hanmin0211/racing_ws/HANDOFF_2026-09-19-night.md

# 인계 — 2026-09-19 새벽 (라이다 회피 + 경사로 양방향 확정)

> **현장에서 이 문서만 보고 출발할 수 있어야 한다.**
> 앞선 대화는 없다고 가정하고 썼다.
> 저장소에서 일하는 방식(다섯 원칙)은 `HANDOFF_2026-09-18.md` §0.

**일정**: 9/19(오늘) 용인 현장 점검 · 9/20 본경기.

---

# 1. ★ 무조건 출발하려면 — 이것만 지켜라

## 1.1 확정 명령 (오늘 밤 오르막·내리막 **양방향 완주**한 설정)

```bash
cd /home/han/racing_ws && bash tools/drive_school.sh --speed 1.6 --min-pwm 0 \
  --extra waypoints:=<경로>.yaml \
  --extra ff_mode:=ros --extra ff_static:=46.0 --extra ff_gain:=42.6 \
  --extra ff_breakaway_pwm:=90.0 --extra ff_breakaway_ms:=1200.0 \
  --extra auto_calib_speed:=0.5 --extra calib_distance:=10.0 \
  --extra curvature_gain:=6.0 --extra avoid_steer_rate_deg:=90.0 \
  --extra grade_ff_gain:=1.0 --extra grade_ff_max:=95.0 \
  --extra gov_pwm:=60.0 --extra gov_min_grade:=0.06 --extra gov_gain:=300.0 \
  --extra gov_lead_s:=0.3 --extra gov_deadband:=0.20
```

한 줄로 (복붙용):

```
cd /home/han/racing_ws && bash tools/drive_school.sh --speed 1.6 --min-pwm 0 --extra waypoints:=<경로>.yaml --extra ff_mode:=ros --extra ff_static:=46.0 --extra ff_gain:=42.6 --extra ff_breakaway_pwm:=90.0 --extra ff_breakaway_ms:=1200.0 --extra auto_calib_speed:=0.5 --extra calib_distance:=10.0 --extra curvature_gain:=6.0 --extra avoid_steer_rate_deg:=90.0 --extra grade_ff_gain:=1.0 --extra grade_ff_max:=95.0 --extra gov_pwm:=60.0 --extra gov_min_grade:=0.06 --extra gov_gain:=300.0 --extra gov_lead_s:=0.3 --extra gov_deadband:=0.20
```

⚠ `drive_school.sh` 는 **라이다 드라이버까지 자기가 띄운다.** 기본값이 9/13 설정
(`ff_static 17.2` / `ff_gain 38.8` / `ff_min_pwm 50`)이라 위 `--extra` 로 전부 덮어써야 한다.
**중복 인자는 뒤가 이긴다** — 시험용 런치로 확인했다(`who:=FIRST who:=SECOND` → SECOND).

## 1.2 ⚠⚠ 절대 빠뜨리면 안 되는 인자

| 인자 | 빼면 | 증상 |
|---|---|---|
| **`grade_ff_gain:=1.0`** | 경사 보상이 **꺼진다**(기본 0.0) | 경사로 중턱에서 속도가 단조 감소하다 정지. **에러 메시지 없음** |
| `grade_ff_max:=95.0` | 상한 70 으로 잘린다(기본 70.0) | 급경사에서 보상 부족 |
| `ff_static:=46.0` | 17.2 로 떨어진다 | 정지마찰을 못 넘어 아예 안 움직임 |
| `ff_breakaway_pwm:=90.0` | 60 으로 떨어진다 | 출발 실패 |

**2026-09-19 03:2x 에 `grade_ff_gain` 을 빼고 돌려 s=74m 에서 죽었다.**
같은 파라미터로 00:33 에는 완주했었다. 배터리로 오진했다가 파라미터 덤프
(`/tmp/launch_params_*`)로 확정했다. **출발 전에 `exec` 직전 출력에서 눈으로 확인할 것.**

## 1.3 출발 보장 체크리스트 — 순서대로

**① 장치 넷**

```bash
ls -l /dev/imu /dev/arduino /dev/ldlidar_front && lsusb | grep -icE "10c4:ea60" && stty -F /dev/imu 921600 raw -echo && timeout 2 head -c 64 /dev/imu | wc -c
```

기대: 심링크 3개 · CP210x **2개** · 마지막 **64**

⚠ **보드레이트를 먼저 맞춰야 한다.** tty 는 새로 열거되면 9600 이고 IMU 는 921600 이다.
안 맞추면 프레이밍 에러로 전부 버려져 **멀쩡한 IMU 가 0바이트로 보인다.**
(2026-09-19 03:23 에 이걸로 정상 IMU 를 '죽었다' 고 오진했다. 9/14 에도 같은 사고)

`0` 이면 진짜 죽은 포트다 → **뽑고 10초 뒤 다시 꽂을 것**(바로 꽂으면 칩이 리셋 안 된다).

⚠ IMU 와 라이다가 **같은 칩(10c4:ea60)** 이라 `ttyUSB` 번호는 꽂는 순서마다 바뀐다.
udev 가 시리얼로 고정하므로 **심링크만 보면 된다**(`/etc/udev/rules.d/99-imu.rules`,
`99-ldlidar.rules`, `99-arduino.rules`).

⚠ **USB 허브 깊이 금지.** 허브로 시리얼이 끊긴 이력(`dmesg` 의 `-32` = EPIPE, 직결로 재연결 49→0).

**② 중복 노드 없음**

```bash
cd /home/han/racing_ws && bash tools/ros_cleanup.sh
```

`✅ 없음` 이어야 한다. 두 벌이 돌면 serial/NTRIP/IMU 가 전부 싸운다.
`drive_school.sh` 는 남아 있으면 **시작 자체를 거부**한다.

**③ 라이다 마운트** — 드라이버 띄운 뒤, 주행 전 30초

```bash
cd /home/han/racing_ws && source install/setup.bash && python3 tools/lidar_mount_check.py
```

지면을 때리면 전방이 통째로 장애물이 되어 **차가 영원히 선다**. 두 번 재발한 고장이다.

**④ 캘리브** — 이게 안 되면 자율이 아예 안 나간다

- `auto_calib:=true`(기본, `drive_school.sh`) → 차가 스스로 10m 직진
- 컨트롤러 없이 **밀어서** 하려면 `auto_calib:=false` + 손으로 밀기
- 조향 중앙 맞추려면 별 터미널에서 `ros2 run velocity_controller teleop_keyboard` → `SPACE`
  ⚠ **`wasd_teleop` 은 쓰지 마라** — `/cmd_vel` 로 직접 쏴서 먹스와 싸운다.
  `teleop_keyboard` 는 `/teleop/cmd_vel` 로 보내고 먹스가 사람 우선으로 받는다.

---

# 2. 캘리브 — 대회장에서 반드시 되게

## 2.1 원리 (이걸 알면 현장 대응이 된다)

```
yaw_offset = normalize(GPS course − IMU yaw)
```

**IMU 좌표계와 맵 좌표계 사이의 상수 회전**이다. 위치의 함수가 아니다.
`/heading/yaw_offset` 을 **래치(TRANSIENT_LOCAL)** 로 발행하고 노드는 종료한다.
`direct_localization` 과 `vehicle_cmd_mux` 가 그 값을 세션 내내 들고 있다.

→ **코스 밖에서 캘리브하고 런치를 켠 채 차를 옮겨도 된다.**

⚠ **런치를 Ctrl+C 하면 날아간다.** IMU 가 재열거돼도 날아간다. 예선 대기 중에 끄지 마라.

## 2.2 게이트 6개 — 무엇이 막는가

| 게이트 | 기본값 | 막히면 |
|---|---|---|
| RTK 수렴 | σ ≤ 5cm, `require_rtk` | `RTK 수렴 대기 중` 로그. NTRIP 이 붙어도 수신기가 RTCM 을 안 먹으면 안 올라간다 — ublox 로그에 `degraded mode` 확인 |
| 이동속도 | `max_jump_speed` 2.0 m/s | `측위 점프 감지` → 시작점 재설정 |
| 직진성 | `max_deviation_deg` 20°, 지속 1.5m, peak 25° | `❌ 무효` |
| 최소 소요시간 | `auto_speed_cap` (ff_mode 로 자동: ros→2.0) | `❌ 무효: N m 를 N초 만에` |
| **앞바퀴 중앙** | `max_steer_offset_deg` 2.0 | 시작조차 안 함 |
| 자동직진 재시도 | 3회, 시작점 2m 안으로 되돌려야 재출발 | `현재 N.Nm 앞` |

## 2.3 10m 가 안 나올 때

오프셋은 **시작점→끝점 현(chord)** 으로 구한다. RTK σ≈2cm 기준 각도 오차:

| 거리 | 헤딩 오차 |
|---|---|
| 10m | 0.11° |
| 8m | 0.14° |
| 5m | 0.23° |
| 3m | 0.38° |

**5m 면 0.23° — 충분하다.** `calib_distance:=5.0`.
⚠ 3m 밑으로 내리지 마라(`min_chord_for_dev` 2.0m · `seg_window_m` 1.5m 라 표본이 없다).
⚠ **5m 는 계산상 되지만 실차 미검증이다.** 오늘 밤 실차는 전부 8~10m 였다.

## 2.4 손으로 밀 때 vs 자동직진 — 실측 차이

```
자동직진 (auto_calib:=true)   최대 편차 2°, 4°, 2°
손으로 밀기                    최대 편차 6°
```

손으로 민 캘리브의 **헤딩 편향을 주행으로 측정했더니 일관되게 −6°** 였다
(위치미분 course vs 보고 yaw, 15구간 평균 −6°, `heading_check` 판정선 20° 는 통과).
경로 추종은 0.18~0.78m 로 됐지만, **밀 거면 차 정중앙 뒤에서 밀어라.** 옆에서 밀면 돌아간다.

## 2.5 구루마로 옮길 때 — **아직 검증 안 됨**

캘리브 후 차를 **회전**시켜 옮기면 오프셋이 사는지는 **측정한 적이 없다.**
자력계 오차가 상수면 살고, 방위에 따라 변하면(하드/소프트 아이언) 깨진다.

검증법 (5분):
```bash
cd /home/han/racing_ws && source install/setup.bash && python3 tools/heading_check.py
```
캘리브 후 차를 180° 돌려 곡선 포함 20~30m 주행 → **평균 오차 < 20°** 면 통과.

⚠ 차를 구루마 **위에서** 캘리브하는 것도 된다(GPS+IMU 만 쓴다). 단:
- **차가 구루마 진행방향을 정확히 봐야 한다** — 5° 비뚤면 오프셋이 정확히 5° 틀린다.
  그리고 그 오차는 **나중에 알 방법이 없다**(캘리브는 `✅ 완료` 로 끝난다)
- 앞바퀴를 중앙에 놓을 것(게이트)
- 구루마를 곧게 밀 것

**제일 튼튼한 건 코스마다 다시 캘리브하는 것이다.** 10m 밀기, 30초.

---

# 3. 오늘 밤 실측값 (전부 검증된 숫자)

## 3.1 경사로 경사 — **최초 측정**

```
본 경사 −15.4% ~ +3.0%   (tools/imu_grade_live.py, 41324샘플)
평지 대조군 +0.1%        (3554샘플, 영점 확인)
→ grade_pwm = 9.81·sin(atan(0.154))/0.0202 = 74
```

**용인 법정 최급경사 12.5% < 학교 15.4%.** 여기서 올랐으면 거기서도 오른다.

도구는 이번에 새로 만들었다: `tools/imu_grade_live.py` (읽기만 한다, 저장 안 함).
`grade_pwm` 이 `grade_ff` 가 실제로 더하는 PWM 이다.

## 3.2 구동 FF — 실측 vs 사용 중

```
실측 (ff_identify --run-dist 10.0):   PWM = 40.9·v + 12.5
사용 중 (완주한 값):                   PWM = 42.6·v + 46.0
```

**`ff_gain` 은 거의 맞았고 `ff_static` 만 +33.5 과하다.** 그 결과:

| 명령 v | 보내는 PWM | 실제 속도 |
|---|---|---|
| 0.3 | 58.8 | 1.13 |
| 0.5 | 67.3 | **1.34** ← 사실상 최저 속도 |
| 0.8 | 80.1 | 1.65 |
| 1.2 | 97.1 | 2.07 |
| 1.6 | 114.2 | 2.48 |
| 2.0 | 131.2 | 2.90 |

**이 차의 최저 지속 속도는 ~1.34 m/s 다.** 곡률 제한기가 0.78 을 요구해도 못 낸다.

⚠ **`ff_static` 을 내리면 캘리브 저속에서 정지마찰에 걸려 차가 선다.** 오늘 두 번 확인:
- `ff_static:=12.5 ff_min_pwm:=0` → breakaway 끝나자 PWM 33, 거버너가 16 까지 깎아 **정지**
- `ff_static:=12.5 ff_min_pwm:=50` → 4.2m 가는 동안 0.43 → 0 m/s 로 **서서히 죽음**

쓰려면 `ff_min_pwm:=67`(옛 설정이 명령 0.5 에서 내던 PWM)이 같이 가야 한다. **미검증.**

⚠ `ff_identify.py` 는 **`--run-dist 10.0` 이상**을 쓸 것. 3m 는 가속 구간만 재서
적합이 틀린다(3m→`54.6·v+11.3`, 10m→`40.9·v+12.5`). 판별 신호: PWM 80·90·100 의
최대속도가 거의 같으면 도달 못 한 것이다.
⚠ 출력의 `현재 ROS 쪽 FF: PWM = 38.8·v + 17.2` 는 **하드코딩**이다(`ff_identify.py:319`).

## 3.3 max_speed 선택 — 오르막·내리막이 붙어 있어서 하나로 가야 한다

```
경사로가 먹는 속도: 0.81 ~ 0.96 m/s (15.4% 기준, 실측)
```

| max_speed | 평지 | 학교 경사로(15.4%) | 용인 경사로(12.5%) |
|---|---|---|---|
| 2.0 | 2.90 | 1.80 (실측) | ~2.24 |
| **1.6** | 2.48 | **1.30 (실측, 문턱 근처)** | ~1.82 |
| 1.2 | 2.07 | 1.26 ⚠ 문턱 밑 | ~1.41 |

**1.6 으로 양방향 완주했다.** 학교 s=90~100 에서 1.30 까지 떨어졌지만 안 섰다.
용인은 더 완만하므로 여유가 있다. **1.2 는 쓰지 마라.**

## 3.4 `gov_deadband` — 0.10 → **0.20** 으로 올렸다

`max_speed` 를 낮추면 명령이 내려가고, FF 바닥 때문에 실측이 상시 초과한다
→ 거버너가 **평지에서** 개입해 구동을 끊는다(실측: PWM 80 → 31).

```
평지 헛개입의 초과분:   +0.11  +0.17  +0.20  +0.26
진짜 내리막의 초과분:   +0.61  +0.75  +1.55  +1.59  +1.63
```

**0.20 으로 올리니 헛개입만 걸러졌다:**

```
                   db 0.10        db 0.20
거버너 개입          38회           23회
그중 제동            17회           15회   ← 유지
초과분 최소          0.15           0.22
```

⚠ **`gov_min_grade` 는 0.06 에서 올리지 마라.** 게이트가 안 열리면 내리막에서
못 잡아 **이탈(탈락)** 이고, 잘못 열리면 최악이 '캘리브가 기어간다' 다.
설계가 **fail-open**(모르면 허용)이고 그 방향을 뒤집지 말 것.

## 3.5 라이다 회피 — 실차 실측

```
오르막 방향 (진입 ~1.8 m/s)   최대 이탈 1.13 m
내리막 방향 (진입 2.70 m/s)   최대 이탈 1.91 m
```

**이탈이 속도에 비례한다.** 오프라인 시뮬은 속도 무관이라고 하는데 **실차는 아니다**
(조향 지연 0.35s 가 속도에 비례해 거리로 환산된다). 시뮬을 이 점에서 믿지 마라.

배치: 꼬깔 0.36m, 종방향 2.5m, 좌우 ±0.4m. `막힘탈출` 없이 정상 회피.

### 꼬깔 '사이로' 통과시키려면

```
오프셋 ±0.40m  →  바깥,  이탈 1.32m (시뮬) / 1.13~1.91m (실차)
오프셋 ±0.50m  →  바깥,  이탈 1.50m  ← 최악
오프셋 ±0.65m  →  사이로 ✅  이탈 0.26m
오프셋 ±0.80m  →  사이로 ✅  이탈 0.07m
```

**파라미터로는 못 고친다.** 전부 시험했다 —
`planning_lookahead` 2.2→0.8 (무효, 그건 트랙창 투영거리다 `follow_gap_planner.py:166`),
`fg_max_range` 8.0→4.0 (무효), 3.0 이하 (BLOCKED 로 박음),
`fg_safety_margin` 0.25→0.05 (이탈 1.32→1.14, 여전히 바깥, 0.05 는 충돌),
`fg_track_width` 2.7→2.0/1.6 (BLOCKED), `aim` nearest/center (더 나쁨), `prefer_path_gap` 끔 (무효).

**구조적 한계다.** follow-gap 은 스캔 한 장에서 갭을 고를 뿐 "①을 지나고 ②를 처리한다"
는 순서 개념이 없다. 이탈 상한으로 억지로 안쪽에 넣으면 **꼬깔을 박는다**(시뮬 확인).

### ★ 규정 확인 — 바깥으로 도는 건 위반이 아니다

> HL FMA 2026 항목 4: **중앙선 없이 좌·우측으로 자유 회피 주행.**
> 감점: 접촉 10점/회 · 충돌 후 주행불가 10점 · 차량 이동 5점 · 미션 포기 15점 ·
> **구간 내 차선이탈 최대 10점**

요구조건은 "사이로" 가 아니라 **"안 박고, 차선 안에 있기"** 다.

## 3.6 종점 정지 — 오버슈트

```
max_speed 2.0 오르막   3.00 m
max_speed 1.6 오르막   1.23 m
max_speed 1.2 내리막   4.77 m
max_speed 1.6 내리막   3.92 m
```

원인: 완주 신호 뒤 명령이 0 이 되면 `PWM:0` 만 나가고 **역토크가 없다.**

⚠ **능동 제동(`ff_brake_pwm`)은 켜도 안 걸린다.** 진입 조건이 "직전 명령이
`ff_brake_trigger_v`(0.40) 이상" 인데, 완주 감속은 `max_decel` 1.8 · `dt` 0.05 로
**한 스텝 0.09 m/s** 씩 내려가서 정지명령 순간의 `_last_cmd_v` 가 항상 0.05~0.14 다.
`max_decel·dt < 0.35` 인 한 **수학적으로 절대 트리거되지 않는다.**
→ 실제 `_brake_pwm()` 을 불러 완주 수열을 먹여 확인했다(제동 인가 0회).
→ 장애물·정지선 감속도 같은 램프를 지나가므로 **자율 주행에서 능동 제동이 걸린 적이 없다.**

## 3.7 공급전압

```
오늘 밤 최저: 2315mV (내리막 1.2), 2718mV, 2863mV, 3000mV
중앙값: 약 4062mV
```

메모의 "조향이 전원을 무너뜨린다(4198→2038)" 영역이다. 매번 버텼지만
**현장에서 전원 배선을 한 번 볼 것.** 구동 배터리는 별도 레일이라 `/vcc_mv` 로 안 보인다.

---

# 4. 용인에서 제일 먼저 할 것

**① S자 차선폭 실측 → `avoid_max_lateral_m` 결정** ← 제일 급하다

지금 **꺼져 있다**(기본 0.0). 이게 연석 보호의 **유일한** 장치다.
이탈이 이 값을 넘으면 먹스가 회피를 버리고 경로로 돌아온다.

```
상한을 낮게  →  회피를 일찍 포기  →  접촉 (10점 감점)
상한을 높게  →  크게 벌어짐      →  차선이탈 (최대 10점), 연석 넘으면 탈락
```

원칙: **접촉은 감점이지만 이탈은 탈락이다.** 연석 안쪽으로 잡아라.
값은 **S자를 장애물 없이 돌아 실측한 이탈(p95)** 위에서 정할 것.
오늘 밤 실측 이탈이 **1.13~1.91m** 였으니 그 근방을 예상하라.

**② 경사로 실제 경사 측정**

```bash
cd /home/han/racing_ws && source install/setup.bash && python3 tools/imu_grade_live.py
```

주행 중 연속으로 찍힌다. Ctrl+C 하면 본 최소~최대를 요약한다.
⚠ 가감속이 피치를 오염시킨다(1 m/s² = 10%p). **세우거나 등속에서 읽을 것.**

**③ 미션 계획이 코스와 맞는지 확인**

648m 본 계획을 다른 경로에 쓰면 `check_course` 가 **모든 미션을 조용히 건너뛴다.**

**④ 예선 구간 웨이포인트** — 굴절+S자만 달린다면 그 구간만 잘라야 한다.
자르는 도구가 **없다.** `reverse_waypoints.py` 처럼 만들어야 하고, 자른 뒤:
- **origin 스탬프를 옮길 것**(없으면 `global_path_publisher` 가 발행 거부)
- **앞 10m 직진성 재판정**(자른 시작점이 캘리브 구간이 된다)
- 최소 곡률 반경 확인

**⑤ 시간 남으면**: `ff_static:=12.5 ff_gain:=40.9 ff_min_pwm:=67` 조합.
평지 과속이 사라진다. **미검증이므로 오르막을 반드시 한 번 돌려 확인할 것.**

---

# 5. 내가 틀렸던 것 (같은 함정을 다시 밟지 마라)

1. **`grade_ff_gain`/`grade_ff_max` 를 명령에서 빼먹었다.** bringup 기본값이 `0.0`/`70.0`
   = **꺼짐**이다. 경사로 중턱에서 죽었고 **배터리로 오진**했다.
   파라미터 덤프(`/tmp/launch_params_*`)로 확정했다. → §1.2
2. **IMU 보드레이트를 안 맞추고 바이트를 읽었다.** 9600 으로 읽어 0바이트가 나왔고
   정상 IMU 를 '죽었다' 고 했다. `stty -F /dev/imu 921600` 이 먼저다.
3. **회피 떨림의 원인을 '갭 선택 뒤집힘' 이라고 단정했다.** 실제 플래너에 합성 스캔을
   먹여 재현하니 **갭 건너뜀이 전 조건에서 0회**였다(잡음 σ 0~5cm, 결측 0~5%, 각 20회).
   진짜 원인은 **같은 갭 안의 조준각 지터**이고 **잡음에 정비례**한다(160→460°/s).
   → `avoid_steer_rate_deg:=90` 이 증상 차단이 아니라 **원인을 직접 치는 것**이었다.
   갭 선택 히스테리시스는 **만들 필요 없다.**
4. **`obstacle_stop_dist:=2.0` 을 슬라럼에 권했다.** AVOID 중에도 `/obstacle_distance` 에
   전방거리가 나가서 **꼬깔마다 2m 앞에서 서고 8초 뒤 회피를 포기**한다.
   (9/12 실측: 학교 트랙 장애물 3개에 400초 동안 7m 전진) **기본 0.8 을 유지할 것.**
5. **대회 전날 밤에 `ff_static` 을 바꾸자고 밀었다.** 인계문서가 "손대면 안 되는 것" 으로
   못 박아 둔 값이었고, 두 번 시도해 두 번 다 캘리브가 죽었다.
   사용자가 "그냥 기존으로 하자" 고 바로잡았다.
6. **시뮬이 속도 무관이라고 해서 그대로 믿을 뻔했다.** 실차는 이탈이 속도에 비례한다
   (1.13m @1.8 → 1.91m @2.7). 오프라인 하네스는 조향 지연을 모델링하지 않는다.

---

# 6. 오늘 밤 만든 것

| 파일 | 내용 |
|---|---|
| `tools/imu_grade_live.py` | 경사를 연속으로 찍는다. 읽기만 하고 저장 안 함. 영점·부호는 `config/imu_pitch_offset.yaml`, 필터/상한/게이트 상수는 `serial_bridge_node` 에서 직접 가져온다(베끼지 않는다) |
| `HANDOFF_2026-09-19-night.md` | 이 문서 |

**기록된 주행 로그** (재부팅하면 `/tmp` 는 사라진다 — 필요하면 `data/` 로 옮길 것):

```
/tmp/cone_0342.csv    오르막 max_speed 2.0 · 꼬깔 회피 · 완주
/tmp/down_0348.csv    내리막 max_speed 1.2 · gov_deadband 0.10 · 완주
/tmp/up16_0404.csv    오르막 max_speed 1.6 · 완주
/tmp/down16_0409.csv  내리막 max_speed 1.6 · gov_deadband 0.20 · 완주
```

분석: `tools/drive_plot.py <csv> --wp <경로>` / `tools/drive_review.py --detail`
⚠ **0.2초로 솎아 보면 오진한다** — `--detail` 로 볼 것.

**기록 명령** (`--yaw-offset 180` 을 꼭 줄 것 — 기본 173 인데 `cluster_plot_node` 는 180 이다):

```bash
cd /home/han/racing_ws && source install/setup.bash && python3 tools/drive_record.py --yaw-offset 180 --out /tmp/run_$(date +%H%M).csv
```
