hanmin0211/racing_ws/HANDOFF_2026-09-19.md

# 인계 — 2026-09-19 (경사로: 오르막·내리막 + 캘리브 게이트)

> **다음 세션은 이 문서만 읽고 이어서 일할 수 있어야 한다.**
> 앞선 대화 맥락은 남아 있지 않다고 가정하고 썼다.
>
> 저장소에서 일하는 방식(다섯 원칙·오진 이력)은 `HANDOFF_2026-09-18.md` §0 에
> 있다. **그것부터 읽고 오라.** 여기서는 반복하지 않는다.

**일정**: 9/19(오늘) 용인 현장 점검 · 9/20 본경기. 시간이 없다.

---

## 1. 지금 어디까지 왔나 — 한 문단

충주 학교에서 128m 경사로 경로를 찍어(9/18 22:00) **오르막 자율 완주에
성공**했고(23:09, 128/128m 🏁, 편차 0.20m), 그 경로를 뒤집어 **내리막도
완주**했다(거버너 개입 27회, 잘못 열린 적 0회). 그 뒤 거버너를 켠 채 오르막을
다시 돌리다가 두 가지 결함을 찾아 **셋 다 고치고 커밋했다**(§4).
마지막 실행(23:55)은 **캘리브 무효**로 멈췄고, 그 원인이 세 번째 수정이다.
**수정 후 아직 실차로 다시 못 돌렸다. 그게 다음 할 일이다.**

---

## 2. ★ 바로 다음에 할 일

차를 시작점으로 되돌리고(23:55 실행이 10m 전진한 채 끝났다 — 로그가
`현재 14.2m 앞` 이라고 한다. 2m 안으로 오면 자동 재출발), 아래를 그대로 돌린다.
**재빌드 불필요** — 파이썬·런치 전부 심링크 설치다.

```bash
cd /home/han/racing_ws && bash tools/ros_cleanup.sh && ls -l /dev/imu /dev/ttyACM*
```

`✅ 없음` 과 `/dev/imu` 가 보여야 한다. 그다음:

```bash
cd /home/han/racing_ws && source install/setup.bash && ros2 launch gps_localization bringup.launch.py control:=true sequencer:=false lidar:=false rviz:=false waypoints:=/home/han/racing_ws/config/chungju_school/wp_ramp_raw_resampled_0.5.yaml auto_calib:=true calib_distance:=10.0 max_speed:=2.0 curvature_gain:=6.0 ff_mode:=ros ff_static:=46.0 ff_gain:=42.6 ff_min_pwm:=0.0 ff_breakaway_pwm:=90.0 ff_breakaway_ms:=1200.0 grade_ff_gain:=1.0 grade_ff_max:=95.0 gov_pwm:=60.0 gov_min_grade:=0.06 gov_gain:=300.0 gov_lead_s:=0.3 gov_deadband:=0.1
```

**판정 세 가지**

1. 캘리브가 `✅ 완료` 로 끝나는가 (23:55 에는 `❌ 무효` 였다 — §4-C 가 그것)
2. 캘리브 구간에 `거버너 —` 줄이 **하나도 없는가** (§4-A·B 가 그것)
3. 오르막에서도 게이트가 닫힌 채인가 (등반 중 `거버너 —` 가 뜨면 남은 오염)

내리막은 파일만 바꾼다: `..._0.5_rev.yaml`.

---

## 3. 경사로 작업 전체 — 무엇이 어떻게 동작하나

### 3.1 오르막 — `grade_ff` (IMU 피치 보상)

개루프 FF 는 `PWM = ff_gain·v + ff_static` 이다. 경사에서는 중력
`g·sinθ` 가 더해지는데 FF 는 그걸 모른다. 그래서 IMU 피치로 **상쇄 PWM** 을
더한다:

```
grade_pwm = 9.81·sin(pitch) / K_ACCEL_PER_PWM      # K = 0.0202 m/s²/PWM
```

| 상수 | 값 | 의미 |
|---|---|---|
| `GRADE_FRESH_S` | 0.5 | IMU 가 이보다 낡으면 보상 **0** (조용히 꺼진다) |
| `GRADE_MAX_RAD` | 0.35 | 35% ≈ 19.3°. 넘으면 IMU 오류로 본다 |
| `GRADE_TAU` | 0.30 | 피치 저역통과 — "가감속 피칭을 누른다" |

- **부호는 실측으로 확정했다**: `config/imu_pitch_offset.yaml`
  → `pitch_offset_rad: 0.066447`, `sign: -1.0`. **부호가 반대였다.**
  `tools/imu_grade.py --level` 이 쓴 파일이고 손으로 고치지 말 것.
- 오르막/내리막 **지점을 정의할 필요가 없다.** 피치가 실시간으로 알려준다.
  (미션 계획의 구간속도와는 별개 기능이다)

### 3.2 내리막 — 거버너 (연속 신호)

개루프에는 '달리는 중' 감속 권한이 없다(제동은 **정지 명령에만** 붙는다).
거버너는 과속분에 비례해 FF 를 **연속적으로 깎는다**:

```
out = |ff_pwm| − gov_gain · excess        (음수 = 제동까지 내려간다)
out = max(out, −gov_pwm)                  (플러깅 전류 상한)
```

⚠ **회차(on/off)가 아니라 연속이다.** 9/17 에 통째로 역 PWM 으로 바꾸던
방식을 고친 것이다(`498b867`). 그때 실측이 48 → −1 → 33 → −24 → −50 이었다 —
'버티면서 내려가기' 가 안 됐다.

| 상수/인자 | 값 | 의미 |
|---|---|---|
| `gov_pwm` | 60.0 | 역방향 상한. 0 이면 거버너 **꺼짐** |
| `gov_gain` | 300.0 | 초과 m/s 당 깎는 PWM |
| `gov_deadband` | 0.10 | 이만큼 넘어야 개입 |
| `gov_lead_s` | 0.30 | 선행 — 지금 가속도로 0.3초 뒤를 내다본다 |
| `GOV_LEAD_CAP` | 1.0 | 선행 포화 |
| `gov_min_grade` | 0.06 | **자세 게이트** — 내리막일 때만 개입. 0 이면 게이트 꺼짐 |
| `GOV_GATE_HYST` | 0.6 | 닫힘 문턱 = 열림 문턱 × 0.6 (히스테리시스) |
| `GOV_V_PLAUSIBLE_ENCPOS` | 6.0 | 위치차분 출처일 때의 속도 상한(그 외 3.0) |
| `BRAKE_MEAS_FRESH_S` | 0.5 | 측정이 이보다 낡으면 개입 안 함 |

### 3.3 자세 게이트 — 왜 있나 (사용자 설계 아이디어)

거버너를 전 구간에 켜 두면 **커브에서 구동을 끊는다**: 곡률 제한기가 명령
속도를 낮추면 → 측정이 명령보다 빨라지고 → 거버너가 FF 를 깎는다 →
`ff_min_pwm` 을 우회하므로 차가 선다.

"피치 있으니깐 자세추종 가능하잖아 내리막 자세일때 거버너 잡으면 되지 않나" —
그래서 **내리막 자세일 때만** 게이트를 연다. 히스테리시스는 문턱을 스칠 때
게이트가 토글해 연속 조절을 깨는 것을 막는다(`30fd97a`).

⚠ **모를 때는 허용한다.** IMU 가 없거나 낡으면(`GRADE_FRESH_S`) 게이트를
연다. 내리막에서 못 잡으면 **이탈(탈락)** 이고, 잘못 잡으면 최악이 '한 번
선다' 다. 이 방향을 뒤집지 말 것.

### 3.4 파일

| 파일 | 내용 |
|---|---|
| `config/chungju_school/wp_ramp_raw_resampled_0.5.yaml` | 257점 128.0m, 시작(−26.4,−25.1)→끝(−10.4,+66.4), 최소 R 3.51m @s=26m. **오르막**. origin 스탬프 있음 |
| `config/chungju_school/wp_ramp_raw_resampled_0.5_rev.yaml` | 위를 뒤집은 것. **내리막**. 경사로가 s=36~44 로 와서 36m 조주거리가 생긴다 |
| `config/imu_pitch_offset.yaml` | 피치 오프셋·부호 |
| `config/ramp_course/mission_plan.ramp.yaml` | 경사로 전용 미션 계획 |

⚠ **미션 계획을 코스와 맞출 것.** 648m 용인 계획을 128m 경로에 쓰면
`check_course` 가 **모든 미션을 조용히 건너뛴다.** 그래서 전용 파일을 만들었다.

⚠ 경로를 뒤집을 때는 `tools/reverse_waypoints.py` 를 쓸 것. 뒤집으면 캘리브
구간이 **원래 경로의 끝부분**이 되므로 앞 10m 직진성을 heading_init 과 **같은
판정으로** 다시 봐야 한다. origin 스탬프도 옮겨야 한다(없으면
global_path_publisher 가 발행을 거부한다).

---

## 4. 어젯밤(9/18) 고친 것 셋 — 커밋별

### A. `3f7545b` 거버너 게이트에서 **가속 오염**을 뺀다

IMU 는 중력 방향으로 기울기를 잰다. 가감속하면 관성력이 섞여 **가짜 피치**가
생긴다: `atan(a/g)`. **1 m/s² 면 5.8° = 10%** 다.

```
차를 세우고 잰 그 자리        −2.0 %
저속 서다가다 주행 중         −6~7 %   ← 6% 문턱이 열렸다
→ 거버너가 PWM 을 9 까지 깎아 캘리브가 기어갔다
```

문턱을 6→10% 로 올리는 것으로는 못 푼다(오염이 ±5% 씩 흔든다). **그 가속도를
이미 알고 있다** — 엔코더 위치차분 추정기의 `self._meas_a`(거버너 선행항이
쓰는 값)로 빼면 자세만 남는다.

```python
pitch_true = pitch_measured − atan(a_encoder / g)
```

⚠ **`grade_ff` 에는 적용하지 않았다.** 그쪽은 실차에서 128m 완주했다.
대회 직전에 검증된 경로를 건드리지 않는다. 여기는 **게이트 판정에만** 쓰이므로
틀려도 최악이 '거버너가 한 박자 늦게 켜짐' 이다.

### B. `48bd0f5` 그 보정의 **위상**을 피치 필터에 맞춘다

A 만으로는 절반이었다. 23:55 실행에서 캘리브 중 거버너가 **한 줄** 떴다:

```
거버너 — 측정 0.43+0.19(선행) > 명령 0.50 (+0.12) → PWM 61 → 55
```

`self._pitch` 는 `GRADE_TAU`(0.30s) 로 **저역통과**돼 있는데 엔코더 가속도는
즉시 튄다. 그대로 빼면 출발 가속 구간에서 **과보정**이 난다. IMU 피치는
`(참자세 + atan(a/g))` 를 통째로 누른 값이므로, 뺄 값도 같은 시정수로 눌러야
한다(`_gov_a_lp`).

⚠ **초기값은 0 이다.** 원값으로 시작하면 첫 주기에 보정이 통째로 들어가는데
피치는 14%(=0.05/0.35)밖에 안 움직였다 — **보정을 안 한 것보다 나빴다**
(시험 20주기 중 13번 오작동, 보정 없을 때 7번). 0 에서 피치와 같은 속도로
차오르게 해야 맞는다.

⚠ `dt == 0` (같은 타임스탬프 두 번)이면 값을 **그대로 둔다.** 거기서
초기화하면 수렴한 필터가 날아간다.

⚠ 측정이 낡으면 필터 상태를 **버린다.** 낡은 값으로 이어 붙이면 재개
시점에 엉뚱한 보정이 한 번 튄다.

### C. `283d654` 캘리브 속도상한이 **깨진 전제** 위에 있었다 ← 23:55 정지 원인

```
❌ 헤딩 캘리브 무효: 10.1m 를 9.6초 만에 갔다고 나온다
   (최소 10.0초 필요, 속도상한 1.00m/s). 실제 주행이 아니라 측위 점프다.
```

**점프가 아니었다.** 로그의 1m 통과 시각으로 구간속도를 내면

```
0.89 → 1.01 → 1.22 → 1.19 → 1.36 → 1.41 → 1.45 → 1.59 m/s
```

**매끄럽게 단조 증가**한다. 점프면 계단이 나온다. 게이트가 스스로 적어 둔
전제가 이것이었다:

```
# 자동직진은 속도제어를 받으므로 auto_speed 의 2배를 넘을 수 없다.
```

`ff_mode:=ros` 는 **개루프**다. 속도제어가 없다. 명령 0.5m/s 는 PWM 67 로 한 번
변환될 뿐이고 차는 정상상태 속도까지 계속 가속한다.

**고친 것**: `heading_init` 에 `auto_speed_cap`[m/s] (0 = 예전 그대로 명령×2).
`bringup` 이 **`ff_mode` 를 보고 자동으로** 넣는다 — `ros`→2.0,
`firmware`→0.0. 운전자가 기억할 필요 없다.

**안전 확인 (실측 두 숫자 직접 대입)**

| | 평균속도 | 상한 1.00 | 상한 2.00 |
|---|---|---|---|
| 2026-08-24 충돌사고 | 2.97 m/s | 거부 | **거부** ✅ |
| 2026-09-18 개루프 실주행 | 1.05 m/s | 거부 ❌ | **통과** ✅ |

⚠ **한계를 분명히**: 상한을 올린 만큼 **평균 2.0m/s 미만으로 누적되는
점프**는 게이트 ③ 이 못 거른다. 그건 게이트 ②(한 스텝 2.0m/s)의 몫이고,
한 스텝 2.0 미만의 점프(0.05s 에 0.1m)는 어떤 상한으로도 주행과 구분되지
않는다. 방어 구조 자체는 그대로다.

⚠ **이 게이트는 배터리 상태로 당락이 갈리고 있었다.** 23:09 에는 같은 설정이
통과했다(평균 0.93m/s, 필요 10.0초에 10.9초). 구동 배터리는 별도 레일이라
보이지 않는다. 대회 이틀 전에 동전 던지기를 남겨 둘 수 없어서 고쳤다.

⚠ **같은 고장이 9/12 에 이미 났다.** 그때는 펌웨어 FF 가 4배 틀려서 0.15m/s
명령에 차가 2m/s 로 달렸고 캘리브가 8회 연속 실패했다. 그때는 FF 를 고쳤지만
진짜 원인은 **명령속도로 상한을 잡은 것**이었다.

---

## 5. 9/18 야간 실차 타임라인 — 전부

| 시각 | 무슨 일 | 결과 |
|---|---|---|
| ~21:5x | `imu_grade --level` / `--measure` | **피치 부호가 반대**였다 → `sign: -1.0` 확정 |
| 22:00 | 웨이포인트 기록 | 257점 128.0m, 최소 R **3.51m** @s=26m, 앞 10m 직진 2.3° |
| 22:5x | `ff_static:=29` 로 자율 | s≈84~92 에서 반복 정지 |
| 22:50 | `ff_min_pwm:=110` 세션 | 파라미터 덤프로 확인됨 |
| 22:55 / 23:03 / 23:05 | 연속 사망 | **22:50 좀비가 IMU 를 나눠 읽어** 2분 뒤 exit |
| 23:09 | `ff_static:=46.0` | **🏁 128/128m 완주, 편차 0.20m.** 캘리브 0.93m/s |
| 23:20 | `reverse_waypoints.py --write` | `_rev.yaml` 생성 (앞 10m 직진성 재판정 통과) |
| 23:2x | 내리막(_rev) 자율 | **완주.** 거버너 개입 27회, 잘못 열림 0회 |
| 23:35~36 | Arduino 가 ~10초마다 재열거, IMU 가 버스에서 사라짐 | **USB 재연결로 복구** |
| 23:41 | `ff_static:=23.4` 실험 | 캘리브 0.06m/s — **작동하던 설정을 망가뜨렸다** |
| 23:46 | 오르막 + `gov_pwm:=60 gov_min_grade:=0.06` | 캘리브 중 거버너가 **PWM 32→9** |
| 23:55 | 오염 보정(A) 적용 후 재실행 | 거버너 **한 줄**(61→55)로 줄었으나 **캘리브 무효**(10.1m/9.6s) |
| 이후 | B·C 수정 + 검증 + 커밋 | **실차 재확인 미완** ← 다음 할 일 |

⚠ **이 표의 근거 등급이 다르다.** 노드 stdout 은 파일로 안 남는다
(`~/.ros/log/<세션>/` 에 `launch.log` 만 있고 대부분 0~3KB 다). 그래서

  · **파일로 재확인 가능**: 웨이포인트 통계, `/tmp/launch_params_*` 의 파라미터,
    23:55 실행의 구간속도(사용자가 붙인 터미널 화면), 23:09 세션 존재
  · **터미널 화면으로만 본 것**: 완주 편차 0.20m, 내리막 거버너 개입 27회,
    23:09 캘리브 0.93m/s, 23:41 캘리브 0.06m/s

  뒤쪽 숫자를 새 결론의 **유일한** 근거로 쓰지 말 것. 다시 돌리면 다시 나온다.
  (`/tmp/launch_params_*` 도 재부팅하면 사라진다 — 원칙 3)

---

## 6. 내가 틀렸던 것 — 전부 (§ 원칙 5)

같은 함정을 다시 밟지 말 것.

1. **런치 배선**: `gov_*`/`grade_ff_*` 를 `control.launch.py` 에 선언해 놓고
   `bringup.launch.py` 가 **안 넘겼다.** 자율 주행으로는 경사로 기능을 하나도
   켤 수 없었다. 인자를 줘도 에러가 안 난다 — **조용히 무시된다.**
   → `tools/test_ramp_launch_wiring.py` (72건) 가 이제 막는다.
2. **`ff_min_pwm:=0.0`** 으로 고치려 했다. 0.5m/s 에서 FF 가 PWM 43 을 내
   정지마찰을 못 넘었다. 노드가 "구동 FF 부족" 으로 자가진단했다.
3. **`ff_min_pwm:=90/110`** 은 **적극적으로 틀렸다.** 개루프에서 하한은 곧
   **최저 속도**다. 캘리브가 1.55m/s 로 돌고 곡률 감속이 무력화된다.
   사용자가 "아까도 110이었어" 라고 바로잡았고, `/tmp/launch_params_*` 로
   22:50 세션이 이미 110 이었음을 확인했다.
4. **"조향 = 탈락"** 주장은 근거가 없었다. 벤치 2회로 링크 파손이 없음을
   확인했다. 조향 스톨은 **차가 선 것의 증상**이었다.
5. **"배터리 방전/열보호"** 진단도 틀렸다. 사용자: "110에서 130에서 올라갔는데".
6. **직진성 14.5°** 측정이 틀렸다. 0.5m 기선이 1.3cm 잡음을 증폭했다.
   heading_init 과 **같은 1.5m 창**으로 다시 재니 2.3° 였다.
7. **`ros_cleanup.sh` 의 `[a-z_]+` 정규식**이 `handsfree_ros2_imu` 를 못 잡았다
   — **고치려던 바로 그 노드를.** `[a-z_0-9]+` 로 고쳤다.
8. **"다중 접근은 기존 버그"** 라고 결론냈는데, 23:09 런치가 아직 살아 있었고
   **내 시험 노드가 중복**이었다. 그 뒤 launch.log 로 22:55/23:03/23:05 가
   정말 22:50 좀비 때문에 죽은 것을 확인했다.
9. **`ff_static` 46→23.4 로 바꿔 작동하던 설정을 망가뜨렸다.**
   사용자: "이 명령 너무 좋았다고 했잖아 뭘 바꾼거야". 로그로 확인:
   23:09(성공) 0.93m/s vs 23:41 0.06m/s.
10. **오르막 실행에 `gov_min_grade:=0.06` 을 그냥 얹었다.** 캘리브 중 거버너가
    떴다. 거기서 가속 오염(§4-A)을 찾았다.
11. **시험 장치가 상수를 고정 목록으로 복사**하고 있었다. `GOV_GATE_HYST` 를
    추가하자 깨졌다. `ramp_profile.py`·`replay_governor.py` 둘 다 **대문자 상수
    전부 복사**로 바꿨다(`test_governor.py` 가 이미 쓰던 방식이고, 그 주석이
    바로 이 함정을 경고하고 있었다).
12. **오염 시험의 기대값을 틀리게 썼다.** 가속도가 낡으면 게이트가 닫힐 거라
    적었는데, 올바른 동작은 **fail-open** 이다(모르면 허용). 주석과 함께 고쳤다.
13. **위상 정합의 첫 시도가 시험에 떨어졌다.** 필터를 원값으로 시작해 20주기 중
    13번 오작동 — 보정 안 한 것(7번)보다 나빴다. 0 초기화로 0/20 이 됐다.
    **시험이 없었으면 더 나쁜 코드를 커밋할 뻔했다.**
14. **`--level` 출력을 경사로 기울기로 읽었다.** `+3.50°` 는 **평지 마운트
    영점**(`pitch_offset_rad`)이지 경사도가 아니다. 그걸 근거로 "학교 경사로는
    6.1%" 라 말하고 문턱을 0.04 로 내리라고까지 권했다. **학교 경사로의
    경사도는 아직 측정된 적이 없다.** (§8-3)

---

## 7. 검증 — 하드웨어 없이 돌아가는 것들

```bash
cd /home/han/racing_ws && source install/setup.bash && for t in test_governor test_grade_ff test_ramp_profile test_ramp_launch_wiring test_ramp_section test_brake_logic; do python3 tools/$t.py >/dev/null 2>&1 && echo "✅ $t" || echo "❌ $t"; done
```

| 시험 | 건수 | 무엇을 막나 |
|---|---|---|
| `test_governor.py` | 68 | 거버너 전부 — 자세 게이트·히스테리시스·오염 보정·**위상 정합**·선행·출처별 상한·위치차분 추정기 |
| `test_ramp_launch_wiring.py` | 72 | 선언→전달→적용 3단계. **9/18 결함을 재발 못 하게** |
| `test_grade_ff.py` | 29 | 경사 보상 부호·물리·안전 |
| `test_ramp_section.py` | 21 | 구간속도가 **기준값만** 바꾸는지 |
| `test_ramp_profile.py` | 16 | 종방향 시뮬이 저장소 로그를 재현하는지(+0.8% 평지, +19.3% 등판) |
| `test_heading_calib_guard.py` | 7 케이스 | **실차 노드를 띄워** 사고를 재현. E·F 가 §4-C |

`test_heading_calib_guard.py` 는 ROS 노드를 실제로 띄운다(케이스마다 도메인
분리, ~4분). 나머지는 순수 파이썬이라 즉시 끝난다.

**7/7 결과** (9/19 00:0x):
```
0. 실측값 직접 대입 — 사고 거부 · 실주행 통과   ✅
A. 정상 주행 → 캘리브 확정                      ✅
B. 사고 재현(RTK 늦게 수렴 + 7.3m 점프)         ✅
C. 게이트① OFF → 게이트②가 거부                ✅
D. 게이트①② OFF → 게이트③이 거부               ✅
E. 개루프 + 옛 상한 → 진짜 주행인데 거부        ✅  ← 9/18 고장 재현
F. 개루프 + cap 2.0 → 같은 주행이 확정          ✅  ← 수정 확인
```

---

## 8. 미해결 — 현장에서 물릴 수 있는 것

1. **`ff_static` 이 배터리 상태로 흔들린다.** 17.2 → 46.0 → ~23 으로 움직였다.
   구동 배터리는 별도 레일이라 `/vcc_mv` 로 **안 보인다**(방전되면 PWM 문턱이
   50→85 로 올라간다). → **용인에서 제일 먼저 FF 재측정**(TODAY.md 단계 0, 5분).
   `tools/drive_threshold.py` 가 구르기 시작하는 PWM 을 재 준다(명령과 측정을
   한 프로세스에서 한다 — 나눠서 두 번 실패했다).
2. **USB 허브 깊이**. 9/18 23:35~36 에 Arduino 가 ~10초마다 재열거하고 IMU 가
   버스에서 통째로 사라졌다(재연결로 복구). `dmesg` 의 `-32`(EPIPE)가 신호다.
   **직결이 답이다**(재연결 49→0).
3. **`gov_min_grade` 문턱의 근거가 반쪽이다.**
   ⚠ **학교 경사로의 실제 경사도는 측정한 기록이 없다.** `imu_grade.py
   --measure` 를 경사로 위에서 돌린 적이 없다. 9/18 에 본 `+3.50°` 는
   `--level`(평지 마운트 영점) 출력이고 `pitch_offset_rad: 0.066447`
   (=3.81°) 로 저장된 **그 값**이다 — 경사로 기울기가 아니다.
   (이 문서 초안에서 그 둘을 혼동해 "학교 6.1%" 라고 썼다가 고쳤다)

   지금 확실한 것은 둘뿐이다:
     · 캘리브 지점 정지 상태 = **−2.0%**
     · 내리막(_rev) 주행에서 **6% 게이트가 27회 열렸다** → 내리막 구간은 **>6%**

   → **용인에서 `--measure` 로 실제 경사도를 재고**(TODAY.md 단계 3) 거기에
   맞춰 문턱을 정할 것. 법정 오르막 12.5% 기준이면 `0.06` 은 여유가 두 배다.
   학교에서 경계 거동이 보이더라도 **용인 값을 낮출 근거는 아니다.**
4. **용인은 오르막 **바로 다음**이 내리막이다.** 그래서 거버너를 그 구간에
   켜 둔 채로 가야 한다 — 오르막에서 게이트가 닫혀 있는지 확인이 필수다(§2 판정 3).
5. **문서 반영이 안 됐다.** `TODAY.md` / `RAMP_RUNBOOK.md` 에 이번 세 수정
   (오염 보정·위상 정합·캘리브 상한)과 `ff_min_pwm` 함정, USB 허브 건이
   아직 안 들어갔다.

---

## 9. 용인에서 달라지는 것

| | 학교(충주) | 용인 |
|---|---|---|
| 경사 | **미측정** (내리막은 >6% — 게이트 27회 개입으로만 안다) | 법정 12.5% |
| 경로 | 128m 전용 | 648m 본 코스 |
| 미션 계획 | `config/ramp_course/mission_plan.ramp.yaml` | 본 계획 — **코스와 맞는지 반드시 확인** |
| 조주거리 | 오르막 21m 중 10m 가 캘리브 | 현장 확인 필요 |
| 내리막 | 별도 실행(`_rev`) | **오르막 바로 다음** — 한 번에 |

`config/` 의 학교 상수는 용인에서 **전부 어긋난다.** 코스 구조는
`yongin-course-layout` 메모 참조.

---

## 10. 손대면 안 되는 것

- **`ff_static:=46.0 ff_gain:=42.6 ff_min_pwm:=0.0 ff_breakaway_pwm:=90.0`** —
  128m 완주한 설정이다. 배터리 재측정 결과로만 바꾼다.
- **`grade_ff` 에 가속 오염 보정을 넣지 말 것** — 검증된 경로다(§4-A).
- **게이트의 fail-open 방향** — 모르면 허용이다(§3.3).
- **`config/imu_pitch_offset.yaml`** — 도구가 쓴 파일이다. 손으로 고치지 말 것.
