hanmin0211/racing_ws/TODAY.md

# 오늘·내일 할 일 (2026-09-18)

```
9/18 (오늘)  마지막 준비일 — 용인 없이 답 낼 수 있는 것 전부
9/19 (내일)  용인 현장 — 유일한 현장 날. 순서가 생명이다
9/20         본경기
```

> **오늘의 원칙**: 내일은 시간이 없다. **현장 없이 알 수 있는 것은 오늘 전부 알아낸다.**
> IMU 피치 부호는 주차 상태 30분이면 끝나는데, 내일로 미루면 경사로를 아예 못 켠다.

| 실패 비용 | |
|---|---|
| 도로/연석 이탈 · 1분 이상 정지 | **탈락** |
| 미션 실패 · 경사로 부진 | 감점 (회복 가능) |
| 8분 초과 | 감점 1분당 5점 |

---

# 오늘 (9/18)

## 0. 전원·연결 — 순서를 지킬 것 (5분)

반대로 하면 엔코더가 0을 센다.

```
1) 차량 배터리 ON
2) Arduino USB
3) GPS(u-blox) USB
4) IMU USB
```

```bash
lsusb | grep -iE "u-blox|2341|10c4"
```
```bash
ls -l /dev/imu /dev/arduino
```

- `/dev/imu` 없으면 → 라이다와 같은 칩(10c4:ea60)이라 **시리얼 `0001`** 로 구분한다
  (`/etc/udev/rules.d/99-imu.rules`). 다른 CP2102 가 먼저 잡혔는지 확인.
- **USB 허브를 쓰지 말 것** — 허브 깊이가 시리얼을 끊는다(dmesg `-32` = EPIPE). 직결.
- **배터리 완충.** ③의 판정이 배터리 상태에 좌우된다. 과거에 방전을 하드웨어
  고장으로 오진한 적이 있다.

---

## ① IMU 피치 부호 + 실제 경사도 — ✅ 2026-09-18 완료

**결과: 부호가 반대였다. `--sign -1` 로 확정해 `config/imu_pitch_offset.yaml` 에 저장.**

앞/뒤바퀴를 13cm 괴고 양방향 측정(축거 0.785m → 기하학적 기대각 9.53°):

| 자세 | 부호 −1 적용 후 | 기대 | 오차 |
|---|---|---|---|
| 코 위(오르막) | +9.51° → **+16.8%** | +16.8 | **0.0 %p** |
| 코 아래(내리막) | −9.92° → **−17.5%** | −16.3 | 1.2 %p (허용 3.3) |

영점 +3.81° · 부호 −1. **이제 `grade_ff_gain:=1.0` 을 켜도 된다.**
그대로 켰으면 오르막에서 PWM 을 더하는 대신 빼서 뒤로 밀렸을 것이다.

⚠ 아래 절차는 **IMU 를 다시 떼거나 마운트를 건드렸을 때** 다시 한다.

<details>
<summary>절차 (재측정이 필요할 때 펼칠 것)</summary>

**차가 움직이지 않는다.** 본 주행과 같은 노드 설정으로 영점을 잡아야 하므로
평소 런치를 그대로 쓴다 — `control` 기본값이 false 라 모터 체인이 안 켜진다.

```bash
cd /home/han/racing_ws && source install/setup.bash && ros2 launch gps_localization bringup.launch.py rviz:=false
```
```bash
cd /home/han/racing_ws && source install/setup.bash && ros2 topic hz handsfree/imu
```

`직진하면 헤딩 초기화...` 메시지가 보여도 **무시한다.** `auto_calib` 기본 false 라
차는 안 움직이고, 캘리브는 yaw 만 건드려 피치와 무관하다.

**평지에 세우고 영점** (손 떼고 대기):
```bash
cd /home/han/racing_ws && source install/setup.bash && python3 tools/imu_grade.py --level
```
- 기울기 **5° 넘으면** 마운트가 삐뚤거나 바닥이 안 평평하다
- 표준편차 **1° 넘으면** 차가 흔들린다 — 다시

**경사 중턱, 코를 위로 두고 측정**:
```bash
cd /home/han/racing_ws && source install/setup.bash && python3 tools/imu_grade.py --measure --expect 12
```

`--expect 12` 는 **부호만 보려고** 넣는 값이다(판정이 `grade * expect < 0`).
실제 경사가 10이든 15든 상관없다.

| 출력 | 조치 |
|---|---|
| `▶ 보정 피치 +7.1° → 경사 +12.5%` | ✅ 통과. **그 12.5% 가 실제 경사도다 — 적어 둘 것** |
| `❌ 부호가 반대다` | `python3 tools/imu_grade.py --level --sign -1` 후 ② 재측정 |
| 값이 0 근처 | 차가 경사에 제대로 안 올라가 있다 |

> **경사로가 없으면 앞바퀴를 괴면 된다.** 축거 0.785 m 라 `sinθ = h/0.785`:
> 10 cm → 12.9%(법정과 같음) · 15 cm → 19.5%. 양쪽 앞바퀴를 같은 높이로.
> 서스펜션이 눌려 크기는 조금 작게 나올 수 있으나 **부호 판정에는 영향 없다.**

**★ 잰 경사도로 파라미터를 정한다**

| 실측 경사 | `grade_ff_max` |
|---|---|
| ~14 % | 70 (기본) |
| **15 % 이상** | **95** ← 기본 70 은 14.4% 까지만 완전보상 |

</details>

내일 용인 경사로의 **실제 경사도**는 현장에서 잰다. 오늘 확정한 것은 **부호**다.

---

## ② 조향 전원 — ✅ 2026-09-18 완료 · **탈락 사유 아님**

`tools/drive_diag.py --yes` 를 바퀴 들고 **두 번** 돌렸다:

| | 기준 VCC | 구동 강하 | 조향 강하 | **재연결·리셋** |
|---|---|---|---|---|
| 1회 | 4077 / 최저 3665 | 0 mV · 회전 | 2013 mV | **없음** |
| 2회 | 4106 / 최저 4106 | 0 mV · 회전 | 2019 mV | **없음** |

**VCC 가 2064~2087 까지 떨어졌는데도 두 번 다 시리얼이 안 끊겼다.**
기록된 주행이 VMIN 2282~2528 에서 완주한 것과 같은 방향이다.

- **구동은 정상** — 강하 0 mV, PWM 50 에서 회전. 9/17 의 '구동이 죽었다' 는 해소.
- **강하는 '유지' 가 아니라 '전환' 에서 난다.** 이미 −18° 에서 −18° 를 주면
  강하 0, 거기서 +18° 로 **움직이면** 2013. S자·굴절은 전환이 반복된다.
- 기준 VCC 가 USB 단독 5138 → 배터리 연결 시 4106 으로 1V 낮다. 다만
  2회차는 중앙=최저=4106 으로 흔들림이 없어, 9/04 의 접지 접촉 불량
  (2.9~5.1V 널뜀)과는 양상이 다르다.

**내일 이 항목에 시간을 쓰지 말 것.** 주행 중 `/vcc_min_mv` 감시로 충분하다.

```bash
ros2 topic echo /vcc_min_mv
```

---

## ③ 오르막 자율 주행 — ✅ 완주 성공 (문서 맨 아래 절을 볼 것)

> ⚠ **아래 내용은 원인을 잘못 짚은 중간 기록이다.** 진짜 원인은 `ff_static`
> 이 29 모자란 것이었고, 고친 뒤 **128m 완주**했다. 결론은 이 문서 맨 아래
> **"★ 2026-09-18 야간 — 완주 성공"** 절에 있다.
>
> 특히 아래의 **`ff_min_pwm:=90` 권장은 틀렸다** — 개루프에서 하한은 곧
> 최저 속도라 캘리브와 곡률 제한을 깨뜨린다. 그대로 따라 하지 말 것.
>
> 오진 과정을 남겨 두는 이유는, 같은 증상(커브에서만 멈춤)을 다시 만났을 때
> **배터리·조향·열보호를 먼저 의심하다 세 시간을 쓰지 않기 위해서**다.
> 그 셋은 전부 증상이었고 원인은 FF 식 하나였다.

<details>
<summary>중간 기록 (오진 과정 — 펼쳐 볼 것)</summary>

**얻은 것**

| | |
|---|---|
| ✅ **캘리브 → 정지 → AUTO 인계** | 실차 첫 검증 성공. 10.0m 직진·최대편차 3°·yaw_offset 106.8° |
| ✅ 경로 추종 | 128m 경로에서 **실측 이격 0.20m** (경고선 0.72) |
| ✅ 거버너 실차 동작 | 제동 −60 까지 실제로 냄 |
| ✅ `grade_ff 1.0` 효과 | 0.5 로 막혔던 s=84.5 지점을 통과, s=91 까지 감 |
| ❌ 완주 못 함 | 구동 배터리 방전 (아래) |

**★ 구동 배터리가 빠지면 아무것도 안 된다 — 그리고 계측 수단이 없다**

```
아침 (drive_diag, 바퀴 들고)   움직이는 최소 PWM  50
밤   (지면, 하루 주행 후)      움직이는 최소 PWM  ~85
                                PWM 90 → 0.40 m/s   (아침 PWM 105 → 2.06 m/s)
```

**구동은 로직과 별도 전원이라 `/vcc_mv` 로 안 보인다.** 하루 종일 VCC(4106→3907→3134)를
보면서 "로직은 괜찮다" 고 판단했는데, 정작 죽은 건 보이지 않는 구동 쪽이었다.

이 하나가 그날의 모든 증상을 만들었다:
- 경사로에서 멈춤 → 명령 1.1 m/s 의 FF PWM 61 이 문턱 85 미만
- 그 뒤 조향 스톨 → **차가 섰기 때문**이다. 정지 상태 아스팔트 조향이 제일 무겁다
  (조향 자체는 정상 — `steer_sweep` 에서 ±6° 오차 1° 이내, 스톨 없음)

⚠ **방전 상태의 주행 기록은 판단에 쓰지 말 것.** 속도·PWM·문턱이 전부 다른 차가 된다.

**임시방편 (방전 상태에서 굳이 달려야 할 때만)**
```
ff_min_pwm:=90.0  ff_breakaway_pwm:=100.0
```
⚠ **충전 후에는 반드시 기본값(50)으로 되돌릴 것.** 충전 상태에서 PWM 90 은
1.7 m/s 를 내므로 곡률 제한이 무력해져 굴절코스·S자에서 이탈한다.

**★ `auto_calib_speed` 기본 0.5 는 부족하다 — 캘리브가 출발을 못 한다**

```
명령 0.5 m/s → FF 36.6 → 하한 50 적용 → 경사보상 −7 → PWM 43 < 문턱
```
`_ff_output` 은 **하한을 적용한 뒤 경사를 더한다**(내리막에서 하한이 중력 상쇄를
지우면 안 되므로 의도된 순서다). 그래서 완만한 내리막에서 하한 아래로 내려간다.
노드가 `자동 직진 타임아웃: 90초 안에 10m를 못 갔다. 구동 FF 부족` 으로 스스로 진단했다.

→ **`auto_calib_speed:=1.2`** 를 주면 FF 63.8 이라 출발한다.
  ⚠ 이것도 임시방편이었다. `ff_static` 을 제대로 맞추면 기본 0.5 로도 출발한다.

</details>

---

## ③-이전 절차 (참고 — teleop 격리 시험)

경사로 **3~5 m 앞**에 세운다. 터미널 2개.

```bash
cd /home/han/racing_ws && source install/setup.bash && ros2 launch tools/teleop_drive.launch.py ff_mode:=ros max_speed:=2.0 ff_min_pwm:=0.0 ff_breakaway_pwm:=60.0 grade_ff_gain:=0.5
```
```bash
cd /home/han/racing_ws && source install/setup.bash && python3 tools/ramp_test.py --label 오르막반 --drive 12 --speed 2.0 --abort-speed 2.8 --stuck-after 5 --seconds 40
```

**키보드 안 쓴다.** `ramp_test --drive` 가 `/teleop/cmd_vel` 로 자율 주행한다 —
엔터 치면 차가 12 m 가고 선다. E-stop 만 쥐고 있으면 된다.

- `--drive` = 조주 4 m + 경사 8 m. **경사 진입 후 8 m 면 정상상태에 닿는다**
- 경사로에서 서면 **뒤로 밀린다**(홀드 없음). `PWM:` 명령은 펌웨어 PID 를
  우회하므로 모터 부하는 0 이다. 뒤를 비워 둘 것 — 밀림 가속도 약 0.86 m/s²

**볼 숫자** (12.5% 기준 예측):

| | 예상 |
|---|---|
| 진입 직후 최저 | 1.5 m/s 로 한 번 떨어짐 (정상) |
| **정상상태 속도** | **1.8 m/s** |
| **정상상태 PWM** | **156** (포화 255) |

PWM 이 255 에 붙으면 경사가 예상보다 급하거나 배터리가 빠진 것이다.
잘 오르면 `grade_ff_gain:=1.0` 으로 한 번 더. **CSV 경로를 남길 것.**

**★ 이 주행이 부호를 다시 증명한다.** 정상상태는 가속도가 0이므로 PWM·속도만으로
경사를 역산할 수 있다 — IMU 를 안 쓰고:

```
sinθ = (0.0202·PWM − 0.861·v − 0.37) / 9.81
```

PWM 156, v 1.80 → 12.6%. ①의 IMU 측정과 **같은 부호·같은 크기면 확정**이다.

---

## ④ 커밋 · 배터리 충전 — 20분

대회 이틀 전에 미커밋 상태로 두지 말 것. 배터리는 전부 충전.

---

# 내일 (9/19) 용인 — 순서를 바꾸면 하루가 날아간다

```
0. ★ FF 재측정 (평지, 5분)          ← 9/18 에 이걸 몰라 세 시간을 썼다
1. bash tools/use_site.sh yongin      ← 원점이 76.8km 어긋나 있다
2. python3 tools/preflight.py         ← 원점·경로·정지점 일괄 검사
3. 경사로 실제 경사도 측정 (imu_grade --measure)   ← 4번 파라미터의 근거
4. 시운전 1랩 — grade_ff 켜고, 거버너·미션은 off   ← 아래 ⚠
5. python3 tools/mission_s.py --live  ← 경사로 시작/정상부/끝 포함, 전 미션
6. mission_plan.yaml 채우고 mission_plan_check.py 통과 → enabled:true
7. 한 겹씩 얹으며 1랩씩: 경사로 구간속도·거버너 → 회피 → 나머지 미션
8. 정지점 재기록 (현재 149.7km 어긋남)
```

## 0. ★ FF 재측정 — 가장 먼저, 5분 (9/18 에 얻은 교훈)

FF 식 `PWM = ff_gain·v + ff_static` 은 **그날의 배터리·노면에 따라 달라진다.**
9/17 값(38.8 / 17.2)을 9/18 에 그대로 썼다가 정적항이 **29 모자라** 커브마다
차가 섰고, 원인을 배터리·조향·열보호로 세 번 오진했다.

**평지 직선에서** 스택을 띄우고(`teleop_drive.launch.py ff_mode:=ros`):

```bash
ros2 topic pub /drive_pwm_cmd std_msgs/msg/Int32 "{data: 90}" -r 20
```

굴러가면 **정상상태 속도 v** 를 읽는다(`ros2 topic echo /current_speed_enc`).
안 굴러가면 110, 130 으로 올려 가며 굴러가는 값을 찾는다.

```
F0        = 0.0202·PWM − 0.861·v
ff_static = F0 / 0.0202
ff_gain   = 42.6        (0.861 / 0.0202 — 이건 안 변한다)
```

| 상태 | F0 | ff_static |
|---|---|---|
| 9/17 (정상) | 0.35 | **17** |
| 9/18 밤 (방전·노면) | 0.93 | **46** |

**검산**: 명령 2.0 을 줬을 때 실제로 2.0 근처가 나와야 한다. 한참 느리면
static 이 모자란 것이고, 명령보다 빠르면 과하다.

## ⚠ "미션 전부 off 로 기준 1랩" 은 **성립하지 않는다**

경사로는 미션이 아니라 **코스**다(s11~54). 끄고 돌 수가 없다.
그리고 기본값으로 돌면 **내리막이 탈락 경로**다 —
경사로가 s54 에 끝나고 **굴절코스가 s58 에 시작한다. 4m 뒤다.**

`tools/ramp_profile.py` (12.5% 가정 · v_max 2.8 · 굴절 진입 s58):

| 설정 | 경사 끝 s54 | **굴절 진입 s58** | |
|---|---|---|---|
| 전부 OFF | 3.93 | **3.08 m/s** | ❌ 굴절 상한 3.0 초과 |
| 거버너만 | 3.04 | 2.66 | ✅ |
| **거버너 + 피치** | 2.52 | **2.38** | ✅ 권장 |

**4m 로는 속도가 안 빠진다.** 3.93 → 3.08, 0.85 밖에 못 줄인다.

그래서 **첫 랩부터 `grade_ff_gain:=1.0 gov_pwm:=50.0` 을 켠다.**
피치는 9/18 에 부호를 확정했고, 거버너는 같은 날 3.0 상한 결함을 고쳤다
(d7c17b4). 둘은 선택이 아니라 **한 쌍**이다 — 피치가 속도를 3.0 아래로
눌러 줘야 거버너가 일할 여지가 생기고, 거버너는 피치가 실패했을 때의
마지막 방어선이다.

⚠ 3번에서 잰 **실제 경사도가 15% 를 넘으면** `grade_ff_max:=95` 를 같이 줄 것.

⚠ **용인 전체 코스이므로 `config/mission_plan.yaml` 을 쓴다.**
`config/ramp_course/mission_plan.ramp.yaml` 은 **단독 경사로 코스용**이다.
섞으면 `check_course` 가 길이 불일치를 잡아 **미션을 전부 끈다**(조용히).

## 첫 랩 진행 흐름

```
① RTK Fixed 대기
② 5초 카운트다운
③ 차가 스스로 10m 직진          ← ⚠ 앞을 비우고 E-STOP 쥘 것
④ 정지 → 직진성 검증
⑤ 통과 → yaw_offset 발행
⑥ 먹스: "헤딩 캘리브 완료 — 자율 허용"
⑦ 모드: AUTO → 경로 추종 시작
```

**⚠ ③은 헤딩을 모르는 개루프 직진이다.** 차가 지금 향한 쪽으로 그냥 간다.
경로 시작 방향으로 대충 맞춰 놓고 시작할 것. 직선 12 m 필요.

## 경사로를 본 주행에 얹는 명령

```bash
cd /home/han/racing_ws && source install/setup.bash && ros2 launch gps_localization bringup.launch.py control:=true lidar:=true sequencer:=true auto_calib:=true rviz:=false max_speed:=2.0 ff_mode:=ros ff_min_pwm:=0.0 ramp_up_arm_topic:=/ramp/up_arm v_ramp_up:=2.0 ramp_down_arm_topic:=/ramp/down_arm v_ramp_down:=1.11 grade_ff_gain:=1.0 gov_pwm:=50.0
```

⚠ **소수점을 꼭 찍을 것.** `v_ramp_up:=2` 는 INTEGER 로 들어가 노드가 즉사한다.

시작 로그에서 **네 줄**을 확인한다. 없으면 그 기능은 안 켜진 것이다:

| 로그 | 없으면 |
|---|---|
| `★ 오르막 구간 속도 켜짐` | `ramp_up_arm_topic`/`v_ramp_up` 미적용 |
| `★ 내리막 구간 속도 켜짐` | `ramp_down_arm_topic`/`v_ramp_down` 미적용 |
| `★ 경사 보상 켜짐` + 영점·부호 | ①을 안 했거나 `grade_ff_gain` 이 0 |
| `헤딩 초기화(1회성) 시작: 10m` | `auto_calib` 꺼짐 |

주행 중 arm 이 실제로 오는지:
```bash
ros2 topic echo /ramp/up_arm
```

## 차가 안 갈 때 — 로그로 원인 판별

| 로그 | 원인 | 조치 |
|---|---|---|
| `모드: STOP(헤딩 캘리브 전)` | 캘리브 미완료 | ③~⑤ 다시. 거부됐으면 3초 뒤 자동 재시도 |
| `모드: STOP(입력끊김)` | `/target_speed` 또는 `/steering_cmd` 없음 | 제어 노드가 떴는지 확인 |
| `⚠ 경로 ...s 끊김 — 완주 신호 없음` | GPS/IMU 끊김 | `gps_check` 로 RTK, IMU 재연결 |
| `정지: lookahead가 차량 뒤` | 헤딩 뒤집힘 의심 | `invert_imu_yaw:=true` 로 재시작 |
| `직진성 검증 실패 (편차 ...°)` | 캘리브 중 휘었다 | 자동 재시도. 계속 실패하면 더 평탄한 곳 |
| 내리막에서 **오히려 빨라진다** | **피치 부호 반대** | **즉시 `grade_ff_gain:=0.0`** → ① 다시 |

## 완주 판정

```
[local_sliding_window_node]  ★ 경로 완주 → 정지 신호 발행
[longitudinal_controller]    🏁 완주 신호 수신 — 감속 정지합니다 (고장 아님)
```

**`🏁` 가 뜨면 완주다. `⚠` 는 고장이다.** 이 구분을 위해 넣은 것이니 헷갈리지 말 것.

---

# 판단 근거 — 왜 이 순서인가

| 항목 | 실패하면 | 상태 (9/18 종료 시점) |
|---|---|---|
| 조향 전원 | 탈락 가능했음 | ✅ **해소** — 2회 시험 모두 링크 안 끊김 |
| 경로 추종 | 탈락 | ✅ 시뮬 완료 — 최악 조합에도 이탈 0.27 m |
| 경사로 부호 | 못 켬 | ✅ **확정** — `sign −1`, 양방향 검증 |
| 경사로 실주행 | 감점만 | ⬜ ③ 미완 (경사로 필요) |
| 미션 8개 | 감점만 | ⬜ 내일 s 실측 |
| 8분 초과 | 감점 5점/분 | — 무리할 이유 없음 |

**9/18 시점에서 탈락 리스크로 남은 것은 없다.** ③과 미션은 전부 감점 항목이다.

## 경로 추종은 폐루프 시뮬로 확인했다 (`tools/tracking_sim.py`)

용인 648 m · `wp_yongin_drive_0.5.yaml`:

| 조건 | 완주 | 최대 이탈 | 조향 포화 |
|---|---|---|---|
| 오차 없음 v=2.0 | ✅ | 0.15 m | 0 % (12.9°/18°) |
| v=2.8 (bringup 기본) | ✅ | 0.19 m | 0 % |
| 헤딩 편향 5° | ✅ | 0.32 m | 0 % |
| 헤딩 편향 10° | ✅ | 0.50 m | 0 % |
| 조향 중립 3° 어긋남 | ✅ | 0.25 m | 0 % |
| v=2.8 + 헤딩5° + 중립2° | ✅ | 0.27 m | 0 % |

이탈 경고선 0.72 m · 복귀 불가선 0.90 m. **코스 기하는 완주의 병목이 아니다.**
시뮬이 **안 보는 것**: 조향 전원 강하 · GPS 끊김 · 라이다 회피 override.

## 경사로는 grade_ff 없이는 안 된다 (`tools/ramp_profile.py`)

| 경사 | grade_ff 켬 | 끔 | 끔 + 구동 15% 약화 |
|---|---|---|---|
| 10 % | 1.61 m/s | 0.66 | 0.33 |
| **12.5 %** | **1.56** | **0.37** | **0.04 = 못 넘음** |
| 15 % | 1.51 | **못 올라감** | 못 올라감 |

어제 로그가 같은 말을 한다(`data/2026-09-17-ramp/ramp_PWM160_2302.csv`):
**PWM 105 에서 0.37 → 0.23 으로 꺼져 갔고, 160 으로 올리니 올라갔다.**
자율 FF 가 2.0 m/s 에 내는 PWM 은 **94.8** — 이미 실패한 105 보다 낮다.
grade_ff 가 +60 을 더해 155 를 만든다 = 어제 손으로 올린 160 과 같은 자리.

---

# 상시 참고

### 뭔가 이상하면 제일 먼저
```bash
bash /home/han/racing_ws/tools/ros_cleanup.sh
```
`pkill -f ros2` 는 런처만 죽인다. 고아 노드가 쌓이면 NTRIP 401 · USB 충돌 ·
yaw_offset 덮어쓰기가 난다.

### E-stop
```bash
ros2 topic pub --once /e_stop std_msgs/msg/Bool "{data: true}"
```

### 수동 조작 (별도 터미널)
```bash
cd /home/han/racing_ws && source install/setup.bash && ros2 run velocity_controller teleop_keyboard
```
※ `teleop:=true` 런치 인자는 쓰지 말 것 — xterm 이 없어 키 입력을 못 받는다.
※ **한글 입력 상태면 W 가 ㅈ 으로 들어가 차가 안 움직인다.** 영문 전환 확인.

### 이어서 볼 문서

| 문서 | 내용 |
|---|---|
| `RAMP_RUNBOOK.md` | 경사로 현장 절차 ①~⑦ |
| `HANDOFF_2026-09-18.md` | 저장소 작업 원칙 · 물리 상수 · 실행 위생 |
| `config/mission_plan.yaml` | 용인 미션 계획 (주석에 규정 조항) |

---

# ★ 2026-09-18 야간 — 완주 성공. FF 정적항이 원인이었다

```
🏁 완주 128.0m / 128.0m · 캘리브 10.1m 편차 2° · 거버너 개입 0 · 조향스톨 2회
```

## 원인 — `ff_static` 이 29 모자랐다

FF 식 `PWM = 38.8·v + 17.2` 은 9/17 에 식별한 값이다. 오늘 실측으로 다시 맞추면:

```
9/17 평지   PWM 105 → 2.06 m/s   ⇒ 구름저항 F0 = 0.35 m/s²
오늘 평지   PWM 110 → 1.50 m/s   ⇒ 구름저항 F0 = 0.93 m/s²   (2.7배)

오늘 차량의 역 FF :  PWM = 42.6·v + 46.1
설정값            :  PWM = 38.8·v + 17.2     ← static 이 29 부족
```

**모든 속도에서 PWM 이 29 씩 모자랐다.** 그래서:

| 명령 | 설정 FF | 실제 나온 속도 | 고친 FF | 실제 |
|---|---|---|---|---|
| 0.50 (캘리브) | 37 | **0.00** | 67 | 0.50 |
| 0.66 (급커브) | 43 | **0.00** | 74 | 0.66 |
| 1.10 | 60 | **0.32** | 93 | 1.10 |
| 2.00 (직선) | 95 | 1.14 | 131 | 2.00 |

직선은 갔고 **커브에서만 멈춘** 이유가 이것이다. 곡률 제한이 명령을 깎으면
FF 가 문턱 아래로 떨어진다.

## ⚠ `ff_min_pwm` 으로 고치려 하면 안 된다 (오늘 두 번 실패했다)

하한은 **평평한 바닥**이라 명령과 무관하게 같은 PWM 을 낸다. 개루프에는
속도를 제한하는 것이 없으므로 **하한이 곧 최저 속도**가 된다:

- `ff_min_pwm:=110` → 캘리브가 명령 0.5 인데 **1.55 m/s** 로 달려
  측위 점프 상한(2.0 m/s)에 걸려 거부됨
- 곡률 제한도 무력해진다 → 급커브를 그 속도로 들어간다 = 이탈

`ff_static` 은 **전체를 평행이동**하므로 명령↔속도 비례가 살아 있다. 이게 맞는 손잡이다.

## ⚠ 거버너를 전 구간에 켜 두면 커브에서 구동을 끊는다

`ff_min_pwm:=110` 주행(22:50)에서 거버너가 **38회** 개입했고,
**깎은 뒤 PWM 이 85 미만인 경우가 36회 중 25회**였다.

```
측정 1.09 > 명령 1.07 (+0.14) → PWM 63 → 50    ← 직후 차가 섬
```

곡률 제한이 명령을 빠르게 깎는데 차는 관성으로 못 따라온다 → 그 **추종 지연**을
거버너가 과속으로 읽는다. 초과 0.15 m/s 에 `gov_gain 300` 이 PWM 45 를 깎는다.
게다가 거버너가 개입하면 **`ff_min_pwm` 을 건너뛴다**(설계상, 내리막용).

→ **급한 내리막이 없는 구간에서는 `gov_pwm:=0`.** 경사로에서만 켠다.

## 성공한 설정

```bash
ros2 launch gps_localization bringup.launch.py control:=true auto_calib:=true rviz:=false \
  waypoints:=<wp> max_speed:=2.0 ff_mode:=ros \
  ff_static:=46.0 ff_gain:=42.6 ff_min_pwm:=0.0 ff_breakaway_pwm:=90.0 \
  grade_ff_gain:=1.0 grade_ff_max:=95.0 gov_pwm:=0.0
```

⚠ **`ff_static 46` 은 오늘 이 차·이 배터리 상태의 값이다.** 내일 충전 후에는
반드시 다시 잰다 — 충전되면 구름저항이 내려가 46 은 과하다(과속).

**내일 아침 첫 항목**: 평지에서 개루프 PWM 을 한 값 주고 속도를 재서 F0 을 구한다.
```bash
ros2 topic pub /drive_pwm_cmd std_msgs/msg/Int32 "{data: 90}" -r 20
```
`F0 = 0.0202·PWM − 0.861·v` · `ff_static = F0/0.0202` · `ff_gain = 42.6`

## 그 외 오늘 발견

- **IMU 노드가 자체 크래시한다** (exit 1). 22:33 세션 235초, 22:55 세션 122초.
  죽으면 0.5초 뒤 `_grade_pwm()` 이 0 을 반환해 **경사 보상이 조용히 사라진다**.
  오늘 정지의 원인은 아니었지만(죽은 시각이 167초 뒤) 경사로에서 터지면 못 올라간다.
- **조향 스톨은 원인이 아니라 증상이었다.** 완주한 주행에서 12회 → 2회로 줄었다.
  차가 구르면 정지 조향을 할 일이 없다.
