hanmin0211/racing_ws/HANDOFF_2026-09-18.md

# 인계 — 2026-09-18 (경사로 주행)

> **다음 세션은 이 문서만 읽고 이어서 일할 수 있어야 한다.**
> 앞선 세션의 대화 맥락은 남아 있지 않다고 가정하고 썼다.

---

## 0. 이 저장소에서 일하는 방식 (먼저 읽을 것)

현대자동차그룹 HL FMA 2026 출전 차량의 자율주행 스택이다. 취미 코드가 아니라
**현장에서 한 번에 돌아야 하는 제품**이다. 실패의 비용이 비대칭이다:

| | 결과 |
|---|---|
| 도로/연석 이탈 | **탈락** |
| 1분 이상 정지 | **탈락** |
| 미션 실패 | 감점 (회복 가능) |
| 시간 초과 | 감점 1분당 5점 (회복 가능) |

그래서 이 저장소의 규칙은 하나다. **검증되지 않은 것은 켜지 않는다.**

### 지켜야 할 다섯 가지

1. **검증 없이 덮어쓰지 않는다.** 기존 동작을 바꾸는 변경은 "바꾼 것이
   되는가" 가 아니라 **"나머지가 그대로인가"** 를 먼저 시험한다.
   예: `tools/test_ramp_section.py` 의 첫 절은 전부 "안 켜면 예전과
   완전히 같은 값인가" 다.

2. **새 기능의 기본값은 꺼짐.** 인자를 빼면 이전 동작으로 정확히 돌아가야
   한다. 현장에서 되돌릴 수 없는 변경은 만들지 않는다.

3. **주장에는 근거 파일을 붙인다.** "펌웨어 속도가 부정확하다" 가 아니라
   "`data/2026-09-17-ramp/ramp_5키로_2338.csv` 의 t=3.22 에서 펌웨어 3.05,
   엔코더 1.08" 이라고 쓴다. `/tmp` 경로를 인용하면 재부팅 후 거짓이 된다 —
   근거는 저장소에 넣는다.

4. **하드웨어 없이 검증할 수 있게 만든다.** 순수 함수로 빼서 시험이 실제
   구현을 부르게 한다(`_governor_pwm`, `_ff_output`, `_grade_pwm`,
   `_base_speed`, `decide_target`). 경사로에 차를 올려야만 확인되는 설계는
   확인이 안 된다.

5. **오진했으면 오진했다고 기록한다.** 이 문서의 §7 이 그것이다. 같은 함정에
   세 번 빠진 기록이 있어서 네 번째를 막는다.

### 판단이 틀렸던 이력 — 같은 실수를 반복하지 말 것

- 펌웨어 속도 잡음을 **'바퀴 슬립'** 으로 오진하고 PWM 을 낮추라는 처방까지
  냈다. 엔코더로 다시 보니 경사가 평지보다 조용했다.
- `/vcc_mv` 강하를 **'구동 전류'** 로 읽었다. 구동은 별도 전원이라
  `/vcc_mv` 에 안 나타난다. 범인은 **조향**이었다(4198→2038 mV).
- 시험 실패를 네 번 연속 잘못 진단했다(§7).

---

## 1. 지금 상태 — 한 장 요약

**브랜치** `yongin-2026-09-05` · 작업트리 깨끗 · 최신 `d99c834`

| 기능 | 상태 | 기본값 |
|---|---|---|
| 내리막 속도 거버너 | ✅ 실차 검증 (8.06 m 완주) | `gov_pwm=0` (꺼짐) |
| 엔코더 위치차분 속도 | ✅ 실차 검증 | 항상 켜짐 |
| IMU 경사 보상 | ⚠ **시험만** (실차 0회) | `grade_ff_gain=0` (꺼짐) |
| 웨이포인트 구간 속도 | ⚠ **시험만** (실차 0회) | 토픽 빈 문자열 (꺼짐) |
| 경사로 정지·출발 (규정) | ❌ 미착수 | `enabled: false` |

**시험**: 단위 13개 파일 · 통합 3개 파일 **전부 통과** (§6 에 재현 명령)
경사로 관련 단언 수는 `OK` 출력 줄 기준으로 `grade_ff` **29** ·
`ramp_section` **21** · `governor` **35**, 통합은 `mission_sequencer` **13** ·
`sudden_stop` **5** · `crosswalk_stop` **3**.

---

## 2. 오늘 밤 한 일 — 세 조각, 역할이 겹치지 않는다

| | 정하는 것 | 근거 신호 | 웨이포인트 |
|---|---|---|---|
| **grade_ff** | 그 속도를 내려면 **PWM 이 얼마여야** 하는지 | IMU 피치 | 불필요 |
| **구간 속도** | **어디서 얼마의 속도**를 낼지 | `course_s` (GPS+IMU) | 필요 |
| **거버너** | 그래도 빨라지면 **깎는다** | 엔코더 위치차분 | 불필요 |

셋은 직렬로 합쳐진다:

```
longitudinal_controller           serial_bridge_node
┌────────────────────┐            ┌──────────────────────────────┐
│ v_base = 구간속도   │            │ ff = 38.8·v + 17.2           │
│  ↓ min(곡률)        │  /cmd_vel  │  ↓ + 하한·정지마찰            │
│  ↓ min(정지선)      │ ─────────► │  ↓ + grade_ff (IMU)          │
│  ↓ min(장애물)      │            │  ↓ 거버너가 초과분을 깎음      │
└────────────────────┘            │  → PWM:{n}                    │
                                   └──────────────────────────────┘
```

### 2-1. 거버너 입력 교체 (커밋 `4a67c2f`)

**문제**: 내리막 5 km/h 시험이 2.53 m/s 로 중단됐다. 거버너는 개입했지만
입력이 잡음이라 헛짚었다. 같은 순간의 값:

```
t=2.59  펌웨어 VEL 1.90  ↔ 엔코더 실속 0.63
t=3.22  펌웨어 VEL 3.05  ↔ 엔코더 실속 1.08   → PWM 71→23
t=3.44  펌웨어 VEL 0.06  ↔ 엔코더 실속 0.65   → PWM 23→59
```

**원인**: 펌웨어는 10 ms 창으로 미분한다. 1카운트 = 2.875 mm 이므로
눈금이 **0.2875 m/s** 다 — 4 km/h(1.11)를 표현할 수가 없다.

**해결**: `_enc_pos_update()` — 카운트를 **0.30 s 창으로 위치차분**한다.
위치는 튀지 않으므로 스파이크가 구조적으로 생길 수 없다.

```
표본간 변동  펌웨어 0.501 → 위치차분 0.111 m/s  (4.5배)
최대치       펌웨어 3.68  → 위치차분 1.84 m/s
```

**선행항**(`gov_lead_s=0.30`): 지금 가속도로 0.3초 뒤를 내다본다.
같은 목표에서 최초 개입이 t=3.27 → **2.27 s**, 1.0초 앞당겨진다.

### 2-2. IMU 경사 보상 (커밋 `b60b080`) — ⚠ 실차 미검증

**문제**: 개루프 FF 는 평지에서 식별한 식이라 중력을 모른다.

| 경사 | `g·sinθ/k` | 4 km/h 유지 PWM |
|---|---|---|
| 법정 오르막 12.5% | **+60** | +120 |
| 법정 내리막 9% | **−44** | +17 |
| 시험 경사 19.3% | ±92 | −33 (제동) |

**해결**: IMU 피치로 그 항을 직접 상쇄한다. 웨이포인트가 필요 없다.

**왜 기본이 꺼짐인가**: 부호가 반대면 **내리막에서 가속한다.**
`hfi_a9_ros2.py:207` 이 이미 한 번 뒤집고(`-angle_degree[1]`), 거기에
마운트 방향·기울기가 섞여서 **코드만 읽어서는 부호를 단정할 수 없다.**
그래서 재는 도구(`tools/imu_grade.py`)를 먼저 만들었다.

### 2-3. 웨이포인트 구간 속도 (커밋 `0e92dad`) — ⚠ 실차 미검증

**설계 결정 — 이게 핵심이다.** `decide_target()` 에는 두 갈래가 있다:

```python
policy = MISSION_POLICY.get(self.mission)
if policy is not None:
    return float(policy)        # ← 고정속도. 여기서 끝난다.

v = v_base                      # ← 아래로 곡률·정지선·장애물이 min 으로 쌓인다
```

**위쪽으로 붙이면 하류 제한이 전부 사라진다.** 구간 s 를 잘못 적어 코너에
걸리면 그 속도로 코너에 들어간다 = 이탈 = **탈락**.

그래서 `v_base` 만 바꿨다. 구간이 굴절코스 첫 코너(R=6.4 m)에 잘못 걸려도
곡률 제한이 `2.0/(1+6.0·0.156) = 1.03 m/s` 로 눌러 준다. 시험으로 못 박았다.

---

## 3. 검증된 물리 상수 — 출처와 함께

**이 값을 바꾸려면 새 측정이 있어야 한다.** 추정으로 덮어쓰지 말 것.

| 상수 | 값 | 출처 |
|---|---|---|
| 구동 FF | `PWM = 38.8·v + 17.2` | `ff_sweep` 실측 |
| 가속도/PWM `k` | **0.0202 m/s²/PWM** | 경사 등반 실측 |
| 구름저항 `f` | 0.733 m/s² | 관성 감속 실측 |
| 엔코더 1카운트 | 2.875 mm (`2π·0.1327/290`) | `cpr = -290`, 전진 시 **감소** |
| 텔레메트리 주기 | **20 Hz (0.051 s)** | 이름은 `STATUS_10ms` — 속기 쉽다 |
| 시험 경사로 | **19.3%** | 운동방정식 역산 (§3-1) |
| 평지 정상속도 | 2.33 m/s @ PWM 105 | 실측 |

### 3-1. 경사를 두 방법으로 교차검증했다

`data/2026-09-17-ramp/ramp_4키로_2349.csv` 정상상태(2 m 이후 155표본)에서
가속도가 0 이므로:

```
g·sinθ/k = FF(v) − PWM_실제
         = (38.8×1.58 + 17.2) − (−15)
         = 78.5 + 15 = 93.5
g·sinθ = 93.5 × 0.0202 = 1.89 m/s²  →  sinθ = 0.193 = 19.3%
```

`tools/slope_meas.py` 의 관성 측정(18~20%)과 일치한다. **서로 다른 두 방법이
같은 답을 냈으므로 `k = 0.0202` 도 같이 검증된 셈이다.**

이 19.3% 는 내일 IMU 부호 확인의 **독립적인 기준값**으로 쓴다.

### 3-2. P 제어 정상편차(droop)를 예측하고 맞췄다

```
excess = (FF − 필요PWM)/gain + deadband
       = (60.3 − (−33))/300 + 0.10 = 0.411
예측 1.52 m/s  ↔  실측 1.58 m/s   (오차 4%)
```

**목표보다 빠른 것은 고장이 아니다.** 이득을 올리면 줄지만 진동과 맞바꾼다.
제대로 잡으려면 적분이 필요하고 그건 펌웨어 PID(`NO_ENCODER 0`)의 몫이다.

---

## 4. 파일 지도

### 바뀐 소스

| 파일 | 무엇 |
|---|---|
| `src/velocity_controller/velocity_controller/serial_bridge_node.py` | 위치차분 추정기 · 거버너 선행항 · IMU 경사보상 · `_ff_output()` |
| `src/velocity_controller/velocity_controller/longitudinal_controller_node.py` | `_base_speed()` · 구간 arm 구독 |
| `src/pure_pursuit_pkg/launch/control.launch.py` | `ramp_up_arm_topic` 등 4개 인자 |
| `tools/teleop_drive.launch.py` | `gov_lead_s` · `grade_ff_gain` · `grade_ff_max` · `imu_topic` |
| `config/mission_plan.yaml` | `ramp_up` / `ramp_down` 배경 미션 (enabled:false) |

### 새 도구

| 도구 | 언제 쓰나 |
|---|---|
| `tools/imu_grade.py` | **경사 보상 켜기 전 필수.** 평지 영점 → 경사 부호 확정 |
| `tools/replay_governor.py` | 기록된 주행을 실제 추정기·거버너에 먹여 재생. 하드웨어 불필요 |
| `tools/ramp_test.py` | 경사로 자율 주행 + 판정 (기존, `venc` 열 추가) |
| `tools/slope_meas.py` | 모터 없이 관성으로 경사 측정 (기존) |
| `tools/drive_diag.py` | 구동 vs 조향 전류 분리 진단 (기존) |

### 근거 로그 (저장소 안)

```
data/2026-09-17-ramp/ramp_5키로_2338.csv   ← 거버너가 잡음을 쫓다 놓친 런
data/2026-09-17-ramp/ramp_4키로_2349.csv   ← ✅ 성공한 런. 19.3% 역산 근거
data/2026-09-17-ramp/ramp_거버너1_2329.csv ← 통째 역PWM 시절 진동
```

### 절차서

**`RAMP_RUNBOOK.md`** — 현장에서 이것만 보고 순서대로 하면 된다.

---

## 5. 파라미터 — 정확한 기본값

### serial_bridge_node

| 파라미터 | 기본 | 의미 |
|---|---|---|
| `ff_mode` | `firmware` | ⚠ 런치 기본은 `ros`. 펌웨어 PID 미적용 상태라 `ros` 가 맞다 |
| `ff_gain` / `ff_static` | 38.8 / 17.2 | 실측 FF |
| `ff_min_pwm` | 50.0 | 크리프 하한. 경사 시험에서는 0.0 으로 준다 |
| `ff_breakaway_pwm` / `_ms` | 60.0 / 1200 | 정지마찰 돌파 |
| `gov_pwm` | **0.0 = 꺼짐** | 거버너 역 PWM 상한 |
| `gov_deadband` | 0.10 | 이만큼 넘어야 개입 [m/s] |
| `gov_gain` | 300.0 | 초과 1 m/s 당 깎을 PWM |
| `gov_lead_s` | 0.30 | 선행시간 [s] |
| `grade_ff_gain` | **0.0 = 꺼짐** | 1.0 = 완전보상 |
| `grade_ff_max` | 70.0 | 보상 PWM 상한 |
| `imu_topic` | `handsfree/imu` | |

**내부 상수** (파라미터 아님, 근거는 코드 주석에):
`ENC_WIN_S=0.30` · `ENC_ACC_TAU=0.20` · `ENC_JUMP_COUNTS=400` ·
`GOV_LEAD_CAP=1.0` · `GRADE_FRESH_S=0.5` · `GRADE_MAX_RAD=0.35` ·
`GRADE_TAU=0.30` · `BRAKE_MEAS_FRESH_S=0.5` · `BRAKE_V_PLAUSIBLE=3.0`

### longitudinal_controller

| 파라미터 | 기본 | 의미 |
|---|---|---|
| `ramp_up_arm_topic` / `ramp_down_arm_topic` | `''` = 안 씀 | 구독조차 안 한다 |
| `v_ramp_up` / `v_ramp_down` | 0.0 = 안 씀 | |
| `ramp_arm_timeout` | 1.0 | arm 끊기면 `v_max` 복귀 |

⚠ **런치 인자는 반드시 소수점을 찍을 것.** `v_ramp_up:=2` 는 INTEGER 로
들어가 노드가 즉사한다.

### 경사별 권장값 (4 km/h 기준)

| 경사 | `gov_pwm` | 4km/h 유지 PWM |
|---|---|---|
| 법정 6.5~9% | 40 | +29 ~ +17 (구동) |
| 12.5% | 50 | 0 |
| 시험 19.3% | 60 | −33 (제동) |

**법정 내리막은 제동이 아니라 스로틀만 줄이면 된다.** 플러깅 전류가 안 흐른다.
과전류 우려는 시험 경사(법정의 2~3배)에만 해당한다.

---

## 6. 시험 — 재현 명령

```bash
cd /home/han/racing_ws && source /opt/ros/humble/setup.bash && source install/setup.bash
```

### 단위 (하드웨어·노드 불필요, 각 1초 이내)

```bash
for t in test_grade_ff test_ramp_section test_governor test_brake_logic \
         test_drive_review test_mission_plan_check test_avoid_rate test_avoid_hold \
         test_aim_clearance test_avoid_geometry test_mount_geom \
         test_parking_geometry test_lidar_mount_check; do
  printf "%-24s " $t; python3 tools/$t.py >/dev/null 2>&1 && echo PASS || echo FAIL
done
```

| 시험 | 건수 | 무엇을 지키나 |
|---|---|---|
| `test_grade_ff` | 29 | **부호 5건** (전진/후진 × 오르막/내리막) · 물리 7 · 안전장치 5 |
| `test_ramp_section` | 21 | **"안 켜면 예전과 같은가"** · 구간 오배치 시 하류 제한 생존 |
| `test_governor` | 35 | 추정기 7 · 선행 5 · 부호 · 안 걸려야 할 때 안 걸림 |

건수는 시험이 출력하는 `OK` 줄을 센 것이다. 세는 방법:
```bash
python3 tools/test_grade_ff.py | grep -c '^\s*OK '
```
⚠ 커밋 메시지 `b60b080`/`0e92dad` 에는 28/23 으로 적혀 있다. 그때는 세지 않고
썼고, 나중에 실제로 세어 보니 29/21 이었다. **이 표가 맞다.**

`test_aim_clearance` · `test_avoid_geometry` · `test_parking_geometry` 는
출력 형식이 달라 위 방법으로는 안 세어진다 — 통과/실패만 본다.

### 통합 (노드를 띄운다 — §7 의 위생 수칙을 반드시 지킬 것)

```bash
pgrep -af 'install/[a-z_]+/lib/'      # 비어야 한다
pgrep -af mission_sequencer           # 비어야 한다
```
```bash
ROS_DOMAIN_ID=91 timeout 900 python3 -u tools/test_mission_sequencer.py
ROS_DOMAIN_ID=91 timeout 300 python3 -u tools/test_sudden_stop.py
ROS_DOMAIN_ID=91 timeout 300 python3 -u tools/test_crosswalk_stop.py
```

### 하드웨어 없이 거버너 재검증

```bash
python3 tools/replay_governor.py data/2026-09-17-ramp/ramp_5키로_2338.csv --speed 1.11
```

---

## 7. ⚠ 실행 위생 — 여기서 네 번 오진했다

노드를 띄우는 통합시험은 **세 가지를 전부** 지켜야 결과를 믿을 수 있다.

### ① 오버레이를 소스한다

```bash
source /opt/ros/humble/setup.bash && source install/setup.bash
```

안 하면 `ros2 run mission_perception ...` 이 패키지를 못 찾아 **노드가 아예
안 뜬다.** subprocess 출력은 `PIPE` 로 삼켜지므로 "차가 안 섰다" 같은
**엉뚱한 실패**로만 보인다. 이걸로 두 번 오진했다.

### ② 좀비를 확인한다 — 경로 패턴은 잘 빗나간다

```bash
pgrep -af 'install/[a-z_]+/lib/' | xargs -r kill -9
pgrep -af mission_sequencer        # ← 이름으로 한 번 더
```

`pkill -f 'mission_perception/mission_sequencer'` 는 **안 맞는다.**
실제 경로는 `.../mission_perception/lib/mission_perception/mission_sequencer` 다.
죽었다고 착각하고 "좀비 가설은 틀렸다" 고 결론냈다.

좀비 증상: **같은 틱에 ARM 과 DISARM 이 둘 다 찍힌다** (두 벌이 반대 값을 쏜다).
정리 후 돌리니 `crosswalk ARM` 이 **323회 → 1회**, 전 항목 통과였다.

### ③ 시험을 겹쳐 돌리지 않는다

백그라운드로 하나 띄워 놓고 또 띄우면 **서로가 서로의 좀비가 된다.**
`ROS_DOMAIN_ID` 로 격리하면 사용자의 런치는 피하지만, **내가 만든 좀비는
같은 도메인**이라 안 피해진다.

### 고친 것

`timeout N python3 ...` 로 상한을 걸면 SIGTERM 이 오는데, 파이썬은
**SIGTERM 에서 `finally` 를 안 돌리고 즉사**한다 → `kill_group` 이
건너뛰어지고 자식이 산다. 세 시험(`test_mission_sequencer`,
`test_sudden_stop`, `test_crosswalk_stop`)에 SIGTERM → `KeyboardInterrupt`
변환과 `atexit` 청소를 넣었다 (커밋 `e6c432a`).

---

## 8. 검증 안 된 것 · 미해결 (정직하게)

### 실차에서 한 번도 안 돌았다

- **`grade_ff`** — 시험 28건은 전부 **합성 입력**이다. 물리식·부호 처리·
  안전장치는 못 박았지만, **IMU 실제 부호는 현장에서 처음 확인된다.**
  `RAMP_RUNBOOK.md` 의 ①② 를 건너뛰면 안 되는 이유다.
- **구간 속도** — 시험 23건은 `decide_target()` 을 직접 부른 것이다.
  시퀀서 연동(arm 토픽이 실제로 오는지)은 현장이 처음이다.

### 미해결 결함

1. **경사로 정지 후 뒤로 밀린다** (엔코더 홀드 없음).
   규정: 후방 50 cm 이상이면 5점. 경사로 정지·출발 미션을 켜기 전에 해결 필수.
2. **조향이 전원을 무너뜨린다** — 무부하에서도 4198 → 2038 mV(강하 2258 mV).
   브라운아웃 위험선 4300, 과거 리셋선 3483 을 한참 밑돈다.
   S자·굴절처럼 조향이 계속 큰 구간에서 링크가 끊길 수 있다.
   **1분 정지 = 탈락.** 이게 9/19 1순위다.
3. **플러깅 중 엔코더 0.72 s 정지**가 관측됐다. 폐루프(`NO_ENCODER 0`)를
   켜기 전에 원인을 밝혀야 한다.
4. **펌웨어 폐루프 미적용** — `arduino/henes_firmware.ino` 에서
   `NO_ENCODER 0` 으로 바꿔 뒀지만 **굽지 않았다.** 백업은
   `arduino/backup/`. 구우면 `ff_mode:=firmware` 로 바꿔야 하고,
   그때 `ff_min_pwm`/`ff_brake_pwm` 이 무력화된다는 점을 잊지 말 것
   (이 함정으로 두 런을 날렸다).

### 현장에서만 할 수 있는 것

- `bash tools/use_site.sh yongin` — 원점이 **76.8 km** 어긋나 있다.
- 정지점 재기록 — 현재 파일은 **149.7 km** 어긋나 있다.
- 모든 미션의 `s` 실측 (`tools/mission_s.py --live`).
  계획의 8개 미션 중 **enabled 된 것이 하나도 없다.**

---

## 9. 9/19 우선순위

```
1. 조향 전원 강하 조사        ← 유일한 탈락 리스크. 나머지는 감점
2. bash tools/use_site.sh yongin
3. 미션 s 실측 → mission_plan.yaml → mission_plan_check.py
4. 경사로 주행 (RAMP_RUNBOOK.md ①~⑥)
5. 경사로 정지·출발 (뒤로 밀림 해결 후)
```

**경사로는 감점-only 다.** 조향 문제를 제쳐두고 경사로에 시간을 쓰면 안 된다.

### 첫 명령

```bash
cd /home/han/racing_ws && source install/setup.bash && python3 tools/drive_diag.py --yes
```
(바퀴를 들고 실행. 구동 vs 조향 전류를 분리해서 본다)

---

## 10. 커밋 이력 (오늘 밤)

```
d99c834  근거 로그를 저장소로 옮긴다 — /tmp 를 인용한 주석은 재부팅하면 거짓이 된다
e6c432a  통합시험이 SIGTERM 에서 좀비를 남기지 않게 한다 (세 번째 재발)
ceed8bb  경사로 현장 절차서 — 부호 확인을 건너뛸 수 없게 순서를 못 박는다
0e92dad  경사로 구간 속도 — 기준값만 바꾸고 안전장치는 전부 남긴다
b60b080  IMU 피치로 경사를 상쇄한다 — 기본 꺼짐, 부호는 현장에서 확정
c6a47c6  내리막 서행 성공 — 19.3% 경사를 4km/h 목표로 8m 완주
4a67c2f  거버너 입력을 펌웨어 VEL 에서 엔코더 위치차분으로 바꾼다
f116131  거버너 런치 기본값도 맞춘다 (노드만 고쳤다가 옛 값이 나갔다)
498b867  거버너를 연속 조절로 — '버티면서 내려가기' 가 안 되던 이유
```

## 11. 이어서 읽을 문서

| 문서 | 내용 |
|---|---|
| `RAMP_RUNBOOK.md` | **현장 절차.** 경사로 작업은 이것부터 |
| `HANDOFF_2026-09-17_ramp.md` | 경사로 세션 상세 · 물리 상수 유도 |
| `HANDOFF_2026-09-17_night.md` | 도구 결함 · 용인 코스 곡률 분석 |
| `config/mission_plan.yaml` | 미션 계획. 주석에 규정 조항이 들어 있다 |
| `PLAN_HL_FMA_2026.md` | 전체 로드맵 |
