hanmin0211/racing_ws/HANDOFF_2026-09-17_ramp.md

# 인계 — 2026-09-17 밤 (경사로 실차 세션)

브랜치 `yongin-2026-09-05` · 대회 **9/19 점검 · 9/20 본경기**
이전: `HANDOFF_2026-09-17_night.md` (판정 도구 수정·용인 코스 분석)

> 이 세션은 **차를 붙여 놓고** 경사로를 5시간 시험했다. 결론부터:
> **차는 대회 경사로를 오른다. 오늘 못 오른 건 시험 장소가 법정보다
> 1.5~2배 가팔라서다.**

---

## 0. 한 줄 요약

```
시험 경사 18~20%   ·   법정 경사로 10~12.5%   ·   차의 한계 PWM160 에서 21.9%
```

오늘 5시간을 "왜 못 오르지" 로 쓴 이유는 **경사를 한 번도 안 재고** PWM만
90→230 으로 바꿔가며 시험했기 때문이다. 경사를 재자 10분 만에 끝났다.

---

## 1. ★ 실측 물성 (이 차의 기준값)

| 항목 | 값 | 근거 |
|---|---|---|
| 추진력 계수 k | **0.0202 m/s²/PWM** | 평지 가속 173쌍 적합 |
| 구름저항 f | **0.733 m/s²** | 밀었다놓기. 기록 이력 0.31~0.43 의 2배 |
| 시험 경사 | **18.0%** (10.2°) | 밀었다놓기 · 평형점 역산 20.2% 와 일치 |
| 평지 정상속도 | 2.33 m/s @ PWM 105 | 15m 완주, 정지 0회 |

**PWM 160 으로 오를 수 있는 경사:**

| 등속 속도 | 한계 경사 |
|---|---|
| 0.5 m/s | 26.3% |
| 1.0 m/s | 21.9% |
| 1.5 m/s | 17.7% |

**법정 경사로 대비** (도로교통법 시행규칙 별표 23: 오르막 10~12.5%,
내리막 6.5~9%, 높이 1.5m 이상, 정상부 4m/R15~16m):

| | 경사 | 필요 | PWM160 으로 등속 가능 최대 |
|---|---|---|---|
| 법정 하한 | 10.0% | 0.98 m/s² | **2.4 m/s** |
| 법정 상한 | 12.5% | 1.22 m/s² | **2.1 m/s** |
| 오늘 시험장 | 18.0% | 1.74 m/s² | 1.5 m/s |
| 시험장 상부 | 20%+ | 1.92 m/s² | 1.2 m/s |

→ **대회 경사로는 여유 있게 오른다.**

**이 시험 경사로의 구간별 경사** (PWM 160 고정 런에서 역산):

| 구간 | 속도 | 역산 경사 |
|---|---|---|
| 중반 1.1~9.5m | 1.20 m/s **평형** | **20.2%** |
| 상부 9.5~10.5m | 0.79 m/s 감속 | **25.2%** |

차의 한계(1.0 m/s 에서 21.9%)를 **상부에서 넘는다.** 그래서 9.5~10.5m 에서
진다. 중반 20% 는 등속으로 버틴다 — 이게 이 차의 실제 능력이다.

⚠ **좀비 브리지를 조심할 것.** `serial_bridge` 가 둘이 뜨면 서로 다른
  `ff_min_pwm` 으로 **같은 포트에 동시에 쓴다**. 주행 중 PWM 이 160↔105 로
  튀어 차가 죽는다(오늘 3개 런이 이렇게 오염됐다: 오르막1_2152 ·
  PWM160_2302 · 반복1_2308). 게다가 전압도 같이 떨어진다(3867 → 정리 후 4311).
  **매 런 전에** `pgrep -af 'install/[a-z_]+/lib/'` 로 확인할 것.
  판별법: 기록 CSV 의 `pwm` 열에 값이 **두 종류 이상** 섞이면 좀비다.

---

## 2. ★★ 엔코더는 살아 있다 — 인계문서가 틀렸다

이전 문서들의 "엔코더가 죽어(NO_ENCODER 1) 홀드 불가" 는 **사실이 아니다.**
실차 확인:

```
차를 4.6m 밀어  카운트 -1422 → -3025 (연속, 갱신 18~20Hz)
전진에 **감소**  → counts_per_revolution = -290 부호 맞음
/current_speed  434샘플 전부 양수, 최대 +0.46 m/s
주행 중 최장 정지 0.03~0.13s (한계 0.25s)
```

2026-09-05 용인에서 ENC1=0 으로 읽혀 껐고, 그 뒤 되돌린 기록이 없었다.
문서 자체도 모순이었다 — 주석은 "인터럽트 4체배로 교체했다" 인데 코드는
여전히 LS7366R SPI 카운터다.

**⚠ `/current_speed` 는 믿지 말 것.** 펌웨어가 10ms 창으로 미분해서
양자화 잡음(1카운트 = 0.0575 m/s)이 그대로 실린다. 갱신 간 변화량 중앙이
정확히 2카운트(0.115)이고, 0.5m/s 넘는 점프가 평지·경사 똑같이 8~9% 난다.
**엔코더 카운트를 0.25초 중심차분** 할 것 (`ramp_test.py` 가 그렇게 한다).

---

## 3. ★ 조향이 전압을 무너뜨린다 (VMIN 범인)

`tools/drive_diag.py` 실측, **바퀴를 든 채**:

```
기준          4198 mV
구동 PWM 50   강하    0 mV   (엔코더 3카운트, 정상 회전)
조향 ±18°     강하 2160 mV  →  최저 2038 mV
```

ATmega2560 동작 하한 아래, 과거 리셋선(3483)보다 한참 아래다.
**접지 마찰이 없는 공중인데도** 이만큼 무너진다.

기록된 주행의 VMIN 2282~2528 을 계속 '구동 부하' 로 봤는데 **조향이었다.**
상관분석에서도 조향(−0.37~−0.71)이 속도(−0.26~−0.61)보다 강했다.

> 용인 S자·굴절코스는 조향이 계속 큰 구간이다. 거기서 링크가 끊기면
> 경로가 끊겨 차가 서고, 1분 넘으면 탈락이다. **9/19 최우선 점검 항목.**

**구동은 로직 레일과 별도 전원이다** — `/vcc_mv` 로 구동 전류를 볼 수 없다.
'전압이 안 흔들리니 전력이 안 간다' 는 판단을 하면 안 된다(실제로 했다가
정상 런에도 오탐이 떴다).

---

## 4. 구동 모터 드라이버 열보호

PWM 170 으로 3.5 m/s 를 몇 초 달린 직후 **PWM 200 에 무반응**이 됐고,
10분 뒤 PWM 50 에 정상 회전했다. 열보호로 보인다.

> 지속 고 PWM 을 상시 설정으로 쓰면 대회 중에도 한동안 못 달릴 수 있다.
> 닫힌 루프는 평지에서 PWM 56 이면 되므로 이 위험이 줄어든다.

---

## 5. ★★ 구간별 속도 적용 — 검증 결과

**질문:** "웨이포인트 기반으로 오르막 구간에서 다르게 올라가게, 주행에
문제 없이 적용 가능한가?"

### 구조는 있다. 그런데 **선이 끊겨 있다.**

```
시퀀서          course_s 로 구간 arm  →  /mission/active (미션 이름)
                                        /mission/state  (사람이 읽는 요약문)
longitudinal    /mission_state 를 구독   ← **아무도 발행하지 않는다**
```

`MISSION_POLICY` (DRIVE/STOP/SLALOM/REVERSE_PARK/ALIGN)가 **통째로 죽은
코드**다. 미션 상태가 안 오니 항상 'DRIVE' 다. 신호등 `traffic_light_topic`
어긋남과 **똑같은 종류**이고 역시 오류가 안 난다.

또 `self.active` 는 **exclusive 미션만** 담는다. 경사로 구간은 배경 오버레이
(`exclusive: false`)가 맞으므로 `/mission/active` 에 안 잡힌다.
→ longitudinal 이 **arm_topic(Bool)을 직접 구독**하는 쪽이 맞다.

### 안전성 — 개루프로는 **안 된다**

```
개루프:  PWM 160 = 속도 명령 3.68 m/s
         먹스 max_speed 기본 2.8 → PWM 126 까지만 (경사 23% 까지)
         max_speed 를 3.7 로 올리면 **평지에서도 3.68 m/s 가능**
         → 굴절코스 첫 코너(R=6.4m) 상한 3.0 초과  ❌
```

즉 개루프에서 구간별로 올리려면 전역 상한을 위험한 값으로 열어야 한다.

### 닫힌 루프면 **가능하고 안전하다**

```
닫힌루프: 명령 2.0 m/s → FF 95 + PID(적분권한 ±120) → 상한 160 도달  ✅
          구간이 **잘못 걸려도** 평지 실제속도는 명령대로 2.0 m/s
          2.0 < 굴절코스 상한 3.0  →  오작동해도 안전
```

**이게 결정적이다.** 구간 s 를 잘못 잡는 것이 이 프로젝트의 단골 사고인데
(메모리 `mission-plan-must-match-course`), 닫힌 루프에서는 그 사고가
**치명적이지 않다.**

### 붙이는 순서 (닫힌 루프 전환 후)

```
1. 펌웨어 NO_ENCODER 0  (이미 커밋, 재굽기 필요)
2. ff_mode:=firmware     (teleop 런치 기본값은 이미 바꿈)
3. 계획에 ramp 미션 추가:  exclusive: false · arm_topic: /ramp/arm
                          trigger: course_s · s_enter/s_exit
4. longitudinal 에 ramp_arm 구독 + v_ramp 파라미터 (미구현)
5. mission_plan_check.py 로 구간 검증
```

⚠ 4번은 아직 안 만들었다. 3~4줄이면 되지만 **닫힌 루프 검증이 먼저**다.

---

## 6. 닫힌 루프 전환 (준비 완료, 재굽기 필요)

```
펌웨어  NO_ENCODER 1 → 0        (커밋됨. 직전 플래시는 arduino/backup/)
런치    teleop ff_mode 기본 'ros' → 'firmware'  (커밋됨)
```

**왜 필요한가 — 개루프는 평지 속도와 경사 토크가 한 값에 묶인다:**

```
PWM  90 → 평지 2.7 m/s · 경사 못 버팀 (7.7m 되밀림)
PWM 160 → 경사 등반 가능 · 평지 3.68 m/s (굴절코스 상한 초과)
```

닫힌 루프는 목표 1.0~2.0 m/s 하나로 **평지 56 / 경사 160** 을 자동으로 낸다.
`MAX_DRIVE_PWM` 이 정확히 160 이라 상한도 맞는다.

**굽고 나서 검증 순서:**
```bash
ros2 param get /serial_bridge_node ff_mode          # → firmware
# ① 바퀴 들고 — 속도가 목표로 수렴하는지
python3 tools/ramp_test.py --label 폐루프_공중 --drive 50 --speed 1.0 --seconds 8 --abort-speed 99
# ② 평지 — '명령 대 실제' 가 1.00 에 가까워야 (개루프였을 땐 0.47~1.62)
python3 tools/ramp_test.py --label 폐루프_평지 --drive 10 --speed 1.0
# ③ 경사
python3 tools/ramp_test.py --label 폐루프_경사 --drive 20 --speed 1.5 --stuck-after 5
```

⚠ 굽기 전 **현재 플래시를 새로 백업**할 것.

---

## 7. 새 도구

| 도구 | 용도 |
|---|---|
| `tools/ramp_test.py` | 경사 주행 기록·판정. `--drive` 로 **자율 주행**(키보드·GPS 불필요) |
| `tools/slope_meas.py` | **경사를 차로 잰다.** 모터 안 씀 — 밀었다 놓으면 끝 |
| `tools/drive_diag.py` | 구동 vs 조향을 같은 기준으로 재서 전원 계통을 가른다 |

```bash
# 경사 측정 — 세게 밀고 **완전히 손 떼기** (따라가면 안 된다)
python3 tools/slope_meas.py

# 자율 등반 (GPS·웨이포인트 불필요, 거리는 엔코더로)
ros2 launch tools/teleop_drive.launch.py ff_mode:=ros max_speed:=1.2 \
     ff_min_pwm:=160.0 ff_breakaway_pwm:=200.0
python3 tools/ramp_test.py --label X --drive 15 --speed 1.2 --abort-speed 3.5 --stuck-after 5
```

---

## 8. 오늘 밟은 함정 (제가 오진한 것들 — 전부 정정·커밋됨)

1. **"바퀴 슬립"** — 펌웨어 속도의 양자화 잡음이었다. 엔코더 기준으로 다시
   보니 경사가 평지보다 오히려 조용했다(0.48~0.59 vs 0.42)
2. **"구동 전력이 안 간다"** — 구동은 로직 레일과 별도 전원이라 안 보일 뿐
3. **"간헐 단선 확정"** — 무부하 런에서 바퀴가 지면에 닿아 오염된 측정이었다
4. **"경사가 한계다"** — 그때 드라이버가 열보호 상태였다
5. **신호 분해능을 안 재고 문턱을 정해 틀린 것이 네 번**
   (변화율 분모 / 과샘플링 / 정지 판정 / 슬립)
   → **파생 신호를 쓰기 전에 원본의 양자화를 먼저 잴 것**
6. **경사를 안 재고 PWM 만 5시간 바꿨다** — 재는 데 30초였다

---

## 9. 9/19 우선순위 (갱신)

```
□ 1. 조향 전원 계통      ±18° 에 레일이 2038mV 로 무너진다. S자·굴절에서 치명
□ 2. 배터리              세션 중 4395 → 3867mV. 충전 + 여분
□ 3. 닫힌 루프 전환·검증  NO_ENCODER 0 재굽기 후 위 ①②③
□ 4. 원점 전환           bash tools/use_site.sh yongin  (76.8km 어긋남)
□ 5. 구름저항            0.733 (기록 0.31~0.43의 2배). 바퀴 손으로 돌려볼 것
□ 6. 라이다 마운트·IMU    기존 체크리스트
□ 7. 미션 s 실측·검증     mission_s.py --live → mission_plan_check.py
```

---

## 10. 근거 파일

```
/tmp/ramp_*.csv          오늘 경사 런 20여 개 (재부팅 전에 data/ 로 옮길 것)
/tmp/slope_2301.csv      ★ 경사 측정 성공 런 (18.0%)
/tmp/ramp_평지기준_2259.csv  ★ 평지 기준 (15m 완주, k 산출 근거)
/tmp/ramp_반복1_2305.csv     ★ PWM160 재현 (7.9m, 평형 1.20 m/s)
/tmp/ramp_흔들기_2254.csv    ★ 무부하 정상 (30초 연속 3.2~3.5 m/s)
```

⚠ **`/tmp` 는 재부팅하면 사라진다.** 중요한 것은 `data/2026-09-17/` 로
   옮기고 `tools/drive_fixtures.py` 가 찾게 할 것.

---

## 내리막 서행 — 성공한 런 (2026-09-17 23:49)

`data/2026-09-17-ramp/ramp_4키로_2349.csv` · 272샘플 · **전 항목 통과**

경사 19.3% 를 **8.06 m 완주**했다. 중단 없음, 되밀림 0.00 m,
엔코더 최장 정지 0.045 s, 링크 끊김 없음. 내리막에서 처음으로
끝까지 간 런이다.

```
목표      1.11 m/s (4.0 km/h)
정상상태  1.58 m/s (5.7 km/h)   ← 2m 이후 155표본 평균
PWM       중앙 -24 · 범위 -60~60 · 58% 가 역PWM(제동)
```

### 경사를 이 런에서 역산했다

정상상태에서 가속도가 0 이므로 `g·sinθ/k = FF(v) - PWM_실제`.
FF(1.58) = 38.8×1.58+17.2 = 78.5, 실제 평균 -15 →
`g·sinθ = (78.5+15)×0.0202 = 1.89 m/s²` → **sinθ = 0.193 = 19.3%**.

`slope_meas.py` 의 18~20% 와 일치한다. 서로 다른 두 방법이 같은 답을
냈으므로 k=0.0202 물성치도 같이 검증된 셈이다.

### droop 예측이 맞았다 (4% 오차)

P 제어의 정상편차는 `excess = (FF - 필요PWM)/gain + deadband` 다.
19.3% 에서 1.11 m/s 유지에 필요한 PWM 은 60.3-93.5 = **-33**.

```
예측  0.10 + (60.3-(-33))/300 = 0.411  →  1.52 m/s
실측                                      1.58 m/s
```

**속도가 목표보다 높은 것은 고장이 아니다.** 이득을 올리면 줄지만
(gain 600 → 1.37 예상) 진동과 맞바꾼다. 제대로 잡으려면 적분이
필요하고 그건 펌웨어 PID(`NO_ENCODER 0`)의 몫이다.

### 법정 경사에서는 훨씬 순하다

이 시험 경사(19.3%)는 법정 내리막(6.5~9%)의 **2~3배**다.

| 경사 | 4km/h 유지 PWM | droop 후 예상속도 |
|---|---|---|
| 법정 6.5% | **+29** (구동) | 1.31 m/s (4.7km/h) |
| 법정 9% | **+17** (구동) | 1.35 m/s (4.9km/h) |
| 시험 19.3% | **-33** (제동) | 1.52 m/s (5.5km/h) |

법정 경사는 **제동이 아니라 스로틀만 줄이면 된다** — 플러깅 전류가
아예 안 흐른다. 과전류 걱정은 이 시험 경사에만 해당한다.

### 남은 거칠기

PWM 표본간 변동 평균 5.6 · **최대 66**. 상한 -60 에 붙었다 떨어지길
반복한다(58% 가 역PWM, 최대 -60 도달). 포화 채터다.
법정 경사에서는 필요 PWM 이 +17~+29 라 포화 자체가 안 일어난다.

### 같이 본 것

- 펌웨어 VEL 은 이 런에서도 평균 2.21 · 최대 2.88 을 찍었다.
  위치차분은 같은 구간 평균 1.58 · 최대 1.87. **1.4배 부풀린다.**
  예전 `--abort-speed` 오중단의 정체가 이것이다.
- `VMIN 4214~4295mV` 경고가 계속 떴다. 구동이 아니라 **조향**이다
  (`steering-collapses-rail`). 9/19 최우선 과제 그대로.
