hanmin0211/racing_ws/HANDOFF_2026-09-16.md

# 인계 — 2026-09-16 (학교 트랙 야간 세션)

브랜치 `yongin-2026-09-05` · 대회 **9/19 점검 · 9/20 본경기 (용인)**

---

# ★ 2차 세션 (03:37 런 이후) — 여기부터 읽을 것

## A. 한 줄 요약

> **마운트를 고치니 완주했다(drive_0337). 남은 진짜 문제는 회피 로직이 아니라
> 플래너가 좌우를 초당 10번 뒤집는 것이다. 슬루레이트 제한을 만들어 뒀고
> 기본값은 꺼짐이다 — 다음 런에서 켜서 재고 판단할 것.**

## B. drive_0337 판정 (2026-09-16 03:37, 학교트랙)

```bash
python3 tools/drive_review.py /tmp/drive_0337.csv
```

**완주했다.** s=73.0 도달, 회피·돌발정지 둘 다 정상 수행.

| | drive_0312 (실패) | **drive_0337** |
|---|---|---|
| arm 구간 BLOCKED | 79% | **2%** |
| arm 구간 CLEAR | 0% | 26% |
| 회피구간 최대이탈 | 3.22m | **0.72m** |
| arm 범위 | — | s40.4~50.3 (설정대로) |
| 랩타임 | — | **80.1s** / 73m (예산 480s) |
| 돌발정지 | — | s58.5 에서 5.6초 정지 후 재출발 ✅ |

**라이다 마운트는 정상이다.** 트랙창 안 점이 **지도 고정**이었다 —
(−20.0,−21.5)·(−22.5,−24.0) 은 의자, (−10.5,−16.5) 는 돌발 더미(차가 실제로
−10.4,−16.7 에서 섰다). 차체고정 최다 247회 < 지도고정 최다 304회.
지면 유령이 없다.

## C. ★ 정정 — 1차 세션의 진단이 틀렸다

1차 세션(§4-2)은 회피 떨림을 **`AVOID → AUTO` 전환**으로 봤고, 처방을
**먹스 유지시간**으로 잡았다. **둘 다 틀렸다.**

0.05초 단위 원본을 보면(0.2초로 솎으면 안 보인다):

```
77.50  AVOID|RIGHT   -6.0
77.55  AVOID|LEFT    +7.0    ← 뒤집힘
77.65  AVOID|RIGHT   -6.4    ← 뒤집힘
77.75  AVOID|LEFT   +16.6    ← 뒤집힘
77.95  BLOCKED        nan
78.05  AVOID|LEFT   +16.8
78.15  BLOCKED        nan
78.25  AVOID|RIGHT  -15.8    ← 뒤집힘
```

- 문제는 `AVOID↔AUTO` 가 아니라 **`AVOID` 안에서 좌↔우가 뒤집히는 것**이다.
- BLOCKED 빈틈 동안 먹스가 낸 경로조향(−10.9°, 우)은 오히려 최종 회피
  방향(−15.8°, 우)과 **같은 쪽**이었다. 유지시간을 켰다면 좌(+16.8°)를 물고
  있어 **더 나빴다.**
- 차가 무사했던 건 **조향 액추에이터가 못 따라가서**다 — 그 0.7초 동안 실제
  조향각은 −2.9~+2.7 에 머물렀다. 설계 덕이 아니라 운이다.

이건 `tools/test_avoid_hold.py` 가 시험으로 못 박아 뒀다 — 유지시간을
'이 빈틈의 해법' 으로 다시 오해하지 않도록.

## D. 진짜 원인과 처방

**원인:** `follow_gap_planner._find_largest_gap` 이 **무상태**다. 매 프레임
`target_angle` 이 어느 갭에 들어오는지 처음부터 다시 판정하고, 그 판정이
뒤집히면 조준각이 통째로 건너뛴다. 시간적 연속성이 0이다.

**구조적 비대칭:** 경로조향은 `local_pure_pursuit` 가 `max_steer_rate_deg`
(90°/s)로 이미 제한하는데, **회피조향은 그 경로를 통째로 우회한다**
(`cluster_plot_node → /lidar/avoid_steer → 먹스`). 회피각엔 제한이 없었다.

실측: 회피 명령이 최대 **604°/s** 를 요구했다. 실제 조향은 ~25°/s 다.

**처방(구현 완료, 기본 꺼짐):** `avoid_steer_rate_deg` — 회피 조향에도 같은
제한을 건다. 플래너의 **판단은 바꾸지 않는다.** 실측 리플레이:

| rate | 실측 최대 | 부호전환 | −18° 기동 도달 |
|---|---|---|---|
| 없음 | 460°/s | 6회 | t78.25 |
| **90** | 90°/s | **4회** | t78.50 (**250ms 지연**) |
| 60 | 60°/s | 4회 | — |

250ms 지연은 조향 지연(350ms)보다 작다 — 액추에이터가 어차피 못 하던 것이다.

> ⚠ 이건 **증상 차단**이지 원인 수정이 아니다. 근본 수정(갭 선택 히스테리시스)은
> 대회 전에 손대기엔 위험이 커서 남겨 뒀다. §H 참고.

## E. 새로 만든 것 (전부 기본값 = 꺼짐, 실차 검증 0회)

검증된 동작(drive_0337 완주)을 기본값으로 바꾸지 않는다는 원칙을 지켰다.
**하나씩 켜서 재고 판단할 것.**

| 파라미터 | 기본 | 권장 시험값 | 무엇 |
|---|---|---|---|
| `avoid_steer_rate_deg` | 0 | **90.0** | 회피 조향 슬루레이트 제한 (§D) |
| `avoid_hold_s` | 0 | 0.25 | 먹스 회피 유지시간 — **근거 약함**(§C) |
| `avoid_max_lateral_m` | 0 | 0.85 | 이탈 상한 |
| `avoid_max_heading_deg` | 0 | 22.0 | 헤딩오차 상한 |

이탈 상한 0.85/22 의 근거: 복귀불능 경계가 0.90m/25°(drive_0312 실측)이고,
**성공한** 회피의 최댓값이 0.72m/17.6°(drive_0337)다. 그 사이에 둬야 성공
사례는 통과하고 복귀불능만 차단한다. 0.7 로 걸면 성공한 회피 한가운데서 끊긴다.

> ⚠ `avoid_max_*` 는 **`avoid_hold_s` 와 같이** 쓸 것. 유지시간만 늘리면
> 회피각을 더 오래 물고 있어 이탈이 커진다.

**추가로 고친 것 (기본값으로 켜짐):**
- `local_pure_pursuit` — odom twist 스파이크 방어(`max_plausible_speed` 3.0).
  실측 1.08 → **61.90** → 0.99 m/s (2샘플, 랩당 3회). 위치는 멀쩡하고 twist
  필드만 튄다(EKF 가 odom 프레임을 늦게 받아 dt≈0 으로 나눈 것). lookahead 가
  `k_ld·v+min_ld` 라 그 순간 max 로 튀어 조향이 0.1초 둔해졌다. 이제 버리고
  직전 값을 유지한다.

## F. 빌드 — **불필요하다**

`velocity_controller` · `pure_pursuit_pkg` · `lidar_clustering` 전부
**디렉터리 심링크** 설치다 (`build/<pkg>/<pkg>` → `src/<pkg>/<pkg>`).
소스를 고치면 바로 반영된다.

> ⚠ 함정: 파일 하나에 `[ -L ]` 을 걸면 **거짓**으로 나온다. 심링크인 것은
> 파일이 아니라 **상위 디렉터리**다. `ls -ld build/<pkg>/<pkg>` 로 볼 것.

## G. 다음 런에서 할 것

```
□ 1. 라이다 마운트 측정 (매 주행 전 필수)
     python3 tools/lidar_mount_check.py          → 6m 이상

□ 2. 기준선 런 — 아무것도 안 켜고 한 번 더 (0337 재현 확인)
     bash tools/drive_school.sh --missions --min-pwm 55
     python3 tools/drive_record.py               (별 터미널)
     python3 tools/drive_review.py /tmp/drive_HHMM.csv

□ 3. 슬루레이트만 켜고 한 번  ← 가장 중요
     bash tools/drive_school.sh --missions --min-pwm 55 \
          --extra avoid_steer_rate_deg:=90.0
     판정: '회피 떨림'·'조향 변화율' 경고가 사라지는가?
           최대이탈이 0.72m 보다 **커지지 않는가**? (커지면 되돌릴 것)

□ 4. 3번이 좋으면 이탈 상한 + 유지시간을 **같이** 켜고 한 번
     --extra avoid_steer_rate_deg:=90.0 --extra avoid_hold_s:=0.25 \
     --extra avoid_max_lateral_m:=0.85 --extra avoid_max_heading_deg:=22.0
     판정: '회피중단·이탈상한' 로그가 성공한 회피 중에 뜨지 않는가?
           떴다면 상한이 너무 빡빡하다 — 0.85 를 올릴 것.

□ 5. 전압 — 최저 2425mV 였다. 배터리 교체 / USB·로직 전원 분리
□ 6. 능동 제동 실차 검증 (--extra ff_brake_pwm:=50)  ※ 아직 0회
```

## H. 남은 것 (대회 전에 손대지 말 것을 포함)

| 항목 | 상태 |
|---|---|
| **갭 선택 히스테리시스** | 미구현. 근본 원인(§D)이지만 잘못 붙이면 **틀린 쪽에 눌러앉는다.** 슬루레이트로 증상을 막고 대회 후로 미룰 것 |
| **전압** | VMIN 2425mV. 코드로 못 고친다. 전원 분리 권장 |
| **능동 제동** | 단위시험만. 실차 0회 |
| **BLOCKED 무조향** | 통로가 없으면 조향을 안 낸다. 부분 회피 없음 |
| **돌발 토픽 공유** | `sudden_stop` 이 `/obstacle_distance` 를 라이다와 공유. `lidar_escaping` 가드가 있고 0337 에서 정상 동작했다 — 우선순위 낮춤 |
| **odom twist 스파이크** | 방어는 넣었다. EKF 쪽 원인은 안 고쳤다(위치는 멀쩡하므로) |

## I. 새 도구

| 파일 | 용도 |
|---|---|
| `tools/drive_review.py` | **런 하나를 판정한다.** 매 런 후 필수. `--detail` 로 전 프레임 |
| `tools/test_avoid_rate.py` | 슬루레이트 제한 — 실측 런 리플레이 포함 |
| `tools/test_avoid_hold.py` | 유지시간·이탈상한 — §C 의 정정을 못 박는다 |

```bash
python3 tools/test_avoid_rate.py        # ✅
python3 tools/test_avoid_hold.py        # ✅
python3 tools/test_aim_clearance.py     # ✅
python3 tools/test_lidar_mount_check.py # ✅
python3 tools/test_avoid_geometry.py    # ✅
python3 tools/test_brake_logic.py       # ✅
```

> ⚠ **0.2초로 솎아 보지 말 것.** 이번 오진의 원인이 그거였다.
> `drive_review.py --detail` 은 0.05초 전 프레임을 찍는다.

### ✅ 시험 하네스를 고쳤다 — 세 겹이 쌓여 있었다

`test_sudden_stop.py` · `test_mission_sequencer.py` 는 진짜 노드를 띄워 spin 하는
시험이다. 둘 다 제대로 안 돌고 있었고, 원인이 **세 겹**이었다:

| 층 | 증상 | 수정 |
|---|---|---|
| 1 | `finally` 안에서 `rclpy.shutdown()` 이 먼저 터져 **그 뒤의 `kill_group` 이 통째로 건너뛰어짐** | 자식을 **먼저** 죽이고 rclpy 정리는 예외를 삼킨다 |
| 2 | 살아남은 노드가 다음 실행을 오염 → 같은 토픽에 두 벌이 다른 값 → `/lidar/arm` 이 10Hz 로 ARM↔DISARM | 1층 수정으로 해소 |
| 3 | 전역 컨텍스트에 `rclpy.init/shutdown` 을 6번 반복 → `RCLError: context is not valid` | 케이스마다 **독립 `Context` + 독립 `SingleThreadedExecutor`** |

결과: `test_mission_sequencer.py` 가 **13개 검증 전부 통과**하고 `exit=0` 으로
깨끗이 끝난다(남은 프로세스 0개). `test_sudden_stop.py` 도 5개 케이스 전부 통과.

> ⚠ **여기서 두 번 오판했다. 같은 함정을 다시 밟지 말 것.**
>
> ① 좀비가 뜬 상태로 `git stash` 비교를 돌렸다. **양쪽 다** 같은 이유로
>    실패했고 그걸 "원래부터 깨진 시험" 으로 읽었다.
>    → 비교 실험 **전에** 반드시 정리할 것.
>
> ② `/lidar/arm` 깜빡임을 보고 "시퀀서 로직이 깨졌다" 고 판단했다.
>    실제로는 시퀀서가 **두 벌** 떠 있었던 것이고 로직은 멀쩡했다.
>    (실차 drive_0337 도 `ARM s40.4 / DISARM s50.3` 단일 구간으로 깨끗했다)
>    → 깨진 케이스는 **단독으로** 돌려 볼 것. ⑥번은 단독이면 42.8초를
>      끝까지 돌고 전부 통과했다 — 그래서 케이스 간 오염임을 알 수 있었다.

**시험 전에 항상:**

```bash
pgrep -f 'install/[a-z_]+/lib/' | xargs -r kill -9
ros2 node list          # 비어야 한다 (DDS 잔상은 ~10초 뒤 사라진다)
```

`drive_school.sh` 는 이걸 자동 검사해 주행을 보호하지만 **시험은 보호하지 않는다.**
그리고 `test_mission_sequencer.py` 는 **6분 넘게 걸린다** — 타임아웃을 600초 이상
줄 것. 파일로 리다이렉트할 때는 `PYTHONUNBUFFERED=1` 을 붙여야 중간에 죽어도
출력이 남는다.

---

# 1차 세션 (03:40 작성) — 아래는 기록용

> ⚠ §4-2 의 '유지시간' 분석은 위 §C 에서 정정됐다. 그 숫자들은 **지면 유령
> 위에서** 잰 것이라 그대로 쓰면 안 된다. §1 의 마운트 고장도 해소됐다(§B).

## 0. 한 줄 요약

> **회피가 안 되는 원인은 코드가 아니라 라이다 마운트다. 심이 또 풀려서
> 지면을 3.35m 에서 때리고 있고, 그게 장애물로 잡혀 회피가 BLOCKED 로
> 죽는다. 이것부터 고치고 나머지를 판단할 것.**

오늘 세션 내내 회피 로직·구간·제동을 의심했는데, 마지막에 두 런의 스캔을
겹쳐 보니 **같은 장소에서 프레임당 점이 91개 → 322개(3.5배)** 였다.
점이 지도상 고정이 아니라 **차체 고정**이라 지면이다.

---

## 1. ★ 최우선 — 라이다 마운트

### 근거 (실측)

차체 기준 고정 핫스팟 (주행 중, 0.5m 격자):

```
drive_0020 (회피 성공한 런)
  전방 +5.0  횡 -2.5   거리 5.59m   1373회   트랙창 밖
  전방 +4.5  횡 -3.5   거리 5.70m   1339회   트랙창 밖
  → 지면을 때리긴 해도 전부 창 밖. 장애물로 안 잡힘.

drive_0312 (2026-09-16 03:12, 회피 실패)
  전방 +3.0  횡 -1.5   거리 3.35m   7016회   창 밖
  전방 +3.5  횡 -1.0   거리 3.64m   6698회   ★트랙창 안 = 장애물
  전방 +4.0  횡 -0.5   거리 4.03m   4777회   ★트랙창 안 = 장애물
```

지도격자 vs 차체격자 집중도 (상위 20칸):

| | 지도 고정(벽이면 높다) | 차체 고정(지면이면 높다) |
|---|---|---|
| drive_0020 | 14.8% | 28.1% |
| drive_0312 | 5.9% | **44.1%** |

### 이력

```
2026-09-13  고장      지면 타격 2.86m   BLOCKED 43 : AVOID 1
2026-09-13  심 보강   지면 타격 6.30m   AVOID 50 : BLOCKED 0   ← 검증값
2026-09-16  재발      지면 타격 3.35m   BLOCKED 79% · CLEAR 0%
```

하향각 환산(마운트 높이 0.25m 가정): **2.6° → 4.3°**. 1.7° 기울었다.

### 결과 — 이게 전부를 설명한다

| | drive_0020 | drive_0312 |
|---|---|---|
| CLEAR 프레임 | 39% | **0%** |
| BLOCKED | 12% | **79%** |
| 프레임당 점 | 91개 | **322개** |
| 최소 obstacle_m | 0.60m | 0.30m (min_range 바닥) |
| 회피구간 최대이탈 | 0.66m | **3.22m** |

트랙창이 **한 프레임도 안 비니** planner 가 CLEAR 를 못 받고, 경로로
복귀를 못 해 이탈이 누적된다.

### 점검 방법 (새로 만든 도구)

```bash
# ① 차를 평평한 곳에, 전방 8m 안을 완전히 비운다 (의자·사람·벽·차 전부)
# ② 라이다가 돌아야 한다 (bringup 띄우고 캘리브 전 Ctrl-C 해도 됨)
cd /home/han/racing_ws && source install/setup.bash && python3 tools/lidar_mount_check.py
```

```
✅ 6.0m 이상    정상 — 그대로 주행
⚠ 4.0~6.0m     경계 — 심을 조여라
❌ 4.0m 미만    고장 — 회피가 BLOCKED 로 죽는다
```

방위 5°마다 거리를 찍으므로 **어느 쪽이 내려앉았는지** 보인다.
현재는 우측(−30°~−120°)이 낮다.

**이 고장은 두 번째다. 매 주행 전에 잴 것.**

---

## 2. 오늘 바꾼 코드 (전부 검증 완료, 미커밋)

### 2-1. `follow_gap_planner.py` — `aim_clearance` 추가

**문제:** `front_distance = min(트랙창 ±1.2m 안 **모든** 장애물의 range)`.
옆으로 1.0m 비켜난 의자도 "앞이 1.0m 막혔다"로 읽혔다.
`longitudinal_controller` 가 그 숫자로 제동(`obstacle_stop_dist 0.8m`,
그 위로도 `v < ff_deadband 0.05` 면 PWM 0)을 걸어 **의자 사이에서 섰다.**
안 서는 배치 창이 ±1.00~1.20m, **폭 0.20m** 뿐이었다.

**고침:** `FollowGapDecision` 에 `aim_clearance` 필드(맨 뒤, 기본값 `-1.0`)와
`_aim_clearance()` 메서드 추가. 조준 방향을 축으로 놓고 차폭+여유
(`safety_radius` 0.6375m) 안으로 들어오는 점만 "앞"으로 센다.

```python
rel = angles[obstacle_indices] - aim_angle
lon = rng * np.cos(rel)          # 조준축 방향 (앞이 +)
lat = rng * np.sin(rel)          # 조준축에서 옆으로 벗어난 양
inline = (lon > 0.0) & (np.abs(lat) <= self.safety_radius)
return float(np.min(lon[inline]))
```

`AVOID` 에서만 계산한다. `BLOCKED/CLEAR/NO_SCAN` 은 `-1.0` → 소비자가
`front_distance` 로 폴백. **기본값을 맨 뒤에 둬서 기존 위치인자 10개
생성이 전부 그대로 유효하다.**

### 2-2. `cluster_plot_node.py` — 제동 기준 + 고착 판정 연결

```python
elif mode == 'AVOID':
    obs = (float(d.aim_clearance) if getattr(d, 'aim_clearance', -1.0) >= 0.0
           else float(d.front_distance))
```
AVOID 고착 판정(`stuck_distance` 1.2m)도 같은 `obs` 를 쓰게 바꿨다.
안 그러면 제동이 안 걸렸는데 "못 나간다"고 8초 ESCAPE 를 띄운다.

**실차 확인됨** (drive_0312, t87.0~89.8):
```
s45.5  obs 8.00  회피각 14.8°  명령각 14.8°  AVOID
s46.5  obs 8.00  회피각 18.2°  명령각 18.0°  AVOID
```
예전이면 `obs` 가 1.0 근처로 떨어져 기어갔다. 그게 없어졌다.

### 2-3. `drive_record.py` — 단위 버그 수정

```python
self.cmd_steer = math.degrees(m.angular.z)   # ❌ 57.3배로 부풀었다
self.cmd_steer = float(m.angular.z)          # ✅
```
`vehicle_cmd_mux_node.py:18` — `angular.z = 조향각 [도] ※ rad/s 아님!`
**그 전에 기록된 CSV 의 `cmd_steer_deg` 는 전부 57.2958 로 나눠야 한다.**

### 2-4. `mission_plan_school.yaml` — 회피 구간 `s38 → s40`

현장에서 차를 세우고 `mission_s.py --live` 로 실측: **s = 40.3m**
(`-26.29, -25.43`, 경로에서 0.01m).

넓히지 않고 **좁혔다**:
- s38 곡률 R=13.1m — 아직 커브 탈출 중. 회피가 arm 되면 먹스가
  경로조향을 통째로 버리므로 **커브에서 arm 하는 것 자체가 이탈 방향**
- s40.3 은 R=23.1m — 사실상 직선

```yaml
lidar_avoid:  s_enter 40.0  s_exit 50.0
sudden_stop:  s_enter 51.0  s_exit 70.0   (간격 1.0m)
```

**실차 확인됨:** `ARM s40.5` / `DISARM s50.5` — 시퀀서 정상 동작.

---

## 3. 새 도구 (전부 테스트 포함)

| 파일 | 용도 |
|---|---|
| `tools/lidar_mount_check.py` | 지면 타격 거리 측정. **매 주행 전 필수** |
| `tools/test_lidar_mount_check.py` | 합성 6종 + 실측 2런으로 검증 |
| `tools/test_aim_clearance.py` | 문 통과 / 안전반사 유지 / 폴백 불변식 |

```bash
python3 tools/test_aim_clearance.py        # ✅ 통과
python3 tools/test_lidar_mount_check.py    # ✅ 통과
python3 tools/test_avoid_geometry.py       # ✅ 통과 (기존, 안 깨짐)
```

---

## 4. 확정된 숫자

### 4-1. 의자 배치 기준 (기하 실측)

```
안전반경 = 차폭/2 (0.3875) + 안전여유 (0.25) = 0.6375m
의자 반폭 0.20m → 의자 중심 최소 이격 0.8375m
```

| 배치 | 결과 |
|---|---|
| 중심간격 1.8m | ❌ BLOCKED (못 지나감) |
| **중심간격 2.0m (좌우 ±1.0m)** | ✅ 통과 — **이걸 쓸 것** |
| 경로에서 1.6m 초과 | 아예 안 보임 (트랙창 ±1.2m 밖) |

**놓는 위치: s42 이후.** s41 앞은 arm(s40) 후 반응 시간이 모자란다.

> ⚠ 2026-09-16 런에서 의자 하나가 **경로에서 −0.19m (사실상 정중앙)** 에
> 있었다. 통로가 없으니 BLOCKED 는 정답이다. **줄자로 재서 놓을 것.**

### 4-2. 조향 — 신호가 밀린다

`vehicle_cmd_mux_node.py:150` 에 **유지시간이 없다.** planner 가 한 프레임만
AVOID 가 아니면(0.093s) 즉시 AUTO 로 돌아간다. 조향은 **지연 0.35s ·
명령각의 82% 도달**이라 따라가지 못한다.

| 체류 | 실제 도달률 | 18° 명령 시 |
|---|---|---|
| 0.10s | 20% | 3.6° |
| 0.40s | 56% | 10.1° |
| 1.55s+ | 82% | 14.8° |

drive_0312 회피구간 실측: **전환 13회 중 8회(62%)가 0.35s 미만.**

시뮬(기록된 런에 hold 적용):

| hold | 0.35s 미만 | 평균 도달률 | 회피조향 적분 |
|---|---|---|---|
| **0.00s (지금)** | 64% | **43%** | 35.2 °·s |
| **0.25s** | **0%** | **76%** | 49.0 (1.4배) |
| 0.70s | 0% | 80% | 61.3 (1.7배) |

→ **0.25s 에 무릎.** 그 위는 도달률이 거의 안 늘고 이탈만 커진다.

> ⚠ **이 숫자들은 지면 유령 위에서 쟀다.** 마운트 고치고 다시 잴 것.

### 4-3. 이탈 — 돌아올 수 있는 한계

```
  t     이탈    헤딩오차   18°로 회복 가능?
 88.8  +0.67    +19.2°    가능
 89.2  +0.90    +25.3°    ❌ 25°/s 필요 vs 25°/s 최대   ← 경계
 90.4  +1.87    +46.8°    ❌ 47°/s 필요 vs 24°/s 최대
```

**이탈 0.9m / 헤딩오차 25° 를 넘으면 조향 최대치로도 못 돌아온다.**
실제로 t90.0 부터 `−18°` 를 계속 줬는데도 이탈이 1.50 → 3.76m 로 자랐다.
DISARM 후에도 자랐다.

상한을 **이탈 0.7m 또는 헤딩오차 18°** 로 걸면 최대이탈 3.76m → **~0.85m**.

**대가:** 0.6m 이상 비껴야 하는 장애물은 못 피한다(박는다).
규정상 **이탈/정지 = 탈락, 접촉 = 감점**이므로 이 교환이 맞다.

---

## 5. 미해결

| 항목 | 상태 |
|---|---|
| **라이다 마운트** | ❌ 고장. 1순위 |
| **전압** | VMIN 2320~2604mV. drive_0312 에서 **4초 구동 스톨** (`STALL: drive=0`). `obs 2.61m` → 명령 0.45m/s · PWM 55 인데 안 움직였다. **코드로 못 고친다.** USB/로직 전원을 구동 전원에서 분리 권장 |
| **먹스 AVOID 유지시간** | 미구현. 마운트 고친 뒤 재측정 후 판단 |
| **이탈 상한** | 미구현. 유지시간과 **반드시 같이** 붙일 것 (유지시간만 늘리면 이탈이 커진다) |
| **능동 제동** `ff_brake_pwm:=50` | 구현·단위테스트 완료, **실차 검증 0회** |
| **BLOCKED 시 무조향(NaN)** | 통로가 없으면 조향을 아예 안 낸다. 부분 회피 없음 |
| **돌발 미션 토픽 분리** | 미구현. `sudden_stop_node` 가 `/obstacle_distance` 를 쓰는데 이 토픽은 회피 로직이 `CLEAR`/`ESCAPE`/`MUTE` 에서 덮어쓴다. `MUTE` 는 `sudden_stop_node` 가 스스로 켜는 것이라 **자기 입력을 자기가 지우는 순환**이다. 잠복 버그 |

---

## 6. 실행 순서

```
□ 1. 라이다 마운트 — tools/lidar_mount_check.py 로 6m 이상 확인
□ 2. 의자 — 경로 좌우 ±1.0m (중심간격 2.0m), s42 이후. 줄자로 잴 것
□ 3. 배터리 교체 / 충전
□ 4. 정상 런 1회 + drive_record.py 로 기록
□ 5. 그 CSV 로 떨림·이탈 재측정 → 유지시간/이탈상한 필요 여부 판단
□ 6. 필요하면 둘을 같이 구현
□ 7. 능동 제동 실차 검증 (--extra ff_brake_pwm:=50)
```

---

## 7. 명령어

```bash
# 주행 (미션 포함) — --missions 를 빼면 회피가 코스 전 구간 상시 ON 이라
#                     커브에서 경로조향을 버리고 이탈한다. 반드시 붙일 것.
cd /home/han/racing_ws && bash tools/drive_school.sh --missions --min-pwm 55

# 기록 (별 터미널, 캘리브 끝나고)
cd /home/han/racing_ws && source install/setup.bash && python3 tools/drive_record.py

# 마운트 점검
cd /home/han/racing_ws && source install/setup.bash && python3 tools/lidar_mount_check.py

# 전압 감시
python3 -u /home/han/racing_ws/tools/vcc_watch.py

# 위치 → 코스 s 환산 (스택이 떠 있고 캘리브가 끝나야 한다)
cd /home/han/racing_ws && source install/setup.bash && \
  python3 tools/mission_s.py --waypoints config/chungju_school/wp_school_track_0.5.yaml \
  --live --name lidar_avoid

# 그리기
python3 tools/drive_plot.py /tmp/drive_HHMM.csv

# 테스트
python3 tools/test_aim_clearance.py
python3 tools/test_lidar_mount_check.py
python3 tools/test_avoid_geometry.py
```

---

## 8. 함정 (오늘 실제로 밟은 것)

1. **`--missions` 를 빼면 시퀀서가 안 뜬다.** `sequencer:=true` 가 이 플래그에만
   붙는다. 없으면 `require_arm_for_steer` 가 꺼져 **회피가 코스 전 구간 상시 ON**.
   03:12 이전 런 하나가 이것 때문에 커브(s20~34)에서 이탈해 벽에 박았다
   (s35.5, 경로 밖 2.81m).

2. **`ros2 topic list` 로 라이다 판단 금지.** 구독자만 있어도 뜬다.
   발행자 수로 봐야 한다.

3. **`lidar_clustering` 은 심링크 설치다.** `build/lidar_clustering/` 가
   `src/` 를 가리키므로 **소스 수정 후 `colcon build` 불필요**.
   단 `gps_heading_init`, `handsfree_ros2_imu` 는 복사본이라 빌드 필요.
   확인: `python3 tools/check_build.py`

4. **`obstacle_log_interval = 10`** — 런 로그의 `FollowGap:` 줄은
   1/10 로 솎아진 것이다. 로그에서 1.07Hz 로 보여도 실제는 10.7Hz.
   처리율을 로그 간격으로 판단하지 말 것.

5. **주행 중 기록으로 마운트를 판정하지 말 것.** `lidar_mount_check.py` 는
   전방 8m 가 비어 있어야 한다. 주행 중이면 "최근접"이 지면이 아니라
   실제 장애물이다 (테스트 작성 중 실제로 오판했다).

6. **좀비 ROS 프로세스.** 테스트가 띄운 노드가 남으면 다음 주행이
   "이미 돌고 있는 노드가 있다"로 막힌다.
   `pgrep -f 'install/[a-z_]+/lib/' | xargs -r kill -9`

---

## 9. 파일

```
config/chungju_school/mission_plan_school.yaml   회피 s40~50 · 돌발 s51~70
config/chungju_school/wp_school_track_0.5.yaml   학교 트랙 73m · 147점
src/lidar_clustering/.../follow_gap_planner.py   aim_clearance
src/lidar_clustering/.../cluster_plot_node.py    제동 기준 연결
src/velocity_controller/.../vehicle_cmd_mux_node.py:150   유지시간 없는 곳
src/velocity_controller/.../longitudinal_controller_node.py:175  제동 분기
src/mission_perception/.../sudden_stop_node.py   /obstacle_distance 공유

/tmp/drive_0020.csv + _scan.csv    ★회피 성공한 런 (기준값)
/tmp/drive_0312.csv + _scan.csv    ★최신 실패 런 (분석 원본)
/tmp/run_0312.log                  같은 런 로그
```

### 학교 트랙 s 지도

```
s  0~10   캘리브 직진 (미션 안 돎 — teleop 이 먹스 우선)
s 10~20   가속 구간 (비워 둠)
s 20~34   급커브 (s25 에서 R=4.7m)  ← 미션 절대 금지
s 34~42   커브 탈출 중 (R 7.1 → 36)
s 40~50   ★회피 (s40.3 = 사용자 지정 시작점, R=23m)
s 51~70   ★돌발정지 (더미는 s56, 경로 정중앙)
s 55~73   R 7~9m 커브 — 전원이 가장 약한 구간
```

---

## 10. 커밋 안 된 변경

```
 M config/chungju_school/mission_plan_school.yaml
 M src/lidar_clustering/lidar_clustering/cluster_plot_node.py
 M src/lidar_clustering/lidar_clustering/follow_gap_planner.py
 M tools/drive_record.py
?? tools/lidar_mount_check.py
?? tools/test_aim_clearance.py
?? tools/test_lidar_mount_check.py
```

전부 테스트 통과 상태다. 커밋 여부는 사용자가 정한다.
