hanmin0211/racing_ws/HANDOFF_2026-09-17.md

# 인계 — 2026-09-17

브랜치 `yongin-2026-09-05` · 대회 **9/19 점검 · 9/20 본경기 (용인운전면허시험장)**
이전 문서: `HANDOFF_2026-09-16.md` (라이다 마운트·회피 떨림 1차 분석)

> **이 문서 하나로 이어받을 수 있게 썼다.** 숫자는 전부 실측이고, 근거 런의
> CSV·로그·프레임을 `data/2026-09-17/` 에 **저장소 안으로** 복사해 뒀다
> (`/tmp` 는 재부팅하면 사라진다).

---

## 0. 지금 어디까지 왔나

| 미션 | 상태 |
|---|---|
| 완주(경로추종) | ✅ 학교트랙 완주 반복 확인 (80~92초 / 73m, 예산 480초) |
| 라이다 회피 | ✅ **오늘 해결.** BLOCKED 18%→0%, 첫 장애물 통과 |
| 돌발 급정지 | ✅ 동작. 능동 제동으로 감속 2배 |
| 신호등 | ⚠ 검출·판별은 **실차 확인**. 정지선 좌표(용인)가 없어 **미완성** |
| 경사로 | ❌ 엔코더 없어 홀드 불가 → **안 서고 올라간다**(감점 감수) |
| 주차 | 미착수(이번 세션에서 안 봄) |

**하드웨어 1순위: 전압.** 최저 2282~2528mV(정상 5000). 코드로 못 고친다.

---

## 1. 오늘 고친 것 (전부 실측 근거 있음)

### 1-1. ★ IMU 끊김 — USB 허브가 원인

```
run_0109  재연결 49 · 경로끊김 76
run_0118  재연결 13 · 경로끊김 14
run_0126  재연결  2 · 경로끊김  3
run_0152  재연결  0 · 경로끊김  0   ← USB 직결 후
```

**증상:** 1.5초 무데이터 → 노드 재연결(0.33초, 성공) → 2~13초 살다 또 끊김.
경로가 끊기면 `pure_pursuit` 가 차를 세운다(정지 → 탈락 위험).

**진단 (두 번 틀렸다):**
1. "주행 중에만 끊기니 **진동**" ❌ — 주행 중엔 라이다·GPS·아두이노가 동시에
   최대로 흘러 **버스 부하**가 최대가 되는 것이었다.
2. "어댑터와 IMU 사이 **4핀 배선**" ❌ — IMU 는 USB-UART 브리지 내장 단일 장치
   (`HandsFree IMU USB to UART Bridge Controller`). 그런 배선이 없다.

**진짜 원인** — `dmesg` 가 답을 줬다(**이걸 먼저 봤어야 했다**):
```
cp210x ttyUSB0: usb_serial_generic_read_bulk_callback - urb stopped: -32
```
`-32 = -EPIPE` = USB 엔드포인트 스톨. 장치 노드는 남아 재연결이 "성공"한다.
`drive_school.sh` 주석에 이미 적혀 있던 고장이다.

**결정적 증거 — 허브 단수:**
```
Arduino  3-1        허브 0단(루트 직결)  →  끊긴 적 없음
IMU      3-2.1.4.2  허브 3단            →  -EPIPE 스톨
라이다    3-2.1.1.4  허브 3단
GPS      3-2.1.4.3  허브 3단 (IMU 와 같은 허브)
```
같은 차·같은 진동인데 **루트 직결된 아두이노만 멀쩡했다.**

**조치:** IMU 를 노트북 포트에 직결 (`3-2.1.4.2` → `3-1`).
처리량 1.4 → **11.9 KB/s**, 끊김 12초 스톨 → **0회/34초**.

> ⚠ **GPS 는 아직 허브 3단 뒤에 있다.** 그리고 `ublox_dgnss_node` 가 libusb 에서
> **segfault 3회**(01:27:12, 01:29:38, 01:40:32). 같은 원인 의심. **미해결.**

> ⚠ USB 를 다시 꽂으면 `ttyUSB*`/`ttyACM*` 번호가 전부 밀린다. udev 심링크
> (`/dev/imu`, `/dev/arduino`, `/dev/ldlidar_front`)는 올바르게 따라가지만
> **번호를 직접 치면 안 된다**. 오늘 실측: `/dev/arduino→ttyACM1`,
> `/dev/imu→ttyUSB1`, `/dev/ldlidar_front→ttyUSB0`, **ttyACM0 은 GPS**.

> ⚠ IMU 의 USB 시리얼번호가 **`0001`**(라이다는 고유값). 라이다를 두 대 꽂으면
> 같은 `10c4:ea60` 이 셋이 된다. udev 가 시리얼로 구분하는지 대회 전 확인할 것.

### 1-2. ★ 회피가 첫 장애물에 박던 이유 — arm 이 늦었다

**원인:** 라이다는 진작 보고 회피각까지 정해 뒀는데 **구간 밖이라 조향이 막혀**
있었다. `drive_0126` 실측:
```
t80.95  s=38.6  AVOID(조향OFF)|RIGHT   ← 이미 회피 판정
t81.35  s=39.0  AVOID(조향OFF)|LEFT
t82.75  s=40.3  AVOID(조향OFF)|LEFT    ← 2.0초(1.87m) 내내 조향 OFF
t82.95  s=40.5  BLOCKED|STOP           ← arm 되는 순간 obs 2.04m
```
정면 장애물은 **2.8m 안에 들면 무조건 BLOCKED**(안전버블 `asin(0.6375/r)` 가
조준창 20.6° 를 덮는다). BLOCKED 는 조향을 아예 안 낸다(NaN).
**arm 되는 순간 이미 BLOCKED 안이라 빠져나올 길이 없었다.**

설정별 BLOCKED 시작 거리(실제 플래너로 측정):
```
safety_margin  lookahead  조준창   BLOCKED 시작
        0.25       1.5    20.6°      2.8m   ← 현재
        0.20       1.5    22.2°      2.4m
        0.15       1.5    23.8°      2.1m
        0.15       1.2    28.9°      1.7m
```

**조치:** `config/chungju_school/mission_plan_school.yaml` 의
`lidar_avoid.s_enter` **40.0 → 37.0**

커브 위험 실측(wp 곡률):
```
s35 R= 8.1m(5.51°)  s36 R= 9.4m(4.78°)  ← 여기부터 경계
s37 R=11.0m(4.08°)  s38 R=13.4m(3.35°)  s40 R=21.8m(2.06°)
```
s37 에서 AVOID 중 경로조향을 버려도 2m 동안 최악 이탈 0.18m(경고선 0.72m 의 1/4).
**s35 아래로는 내리지 말 것** — 급커브(s33 R=6.4m)에 걸린다.

**결과:**
| | 0126 (arm s40) | 0137 (arm s37) |
|---|---|---|
| BLOCKED | 18% | **0%** |
| obs 최솟값 | 0.31m (min_range 바닥) | **8.00m** |
| 회피각 최대 | 10.2° | 15.8° |
| arm vs 감지 | +1.9m 늦음 | **−1.3m 앞섬** |

`obs 최소 8.00m` 가 핵심 — **접근 전에 미리 비켜갔다.**

> **용인에서도 같은 계산을 해야 한다.** 회피 구간 시작이 장애물 가능 위치보다
> **최소 4~5m 앞**이어야 한다(감지 트리거 4.0m + BLOCKED 2.8m + 조향지연).
> `tools/arm_window_plot.py` 가 이걸 한 장으로 보여준다.

### 1-3. 회피 조향 슬루레이트 제한 (기본 꺼짐, 권장 90)

경로조향은 `local_pure_pursuit` 가 `max_steer_rate_deg` 90°/s 로 제한하는데
**회피조향만 그 경로를 우회**했다. 실측 최대 **604°/s**(실제 조향 한계 ~25°/s).

리플레이: 460→90°/s, 부호전환 6→0회, −18° 기동은 250ms 지연으로 완수
(조향 지연 350ms 보다 작아 실질 손해 없음). 실차 0137/0152 에서 켜고 달렸고
나빠진 지표 없음.

> ⚠ 근본 원인은 `_find_largest_gap` 이 **무상태**라 매 프레임 갭을 처음부터
> 다시 고르는 것. 이건 증상 차단이다. 근본 수정(갭 히스테리시스)은 잘못 붙이면
> **틀린 쪽에 눌러앉으므로** 대회 후로 미뤘다.

### 1-4. 능동 제동 — 실차 최초 동작

`ff_brake_pwm:=50`:
```
t78.65  v=1.12  cmd_v=0.00   ← 제동 시작
t79.35  v=0.45
t79.75  v=0.10               ← 1.1초 만에 정지
뒤로 밀림 최저 −0.01 m/s (사실상 0)
```
평균 감속 **0.93 m/s²** (관성 정지 0.31~0.43 의 2배 이상).
로그: `제동 — 역 PWM 50 을 700ms (직전 +0.70m/s, 상한 800ms)`

> ⚠ **제동 시간 계산이 어긋나 있다 (미수정, 고치면 더 빨라진다).**
> `t = min(ff_brake_ms, |_last_cmd_v| / ff_brake_decel)` 가 **명령** 속도를 쓰는데,
> PWM 하한 55 때문에 실제가 훨씬 빠르다(명령 0.70 / 실제 1.12).
> 700ms 만에 제동이 끝나고 마지막 400ms 는 관성이다.
> **측정 속도(`self._meas_v`, 이미 구독 중)로 바꾸면 1.1초 → 0.7초대.**
> `serial_bridge_node.py` 의 `_brake_pwm()`. `test_brake_logic.py` 로 검증 가능.

### 1-5. odom twist 스파이크 방어 (기본 켜짐)

`/odometry/filtered` 의 twist 가 EKF 프레임 지연으로 튄다:
실측 `1.08 → 61.90 → 0.99 m/s` (2샘플, 랩당 3~6회). **위치는 멀쩡**하다.
`local_pure_pursuit:114` 가 이걸 lookahead 에 쓰므로 조향이 0.1초 둔해졌다.
→ `max_plausible_speed` 3.0 초과는 버리고 직전 값 유지.

### 1-6. 라이다 마운트 점검 도구 재작성

거리 하나만 보던 것을 **기하**로 바꿨다. 지면은 `x = r·cosβ` 가 일정한 직선
(`x₀ = h/tanθ`), 롤이 있으면 기운다. 횡 폭으로 지면/물체를 가른다.

**이 도구로 오늘 세 번 틀렸고 전부 고쳤다** — 전부 판정 기준이 플래너와 달라서:

| 문제 | 수정 |
|---|---|
| 롤 부호가 거꾸로 → **심을 반대쪽에 넣을 뻔** | `k>0 = 우측이 낮다`. 현장 표를 시험에 박음 |
| 0.17m 를 장애물로 셈 | `PLANNER_MIN_RANGE 0.30` — 플래너와 동일 |
| 잔차 0.68 적합으로 "앞쪽 들어올려라" | 적합이 지저분하면 심 조언 안 함 |
| 쌍 1개로 "좌측이 낮다" | `MIN_SIDE_PAIRS 3` |
| 하향각 40° 짜리를 지면 취급 | `MAX_PLAUSIBLE_TILT_DEG 15` → 0.93m 미만은 지면 아님 |

`--confirm` 은 차를 2m 옮겨 **차체고정(지면) vs 지도고정(벽)** 을 가른다.
정면 벽은 한 장으로는 지면과 구분 불가 — 그게 `--confirm` 이 있는 이유다.

---

## 2. 신호등 — 네 군데 고쳤고 실차 확인

**정지/출발 로직은 이미 완성돼 있었다** (`traffic_light_bridge.py`):
```
RED    → 정지지점까지 거리 발행 → 종방향이 √(2ad) 로 감속해 정지
GREEN  → 999 (제약 없음) → 출발
YELLOW → 2m 안이면 통과, 아니면 정지
NONE   → on_none='stop' (10초 뒤 통과, 탈락 방지)
```
막힌 건 **검출 신뢰도**였고 네 가지가 겹쳐 있었다.

### 2-1. 박스 좌표 x/y 뒤바뀜 (디버그 그리기만)

Hailo 후처리는 `[x_min, y_min, x_max, y_max]` 를 준다
(`object_detection_post_process.py:169` 주석, `:104` 의 `denormalize_and_rm_pad`).
그리기 코드가 `y0,x0,y1,x1` 로 받았다.
실측: 좌측 흰 트럭(x110~200,y370~415)의 박스가 상단 하늘(x370~415,y110~200)에.

> `classify_lamp` 는 처음부터 `x1,y1,x2,y2` 로 **옳게** 읽고 있었다.
> 즉 검출·분류는 정상이고 **그림만** 틀렸다. 다만 그 그림으로 카메라를 맞추면
> 엉뚱한 곳을 향한다.

### 2-2. 어느 신호등을 볼지 규칙이 없었다

`점수 최대` 하나만 봤다. 점수는 '우리 차선 것인지' 와 무관하다.
실측(90초): `t+74.8 RED → 76.3 GREEN → 77.8 NONE → 78.8 YELLOW → 80.2 RED`
— **6초에 4번.** 안 켜진 세로형(0.66)을 골라 RED 를 냈고, 정작 우리 차선의
육교 위 가로형(0.41, 초록 점등)을 무시했다.

**수정:** 기하로 고른다.
```python
rank = 점수 + 박스폭/화면폭*3.0 − |중앙에서 벗어남| − 화면상높이*0.5
min_box_w 18px 미만 버림 · 화면 아래 60% 밖 버림
```
화면에 고른 것만 **노란 굵은 테두리 + `<<`**.

### 2-3. 색 불명인데 위치만으로 답했다

안 켜진 신호등의 어두운 화소(H=123, 청보라)를 읽고도 위치만 보고 RED.
**수정:** `by_col is None` → `NONE`.

### 2-4. ★★ 가로형 신호등을 못 읽었다 — 결정타

```
실도로 진단문:  불일치: 위치=YELLOW  색=GREEN(H=86)
```
`LAMP_POS = {RED 0.29, YELLOW 0.50, GREEN 0.71}` 는 **세로형** 기준.
가로형은 어느 램프가 켜지든 **세로 무게중심이 항상 한가운데(~0.5)** 라 무조건
YELLOW 로 읽히고, 색이 GREEN 이면 불일치로 거부된다.

**한국 차량 신호등은 대부분 가로형이다.** 즉 거의 모든 경우 거부되고 있었고,
가끔 잡힌 건 cy 가 우연히 0.71 근처로 튄 프레임이었다.
**일치 여부가 동전던지기** — 검출이 0.1~0.8초만 유지된 정체가 이것.

**수정:**
```python
horizontal = rw > rh * 1.3
가로형 → 가로 위치:  ≤0.30 RED · ≥0.68 GREEN · 그 사이 YELLOW
세로형 → 기존 그대로
LAMP_X_RED_MAX = 0.30 · LAMP_X_GREEN_MIN = 0.68
```

**합성 검증:** 가로 4구(적/황/좌/녹) ✓, 가로 3구 ✓, 세로 3구 ✓ (기존 유지).
좌회전 화살표는 `None` — 직진 신호가 아니므로 **의도된 거부**.

**★ 실차 확인 (17:04:10):**
```
GREEN  fps=30  boxes=9  TL=yes
score=0.48   GREEN (가로 0.91, H=85)     ← 5초 유지, 교차로 통과 후 NONE
```
확대 확인: 가로형 신호등 **오른쪽 램프가 초록**. 위치·색 모두 정확.
프레임: `data/2026-09-17/traffic_frames/CONFIRMED_GREEN_horizontal.jpg`

### 2-5. ★ 브리지가 안 쓰는 토픽을 구독하고 있었다

```
검출기 발행:  /traffic_light_state_coco
브리지 기본:  /traffic_light_state        ← 어긋남
런치:        state_topic 을 안 넘김
```
**오류가 안 난다.** 브리지가 조용히 '미검출' 로 판단하고 10초 뒤 통과시킨다.
신호등을 아무리 잘 읽어도 제어에 안 닿는 상태였다.

**수정:** `bringup.launch.py` 에 `traffic_light_topic` 인자 추가
(기본 `/traffic_light_state_coco`), 브리지에 `state_topic` 으로 전달.

### 2-6. 브라우저로 보는 법 (새 도구)

```bash
# 파이 터미널 ①  검출기
source ~/ros2_humble/install/setup.bash && source ~/ros2_ws/install/setup.bash && \
ros2 run traffic_light_detector coco_traffic_light_node --ros-args -p publish_image:=true
# 파이 터미널 ②  중계
source ~/ros2_humble/install/setup.bash && python3 ~/mjpeg_server.py
# 노트북 브라우저
http://192.168.99.8:8080/          # /snapshot.jpg · /status 도 있음
```
`src/mission_perception/pi_deploy/mjpeg_server.py` → 파이 `~/mjpeg_server.py`.
**순수 구독자**라 죽어도 검출·주행에 영향 없음.

> ⚠ 인증 없음. 사설 직결 링크용. 파이가 공용 와이파이에 같이 붙으면
> `--host 192.168.99.8` 로 직결에만 묶을 것.

---

## 3. 파이(신호등) 환경 — 다음 세션이 알아야 할 것

```
링크      bash tools/pi_link.sh   (노트북 192.168.99.1 / 파이 192.168.99.8)
SSH       ssh pi@192.168.99.8     (비밀번호 필요 — BatchMode 는 키가 있어야 됨)
카메라    /dev/video0 (C920, 1280x720)
가속기    /dev/hailo0
패키지    ~/ros2_ws  ·  ROS_DOMAIN_ID 미설정(=0), 기본 RMW
실행모듈  ~/ros2_ws/build/traffic_light_detector/traffic_light_detector/
          coco_detector_node.py   ← **심링크 설치라 scp 후 빌드 불필요**
배포      scp src/mission_perception/pi_deploy/coco_detector_node.py \
            pi@192.168.99.8:/home/pi/ros2_ws/src/traffic_light_detector/traffic_light_detector/
```

> ⚠ **파이 시계가 9월 7일에 멈춰 있다**(RTC 없음). 파일 타임스탬프가 전부
> 거짓이라 배포 확인을 **내용으로** 해야 한다(`grep -c` 로 수정 문자열 확인).
> 오늘 이것 때문에 배포가 안 된 줄 알고 헤맸다.
> 고치려면: `sudo timedatectl set-ntp true` 또는
> `ssh pi@192.168.99.8 "sudo date -s '$(date -u +%Y-%m-%dT%H:%M:%S)'"`

**검출기 주요 파라미터:**
```
score_threshold   0.3     confirm_frames  5 (시간필터)
min_box_w        18       max_center_y   0.60    center_weight 1.0
use_color_check  True     publish_image  False   image_every 3  image_quality 60
```

---

## 4. 새 파라미터 정리 (전부 기본 꺼짐 — 검증된 동작을 기본값으로 바꾸지 않았다)

| 파라미터 | 기본 | 권장 | 노드 | 무엇 |
|---|---|---|---|---|
| `avoid_steer_rate_deg` | 0 | **90.0** | cluster_plot | 회피 조향 슬루레이트 |
| `avoid_hold_s` | 0 | 0.25 | 먹스 | 회피 유지시간 — **근거 약함**(§7-1) |
| `avoid_max_lateral_m` | 0 | 0.85 | 먹스 | 이탈 상한 |
| `avoid_max_heading_deg` | 0 | 22.0 | 먹스 | 헤딩오차 상한 |
| `ff_brake_pwm` | 0 | **50** | serial_bridge | 능동 제동 (실차 확인) |
| `sudden_stop_dwell` | 5.0 | 4.0 | sudden_stop | 정지 유지 (규정 최소 3초) |
| `traffic_light_topic` | `/traffic_light_state_coco` | — | bringup | 브리지 입력 |
| `max_plausible_speed` | 3.0 | — | pure_pursuit | **기본 켜짐**. odom 스파이크 방어 |

⚠ 런치 인자는 전부 `ParameterValue(value_type=float)` 로 감쌌다.
`ros2 run -p avoid_max_heading_deg:=22` 처럼 **정수로 주면 노드가 즉사**한다
(오늘 실제로 재현했다: `InvalidParameterTypeException ... INTEGER, expecting DOUBLE`).

---

## 5. 명령어

### 주행 (오늘 검증된 조합)
```bash
pgrep -f 'install/[a-z_]+/lib/' | xargs -r kill -9      # 좀비 정리 (필수)

cd /home/han/racing_ws && bash tools/drive_school.sh --missions --min-pwm 55 \
     --extra avoid_steer_rate_deg:=90.0 \
     --extra ff_brake_pwm:=50 \
     --extra sudden_stop_dwell:=4.0

# 별 터미널, 캘리브 끝나고
cd /home/han/racing_ws && source install/setup.bash && python3 tools/drive_record.py
```

**시작 로그에서 확인할 줄:**
```
★ 회피 조향 슬루레이트 제한 90°/s
★ 능동 제동 켜짐: 역 PWM 50 을 최대 800ms
▶ lidar_avoid ARM (배경, s=37.x m)        ← 40 이 아니라 37
돌발 급정지 — … **4초** 유지 후 재출발
⤳ sudden_stop 구간을 지나쳤다 — 건너뜀    ← **이게 뜨면 출발 위치가 틀렸다**
```

### 판정
```bash
python3 tools/drive_review.py /tmp/drive_HHMM.csv          # 판정표
python3 tools/drive_review.py /tmp/drive_HHMM.csv --detail # 회피구간 전 프레임
python3 tools/arm_window_plot.py /tmp/drive_HHMM.csv --arm-was 40.0
```

### 점검
```bash
python3 tools/lidar_mount_check.py --confirm   # 매 주행 전 필수
python3 tools/imu_link_check.py --seconds 60
python3 -u tools/vcc_watch.py
sudo dmesg -T | grep -iE "usb|tty|cp210" | tail -40   # USB 문제는 여기부터
```

### 시험 (전부 통과 상태)
```bash
python3 tools/test_mount_geom.py          python3 tools/test_avoid_rate.py
python3 tools/test_lidar_mount_check.py   python3 tools/test_avoid_hold.py
python3 tools/test_aim_clearance.py       python3 tools/test_avoid_geometry.py
python3 tools/test_brake_logic.py         python3 tools/test_sudden_stop.py
python3 tools/test_crosswalk_stop.py      python3 tools/test_parking_geometry.py
PYTHONUNBUFFERED=1 timeout 600 python3 tools/test_mission_sequencer.py  # 6분+
cd src/mission_perception/pi_deploy && python3 test_lamp_classify.py
```

---

## 6. 미커밋 변경 (전부 시험 통과, 커밋 여부는 사용자가 정한다)

```
 M config/chungju_school/mission_plan_school.yaml     회피 arm s40→37
 M src/gps_localization/launch/bringup.launch.py      새 인자 4개 + traffic_light_topic
 M src/lidar_clustering/.../cluster_plot_node.py      슬루레이트 제한
 M src/lidar_clustering/.../follow_gap_planner.py     aim_clearance (9/16)
 M src/mission_perception/pi_deploy/coco_detector_node.py  신호등 4건
 M src/pure_pursuit_pkg/launch/control.launch.py      먹스 인자 전달
 M src/pure_pursuit_pkg/.../local_pure_pursuit_node.py  odom 스파이크 방어
 M src/velocity_controller/.../vehicle_cmd_mux_node.py  유지시간·이탈상한
 M tools/drive_record.py                             단위 버그(9/16)
 M tools/test_mission_sequencer.py                   하네스 3층 수정
?? HANDOFF_2026-09-16.md  HANDOFF_2026-09-17.md
?? data/2026-09-17/                                  실측 데이터 21MB
?? src/mission_perception/pi_deploy/mjpeg_server.py
?? tools/{arm_window_plot,drive_review,imu_link_check,lidar_mount_check}.py
?? tools/test_{aim_clearance,avoid_hold,avoid_rate,lidar_mount_check,mount_geom}.py
```

**빌드 불필요** — `velocity_controller`·`pure_pursuit_pkg`·`lidar_clustering` 은
**디렉터리 심링크** 설치(`build/<pkg>/<pkg>` → `src/<pkg>/<pkg>`).
⚠ 파일 하나에 `[ -L ]` 을 걸면 거짓이 나온다. `ls -ld build/<pkg>/<pkg>` 로 볼 것.

---

## 7. 미해결 (우선순위 순)

### 7-1. 대회 전 필수

| # | 항목 | 내용 |
|---|---|---|
| 1 | **전압** | 최저 2282~2528mV. 3000 미만 4~6%. 배터리 교체 / USB·로직 전원 분리. **코드로 못 고친다** |
| 2 | **용인 정지선 좌표** | `stop_point_recorder` 로 찍어야 한다. 없으면 신호등을 읽어도 **어디서 설지 모른다** |
| 3 | **용인 미션계획** | 회피·돌발 구간 s 값 전부 미확정. 다른 장소 계획은 **엉뚱한 지점에서 실행된다(=탈락)** |
| 4 | **GPS segfault** | `ublox_dgnss_node` libusb segfault 3회. 허브 3단 뒤. 원인 미확인 |
| 5 | **파이 시계** | 9/7 에 멈춤. 배포 확인이 내용 기반이어야 함 |

### 7-2. 하면 좋은 것

- **제동 시간 계산** — 명령속도 → 측정속도 (§1-4). 1.1초 → 0.7초대
- **RED 실차 확인** — 로직상 GREEN 과 같은 경로, 합성은 통과. 급하지 않음
- **`avoid_hold_s` 근거 재확인** — 9/16 에 "BLOCKED 빈틈 메우기" 로 만들었으나
  실측이 그 가설을 **반증**했다(빈틈 직전 각이 최종 방향과 반대였다).
  기본 꺼짐이고, 켜려면 실차에서 다시 재야 한다. `test_avoid_hold.py` 에 박아 뒀다
- **`drive_review.py` 조향 변화율 지표** — 라이다 10Hz / 기록 20Hz 라 **2배로
  계산된다**(실제 90°/s 가 182°/s 로 보임). 발행 주기 반영 필요
- **갭 선택 히스테리시스** — 플래너 무상태가 근본 원인. 잘못 붙이면 틀린 쪽에
  눌러앉는다. **대회 후**

### 7-3. 구조적 한계 (알고 가는 것)

- **내리막** — 속도 명령이 PWM 하한 55 에 막혀 안 먹는다(평지 실측: 명령 0.40 /
  실제 1.10). 제동 권한도 없다. **용인에 내리막이 있다** → 9/19 에 반드시 잴 것
- **경사로** — 엔코더가 죽어(`NO_ENCODER 1`) 홀드 불가. 서면 밀린다 →
  **안 서고 올라가는 게 맞다**(감점 감수)
- **BLOCKED 무조향** — 갭이 없으면 조향을 아예 안 낸다. 부분 회피 없음
- **`ff_min_pwm` 55 하한** — 커브·장애물 감속을 전부 덮어쓴다. 탈락 방지용이라
  뺄 수 없지만, 0.97 m/s 아래 명령은 전부 무의미해진다

---

## 8. 9/19 점검일 체크리스트

```
□ 라이다 마운트       python3 tools/lidar_mount_check.py --confirm  → 창 "비어 있음"
□ IMU 링크           python3 tools/imu_link_check.py --seconds 60   → 끊김 0
□ 전압               vcc_watch.py — 주행 중 최저가 3000 넘는지
□ 코스 waypoint      용인 경로 재기록 여부 확인
□ 미션계획 s 값       회피·돌발 구간을 실측 s 로 확정 (mission_s.py --live)
□ 회피 구간 여유      장애물 가능 위치보다 4~5m 앞에서 arm 되는지
□ 정지선 좌표         stop_point_recorder (신호등 미션 필수)
□ 내리막             drive_record 로 내리막 끝 속도 vs 그 지점 곡률
□ 구간 밖 오탐        drive_review 에서 '구간 밖 제동' 0 인지
□ 출발 위치          s≈0. s73 에서 출발하면 미션이 건너뛰어진다
□ RTK 커버리지        용인 VRS 되는지
```

---

## 9. 오늘 밟은 함정 (전부 실제로 틀렸던 것 — 다시 밟지 말 것)

1. **0.2초로 솎아 본 표로 진단** → 플래너 좌우 뒤집힘을 놓쳤다. `--detail` 로 볼 것
2. **좀비가 뜬 상태로 `git stash` 비교** → 양쪽 다 같은 이유로 실패. **비교 전 정리**
3. **깨진 시험 케이스를 통째로 의심** → ⑥번만 단독 실행하니 통과. 케이스 간 오염
4. **`dmesg` 를 나중에 봄** → IMU 원인을 두 번 잘못 짚었다. **USB 문제는 dmesg 가 먼저**
5. **주석 이미지로 색 검증** → 그려진 빨간 테두리를 램프 색으로 읽었다
6. **파일 하나에 `[ -L ]`** → 심링크인 것은 상위 **디렉터리**다
7. **파이 타임스탬프로 배포 확인** → 시계가 9/7 에 멈춰 있다. **내용으로 확인**
8. **"1m 앞은 물리적으로 못 피한다"** → 질문을 잘못 읽었다. 구간 시작이 1m 뒤라는
   뜻이었고, 라이다는 그 훨씬 전부터 보고 있었다. **arm 시점 문제였다**
9. **마운트 롤 부호** → 거꾸로 적어 심을 반대쪽에 넣으라고 할 뻔했다

---

## 10. 근거 데이터 (저장소에 보존)

```
data/2026-09-17/
  drive_0020.csv(+scan)  회피 성공 기준값 (9/16 이전)
  drive_0312.csv(+scan)  마운트 고장 런 (BLOCKED 79%)
  drive_0337.csv(+scan)  ★ 마운트 수리 후 완주 (80.1초, 기준값)
  drive_0117/0126.csv    arm s40 — 첫 장애물 충돌
  drive_0137.csv(+scan)  ★ arm s37 — BLOCKED 0%, obs 8.00m
  drive_0152.csv(+scan)  ★ IMU 직결 후 (재연결 0), 능동 제동 최초
  run_*.log              같은 런의 노드 로그
  traffic_frames/        신호등 실차 프레임 19장
    CONFIRMED_GREEN_horizontal.jpg   ★ 가로형 수정 확인 프레임
    TL_RED_046.4.jpg                 수정 전 오탐 사례 (안 켜진 세로형 → RED)
```

⚠ `/tmp` 의 원본은 재부팅하면 사라진다. 위 사본을 쓸 것.
