hanmin0211/racing_ws/HANDOFF_2026-09-17_night.md

# 인계 — 2026-09-17 밤 (하드웨어 없는 세션)

브랜치 `yongin-2026-09-05` · 대회 **9/19 점검 · 9/20 본경기 (용인운전면허시험장)**
이전 문서: `HANDOFF_2026-09-17.md` (IMU 직결·회피 arm s37·신호등 가로형)

> 이 세션엔 **차가 안 붙어 있었다**(`/dev/imu`·`/dev/arduino`·`/dev/ldlidar_front`
> 전부 없음). 그래서 실차 실험은 하나도 안 했고, **기록된 런으로 되짚는 것**만
> 했다. 대신 판정 도구 자체가 틀린 곳을 셋 찾았다 — 그중 둘은 **9/19 에 그
> 도구로 판단하면 오진하게 되어 있었다.**

---

## 0. 한 줄 요약

> **측정 도구가 세 군데 거짓말을 하고 있었다.** 회피 떨림 지표는 제한을 켜고
> 달린 런 3개를 전부 위반으로 찍었고, 시험 3개는 `/tmp` 픽스처가 없으면
> 조용히 통과했으며, 제동의 '관성 꼬리 400ms' 는 odom 지연 아티팩트였다.
> 전부 실측 런으로 검증해 고쳤다. 코드 동작을 바꾼 것은 **제동 한 곳뿐**이다.

---

## 1. ★ 회피 떨림 지표가 오경보를 냈다 (`drive_review.py`)

### 무엇이 틀렸나

```python
dd = np.abs(np.diff(cc[np.isfinite(cc)])) / dt      # dt = 기록 주기 0.05s
```

기록기는 '마지막으로 받은 명령' 을 20Hz 로 베껴 쓸 뿐이다. **회피창 안에서
명령이 실제로 바뀌는 간격은 0.100s** 다(슬루 제한이 `cluster_plot`(10Hz)에
있고 먹스가 20Hz 로 재발행할 뿐). 그래서 변화율이 정확히 2배로 부풀었다.

### 실행 로그로 확인한 실제 설정 vs 지표

| 런 | 슬루 제한 | 기존 지표 | 수정 후 (95%) | 기존 판정 |
|---|---|---|---|---|
| 0126 | **90°/s 켬** | 160°/s | **24** | ❌ 오경보 |
| 0137 | **90°/s 켬** | 182°/s | **26** | ❌ 오경보 |
| 0152 | **90°/s 켬** | 166°/s | **24** | ❌ 오경보 |
| 0312 | 끔 | 720 | **169** | 정상 경보 |
| 0337 | 끔 | 604 | **137** | 정상 경보 |

근거: `data/2026-09-17/run_0126.log` 외 — `★ 회피 조향 슬루레이트 제한 90°/s`
줄의 유무가 정답이다.

### 두 가지를 고쳤다

**① 나눌 값을 데이터에서 잰다.** 주기를 상수로 박지 않는다 — 같은 CSV 라도
회피창 **밖**에서는 명령이 20Hz 로 바뀐다(측정값). 그래서 "일괄 ÷2" 는
틀린 고침이다.

**② 판정을 최댓값 → 95백분위로.** 최댓값은 거의 항상 **먹스가 조향 소스를
바꾸는 한 계단**이었다:

```
0137 t76.85   CLEAR|STRAIGHT +0.9°  →  AVOID|RIGHT −8.2°    182°/s
0152 t127.55  AVOID −14.7°          →  BLOCKED|STOP −2.4°   123°/s
```

두 소스가 실제로 9° 다르면 그 계단은 피할 수 없고, 액추에이터가 한 번 0.36s
뒤처질 뿐 **진동이 아니다**. 최댓값은 두 집단을 못 가르고(0137=182 vs 0337=550,
둘 다 경보) 95%는 5~7배로 깨끗이 가른다. 문턱 50°/s 는 데이터에 맞춘 게 아니라
**액추에이터 25°/s 의 2배** 라는 물리에서 왔다.

### 못 박았다 — 그리고 일부러 깨뜨려 봤다

`tools/test_drive_review.py` 가 실행 로그의 설정과 판정표를 대조한다. 처음엔
문턱(50°/s)만 봤는데, 분모를 예전처럼 0.05s 로 되돌려 **일부러 깨뜨렸더니
값이 24→48 로 2배가 됐는데도 시험이 통과했다**(문턱 아래라서). 그래서 검증된
기준값 자체를 ±1 로 못 박았다 — 지금은 깨뜨리면 5건이 빨강으로 난다.

> **새 시험을 붙였으면 일부러 깨뜨려 빨강이 나오는지 볼 것.** 이번에도 첫
> 시험은 아무것도 안 잡고 있었다.

> 슬루 제한이 회피조향 **내부**만 매끄럽게 하고 소스 전환 계단은 제한하지
> 않는다는 것도 이때 드러났다. 물리적으로 손해가 없어(액추에이터가 병목)
> 고치지 않았다. **알고 가는 한계다.**

### 덤 — 구(舊) 기록 단위버그 탐지

`cmd_steer` 최대가 40° 를 넘으면 실패로 찍는다(조향은 ±18° 클램프).
실측으로 완전히 갈린다: `drive_0020 = 814°`(=14.2×57.3) vs 나머지 전부 ≤18.0°.
9/16 이전 CSV 를 열었을 때 조용히 오판하는 것을 막는다.

---

## 2. ★★ 시험 3개가 픽스처 없으면 **조용히 통과**했다

```python
if not os.path.exists(RUN):
  return None          # ← 그리고 아무 말 없이 ✅
```

`test_avoid_rate` · `test_avoid_hold` · `test_lidar_mount_check` 가 전부
`/tmp/drive_XXXX.csv` 를 직접 가리켰다. **`/tmp` 는 재부팅하면 사라진다.**
즉 9/19 아침에 노트북을 껐다 켜면 **실측 검증부가 통째로 안 돌면서
'전부 통과' 가 뜬다.** 가짜 초록은 시험이 없는 것보다 나쁘다.

**조치:** `tools/drive_fixtures.py` — 저장소 사본(`data/<날짜>/`)을 먼저 찾고,
없으면 **소리내어 죽는다**. 세 시험을 전부 연결했다.

```
$ python3 -c "from drive_fixtures import require_run; require_run('9999')"
❌ 실측 픽스처 drive_9999 를 못 찾았다.
   찾아본 곳: …/data/2026-09-17/drive_9999.csv 또는 /tmp/drive_9999.csv
   /tmp 는 재부팅하면 사라진다. data/<날짜>/ 사본을 확인할 것.   (exit 1)
```

확인: `test_avoid_rate.RUN` 이 이제 `data/2026-09-17/drive_0337.csv` 를 가리킨다.

---

## 3. 제동 — 인계문서의 주장을 **데이터가 반증했다**

### 9/17 문서 §1-4 의 주장

> 제동 시간 계산이 어긋나 있다. 700ms 만에 제동이 끝나고 **마지막 400ms 는
> 관성**이다. 측정속도로 바꾸면 1.1초 → 0.7초대.

### 실제 (drive_0152 t78.65 제동 사건)

odom twist 는 **약 0.2s 지연**한다. 위치를 미분하면 다르게 보인다:

| 시각 | odom twist | 위치미분 |
|---|---|---|
| 79.25 | 0.70 | **0.24** |
| 79.35 | 0.45 | ← 제동 종료(700ms) |
| 79.45 | 0.27 | **0.10** |

차는 t≈79.40 에 이미 섰다. **관성 꼬리는 거의 없다.** "1.1초 → 0.7초대" 는
성립하지 않는다 — 그 1.1초 자체가 지연된 신호를 읽은 값이다.

```
정지거리 0.64 m · 실효감속 0.98 m/s²   (관성 정지면 1.70 m)
```

### 그래도 고쳤다 — 이유가 다르다: **내리막**

기준속도를 **측정속도로 올린다**(`serial_bridge_node.py`). 평지에서는 해제조건
②(측정속도 0.15 미만)가 먼저 끊어 거의 무의미하다. 그러나 내리막에서는
실제속도가 명령보다 훨씬 높고 감속도 느려서, **명령으로 잰 제동시간이 차가
아직 구르는 중에 끊긴다**(②는 아직 안 걸림). **용인에 내리막이 있다.**

안전 설계:
- **올리기만 하고 내리지 않는다** — 측정이 낮게 나와도 제동이 짧아지지 않는다
- 3.0 m/s 초과는 무시 (odom twist 가 61.9 m/s 까지 튄 실측이 있다)
- 0.5s 넘게 낡은 측정은 안 쓴다
- 최종값은 `ff_brake_ms` 상한과 해제조건 ②가 잡는다

`test_brake_logic.py` 에 케이스 5개를 추가해 못 박았다(총 18개 통과).

---

## 4. 새 도구 — `tools/mission_plan_check.py`

### 왜

용인 계획은 9/19 현장에서 처음부터 짜야 한다. 잘못 잡으면 증상이 **조용한
탈락**이다 — 노드도 로그도 멀쩡한데 엉뚱한 지점에서 미션이 돌거나 안 돈다.
지금까지 이 판단은 전부 **주석에 적어 둔 사람의 계산**뿐이었다. 시퀀서는
런타임에 course 블록(파일명·길이)만 대조하고, s 구간이 기하학적으로 말이
되는지는 아무도 안 봤다.

### 검사 항목 (전부 실측 근거)

| 항목 | 근거 |
|---|---|
| arm 여유 ≥ 6.8m | 감지 트리거 4.0 + BLOCKED 반경 2.8. BLOCKED 는 조향을 안 낸다 |
| arm 지점 곡률 | R<8 실패 / R<11 경고 (s33 R=6.4 급커브 · s37 R=11.0 실차 허용) |
| 창 최악 곡률 | 이탈 ≈ d²/(2R). 2m 포기 시 경고선 0.72m |
| 구간 겹침 | `inhibits` 로 서로를 끈다 (9/14 에 실제로 의자를 못 피했다) |
| 캘리브 구간 | s<10 은 teleop 이 먹스 우선이라 미션이 안 돈다 |
| 코스 길이 | 시퀀서가 런타임에 거부하는 것과 같은 조건 |

### ★ arm 지점 역산이 실측 결과를 재현한다

```
$ python3 tools/mission_plan_check.py config/chungju_school/mission_plan_school.yaml --suggest 44

[arm 지점 역산] 장애물이 s=44.0m 에 있다고 할 때
  · arm 은 s ≤ 37.2 여야 한다 (감지 4 + BLOCKED 2.8 = 6.8m)
  · 판정은 arm 지점이 아니라 **창 [s_enter, 44.0] 전체의 최악 곡률**로 한다
  ⚠  권장 arm     s_enter = 37.0  (창최악 R=11.0m · 여유 7.0m · 이탈 0.18m)
  · 쓸 수 있는 구간: s 35.0 ~ 37.0
```

**9/17 밤에 여러 번 박고 나서 얻은 s_enter=37.0 을, 기하만으로 다시 얻는다.**
쓸 수 있는 구간의 아래끝 s35 도 인계문서의 "s35 아래로는 내리지 말 것" 과
일치한다.

> ⚠ **창 전체를 봐야 한다.** 처음에 arm 지점 곡률만 봤더니 s21.5 를 권했다.
> 그 창 안에는 s25 R=4.7m 헤어핀이 들어 있다 — 실제로 거기서 벽에 박은 적이
> 있다. AVOID 는 armed 창 **어디서든** 뜰 수 있다.

`tools/test_mission_plan_check.py` — 케이스 20개, **전부 과거에 실제로 밟은
지뢰**에서 가져왔다.

---

## 5. 용인 코스 사전 분석 (현장 시간을 아끼려고 미리 냈다)

`config/yongin_2026-09-05/wp_yongin_drive_0.5.yaml` · 648.3m · 1298점

```
회피 arm 가능 (R ≥ 11m, 길이 6.8m 이상)   합계 462m / 648m (71%)
  s   0.0~ 58.0 (58.0m)    s 136.0~180.0 (44.0m)   s 245.9~304.4 (58.5m)
  s 310.9~331.4 (20.5m)    s 360.4~384.4 (24.0m)   s 394.4~430.9 (36.5m)
  s 438.4~464.9 (26.5m)    s 473.4~539.9 (66.5m)   s 549.9~576.9 (27.0m)
  s 586.4~603.9 (17.5m)    s 622.4~648.3 (25.9m)   (그 외 짧은 구간 6개)

급커브 (R < 8m) 22곳 — 미션 절대 금지. 최악 R=3.0m (s97.5 · s111 · s615.9)
```

경로 자체는 통과 가능하다: **최소 R=2.71m → 필요타각 16.2° / 상한 18°.**
단 R<3.5m 인 "빠듯한 커브" 가 19개 — 그 구간은 속도를 낮춰야 한다.

### 한 장으로 보기 — `tools/course_map.py`

```bash
python3 tools/course_map.py config/yongin_2026-09-05/wp_yongin_drive_0.5.yaml
python3 tools/course_map.py <wp.yaml> --plan config/mission_plan.yaml   # 구간 겹쳐 그림
```

위는 지도(경로를 **arm 가능 / 경계 / 금지**로 칠함), 아래는 s 에 따른 곡률반경.
`--plan` 을 주면 미션 구간이 급커브에 걸쳤는지 눈으로 바로 보인다.

> ⚠ **곡률 정의가 두 개다. 섞지 말 것.**
> · **인접 3점**(기선 1.0m) — `preflight.py` · `smooth_path.py`. "차가 물리적으로
>   돌 수 있나". 급한 곳을 안 깎아 **보수적**이다. 용인 최소 R=**2.71m**
> · **i±2**(기선 2.0m) — `arm_window_plot.py` · `mission_plan_check.py`.
>   이탈식 d²/(2R) 의 d=2m 과 기선이 맞는다. 같은 지점이 **2.96m** 로 나온다.
> 처음에 이걸 섞어 써서 preflight(2.71)와 지도(2.96)가 다른 말을 했다.
> 지금은 지도의 최소 R 표기만 인접 3점을 쓴다.

> ⚠ 색: 초록/빨강 조합을 먼저 시도했다가 **색각 이상에서 구분 불가**임을
> 계산으로 확인했다(deutan OKLab ΔE 4.1 — 문턱 6). 파랑/호박/빨강으로 바꿨다
> (최소 ΔE 19.8). 범례에 글자를 달아 색만으로 뜻을 나르지 않는다.

### ★★ 용인 코스 구조 (사용자가 알려준 것 — 계획의 근거)

| 구간 | s (추정) | 내용 | 기하 |
|---|---|---|---|
| 오르막·내리막 | **11~54** | 경사 1곳 | R 27~900 · 경로조향 최대 1.6° |
| 굴절코스 | **58~140** | 직각 지그재그 | R 최소 3.0 · 경로조향 최대 14.9° |
| **S자 + 장애물 2** | **176~250** | S자 **안에서 회피** | R 최소 3.4 · 경로조향 최대 13.2° |
| 돌발정지 | **484~523** | 급정지 후 **4초** 재출발 | R 32~118 · 경로조향 최대 1.4° |

s 값은 사용자가 지도에 표시한 영역을 좌표로 역산한 것이다. **현장에서
`mission_s.py --live` 로 확정할 것.**

#### 장애물: 헤네스 브룬 차체(바퀴 뺀 것) 2개, **무작위 배치**

무작위라서 **s 를 미리 못 잰다 → S자 전체에 arm 해야 한다.**
`--suggest` 로 arm 지점을 역산하는 방식이 여기서는 안 먹는다.

놓인 방향에 따라 보이는 폭이 달라진다:

```
세로(진행방향)  폭 0.60~0.70m → 지나가려면 옆으로 0.94~0.99m
가로            폭 1.10~1.25m → 옆으로 1.19~1.26m   ← 트랙창 1.20m 를 넘는다
```

**이게 계획을 바꾼다:**

1. **`avoid_max_lateral_m` 0.85 는 너무 작다.** 브룬을 지나가려면 0.96m 가
   필요한데 상한 0.85 에 걸려 **필요한 순간에 회피를 버린다**. 1.15 이상으로
   올릴 것. (0.85 는 학교 의자 반폭 0.20m 기준으로 나온 값이다)
2. **가로로 놓이면 현재 설정으로는 갭이 없다(BLOCKED).**
   `fg_safety_margin` 0.25 → 0.15 로 내리면 필요 이탈 1.26 → 1.16m 로
   트랙창 안에 들어온다. 트랙창을 넓히는 것(`fg_track_width` 2.8+)은
   **연석·벽이 장애물로 잡히므로** S자에서 더 위험하다.
3. **BLOCKED 시작 거리가 2.8m 가 아니다.** 그 값은 학교 의자 실측이다.
   `r = (장애물반폭 + 안전반경) / sin(조준창)`:
   ```
   의자 0.20 → 2.39m    브룬 세로 0.30 → 2.67m    브룬 가로 0.60 → 3.52m
   ```
   최악(가로) 기준 arm 여유 = 4.0 + 3.52 = **7.5m** → `s_enter ≤ 168.5`

#### S자 회피의 진짜 제약 — 조향 여유

커브에서는 **경로조향이 조향을 먼저 먹는다**(δ = atan(축거/R)):

```
S자   최대 13.2° → 조준창(±20.6°) 여유 7.4° · 조향상한(±18°) 여유 4.8°
굴절  최대 14.9° → 조준창 여유 5.7° · 조향상한 여유 3.1°
```

플래너가 `fg_aim='path'` 로 **경로가 원하는 방향에서 출발해** 갭이 강제하는
만큼만 벗어나므로 원천적으로 불가능하진 않다. 다만 여유가 5° 안팎이다.

> '커브에서 arm 금지' 는 학교 트랙에서 나온 발견적 규칙이고, 그 트랙엔
> 커브에서 회피할 **이유가 없었다.** 용인에는 있다. 그래서 곡률 문턱 대신
> **이탈 상한(`avoid_max_lateral_m`·`avoid_max_heading_deg`)이 유일한 보호장치**다.
> 먹스의 `cap_reason()` 은 예측이 아니라 **실제 경로 이탈**을 재서 초과하면
> 회피를 버리고 경로조향으로 복귀한다(히스테리시스 포함).
>
> ⚠ 상한값은 학교 숫자를 쓰면 안 된다. **S자를 장애물 없이 한 바퀴 돌아
> 실측 이탈(p95)을 재고**, 거기에 통과 필요량(0.96m)을 더해 정할 것.
> 커브에서는 추종오차 자체가 크므로 상한이 상시 걸려 깜빡일 수 있다.

#### 후보 계획 (현장에서 s 확정 후 확인용)

```yaml
lidar_avoid:  s_enter 168.5  s_exit 252.0   # S자 전체 + arm 여유 7.5m
sudden_stop:  s_enter 478.0  s_exit 528.0   # dwell 4.0
```
```bash
python3 tools/mission_plan_check.py <계획> --curve-avoid --obstacle-width 0.65
```

### ⚠ 원점이 지금 충주로 되어 있다 (76.8km 어긋남)

```
$ python3 tools/preflight.py --waypoints config/yongin_2026-09-05/wp_yongin_drive_0.5.yaml
❌ 경로: 원점이 76.8km 다르다 — 다른 장소(용인 (2026-09-05)) 데이터다
❌ 정지점: 원점이 149.7km 다르다 — 다른 장소(None) 데이터다
```

학교에서 시험 중이니 **지금은 정상**이다. 다만 9/19 에 반드시:

```bash
bash tools/use_site.sh yongin
```

비파괴로 확인했다 — 용인 wp 파일의 원점 스탬프
(`332200.0, 4128600.0, epsg 32652`)가 `config/site_origin.yongin.yaml` 과
**정확히 일치**한다. 전환하면 해결된다.

정지점(`/home/han/stop_points.yaml`)은 149.7km 어긋난 **다른 장소 데이터**다.
용인에서 `stop_point_recorder` 로 다시 찍어야 한다(신호등 미션 필수).

---

## 6. 시험 상태 — 전부 통과 (13개)

```bash
cd /home/han/racing_ws && source install/setup.bash
python3 tools/test_mount_geom.py          python3 tools/test_avoid_rate.py
python3 tools/test_lidar_mount_check.py   python3 tools/test_avoid_hold.py
python3 tools/test_aim_clearance.py       python3 tools/test_avoid_geometry.py
python3 tools/test_brake_logic.py         python3 tools/test_sudden_stop.py
python3 tools/test_crosswalk_stop.py      python3 tools/test_parking_geometry.py
python3 tools/test_mission_plan_check.py   python3 tools/test_drive_review.py  # ★ 새것
PYTHONUNBUFFERED=1 timeout 900 python3 tools/test_mission_sequencer.py   # 6분+
cd src/mission_perception/pi_deploy && python3 test_lamp_classify.py
```

⚠ `source install/setup.bash` 를 빼면 `rclpy` 를 못 찾아 시험이 죽는다.

---

## 7. 이번 세션의 미커밋 변경

```
 M src/velocity_controller/.../serial_bridge_node.py   제동 기준속도 → 측정속도
 M tools/test_brake_logic.py                           케이스 5개 추가
 M tools/test_avoid_rate.py                            픽스처 해결자 연결
 M tools/test_avoid_hold.py                            픽스처 해결자 연결
 M tools/test_lidar_mount_check.py                     픽스처 해결자 연결
?? tools/drive_fixtures.py                             ★ 새것
?? tools/mission_plan_check.py                         ★ 새것
?? tools/test_mission_plan_check.py                    ★ 새것
?? tools/test_drive_review.py                          ★ 새것 — 판정표 회귀
?? tools/course_map.py                                 ★ 새것 — 코스 시각화
   tools/drive_review.py (미추적)                       변화율 지표 + 단위버그 탐지
```

**코드 동작을 바꾼 것은 `serial_bridge_node.py` 한 곳뿐**이고, 그것도
`ff_brake_pwm > 0` 일 때만 도는 경로다(기본 꺼짐). 나머지는 전부 도구·시험이다.
빌드 불필요 — `velocity_controller` 는 디렉터리 심링크 설치다.

---

## 8. 9/19 점검일 체크리스트 (갱신)

```
□ 원점 전환        bash tools/use_site.sh yongin        ← 안 하면 76.8km 어긋난다
□ preflight        python3 tools/preflight.py           → ❌ 0 건인지
□ 라이다 마운트     python3 tools/lidar_mount_check.py --confirm
□ IMU 링크         python3 tools/imu_link_check.py --seconds 60   → 끊김 0
□ 전압             vcc_watch.py — 주행 중 최저가 3000 넘는지
□ 장애물 s 실측     mission_s.py --live 로 회피·돌발 지점을 잰다
□ arm 지점 역산     mission_plan_check.py <계획> --suggest <장애물 s>
□ 계획 검사        mission_plan_check.py <계획> --obstacle lidar_avoid=<s>  → ❌ 0
□ 정지선 좌표       stop_point_recorder (현재 것은 149.7km 어긋난 남의 데이터)
□ 내리막           drive_record 로 내리막 끝 속도 — 제동 수정이 여기서 의미를 갖는다
□ 출발 위치        s≈0
□ RTK 커버리지      용인 VRS 되는지
```

---

## 9. 미해결 (이전 문서에서 이어짐)

| # | 항목 | 변동 |
|---|---|---|
| 1 | **전압** 최저 2282~2528mV | 그대로. **코드로 못 고친다** |
| 2 | **용인 정지선 좌표** | 그대로. 현재 파일은 149.7km 어긋난 남의 데이터임을 확인 |
| 3 | **용인 미션계획 s** | 도구는 준비됐다(§4). 숫자는 현장에서 |
| 4 | **GPS segfault** | 그대로. 허브 3단 뒤 |
| 5 | 경사로 홀드 | 그대로 (엔코더 없음 — 안 서고 올라간다) |
| 6 | 갭 선택 히스테리시스 | **대회 후** |

### 기각한 것

- **`/lidar/mute` 자기입력 순환** (9/16 §5 의 잠복 버그 의심) — 상태기계상
  실현되지 않는다. `mute=True` 는 PASSING 에서만 나오고, PASSING 은
  `obstacle` 을 아예 안 보고 `pass_duration` 뒤 CLEARED(종단)로 간다.
  라이다 ESCAPE 의 999 오독은 이미 `lidar_mode_topic` 으로 막혀 있다.
- **제동 '관성 꼬리 400ms'** — odom twist 0.2s 지연 아티팩트 (§3).

---

## 10. 이번 세션에 밟은 함정

1. **"일괄 ÷2" 로 고칠 뻔했다** — `cmd_steer` 는 전 구간 기준 20Hz 로 바뀐다.
   10Hz 인 것은 **회피창 안에서만**이다. 주기를 상수로 박지 말고 데이터에서 잴 것.
2. **최댓값으로 떨림을 판정** — 거의 항상 먹스 소스 전환 계단이다. 지속값(95%)을 볼 것.
3. **arm 지점 곡률만 보고 역산** — s21.5 를 권했고 그 창엔 R=4.7m 헤어핀이 있었다.
   AVOID 는 armed 창 **어디서든** 뜬다. 창 전체를 볼 것.
4. **odom twist 로 감속 판정** — 0.2s 지연한다. 정지 타이밍은 **위치미분**으로 볼 것.
5. **시험이 통과한다고 다 돈 게 아니다** — 픽스처가 없으면 조용히 건너뛰고 있었다.

---

## 11. 근거

```
data/2026-09-17/          이전 세션이 저장소로 옮겨 둔 실측 21MB (그대로 씀)
  drive_0126/0137/0152    슬루 제한 **켜고** 달린 런 — run_*.log 로 확인
  drive_0312/0337         제한 **끄고** 달린 런
  drive_0020              9/16 이전 단위버그 런 (cmd_steer 814°)
  drive_0152 t78.65       능동 제동 실측 사건 — §3 의 근거
```
