hanmin0211/racing_ws/HANDOFF_2026-09-13.md

# 인계 — 2026-09-13 (9/12~9/13 이틀치)

대회: **HL FMA 2026**, 용인운전면허시험장. **기능점검 9/19 · 본경기 9/20.**
오늘이 9/13 이므로 **남은 준비일 5일**.

목표는 **완주**. 탈락은 네 가지뿐이다 — ①연석·규정도로 이탈 ②1분 이상 정지
③입력장치 사용 ④주행불가 판정. **8분 초과는 감점(1분당 5점)이지 탈락이 아니다.**
신규 3개(S코스 회피·돌발 급정지·신호제어 차선유지)도 감점-only다.

---

## 0. 지금 당장 알아야 할 것 (한 화면 요약)

| 항목 | 상태 |
|---|---|
| 브랜치 | `yongin-2026-09-05` |
| 사이트 원점 | **충주(학교)** — 대회 전 `bash tools/use_site.sh yongin` 필수 |
| 펌웨어 | **9/13 19:51 업로드 완료** (백업 `arduino/backup/`) |
| 구동 FF | `PWM = 38.8·v + 17.2`, ROS 쪽 변환(`ff_mode:=ros`) |
| 회피 기하 | `track_width 2.4 / lookahead 1.5 / trigger 4.0 / prefer_path_gap true` |
| 조향 상한 | 18° (물리 20° 지만 엔드스톱 스톨 때문에 올리지 않는다) |
| 용인 미션계획 | **전부 `enabled: false`, s 값 0.0 placeholder** |
| 학교 미션계획 | `config/chungju_school/mission_plan_school.yaml` (리허설용) |

**마지막으로 하던 일**: 학교 트랙에서 ①회피 ②돌발정지를 실차로 검증하려던 참.
명령은 §6 에 있다. 아직 **둘 다 실차 검증 0회**다.

---

## 1. 9/12 에 한 것

### 1-1. 라이다 회피를 실제로 동작하게 만들었다

시뮬 하네스로는 안 보이던 결함 두 개를 실물에서 찾았다.

- **안전버블이 '가장 가까운 점' 에만 걸려 있었다.** 모든 장애물 점에 걸도록
  고치니 통과 시 여유가 0.00m(접촉) → 0.28m 가 됐다.
- **메서드 정의가 `__init__` 한복판에 끼어들어 있었다.** 그 아래 publisher 와
  `/scan` 구독이 **조용히 만들어지지 않았다**. 프로세스는 살아 있고 토픽만 0개였다.
  시뮬 하네스는 플래너를 직접 import 해서 이 결함을 영원히 못 본다.
  → 이후 `ast` 로 "이 속성이 `__init__` 안에 있는가" 를 검증하는 습관을 들였다.

겨냥점(`fg_aim`)도 측정으로 정했다. 학교 트랙 3장애물 9배치:
`center` 0/9 · `nearest` 4/9 · **`path` 7/9** → 기본값 `path`.

### 1-2. 라이다 두 대가 같은 `/scan` 에 섞이던 문제 (탈락급)

앞뒤 라이다가 **둘 다 CP2102** 라 드라이버를 두 번 띄우면 기본 토픽이 같아
앞뒤 스캔이 섞이고 **회피가 뒤쪽 물체에 반응**했다. `lidar_dual.launch.py` 로
`/scan_front` · `/scan_rear` 분리. bringup 의 `scan_topic` 기본값도 `/scan_front`.

### 1-3. 학교 트랙 시작선에서 '완주' 로 오판

시작-끝이 4.26m 라 첫 프레임 전역탐색이 끝점을 집어 남은 거리 2.1m <
goal_tolerance 1.0m → **출발도 전에 🏁완주**. 트랙 뒤 15m 를 잘라
(178점 88.0m → **147점 73.0m**) 시작-끝 간격을 **9.76m** 로 벌렸다.
preflight 에 "시작-끝 간격 2~8m" 검사 추가.

### 1-4. 평행주차 — 가능하다는 것까지 확인

단일 S자로는 4.0m 가 필요해 규정 2.10m 슬롯에 **불가**. 끊어 넣기(shuffle)로는
진입 24스트로크 66s + 탈출 32스트로크 52s = **약 118초**. `tools/parallel_park_plan.py`.
※ 8분 예산에 아직 반영 안 됨.

---

## 2. 9/13 에 한 것 — ★ 핵심

### 2-1. 구동 FF 가 4배 틀려 있었다 (모든 것의 원인이었다)

펌웨어의 개루프 FF 가 `PWM = 80 + 95·v` 였다. 실제와 4배 어긋난다.
그래서 **0.15 m/s 명령에 PWM 94 가 나가 차가 2 m/s 로 달렸고**, 헤딩 캘리브가
**8회 연속** '측위 점프' 로 거부됐다. 캘리브를 더 느리게(0.3→0.2→0.15) 낮춘 건
방향이 반대였다 — 이 차는 개루프로 **0.45 m/s 아래를 못 낸다**(PWM 45 → 0.00 m/s).

**최종 상수: `PWM = 38.8·v + 17.2`**

근거로 쓴 점(신뢰 가능한 것만):

| PWM | 속도 | 출처 |
|---|---|---|
| 56 | 1.00 m/s | 캘리브 10m 주행, 1m 구간 9개가 전부 1.00±0.02 |
| 65 | 1.11 m/s | `ff_identify` (덜컹 판정 통과) |
| 94 | 1.98 m/s | `calib_trace` |

세 점 최소자승 → `36.7·v + 21.6` (최대오차 2.6 PWM). 현재 값과 사실상 같다.

> **⚠ 여기서 한 번 헤맸다.** `ff_identify` 의 `PWM 55 → 0.46 m/s` 를 믿고
> `22.6·v + 44.2` 를 썼다가 나중에 뒤집었다. 그 런은 **12초에 3.60m(평균 0.30)**
> 를 가 놓고 "정상상태 0.46 · 최대 0.77" 이었다 — 정지마찰 근처에서 **섰다
> 굴렀다** 한 것이라 한 숫자로 대표할 수 없다.
> `ff_identify` 가 이제 그런 단계를 '덜컹' 으로 자동 제외한다(§5).

**적용 방식: 펌웨어가 아니라 ROS 쪽에서 변환한다** (`ff_mode:=ros`).
`serial_bridge` 가 `VEL:` 대신 실측 상수로 만든 `PWM:` 을 보낸다.

- 이유 ①: 현장에서 노면이 바뀌면 **보드를 굽지 않고** 런치 인자로 고칠 수 있다.
- 이유 ②: `VEL:` 경로는 `BRAKE_LIMIT 0.8 m/s²` 로 목표속도를 깎아 내려가
  1.0 m/s → 0 에 **1187ms** 가 걸린다. `PWM:` 경로(레이트 제한 해제 후 10ms)보다
  훨씬 느리다. **정지거리에서 손해다.**

**크리프 하한 `ff_min_pwm 50`** 도 넣었다. 커브에서 `v = v_max/(1+6|κ|)` 가
0.25 m/s 로 떨어지면 그 PWM 으로는 **바퀴가 안 돈다** → 그대로 서면 1분 이상
정지 = 탈락. '멈추라' 가 아닌 한 최소 PWM 을 유지한다.

**`auto_calib_speed` 0.3 → 0.5.** 그 아래는 물리적으로 안 나간다.
10m 를 0.5 m/s 로 20s — 캘리브 최소 16.7s 를 넘는다.

### 2-2. 캘리브 성공 (8회 실패 끝에)

```
✅ 헤딩 초기화 완료: 10.0m 직진 (최대 편차 1°) → yaw_offset=81.6°
   조향 중앙 점검: 횡편차 +0.05m — STEER_CENTER 412 양호 (보정 불필요)
```

### 2-3. 차가 의자를 박았다 — `lidar:=true` 를 빼먹었다

라이다 드라이버는 정상(`/scan_front` 전방 720점, 최근접 6.82m)이었고 회피
알고리즘도 멀쩡했다. **스캔을 받아 판단하는 노드가 아예 안 떠 있었다.**
→ `lidar:=false` 로 뜨면 시작할 때 배너로 크게 경고한다.

### 2-4. '회피는 하는데 조향각이 부족하다' — 원인은 클램프가 아니었다

갭을 겨냥할 수 있는 **각도 창**은
`atan(max_center_y / planning_lookahead)`, `max_center_y = track_width/2 − 차폭/2 − margin`
이고 옛 값(2.7 / 2.2)에서 **±17.9°** 뿐이었다. aim_margin 2° 를 빼면 실제 최대가
**±16°** — **18° 클램프에 닿아본 적도 없었다.**
게다가 정면 장애물이 버블로 막는 각은 2.0m 에서 **±25.7°** 로 창보다 넓어
남는 갭이 없어 `AVOID` 가 아니라 **`BLOCKED`(정지)** 로 떨어졌다.

`lookahead` 를 줄이면 **탐지 폭은 그대로 두고 조준 창만** 넓어진다 → 1.5.

### 2-5. ★ 규정 도면으로 `track_width` 를 확정 (탈락급 버그를 잡았다)

차량규격 PDF p6 도면 실측:

| 항목 | 값 |
|---|---|
| 도로 폭 | **2700mm** (중앙선 위 1400 + 아래 1300) |
| 장애물 종방향 간격 | 2500mm |
| 장애물 돌출 | 중앙선 넘어 200mm |
| 차선 폭 | 100mm |
| 헤네스 차량 | 길이 1400 · **폭 775mm** |

→ 통과폭 **1550mm**. `safety_margin 0.25` 로 충분.

**그런데 `track_width` 에 실제 도로폭 2.7 을 넣으면 안 된다.**
연석(±1.35m)이 창 안에 들어와 **장애물로 잡힌다**:

- 연석만 보이는데 `AVOID` → 먹스가 **경로조향을 통째로 버린다**
  → 경로가 +15° 를 원하는 커브에서 +7.8° 만 내 밖으로 밀린다 = **이탈 = 탈락**
- 장애물까지 있으면 연석+장애물이 다 막아 `BLOCKED`

| track_width | 연석만 | 장애물 3.0/2.5/2.0m |
|---|---|---|
| 2.7 | **AVOID ✗** | 전부 BLOCKED |
| 2.6 | **AVOID ✗** | 전부 BLOCKED |
| **2.4** | CLEAR ✓ | −10.5 / −12.2 / −14.7 ✓ |
| 2.0 | CLEAR | 2.0m 에서 BLOCKED |

### 2-6. 콘 사이로 '통과' 하게 만들었다 (`prefer_path_gap`)

follow-gap 은 원래 `max(갭 폭)` 으로만 골라서, 콘 두 개가 만든 **문**을 지날 때
문 사이(좁음) 대신 문 바깥(넓음)으로 샜다. 가고 싶은 방향을 품은 갭을 먼저
고르게 했다.

좁은 갭을 골라도 위험하지 않다 — **안전버블이 통과 불가한 문은 이미 지워
`BLOCKED` 로 만든다.** 살아남은 갭은 어느 것이든 양옆 여유가 확보돼 있다.

실측 통과 가능 문 폭(의자폭 0.45m, 3m 앞): **중심간격 2.0m 이상**
(1.8m 는 `BLOCKED`. 이론 하한 1.275m 지만 `min_gap_width_deg 3°` 여유 때문).

> **규정 대조**: S코스는 "중앙선 없이 **좌·우측으로 자유 회피**" 라 콘 사이를
> 지나는 게 아니라 **각각을 옆으로 돌아가는** 슬라롬이다. `prefer_path_gap` 은
> 지날 수 있는 문이 있으면 지나고 없으면 돌아가므로 해가 되지 않는다.

### 2-7. 펌웨어를 구웠다 (9/13 19:51)

| 상수 | 전 | 후 | 이유 |
|---|---|---|---|
| `STEER_DEADBAND` | 16 | 24 | 조향 스톨 |
| `STEER_RESUME` | 24 | 32 | 〃 |
| `STEER_STALL_ERR` | 15 | 24 | 〃 (인계문서의 28 은 무가드 구간을 만들어 채택 안 함) |
| `STEER_STALL_MS` | 250 | 400 | 〃 |
| `OPENLOOP_RATE` | 양방향 3 | **증가만 3** | 정지거리 |
| `STATIC_FF`/`GAIN` | 80/95 | 17.2/38.8 | 폴백 |

**레이트 제한을 올릴 때만 걸도록 바꾼 이유**: 이 제한은 급가속으로 전원이
무너지는 걸 막으려는 것인데, 내릴 때까지 묶어 두면 PWM 56 → 0 에 187ms 가
걸리고 그 동안 차는 계속 달린다. 동력을 끊는 방향은 전원에 부담이 없다.
방향 전환은 **0 을 거쳐** 가도록 막았다(한 사이클에 +40 → −40 은 전류 스파이크).

검증: 출발 0→56 **190ms 유지** · 급정지 56→0 **10ms** · 전진→후진 150ms.

업로드 후 텔레메트리: `VCC=5115 VMIN=5091`(무부하라 정상. 어제의 3948mV 는
모터 부하 때), `ENC1=0`(엔코더 여전히 미중계 → `NO_ENCODER 1` 유지가 맞다),
`STEER ADC=131 TGT=412 ANGACT=-13.6 PWM=0`(바퀴가 우측으로 돌아가 있지만
워치독이 물려 모터는 꺼져 있음 — 부팅 직후 정상).

> **⚠ bringup 을 켜는 순간 조향이 중앙으로 281카운트 한 번에 움직인다. 손 치울 것.**

`arduino-cli` 는 없지만 데비안 `arduino-builder` 로 컴파일된다.
절차 전문은 `arduino/backup/README.md`.

---

## 3. 정지거리 — 브레이크가 없다는 사실

`PWM 0` 은 '동력 끊기' 지 '멈추기' 가 아니다. 그 뒤는 관성이다.

반응 지연(펌웨어 램프 수정 후 **312ms**):
라이다 1회전 182 + 노드 50 + 종방향 20Hz 50 + 시리얼 20 + 램프 10

관성거리 실측 적합 `coast = 1.384·v^1.506` (0.46→0.43m, 1.11→1.62m)

| 속도 | 총 정지거리 (수정 후) |
|---|---|
| 0.5 m/s | 0.64m |
| 0.7 m/s | 1.03m |
| 1.0 m/s | 1.70m |
| 1.4 m/s | 2.73m |

- 라이다 `min_range = 0.30m` — **그보다 가까우면 아예 안 보인다**
- 정지 명령은 `obstacle_stop_dist 0.8m` 안에 들어와야 나간다
- 멀리서부터 서 있는 물체는 4.0m 부터 점진 감속해 0.8m 에 선다(문제없음)
- **위험한 건 '갑자기'** — 감속할 시간이 없다

> **사람으로 시험하지 말 것.** 박스를 끈으로 당기거나 막대로 밀어 넣을 것.

---

## 4. 8분 예산 (실측 FF 로 재계산)

용인 648.3m, 미션 121s 가정, `curvature_gain 6.0`:

| PWM | v_max | 총시간 | 시간감점 | cte최대 |
|---|---|---|---|---|
| 70 | 1.36 | 748s | 25점 | 0.240m |
| 75 | 1.49 | 694s | 20점 | 0.247m |
| 80 | 1.62 | 648s | 15점 | 0.256m |
| 90 | 1.88 | 576s | 10점 | 0.272m |

**80 → 90 은 5점밖에 못 줄이는데 cte 가 커져 이탈(=탈락) 위험이 오른다.**
시간감점은 많아야 35점, 주차 둘 다 포기해도 70점. **탈락하면 전부 잃는다.**
→ `max_speed` 1.2~1.4 에서 시작해 깨끗한 완주가 재현되면 1.6 까지만.

---

## 5. 새로 만든/고친 도구

| 도구 | 용도 |
|---|---|
| `tools/avoid_monitor.py` | **정지 상태 점검.** 스캔·장애물·mode·회피각·**조향 명령→실제**·PWM·전압·스톨을 한 줄로. 파이프로 넘길 땐 `python3 -u` |
| `tools/test_avoid_geometry.py` | 회피 기하 회귀 테스트. 연석 오탐 금지 + 규정 장애물 회피 + 문 통과 폭 |
| `tools/ff_identify.py` | 개루프 PWM→속도. **덜컹 단계 자동 제외** + `/vcc_min_mv` 기록 |
| `tools/lap_budget.py` | 랩타임·감점 결정표 (FF 상수 갱신됨) |
| `tools/calib_trace.py` | teleop → cmd_vel → PWM → GPS 속도 추적 |
| `tools/preflight.py` | 출발 전 검사 (E 절에 미션계획 대조 포함) |

---

## 6. 다음에 할 일 — 순서대로

> ## ★ 2026-09-13 21시 추가 — ①②④ 를 한 런으로 합쳤다
>
> 아래 ①②④ 는 따로 돌리는 순서였다. 한 런에서 **회피 → 돌발정지 → 완주**
> 를 보려면 시퀀서로 s 를 갈라야 한다(조향 요구가 정반대라서다). 학교
> 미션계획을 그 순서로 바꿨다: **회피 arm 39~47 · 돌발 arm 47~72.**
>
> ```bash
> # 터미널 1 — 라이다 드라이버 (bringup 은 드라이버를 띄우지 않는다)
> ros2 launch lidar_clustering lidar_dual.launch.py rear:=false
> # 터미널 2
> ros2 launch gps_localization bringup.launch.py control:=true lidar:=true \
>   auto_calib:=true sequencer:=true sudden_stop:=true \
>   mission_plan:=/home/han/racing_ws/config/chungju_school/mission_plan_school.yaml \
>   waypoints:=/home/han/racing_ws/config/chungju_school/wp_school_track_0.5.yaml \
>   max_speed:=0.7
> # 터미널 3
> python3 -u tools/avoid_monitor.py | tee /tmp/avoid_$(date +%H%M).log
> ```
>
> | | s | 놓는 법 |
> |---|---|---|
> | 회피 장애물 | **44m** | 경로에서 좌 **또는** 우로 0.45m 비껴서 |
> | 의자(돌발) | **52m** | 경로 **정중앙** |
>
> `s 0~10`(캘리브)·`s 20~42`(커브)는 반드시 비울 것.
>
> ### ⚠ `max_speed` 는 아무 효과가 없다 (9/13 발견)
>
> `serial_bridge` 의 `ff_min_pwm=50` 이 모든 속도 명령을 덮어쓴다:
> 명령 0.7 → PWM 44.4 → **하한 50**. 캘리브 0.5 도, 커브 0.31 도 전부 50 이다.
> 즉 **커브 감속도 장애물 감속 램프(4.0→0.8m)도 통째로 무력화**된다.
> 차는 하한 속도 그대로 다가가다 0.8m 에서 동력만 끊고, 그 뒤는 관성이다.
>
> 코드 주석의 '실제 속도 약 0.46' 은 **폐기된 옛 상수(22.6·v+44.2) 기준이라
> 틀렸다.** 지금 상수로 뒤집으면 0.85 m/s 다. 실제로는 45→0.00, 56→1.00
> 사이 스틱슬립 구간이라 **아직 아무도 모른다.**
>
> **캘리브 10m 주행이 그 자체로 PWM 50 속도계다.**
>
> | 캘리브 10m | 실제 v | 정지거리 | 의자 |
> |---|---|---|---|
> | 20s | 0.50 | 0.64m | ✓ 선다 |
> | **17s** | **0.58** | **0.79m** | **⚠ 경계** |
> | 14s | 0.70 | 1.03m | ✗ 박는다 |
> | 12s | 0.85 | 1.35m | ✗ 충돌 |
>
> 17초보다 빠르면 의자를 박는다 → 회피만 보고 세운 뒤, 돌발정지는
> `obstacle_stop_dist:=1.6` 으로 따로 돌릴 것.
> (`ff_min_pwm` · `obstacle_stop_dist` 를 런치 인자로 노출해 뒀다. 둘 다
>  노드가 init 에서 캐시해서 런치 인자가 아니면 현장에서 못 바꾼다.)
>
> ### 캘리브가 거부되면 메시지를 볼 것
>
> 최소 소요시간 게이트가 있다: `need = 10m ÷ (auto_speed × 2) = 10.0초`.
> 9/13 성공은 PWM 56 → 1.00 m/s → **정확히 10.0초, 경계선 통과**였다.
>
> · `측위 점프다` (너무 빠름) → `auto_calib_speed:=0.85`. PWM 은 어차피
>   하한 50 이라 **차는 똑같이 달리고 게이트만 5.9초로 풀린다.**
> · `자동 직진 타임아웃` (안 움직임) → `ff_min_pwm:=55`.
>
> ### 의자는 8초 안에 치울 것
> `blocked_escape_s 8.0` — 8초 막혀 있으면 감속을 풀고 **밀고 나간다.**
> (서 있는 것이 탈락이라 일부러 그렇게 만든 것이다. 완주는 되지만 접촉.)
>
> ### 추종은 위험 요소가 아니다 (시뮬 확인)
> 0.46~1.00 m/s 전 범위에서 완주, cte 최대 4cm, 최대타각 9.7°(상한 18°),
> 조향 포화 0%. 헤딩 ±10° · 조향 바이어스 3° · 조향 스케일 0.7 을 넣어도
> 전부 완주(cte 최대 13cm). **오늘의 위험은 완주가 아니라 출발이다.**

### ① 학교에서 회피 실차 검증 ← **여기서 멈춰 있다**

```bash
cd /home/han/racing_ws && source install/setup.bash && \
ros2 launch gps_localization bringup.launch.py control:=true lidar:=true \
  auto_calib:=true \
  waypoints:=/home/han/racing_ws/config/chungju_school/wp_school_track_0.5.yaml \
  max_speed:=0.7
```
별 터미널: `python3 tools/avoid_monitor.py | tee /tmp/avoid_$(date +%H%M).log`

- 장애물은 **s 45m 복귀 직선**, 경로에서 **좌우로 0.4~0.5m 비껴서**
  (정중앙이면 양옆 0.95m 뿐이라 `BLOCKED` 로 선다)
- **캘리브 구간 s 0~10m 는 반드시 비울 것** — §7 참고
- 볼 것: `mode=AVOID` · **조향 명령→실제가 따라붙는가** · 스톨 `ok`

### ② 돌발정지 실차 검증

```bash
... sudden_stop:=true no_avoid_steer:=true ...   # 나머지 동일
```
- 장애물은 **경로 정중앙**(규정 더미가 도로 중앙에 서는 것을 흉내)
- `no_avoid_steer:=true` 가 없으면 **서면서 동시에 옆으로 핀다** = 미션 실패 10점
- 5초 안에 치워야 재출발을 볼 수 있다(안 치우면 `WAIT_CLEAR` → 우회)

### ③ 학교 트랙 곡률 (장애물 놓을 위치 참고)

> **⚠ 2026-09-13 재측정 — 아래 표는 이전 인계문서의 것을 고친 것이다.**
> 옛 표는 35~55 를 직선, 55~73 을 '완만한 커브' 라고 적었는데 **둘 다 틀렸다.**

```
 0~10m  캘리브 (미션 안 돎)          10~20m 나가는 직선 (R 45~880)
20~34m  급커브 (s25 에서 R=4.7m)     34~42m 커브 탈출 중 (R 7.1 → 13.4 → 38)
42~55m  **진짜 직선** (R 38~205)     55~73m R 7~9m 커브 ('완만' 하지 않다)
```

**장애물은 42~55 안에만 놓는다.** 55~73 에 돌발정지를 두면 R=9m 커브
한복판에서 감지·정지하게 되고 라이다 정면 섹터가 경로 밖을 본다.
34~42 에 회피를 두면 회피가 경로조향을 뺏어 커브를 못 돈다 = 이탈.
차가 각 지점 도달 시각(0.7 m/s, 캘리브+카운트다운 25s 포함):
s10 39s · s25 61s · s35 75s · s45 89s · s55 104s · 끝 129s

### ④ 미션 체인 통합 리허설 (아직 실차 0회)

```bash
... sequencer:=true mission_plan:=/home/han/racing_ws/config/chungju_school/mission_plan_school.yaml ...
```
학교 계획: 돌발정지 s **12~30** · 회피 s **35~55** (겹치지 않음).

### ⑤ 9/19 용인 현장에서 반드시 잴 것

- 각 미션의 **s 값** (`tools/mission_s.py --live --name <미션>`)
- **돌발 기준선 위치와 가속구간 s 범위** — 규정상 "고정 위치 아님" 이고
  기준선은 **당일 테이핑** 이다. s 구간을 **넓게** 잡아야 한다.
- `parking_pose_N` · `parking_exit_N` · `stop_points` (지금 전부 대구 값 = preflight 치명)
- **S코스 T870 차체 실측 치수** (구 도면은 이삿짐박스 기준이다)
- 직각·평행주차 슬롯 실측
- **`bash tools/use_site.sh yongin`** ← 이걸 빼먹으면 전부 무의미

---

## 7. 함정 모음 (다시 밟지 말 것)

1. **캘리브 중에는 회피도 감속도 안 된다.** `heading_init` 이 `/teleop/cmd_vel`
   로 몰고, 먹스에서 **teleop 이 자율보다 우선**이라 감속·회피 분기를 아예 안
   탄다. 조향 회피가 안 되는 건 **옳다**(꺾으면 헤딩 측정이 깨진다). 다만
   **정지도 안 되는 건 빈틈**이다 — 미해결. 출발선 앞 10m 를 비우는 것으로 관리 중.
2. **`sequencer:=true` 면 `require_arm_for_steer` 가 켜진다.** `lidar_avoid`
   미션이 arm 하지 않으면 **회피 조향이 코스 전체에서 꺼진다**. 용인 계획은
   지금 `enabled: false` + s 0.0 이라 **대회 설정으로 켜면 회피가 안 된다.**
3. **`lidar:=true` 를 빼먹으면 장애물을 그대로 박는다.** (배너 경고 추가됨)
4. 런치 인자를 정수로 주면(`:=15`) INTEGER 로 들어가 노드가 **즉사**한다.
   `ParameterValue(..., value_type=float)` 으로 감쌀 것.
5. `&` 가 체인 전체에 걸려 `VAR=` 대입이 서브셸에만 남는다. 두 번 밟았다.
6. `pkill -f "[c]luster_plot_node"` 는 같은 문자열이 자기 명령줄에도 있으면
   **자기 셸을 죽인다**. PID 로 죽일 것.
7. `/obstacle_distance` · `/lidar/avoid_steer` · `/steering_angle` 은 전부
   **Float64** 다. Float32 로 구독하면 조용히 아무것도 안 온다.
8. 전압 토픽은 `/vcc_mv` · `/vcc_min_mv` 다(`/vcc`·`/vmin` 아님).
9. 아두이노 포트는 ttyACM 번호가 아니라 **VID:PID 2341:0042** 로 찾을 것.
   GPS 와 번호가 뒤바뀐다.
10. 굽기 전 `ros2 node list` 가 비어 있어야 한다. 리셋 직후 명령이 들어오면
    차가 움직인다.

---

## 8. 미해결 / 확인 안 된 것

- **회피·돌발정지 실차 검증 0회** ← 가장 큰 공백
- **조향이 18° 까지 꺾이는 데 걸리는 시간을 안 재봤다.** 회피각이 여전히
  모자라면 각도가 아니라 **조향 응답** 문제다. `avoid_monitor` 의
  '조향 명령→실제' 칸으로 구분한다.
- **주행 중 공급전압.** 무부하 5115mV 는 깨끗하지만 9/12 주행 중엔 3948~4167mV
  까지 떨어졌다(경고선 4300). 리셋되면 그대로 멈춰 **탈락**이다.
- 캘리브 중 장애물 정지 없음(§7-1). 넣으면 캘리브 실패율이 오르는 트레이드오프.
  1.5m 이내에서만 정지하는 안(B)을 제안해 둔 상태, 사용자 판단 대기.
- `AVOID` 모드를 실물에서 아직 못 봤다.
- 후방 라이다 미연결.
- 평행주차 118초가 8분 예산에 미반영.
- preflight 치명 5건 — 전부 `stop_points`·`parking_pose_N` 이 대구 값인 것.
  용인 실측 전까지는 정상이다(그 미션들이 `enabled: false` 라 위험하지 않다).
