hanmin0211/racing_ws/HANDOFF_2026-09-11.md

# 인계 — 2026-09-11 (대회 속도 완주 검증 / 남은 8일)

이전 문서: `HANDOFF_2026-09-09.md`, `PROJECT_HANDOVER.md`
브랜치: `yongin-2026-09-05` · 커밋 `c7fdb4f`

대회: **HL FMA 2026** — 기능점검 **9/19**, 본경기 **9/20**, 용인운전면허시험장.
제한시간 8분, 195점 만점 감점제.
**탈락은 ① 코스이탈 ② 1분 이상 정지 ③ DNF ④ 입력장치 — 이 넷뿐이다.**

---

## 0. 한 줄 요약

**제어는 더 이상 완주를 막지 않는다.** 대회 속도(1.84 m/s)로 648.3m 전 구간을
HIL 완주했고, 이탈 최대 0.32m·조향 포화 0%로 여유가 있다.
남은 탈락 경로는 사실상 둘이다 — **전원 리셋(1분 정지)**과 **용인 실주행 미검증**.
그리고 8분 초과는 감점일 뿐이므로, **속도를 욕심내지 않는 것이 곧 탈락 방지**다.

---

## 1. ★ 판단 기준이 바뀌었다 — 8분은 탈락 조건이 아니다

규정 원문 확인: **지정시간 8분, 초과 매 1분당 5점 감점.** 탈락 아니다.
그러면 "8분을 맞추려면 PWM 255 가 필요하다"가 목표가 아니라,
**"감점 몇 점과 브라운아웃 탈락 위험을 어떻게 맞바꿀 것인가"** 가 판단이다.

`python3 tools/lap_budget.py --waypoints config/yongin_2026-09-05/wp_yongin_drive_0.5.yaml`

| PWM | v_max | 주행 | +미션121s | 8분 초과 | 감점 |
|---|---|---|---|---|---|
| **160 (현재)** gain 6.0 | 0.84 | 16.9분 | 18.9분 | 10.9분 | **55점** |
| **160** gain 3.0 | 0.84 | 14.8분 | 16.9분 | 8.9분 | **45점** |
| 200 gain 3.0 | 1.26 | 9.9분 | 11.9분 | 3.9분 | 20점 |
| 255 gain 3.0 | 1.84 | 6.8분 | 8.8분 | 0.8분 | 5점 |

읽는 법:
- `curvature_gain` 6.0 → 3.0 은 **PWM 을 안 올리고 10점**이다. 비용이 없다.
  (이탈량은 0.206m → 0.228m 로 거의 안 는다)
- PWM 200 → 255 구간은 **15점밖에 못 버는데** 브라운아웃 리셋 = 1분 정지 =
  **탈락**을 산다. 195점을 통째로 잃는 거래다.
- **최적점은 물리 상한이 아니라 전원이 확실히 견디는 지점**이다.

⚠ `max_speed` 는 **실제로 도달 가능한 속도**여야 한다. 곡률 감속이
`v_max/(1+gain·|κ|)` 라서, 하드웨어 상한보다 크게 주면 분자만 커져 **코너
목표속도만 오르고 직진은 어차피 펌웨어가 자른다** = 곡률 감속이 무력화된다.
(bringup 기본값 2.8 + PWM160 이 정확히 이 상태였다: 랩 16.9→12.8분, cte 0.206→0.283m)
도달속도 = `(MAX_DRIVE_PWM − 80) / 95` (펌웨어 개루프 FF 실측값).

---

## 2. 오늘 검증된 것 — 대회 속도 HIL 완주

```
ros2 launch gps_localization hil.launch.py \
  waypoints:=config/yongin_2026-09-05/wp_yongin_drive_0.5.yaml \
  max_speed:=1.84 max_steer_deg:=15 curvature_gain:=3
python3 tools/hil_vehicle.py --wp <같은 파일> --start-idx 0
python3 tools/hil_probe.py  --wp <같은 파일> --max-steer-deg 15 --tag v184_gain3
```

| 항목 | 시뮬 예측 | HIL 실측 | 오차 |
|---|---|---|---|
| 랩타임 | 407초 | **404초 (6.73분)** | 0.7% |
| 이탈 최대 | 0.313m | **0.319m** | 2% |
| 최대 타각 | 11.3° | **11.3°** | 일치 |
| 조향 포화 | 0% | **0%** | 일치 |

- 이탈 0.3m 초과가 8072샘플 중 16개(0.2%), 0.5m 초과 0개.
- **타각 상한 15° 로 충분하다.** 필요 최대가 11.3° 라 기구 끝단(18°)을 안 건드린다.
  (경로 기하학상 필요타각은 16.2° 지만 lookahead 가 완화한다)
- 캘리브 내성(시뮬): 조향 바이어스 ±1.5° 에서도 완주, 이탈 0.42m.

→ **`tracking_sim`/`lap_budget` 의 예측을 현장 판단에 그대로 써도 된다.**
  저속(0.5)에 이어 대회 속도에서도 실측과 맞았다.

---

## 3. ★ 오늘 이 랩에서 하드웨어는 루프에 없었다 (배터리 미연결)

증상: 조향 ADC 가 409~416(7카운트)에서 안 움직임, 엔코더 −2451432 → **0 으로 리셋**,
`serial_bridge` 재연결 **37회**, `/dev/arduino` 심볼릭 링크 재생성(USB 재열거).

원인은 **배터리 미연결**이었다. 아두이노가 USB 5V 만으로 돌던 중 모터 드라이버가
전류를 당기자 레일이 무너져 리셋 → USB CDC 끊김.

**그래서 다시 재야 하는 것:**
- 조향 스톨 4.0% 기준선 (9/9 실측값이 유일한 데이터)
- 전원 한계 PWM
- FF(PWM→속도) 실측, 엔코더 생사

**그래도 유효한 것:** 제어 검증 전부. `hil_vehicle` 은 `/cmd_vel` 폐루프라
배터리와 무관하다.

> 교훈: `tools/power_stress.py` 가 이 오진을 스스로 경고하도록 넣어뒀다
> (아주 낮은 PWM 부터 끊기고 그 뒤 텔레메트리가 안 돌아오면 배터리부터 확인).

---

## 4. ★ 막은 탈락급 결함 — 미션 계획이 대구 값이었다

`config/mission_plan.yaml` 이 대구(184m 코스) 그대로였다. 용인(648m)으로 주행하면
후진주차 트리거 `s_enter=175m` 가 **코스 한복판**에 떨어져 주행 중간에 후진 기동이
시작된다 → 이탈 → **탈락**. 조용히 일어나고 되돌릴 수 없다.

다른 치명 항목(정지점·주차자세)은 런타임 가드가 "안 쓰고 넘어가는" 식으로 안전하게
실패하는데, **미션 계획만은 엉뚱한 위치에서 실제로 동작한다.**

막은 방법 (3중):
1. `mission_sequencer` 가 `/global_path` 수신 즉시 대조 — 코스 길이(±10%)와
   웨이포인트 파일명. 어긋나면 **전 미션 건너뛰고 자율 완주만** 한다.
2. `preflight.py` 에 E 절 추가 — 주행 전에 잡는다.
3. 계획 파일 분리 — `config/mission_plan.yaml`(용인) /
   `config/daegu_2026-08-17/mission_plan.yaml`(보관본).

같이 막은 것:
- **코스 90% 이상을 덮는 배경 기능 거부.** 라이다 조향 회피가 `s 0~9999` 였다 =
  어디서든 조향을 뺏을 수 있다 → 관중·표지물·연석에 반응하면 이탈=탈락.
  (전방 감속·정지는 이것과 무관하게 항상 동작하므로 안전은 안 줄어든다)
- `s` 가 `0~0` 인 채 `enabled` 인 미션, 코스 끝 밖의 `s`.
- `enabled: false` — 현장 s 를 재기 전에는 미션을 못 켠다. **현재 6개 전부 false.**

### 용인 후진주차 s 를 계산으로 확정했다
`~/parking_spur_yongin.yaml`(9/5 기록, 같은 원점계)의 주차 스퍼를 주행 경로에
투영하니 **s = 289.9 ~ 297.4m** 에 이격 0.13m 로 붙는다(스퍼는 경로에서 최대
12.2m 벗어난다 = 주차칸 안쪽). 대구 계획의 175m 가 아니다.
계획 파일에 `s_enter 280 / s_exit 305` 로 적어뒀다. 단 진입 자세
(`parking_pose_N.yaml`)가 아직 대구 값이라 `enabled: false` 유지.

---

## 5. 같이 고친 것

| | |
|---|---|
| `curvature_gain` 런치 인자화 | 8분 예산의 가장 큰 소프트웨어 레버인데 노출이 없었다. 노드가 init 에서 캐시해 `ros2 param set` 으로도 못 바꿨다 — 재빌드해야만 바뀌던 값. control/hil/bringup 3개 런치에 추가 |
| bringup → `max_steer_deg` 전달 | 안 넘겨서 **실차는 늘 18°** 였다. ±18° 는 기구 끝단이라 양방향 스톨이 난다(HIL 은 9/9 에 같은 이유로 이미 고쳤다) |
| `tracking_sim` 정직화 | 가속도 한계(1.0/1.8)와 하드웨어 속도 상한(`--speed-cap`) 반영 |
| `ros_cleanup.sh` | `tools/hil_vehicle.py` 를 실제로 죽인다. 여태 살아남았고(인계문서 기술과 반대), 남은 채로 다시 띄우면 두 대가 같은 odom 에 발행해 결과가 조용히 쓰레기가 된다 |
| `power_stress.py` 포트 결속 | VID:PID(2341:0042)로만 연다. `ttyACM*` 아무거나 폴백은 실제로 **u-blox RTK GPS(ttyACM0)** 에 붙어 모터 명령을 40초간 썼다(UBX 동기바이트가 없어 수신기가 버림). 실차 `serial_bridge` 는 원래 VID/PID 스캔 5회 재시도라 안전하고, 이번 랩에서 폴백 0회 확인 |

### 펌웨어 조향 스톨 — 수정 완료, **플래싱 안 함**
9/9 실측: 스톨 19회 66초 = **랩의 4.0%**, 전부 조향만.
원인은 이길 수 없는 1.1°(29카운트) 잔류오차를 재출발해 쫓다가 컷된 것.

| 상수 | 현재 | 변경 | 이유 |
|---|---|---|---|
| `STEER_DEADBAND` | 16 | **24** | 못 이기는 미세오차를 안 쫓음 (0.92°좌/1.17°우) |
| `STEER_RESUME` | 24 | **32** | 29카운트로는 재출발 안 함 → 관측 케이스 소멸 |
| `STEER_STALL_ERR` | 15 | **24** | ≤ DEADBAND 유지 |
| `STEER_STALL_MS` | 250 | **400** | 부스트가 PWM130 도달 후 240ms 더 시도(현재 90ms) |

⚠ 9/9 문서의 `STALL_ERR 28` 안은 **채택하지 않았다.** 28 이면 오차 25~28 에서
모터는 밀고(24 초과라 settled 아님) 가드는 못 잡아(28 이하) **무한 구동** = 모터를
태운다. 불변식은 `STALL_ERR ≤ DEADBAND` 다.
컴파일 검증 완료(13636바이트). 업로드: `arduino --upload --board arduino:avr:mega arduino/henes_firmware/henes_firmware.ino`

---

## 6. ★ 완주 가능성 — 정직한 판정

완주 = **이탈 없음 + 1분 이상 정지 없음**. 이 둘만 보면 된다.

| 요소 | 상태 | 판단 |
|---|---|---|
| 경로추종 제어 | ✅ 대회속도 HIL 완주, 여유 큼 | **완주를 막지 않는다** |
| 경로 데이터 | ✅ 648.3m 검증, 되꺾임 0, run-up 직선 | 문제없음 |
| 미션 오발동 | ✅ 3중 차단 | 문제없음 |
| **전원** | ❌ **미해결·미측정** | **탈락의 주 경로** |
| **용인 실주행** | ❌ **한 번도 안 했다**(9/5 는 기록만) | **최대 미지수** |
| 조향 하드웨어 | ⚠ 9/9 에 0.8° 추종, 스톨 4% (수정 대기) | 대회속도 미검증 |
| 미션 데이터 | ❌ 전무 | 감점만, 탈락 아님 |

**판정**: "완주만" 이 목표라면 **현재 설계로 충분히 가능하다.** 제어는 오늘 증명됐고,
속도를 욕심내지 않으면(PWM 160 유지) 감점 45~55점을 받고 완주하는 그림이다.
195점 만점이므로 그래도 140점대가 남는다.

다만 전제가 둘이고 **둘 다 아직 데이터가 없다**:
- (a) 주행 중 보드가 리셋되지 않을 것 → 전원 실측·보강
- (b) 용인에서 실제 GPS/헤딩으로 경로를 따라갈 것 → 지상 실주행

이 둘을 확인하기 전에는 "완주 가능"이라고 말할 수 없다. 반대로 **이 둘만 확인되면
나머지는 전부 감점 문제**다.

**우선순위 원칙: 탈락 방지 > 감점 회피.** 시간이 모자라면 미션을 버리고
전원·실주행을 지킬 것.

---

## 7. 남은 5일 계획 (9/12 ~ 9/16, 점검까지 3일 예비)

각 날의 **완료 판정 기준**을 같이 적는다. 못 넘기면 다음 날로 밀지 말고
그 항목에 하루를 더 쓴다 — 뒤 항목은 전부 감점-only 다.

### D1 (9/12) 실내·거치대 — 하드웨어를 루프에 되돌린다
1. **배터리 연결.** 오늘 검증이 막힌 원인.
2. 펌웨어 플래싱 (조향 스톨 4개 상수)
3. 같은 HIL 랩 재주행 → `hil_probe` 로 스톨 4.0% 가 얼마나 줄었는지 전후 비교
4. `python3 tools/power_stress.py` + **멀티미터로 5V 레일 실측 대조**
   (VCC 는 ATmega 내부 밴드갭이라 PWM 노이즈에 오염된다)

> 완료 기준: 랩 중 `serial_bridge` 재연결 **0회**, 스톨 4.0% → 1% 이하,
> 전원이 견디는 PWM 상한을 숫자로 확보.

### D2 (9/13) 전원 보강 — 탈락 위험을 없앤다
굵은 전원선 / 구동·로직 전원 분리 / 별도 레귤레이터.
보강 후 `power_stress` 재측정 → **PWM 상한 확정** → `lap_budget` 으로 감점 확정.

> 완료 기준: 확정한 PWM 에서 8분 연속 구동에 리셋 0회.
> 여기서 나온 PWM 을 `MAX_DRIVE_PWM` 에 반영하고 `max_speed` 를 그 도달속도로 맞출 것
> (어긋나면 곡률 감속이 무력화된다 — §1).

### D3 (9/14) 공터 지상 주행 — 이탈 위험을 잰다
GPS/헤딩 캘리브, FF(PWM→속도) 지상 재식별, 엔코더 생사 확인.
`hil_probe.py` 를 그대로 실차에 쓴다(토픽이 같다).

> 완료 기준: 실차 이탈량 프로파일 확보. HIL 의 0.32m 대비 얼마나 나쁜지 숫자로.
> 직진 이탈 평균이 크면 제어가 아니라 헤딩 오프셋 문제다(`tools/drive_log.py` 판정).

### D4 (9/15) 용인 현장 ① — 없는 데이터를 만든다
- `tools/mission_s.py --live --name <미션>` 으로 미션별 s 측정
- `parking_pose_N` / `parking_exit_N` 재기록 (현재 전부 대구 값)
- `stop_points_yongin.yaml` (현재 파일은 좌표 자체가 쓰레기 — 폐기)
- 라이다 rosbag (S코스·주차칸)

> 완료 기준: `preflight` 치명 5건 → 0건.

### D5 (9/16) 통합 — 미션을 얹는다
계획 파일의 s 를 채우고 `enabled: true`, `tools/test_mission_sequencer.py` 로 순서
확인, **8분 풀런 반복**. 실패하는 미션은 `enabled: false` 로 버린다(감점-only).

> 완료 기준: 풀런 2회 연속 이탈·정지 없이 완주.

### 예비 9/17~9/18
카메라 재학습 모델 도착 시 신호등, 라즈베리파이(192.168.99.8) 무응답, 남은 미션.
**여기서 새 기능을 추가하지 말 것.** 리허설만.

---

## 8. 함정 — 오늘 갱신

9/9 문서의 함정 목록은 그대로 유효하다. 아래는 수정·추가분.

1. ~~`ros_cleanup.sh` 는 `hil_vehicle` 도 죽인다~~ → **틀렸었다.** `install/`·
   `/opt/ros/` 아래만 잡아서 `tools/` 의 것은 살아남았다. 오늘 스크립트를 고쳤다.
2. **`/steering_angle` 은 `Float64` 다.** `Float32` 로 구독하면 타입 불일치로
   **조용히 아무것도 안 온다**(오늘 실제로 걸렸다).
3. **`/goal_reached` 는 래치다.** 완주 후 계속 true 라, 계측을 나중에 켜면 출발도
   전에 "완주"로 보고 끝난다. `hil_probe` 는 10m 전진 전의 신호를 무시한다.
4. **`rclpy` 는 자기 SIGINT 핸들러로 컨텍스트를 먼저 내린다.** 그러면 `spin_once`
   가 `KeyboardInterrupt` 가 아니라 `RCLError` 로 터져서, 그대로 두면 랩을 다
   돌고도 요약과 CSV 를 못 남긴다.
5. **`/dev/ttyACM0` 은 u-blox RTK GPS 다.** 아두이노는 `ttyACM1`.
   포트를 찾을 땐 반드시 VID:PID `2341:0042` 로 확인할 것.
6. 함정 #5(9/9 문서, `nohup A && B && C &`)에 오늘 또 걸렸다. `&` 가 체인 전체에
   걸려 앞의 변수 할당이 서브셸에만 남는다. 로그 경로는 절대경로로 쓸 것.

---

## 9. 도구 (전부 이번에 영구화)

| 도구 | 용도 |
|---|---|
| `tools/lap_budget.py` | PWM → 랩타임 → 8분 초과 감점 결정표. **현장 판단의 기준** |
| `tools/hil_probe.py` | 랩 한 번을 통째로 계측(이탈 프로파일·조향 포화·명령대실제·스톨·VCC·엔코더). 실차에도 그대로 쓴다 |
| `tools/power_stress.py` | 전원계가 무너지는 PWM 을 찾는다. 배터리 미연결 오진을 스스로 경고 |
| `tools/tracking_sim.py` | 오프라인 폐루프 추종 시뮬. 랩 1회 = 21초 |
| `tools/preflight.py` | 주행 전 데이터 검사 + **미션 계획 대조(신규)** |
| `tools/test_mission_sequencer.py` | 시퀀서 로직 6케이스. 픽스처로 분리됨 |
