hanmin0211/racing_ws/HANDOFF_2026-09-09.md

# 인계 — 2026-09-09 (HIL 맵주행 검증 / 8분 예산 판정)

이전 문서: `HANDOFF_2026-09-04.md`, `PROJECT_HANDOVER.md` (배경·아키텍처는 그쪽 참조)
브랜치: `yongin-2026-09-05`  ·  최신 커밋: `ab496e7`

대회: **HL FMA 2026** — 기능점검 9/19, 본경기 9/20, 용인운전면허시험장.
제한시간 8분, 195점 만점 감점제. 탈락은 코스이탈/1분이상정지만.

---

## 0. 한 줄 요약

용인 웨이포인트로 **648.3m 전 구간 HIL 완주에 성공**했다(27.8분, v_max 0.5).
제어 스택은 동작한다. 그런데 **8분 예산이 현재 설정으로는 절대 불가능**하다는 것이
정량적으로 확정됐다. 그리고 조향 스톨이 랩의 4%를 먹고 있다.

---

## 1. 지금 이 순간의 상태 (새 창에서 그대로 이어받으면 됨)

### 돌고 있는 것
```
ros2 launch gps_localization hil.launch.py \
  waypoints:=/home/han/racing_ws/config/yongin_2026-09-05/wp_yongin_drive_0.5.yaml \
  max_speed:=0.5 max_steer_deg:=15
python3 tools/hil_vehicle.py \
  --wp /home/han/racing_ws/config/yongin_2026-09-05/wp_yongin_drive_0.5.yaml --start-idx 0
```
차량은 **경로 끝(s=647.4/648.3m)에 완주 정지 상태**로 서 있다.
다시 돌리려면 `hil_vehicle` 을 재시작해야 한다(그래야 출발점으로 리셋).

### 전부 내리기
```bash
cd ~/racing_ws && bash tools/ros_cleanup.sh
```
⚠ `ros_cleanup.sh` 는 `hil_vehicle` 도 같이 죽인다.

### 장치
| 장치 | 상태 |
|---|---|
| `/dev/arduino` → `ttyACM1` | ✅ 정상 |
| `/dev/imu` → `ttyUSB1` | ✅ 존재 |
| `/dev/ldlidar` | ❌ **없음** (라이다 미연결) |
| 라즈베리파이 192.168.99.8 | ❌ **무응답** (미해결) |

---

## 2. 오늘(9/9) 고친 것 — 커밋 `ab496e7`

### 2-1. ★ 런치 인자 타입 — 차가 안 굴러간 진짜 원인

**증상**: HIL 에서 바퀴가 안 굴렀다. `/curvature`·`/local_path`·`/steering_cmd`·
`/target_speed` 는 전부 정상인데 `/cmd_vel` 만 끊겼다. `ros2 node list` 로는
노드가 다 떠 있는 것처럼 보였다(**ros2 데몬 캐시 때문에 죽은 노드도 목록에 남는다**).

**원인**:
```
InvalidParameterTypeException: Trying to set parameter 'max_steer_deg'
to '15' of type 'INTEGER', expecting type 'DOUBLE'
```
`max_steer_deg:=15` 처럼 소수점 없이 주면 `launch_ros` 가 YAML 로 INTEGER 로
추론한다. 노드는 `declare_parameter('max_steer_deg', 18.0)` 로 DOUBLE 을 기대해
**기동 0.7초 만에 exit 1**. 이 파라미터를 받는 노드가 `vehicle_cmd_mux` 와
`serial_bridge` 딱 둘이라, 명령을 합쳐 아두이노로 보낼 주체만 정확히 사라졌다.
`max_speed:=0.5` 는 소수점이 있어 통과했기 때문에 나머지는 멀쩡했다.

**조치**: `ParameterValue(..., value_type=float)` 로 감쌌다.
| 파일 | 막은 인자 |
|---|---|
| `src/pure_pursuit_pkg/launch/control.launch.py` | `max_speed`, `max_steer_deg` |
| `src/gps_localization/launch/bringup.launch.py` | `calib_distance`, `auto_calib_speed` |
| `src/velocity_controller/launch/steering_demo.launch.py` | `amplitude`, `half_period`, `loop` |

(`crosswalk_*` / `sudden_stop_dwell` 은 이미 적용돼 있었다)

**검증**: 정수 `15` 를 그대로 넣고 재기동 → 9개 노드 전원 생존, `died` 0건,
두 노드의 `max_steer_deg` = `15.0 (DOUBLE)`, `/cmd_vel` 20Hz 복구, 실제 바퀴 구동.

### 2-2. `hil.launch.py` 가 `max_steer_deg` 를 안 넘겨줬다
여태 HIL 은 항상 18° 고정이라 기구 끝단을 때려 양방향 스톨이 났다.
인자 선언 + `control.launch.py` 로 전달하도록 고쳤다.

### 2-3. `/vehicle_stall` 이 안 풀리던 문제 (`serial_bridge_node.py`)
펌웨어는 스톨일 때만 `STALL:` 줄을 내고 **해제 메시지를 안 보낸다.**
`stall_clear_timeout`(0.5s) 동안 갱신이 없으면 False 를 발행하도록 타이머를 넣었다.
→ 로그에 `스톨 해제 (0.5s 간 STALL 없음)` 가 찍히는 것으로 동작 확인됨.

### 2-4. 펌웨어 주석 — `MAX_DRIVE_PWM` 160 유지 근거 + 단서
근거로 쓴 VCC 값이 ATmega 내부 밴드갭 자가측정이라 PWM 노이즈에 오염될 수 있다는
단서를 명시했다(조향 −18°에서 무부하 4121mV 보다 높은 5115mV 가 나온 물리적으로
불가능한 샘플 존재). **상향 판단은 멀티미터 실측 후.**

---

## 3. ★★ 최우선 미해결 — 8분 예산이 성립하지 않는다

### 근거 (모델이 실측과 오차 0.2%)
648.3m 전 구간 HIL 완주 **실측 1670초** vs 모델 예측 **1673초**.
곡률 추정 창 크기를 2~12로 바꿔도 1673~1684초라 결과가 튼튼하다.

종방향 법칙: `v = v_max / (1 + curvature_gain·|κ|)`, 하한 `v_min`
(`longitudinal_controller_node.py`, 기본 `curvature_gain=6.0`, `v_min=0.25`)

### 결론
| PWM | v_max[m/s] | 랩타임 | 8분 대비 |
|---|---|---|---|
| **160 (현재)** | 0.84 | **16.8분** | **2.11배 초과** |
| 213 | 1.40 | 10.1분 | 1.26배 |
| 244 | 1.73 | 8.2분 | 1.02배 |
| **255 (물리상한)** | 1.84 | **7.7분** | 0.96배 |

**PWM 을 물리 상한까지 올려도 주행만 7.7분**, 8분까지 여유 19초.
`config/mission_plan.yaml` 의 `expected_s` 합만 해도 crosswalk 12 + 후진주차 45 +
급정지 12 + 경사로 12 + 신호교차로 20 + S코스 20 = **121초**이고,
직각주차·평행주차는 아직 추정치조차 없다.

### 남은 레버 — `curvature_gain` 이 과도하게 보수적
현재 `gain=6.0` 에서 최대 횡가속도가 **0.14 m/s²** 다(소형차 안전역 2~3 m/s²).
| gain | v_max 1.84 랩타임 | 커브 최저속도 | 최대 횡가속도 |
|---|---|---|---|
| 6.0 (현재) | 7.7분 | 0.68 m/s | 0.14 m/s² |
| 4.0 | 7.1분 | 0.86 m/s | 0.21 m/s² |
| **3.0** | **6.8분** | 1.00 m/s | 0.28 m/s² |
| 2.0 | 6.5분 | 1.18 m/s | 0.39 m/s² |

`gain=3.0` + `v_max=1.84` 면 6.8분 → 미션에 **72초** 남는다. 이것이 현재로선
유일하게 8분이 성립하는 조합이다.

### 그래서 다음 세션에서 반드시 할 것
1. **v_max 1.84 로 전 구간 이탈량 기록하며 HIL 재주행** — 대회 속도에서 경로추종이
   버티는지, 조향이 포화하는지 확인. HIL 가상차량은 `/cmd_vel` 을 그대로 따르므로
   실제 모터가 PWM 160 에 걸려도 **제어 검증은 유효**하다.
2. 통과하면 `curvature_gain` 3.0 으로 낮춰 재시험.
3. 그 다음에야 `MAX_DRIVE_PWM` 상향을 논한다 — **전원계 선결 조건이 있다(§5).**

---

## 4. ★ 조향 스톨 — 랩의 4%

### 실측 (648.3m 완주 랩 전체)
| | |
|---|---|
| 에피소드 | **19회** |
| 총 조향 컷 시간 | **66초 (랩의 4.0%)** |
| 평균/최장 지속 | 3.5초 / 3.7초 |
| 형태 | `STALL: drive=0 steer=1` — **구동 정상, 조향만** |

### 원인 (상수 불일치, `arduino/henes_firmware/henes_firmware.ino`)
```
STEER_DEADBAND   16 카운트 (~0.6°)  ← 이 이내여야 모터 정지 (line 234)
STEER_RESUME     24 카운트 (~0.9°)  ← 이 이상 벌어져야 재출발 (line 235)
STEER_STALL_ERR  15 카운트          ← 스톨 판정 오차 임계 (line 267)
STEER_STALL_MS   250ms              ← 판정 지속시간 (line 268)
STEER_MIN_MOVE   34 / BOOST_STEP +6per10ms → 160ms 에 PWM 130(최대) 도달
```
**판정 임계(15)가 데드밴드(16)보다 작다.** 컨트롤러가 미는 동안은 오차가 항상
16 초과이므로 스톨 판정 3조건 중 세 번째가 **언제나 참**이다. 여유가 0.

### 실제로 잡은 순간 (3초 링버퍼 캡처)
```
 t[s]   명령[°]  실제[°]   ADC   오차[°]  VCC[mV]
-2.56    -7.3    -7.6     243     0.9     4979
-2.46    -7.3    -7.5     257     0.2     4935   ← 도달, settled, 모터 정지
-1.25    -6.4    -7.5     257     1.1     4935   ← 명령이 1.1° 되돌아옴 → 재출발
 ...                      257     1.1              2.5초간 ADC 미동
 0.00    -6.4    -7.5     257     1.1     4957   ← 스톨 판정
```
**끝단 아님**(ADC 257 은 좌측최대 0 에서 한참 안쪽), **전압 문제 아님**(4935mV 정상),
**센서 고장 아님**(같은 캡처에서 ADC 224→257 정상 통과).
오차 29카운트(1.1°)를 부스트가 PWM 130 까지 올리고도 못 이긴 정지마찰이다.

### 제안한 수정 (아직 **미적용** — 재플래싱 필요)
| 상수 | 현재 | 제안 | 이유 |
|---|---|---|---|
| `STEER_DEADBAND` | 16 | **24** (0.9°) | 못 이기는 미세오차를 안 쫓음 |
| `STEER_RESUME` | 24 | **32** (1.2°) | 1.1° 잔류오차로 재출발 안 함 → 관측 케이스 소멸 |
| `STEER_STALL_ERR` | 15 | **28** | RESUME **아래**로 유지 → 진짜 잠김은 여전히 컷 |
| `STEER_STALL_MS` | 250 | **400** | 부스트가 130 도달 후 240ms 더 시도(현재 90ms) |

설계 불변식: `STALL_ERR < RESUME` 이어야 "모터가 영원히 싸우는데 가드가 못 잡는
구간"이 안 생긴다. 이 값들은 그 조건을 만족한다.
정상 추종엔 영향 없고 조향 정상상태 오차만 0.9°→1.2° 로 커진다
(현재 실측 추종오차가 이미 0.8° 수준).

**검증 방법**: 플래싱 후 같은 랩을 돌려 스톨 4.0% 가 얼마나 줄었는지 전후 비교.

---

## 5. 전원 — VMIN 이 여전히 나쁘다

완주 랩 중 VMIN 경고 **678건**:
| | |
|---|---|
| 최빈값 | 4230mV |
| 3500mV 미만 | 89건 |
| 3000mV 미만 | 11건 |
| **최저** | **2580mV** |

**바퀴를 든 무부하인데도 이렇다.** 지면에서는 조향·구동 부하가 더 크다.
과거 리셋 발생선이 3483mV 였다.

⚠ 단, 이 값은 ATmega 내부 밴드갭 자가측정이라 PWM 노이즈 오염 가능성이 있다
(§2-4). **멀티미터 실측 전에는 `MAX_DRIVE_PWM` 을 올리지 말 것.**
그런데 §3 대로 8분을 맞추려면 PWM 255 가 필요하다 → **전원계 보강이 대회 성패의
갈림길이다**(굵은 전원선 / 별도 레귤레이터 / 구동·로직 전원 분리).

---

## 6. 데이터 파일 상태 — ★ 주차·정지점이 전부 대구 데이터다

`python3 tools/preflight.py --waypoints config/yongin_2026-09-05/wp_yongin_drive_0.5.yaml`
결과 **치명 5건**:

| 파일 | 상태 |
|---|---|
| `config/site_origin.yaml` | ✅ 용인 (332200.0, 4128600.0), EPSG 32652 |
| `config/yongin_2026-09-05/wp_yongin_drive_0.5.yaml` | ✅ 용인, 1298점 648.3m, 원점 일치 |
| `~/parking_pose_1,2,3.yaml` | ❌ **대구** (477800/3964400, 8/24 기록) — 219.5km 차이 |
| `~/parking_1,2,3.yaml` | ❌ **대구** (위 pose 에서 생성) |
| `~/stop_points.yaml` | ❌ **대구 원점 + 좌표 자체가 쓰레기** — 경로에서 149.7km |
| `~/parking_spur_yongin.yaml` | ✅ 용인 (9/5, wp idx 582-700 에서 추출) |
| `config/mission_plan.yaml` | ❌ **s 값이 전부 대구 자리표시자**, `course.site` 도 대구 |

### 경로 자체의 주의점
```
최소R 2.71m (idx1236) → 기하학적 필요타각 16.2° / 상한 18°
빠듯한 커브 19개 (R<3.5m)
헤딩 캘리브 run-up: 시작 10m 직선 확인 ✅ (최대편차 3.2°, 이탈 0.08m)
```
⚠ **필요타각 16.2° 인데 이번 랩은 `max_steer_deg:=15` 로 돌렸다.**
그런데도 완주했고 최종 이탈 0.04m 였다(퓨어퍼슛 lookahead 가 완화). 다만
**전 구간 이탈량을 연속 기록하진 않았고 구간 스팟 측정만 했다.**
idx1236 부근에서 실제로 포화하는지는 **다음 랩에서 확인해야 한다.**

---

## 7. 다음 세션 작업 순서 (권장)

### A. 조향 스톨 펌웨어 수정 → 플래싱 (먼저)
어차피 스택을 내려야 하고, 고친 상태로 고속 랩을 돌면 스톨 개선까지 같은 주행에서
확인된다.
```bash
cd ~/racing_ws && bash tools/ros_cleanup.sh     # /dev/arduino 를 놓아준다
# henes_firmware.ino 에서 §4 표의 4개 상수 수정 후 아두이노 IDE 로 업로드
```

### B. 대회 속도 HIL 랩 (전 구간 기록)
```bash
cd ~/racing_ws && source install/setup.bash
ros2 launch gps_localization hil.launch.py \
  waypoints:=/home/han/racing_ws/config/yongin_2026-09-05/wp_yongin_drive_0.5.yaml \
  max_speed:=1.84 max_steer_deg:=18.0
# 다른 터미널
python3 tools/hil_vehicle.py \
  --wp /home/han/racing_ws/config/yongin_2026-09-05/wp_yongin_drive_0.5.yaml --start-idx 0
```
측정할 것: 전 구간 이탈량 프로파일 / 조향 포화 비율 / 스톨 횟수 / 랩타임(예측 7.7분).
그 다음 `curvature_gain` 3.0 으로 낮춰 재시험(예측 6.8분).

### C. 용인 현장 데이터 재기록 (현장 필요)
- `parking_pose_N.yaml`, `parking_exit_N.yaml` — 용인 주차칸
- `stop_points.yaml` — 정지선(현재 파일은 폐기할 것)
- 라이다 rosbag — S코스/돌발 구간
- `config/mission_plan.yaml` 의 s 값:
  `python3 tools/mission_s.py --waypoints <용인파일> --live --name <미션명>`
- ⚠ `lidar_avoid` 의 s 범위가 현재 **0~9999(코스 전체)** 다. S코스 구간으로 좁히지
  않으면 관중·표지물·연석에 반응해 조향을 뺏겨 **이탈=탈락**이 된다.

### D. 그 외 미해결
- 라즈베리파이 192.168.99.8 무응답 (dnsmasq 는 돌고 링크는 UP)
- 카메라: YOLOv8s 3-class 가 신호등 판정에 불안정(빨강 confidence 0.402/0.333/
  0.008/0.058/0.456 — 양자화가 아니라 **학습 데이터 문제, 재학습 필요**).
  KNUT 에 한국형 가로형 신호등 재학습 요청.
- 멀티미터로 VCC 실측 → `MAX_DRIVE_PWM` 판단

---

## 8. ★ 함정 모음 — 작은 것들 (이거 때문에 오늘 시간을 많이 썼다)

1. **`colcon build` 전에 반드시 `source /opt/ros/humble/setup.bash`.**
   언더레이 없이 빌드하면 `install/setup.sh` 의 프리픽스 체인이 날아가서
   그 뒤로 `ros2` 명령 전체가 `PackageNotFoundError: ros2cli` 로 죽는다.
   복구는 언더레이를 소싱한 셸에서 다시 빌드하면 된다.
   (이것 때문에 Ubuntu apport 크래시 팝업이 떴다.
   `sudo rm -f /var/crash/_opt_ros_humble_bin_ros2.1000.crash` 로 정리)

2. **`ros2 node list` 는 죽은 노드도 보여준다** (데몬 캐시).
   실제 생존 확인은 `ps` 나 `ros2 topic info <토픽> -v` 의 Publisher count 로.

3. **`/cmd_vel` 의 `angular.z` 는 rad/s 가 아니라 조향각[도]다**
   (`vehicle_cmd_mux_node.py:18`). 좌 +, 우 −.

4. **`tools/hil_vehicle.py` 의 기본 웨이포인트는 대구 파일이다.**
   `--wp` 를 빠뜨리면 차가 경로에서 60m 떨어진 곳에서 제자리 선회한다.

5. **`nohup A && B && C &` 는 `&` 가 체인 전체에 걸린다.**
   앞의 변수 할당이 서브셸에서만 유효해져 로그 경로가 깨진다.

6. **`ps aux | grep hil_vehicle` 은 자기 셸도 잡는다.**
   `awk '/pattern/ && !/awk/'` 나 `pgrep -f` 를 쓸 것.

7. **numpy 는 1.23.5 로 고정.** 2.x 는 `np.maximum_sctype` 제거로
   transforms3d → tf_transformations → direct_localization 이 죽는다.
   `ml_dtypes==0.5.4` 도 onnx 때문에 필요하다.

8. **`ros_cleanup.sh` 는 `hil_vehicle` 도 죽인다.** HIL 재시작 시 둘 다 다시 띄울 것.

9. **`hil_vehicle` 을 두 번 띄우면** 두 대가 같은 `/odometry/filtered` 에
   발행해서 결과가 쓰레기가 된다. 시작 전 `pgrep -f hil_vehicle.py` 확인.

10. **완주 후에는 `hil_vehicle` 을 재시작해야** 출발점으로 리셋된다.

---

## 9. 재현용 측정 스크립트

이번에 쓴 임시 프로브는 스크래치패드에 있고 세션과 함께 사라진다. 필요하면 다시
작성할 것 — 핵심은 세 가지다.
- **추종 품질**: `/odometry/filtered` 를 웨이포인트 배열에 최근접 투영해 이탈량과
  진행거리 s 를 뽑는다.
- **조향 검증**: `/cmd_vel`(명령[도]) vs `/steering_angle`(실제[도]) vs
  `/steering_adc`(원시) 를 같이 본다. ADC 가 같이 움직여야 진짜 꺾이는 것이다.
- **스톨 분석**: `/vehicle_stall` 상승엣지에서 직전 3초 링버퍼를 덤프한다.
  로그 쪽은 `grep '펌웨어 스톨 감지\|스톨 해제'` 로 에피소드와 지속시간을 센다.

랩타임 모델(§3)은 웨이포인트에서 Menger 곡률(창 W=6)을 구해
`v = v_max/(1+gain·κ)` 로 `Σ ds/v` 를 적분한 것이다. 실측과 0.2% 로 맞았다.
