hanmin0211/racing_ws/HANDOFF_2026-08-22.md

> ⚠️ **최신본은 `HANDOFF_2026-08-25.md` 다. 그것을 먼저 볼 것.**
> 이 문서는 08-22 시점 기록으로만 참고.

# HANDOFF (최신) — 2026-08-22 세션 인수인계

> **이 문서가 현재 상태의 최신본이다.** 08-20 문서(`HANDOFF_2026-08-20.md`)는 배경용이며,
> 값이 충돌하면 **이 문서와 실제 코드**를 따를 것.
> 08-20 문서의 "엔코더 신호 없음 / ms2405" 관련 내용은 **보드 교체로 해결됨**.
>
> 원칙: **예측하지 말고 측정값으로 진행할 것**(사용자 강력 요구).

---

## 0. 지금 당장 할 것

**실차 저속 1바퀴 예행.** 오늘 바꾼 것이 많아(보드·조향 스케일·경로·PWM) **현재 구성은 실차 미검증**이다.

```bash
bash tools/ros_cleanup.sh
# 터미널1 — 주행
ros2 launch gps_localization bringup.launch.py control:=true auto_calib:=true rviz:=false max_speed:=1.0 calib_distance:=10.0
# 터미널2 — 로그 (★ 반드시 같이 켤 것. 이거 없으면 이번 주행도 '느낌'으로 끝난다)
python3 tools/drive_log.py
```

확인할 것:
1. **헤딩 캘리브 통과** (10m 직진). 실패하면 자동 재시도 3회.
2. **커브에서 이탈이 개선됐는지** — 오늘 두 가지를 고쳤다(아래 2절).
3. **직진에서 여전히 차선을 밟는지** — 이게 유일한 미해결 문제다.
4. **VMIN** 이 얼마까지 떨어지는지 (PWM 160 에서의 여유 확인).

> ⚠ serial_bridge 의 `공급전압 강하 VMIN=3893mV` 경고는 **무시해도 된다**(4300mV 기준이라
> 이 차엔 과한 경고). 3.9~4.1V 가 이 차의 정상대다. 자세한 이유는 4절.

---

## 1. 현재 확정 설정 (전부 실측 검증됨)

### 펌웨어 (arduino/henes_firmware/henes_firmware.ino)
| 항목 | 값 | 근거 |
|---|---|---|
| `Steering_Sensor` | **A15** | 이 보드로 조향 검증 통과(오차 0.92°) |
| 조향 캘리브 | **center 412 / 0~936** | 좌936·중앙412·우0 각 80~100샘플 실측 |
| 조향 스케일 | **좌 26.2 / 우 20.6** counts/도 | 방향별 분리(2절 참고) |
| 엔코더 | **SPI 카운터 CS 22/23** | MDR0 write/read-back 확인 |
| `NO_ENCODER` | **0** (폐루프 정상) | 엔코더 살아있음 |
| `MAX_DRIVE_PWM` | **160** | 전압여유 확보(111 완주실적 / 190 리셋이력 사이) |
| `counts_per_revolution` | -290 | 부호는 모터 전진으로 검증. 크기는 encoder_calib 로 정밀보정 예정 |
| FF / PID | STATIC_FF 80, GAIN 95 / kp30 ki15 kd0.5 | 기존값 유지 |

### 경로
`waypoints_recorded_resampled_0.5.yaml` = **스무딩본**(378점, 최소R 2.68m).
원본은 `waypoints_recorded.yaml`(345점) 로 보존. `.bak` 백업도 있음.

### 검증 완료된 것
- 조향 양방향 ±18° 에서 오차 **0.9° 이내**, 좌우 차이 0.2°
- 엔코더 SPI 정상, 전진 시 감소(부호 음수 맞음), 속도 폐루프 수렴
- **HIL 맵주행 완주 2회**(스무딩 전/후). 조향 -11°~+9° 사용, 포화 0회

---

## 2. 오늘 해결한 것

### ① 엔코더 부활 — 보드 교체가 답이었다
ms2405 계열 보드 2개에는 **SPI 카운터 IC(LS7366R)가 없다**(전 핀·전 버스 스캔으로 확인).
amap 계열 보드로 바꾸니 CS22/23 에서 카운터가 응답하며 즉시 살아났다.
- ms2405 는 **RC 조종기용** 보드다(D17 에 115200 으로 "Frame Lost or FailSafe" 를 계속 보냄).
- 보드마다 **조향센서 핀도 다르다**: ms2405=A8, amap 계열=A15.

### ② 조향 좌우 비대칭 → 커브 이탈
좌우 기울기가 실제로 다른데(좌 26.2 / 우 20.6) **작은 값 하나로 통일**해 쓰고 있었다.
그래서 **좌회전이 명령의 78% 만 꺾여**(18° → 실제 14°) 좌코너마다 밖으로 밀렸다.
→ 방향별 스케일로 분리. 검증 결과 좌우 차이 0.2° 로 대칭 확보.

### ③ 경로에 물리적으로 못 도는 커브 → 커브 이탈
최대 타각 18°(최소반경 2.42m)인데 경로에 R=1.73m, 1.91m 커브가 있었다.
**제어가 완벽해도 반드시 이탈하는 구간**이다.
→ `tools/smooth_path.py` 로 스무딩. 최소R 1.73→**2.68m**, 못 도는 구간 **0개**.
평균 이동 0.09m(최대 0.46m)라 대부분 구간은 원 경로 그대로다.

> ※ 리샘플 간격을 0.5→0.3m 로 줄이는 것은 **역효과**다(못 도는 커브 2→25개).
> 간격을 줄이면 경로가 급해지는 게 아니라 GPS 기록 노이즈가 곡률로 드러난다.

---

## 3. 남은 문제 (미해결)

**직진 구간에서 차선을 밟는다.** 커브 쪽은 오늘 두 개를 잡았지만 이건 원인 미상이다.
조향이 아니라 **위치 추정 쪽**으로 추정된다:
- 헤딩 캘리브 품질(오프셋 오차)
- GPS RTK fix 상태(Float/Single 이면 오차 수십cm~m)

**실차 로그 없이는 추측이다.** → 그래서 `tools/drive_log.py` 를 만들었다(2026-08-22).
주행과 같이 켜두고 Ctrl-C 하면 CSV(`logs/drive_*.csv`)와 함께 판정을 찍어준다.

셋을 한 주행에서 동시에 재고, **원인을 갈라준다**:
- 횡오차를 **직진/커브로 나눠** 집계 (곡률 R>20m 를 직진으로 본다)
- **편향이냐 진동이냐** — 직진 횡오차의 *부호 있는 평균*이 표준편차보다 크면
  한쪽으로 일정하게 치우쳐 달린 것이다 → 제어가 아니라 위치추정 문제.
  0 주위로 오가면(평균≈0, 표준편차 큼) 제어 튜닝(lookahead/게인) 문제.
- **yaw_offset 검증** — 보고된 yaw 와 *궤적에서 계산한 실제 주행방향*의 차이.
  헤딩 캘리브가 δ 만큼 틀리면 직진에서 일정한 횡편차로 나타난다.
- **RTK 품질** — `/ubx_nav_hp_pos_llh` 의 h_acc 로 FIX/FLOAT/SINGLE 을 나누고
  등급별 횡오차를 따로 집계한다. Fixed 가 90% 미만이면 GPS부터 잡아야 한다.

> 검증: 편향 0.30m + 헤딩오차 2° 를 주입한 가짜 주행에서 그대로 복원했다.
> 판정 기준은 tools/drive_log.py 상단 주석에 있다.

---

## 4. 하드웨어 함정 (필수)

### ★ 보드가 여러 개이고 개체마다 다르다 — 교체하면 반드시 재측정
| 보드 | 조향센서 | 엔코더 | VCC |
|---|---|---|---|
| ms2405 #1 / #2 | A8 | ❌ 카운터 없음 | 4630~5068 / 4708~4728mV |
| **amap 계열(현재)** | **A15** | **✅ SPI 카운터 CS22/23** | 3.9~4.1V |

교체 시 절차:
1. `arduino/board_id/board_id.ino` 플래시 → 앞바퀴 돌리며 조향핀·카운터·VCC 동시 판별
   ※ 단, **판별기 출력보다 실제 동작 실적이 우선**이다(오늘 판별기가 A8 로 잘못 판정했다).
2. `arduino/adc_scan/adc_scan.ino` 로 조향핀 확인 → 좌/중/우 재측정 → 캘리브 갱신
3. `arduino/enc_scan/enc_scan.ino` 로 SPI 카운터 확인
4. **조향 극성 재검증**: 데드밴드 밖 각도를 명령해 ADC 가 목표 방향으로 가는지 확인
   (0° 명령은 데드밴드에 걸려 PWM 0 이라 판정 불가)

### ★ VCC 3.9~4.1V 는 이 차의 정상대다
완주하던 시절에도 4018mV 였다. ATmega2560 의 BOD 는 퓨즈 설정값(메가는 보통 2.7V)이라
3.9V 에서도 정상 동작한다. **단 여유가 적다** — PWM 190 에서 부하 시 3483mV 까지 떨어져
랩 종반에 리셋된 이력이 있다. 속도 상향은 VMIN 을 보며 단계적으로.

### 기타
- 아두이노 로직 전원 = 노트북 USB. 드라이버보드가 5V 를 끌면 전압이 내려간다(정상 범위 내).
- IMU·라이다 둘 다 CP2102 → udev 로 구분(`/dev/imu`, `/dev/ldlidar`).
- **numpy 1.23.5 고정 필수**(tf_transformations + sklearn).
- 공중(무부하) 테스트는 전원강하·부하 특성이 재현되지 않는다.
- 엔코더 부호는 **손으로 굴려 판단하지 말 것** — 방향을 착각하기 쉽다.
  반드시 모터로 전진 구동(개루프 `PWM:`)해서 확인한다.

---

## 5. 자주 쓰는 명령

```bash
# 펌웨어 플래시
cd ~/racing_ws && arduino --upload --board arduino:avr:mega:cpu=atmega2560 --port /dev/arduino arduino/henes_firmware/henes_firmware.ino

# 실차 주행(저속)
bash tools/ros_cleanup.sh
ros2 launch gps_localization bringup.launch.py control:=true auto_calib:=true rviz:=false max_speed:=1.0 calib_distance:=10.0
python3 tools/lap_timer.py                   # 랩타임
python3 tools/drive_log.py                   # 추종 로그 + 원인 판정 (CSV: logs/)
python3 tools/drive_log.py --replay logs/drive_XXXX.csv   # 저장된 로그 재분석

# HIL(공중 맵주행) — 바퀴 공중에!  ※ 반드시 ROS 기본 환경부터 source
source /opt/ros/humble/setup.bash && source install/setup.bash
ros2 launch gps_localization hil.launch.py max_speed:=1.0   # 터미널1
python3 tools/hil_vehicle.py                                # 터미널2 (이거 없으면 '경로 대기중')
rviz2 -d tools/hil.rviz                                     # 터미널3(선택)

# 경로 스무딩(곡률 확인만 하려면 --write 없이)
python3 tools/smooth_path.py --alpha 0.10 --beta 0.50 --max-dev 0.50 --target-r 2.42 --write

# 보드 판별 / 조향핀 / 엔코더 카운터
arduino --upload ... arduino/board_id/board_id.ino
arduino --upload ... arduino/adc_scan/adc_scan.ino
arduino --upload ... arduino/enc_scan/enc_scan.ino

colcon build && source install/setup.bash
```

> ⚠ `tools/ros_cleanup.sh` 는 프로세스를 광범위하게 kill 한다. 자동화 스크립트 안에서
> 호출하면 자기 셸까지 죽을 수 있다(오늘 겪음).

---

## 6. 미션 상태

| 미션 | 상태 |
|---|---|
| 기본 완주 | HIL 완주 2회. **실차 재검증 필요**(현 구성 미검증) |
| 직진 차선밟기 | 원인 미상. 판정 도구(`tools/drive_log.py`) 준비 완료 — 다음 주행에서 측정 |
| 10km/h | FF 기준 PWM 344 필요 → 255 로도 불가. 원차 설계속도 약 1.4m/s(5km/h) 로 보임 |
| 라이다 회피 | 검출 실HW검증. 조향융합 실트랙 튜닝 남음 |
| 카메라 정지 | 인프라(파이+Hailo) 존재, 통합 미실시 |

### 속도 참고 (FF: PWM = 80 + 95·v)
| MAX_DRIVE_PWM | 최대 속도 |
|---|---|
| **160 (현재)** | 0.84 m/s ≈ **3.0 km/h** |
| 190 | 1.16 m/s ≈ 4.2 km/h |
| 255 | 1.84 m/s ≈ 6.6 km/h |

---

## 7. 참고

- 08-20 인수인계: `HANDOFF_2026-08-20.md` (ms2405 시절 진단 기록)
- 08-17 인수인계: `HANDOFF.md` (배경)
- 메모리: `~/.claude/projects/-home-han-racing-ws/memory/`
- 슬라롬 회피 스코프: https://claude.ai/code/artifact/dafe9492-365d-4df6-a3e5-3e78a65667c8
- 실차 테스트 종합집: https://claude.ai/code/artifact/9292b353-46a3-41b3-b32f-d84e66c4f403

---
**다음 세션에게: 실차 주행을 할 때 `tools/drive_log.py` 를 반드시 같이 켤 것.
로그 없이 한 주행은 직진 차선밟기에 대해 아무것도 알려주지 않는다.**

**한 줄: 보드 교체로 엔코더가 살아났고(SPI 카운터), 조향 좌우 비대칭과 못 도는 급커브를
잡아 커브 이탈을 해결했다. HIL 완주 2회. 남은 건 직진 구간 차선 밟기(위치추정 의심,
실차 로그 필요)와 실차 재검증. 다음 = 저속 1바퀴 예행. 예측 말고 측정으로.**
