hanmin0211/racing_ws/HANDOFF_2026-08-25.md

# HANDOFF — 2026-08-25 (대회 D-Day)

> **이 문서가 최신본이다.** `HANDOFF_2026-08-22.md`, `PLAN_후진주차.md` 는 배경용.
> 값이 충돌하면 **이 문서와 실제 코드**를 따를 것.
> 원칙: **예측 말고 측정. 완주 코드(pure_pursuit)는 건드리지 않는다.**

---

## 0. 지금 당장 할 것 (순서 고정)

### ① IMU 물리 연결 ★최우선 — 이게 어젯밤 사고의 진짜 원인
```bash
ls -l /dev/imu && lsusb | grep 10c4
```
**둘 다 안 나오면 IMU 가 안 꽂힌 것이다.** 꽂고 나서 아래로.

### ② 배터리 충전 확인
```bash
ros2 topic echo /vcc_min_mv --once     # 3800mV 이상이어야 진행
```

### ③ 정상 주행
```bash
cd ~/racing_ws && bash tools/ros_cleanup.sh && source install/setup.bash
ros2 launch gps_localization bringup.launch.py \
    control:=true auto_calib:=true rviz:=false max_speed:=1.0 \
    crosswalk:=true parking:=true parking_slot:=3
```
```bash
# 터미널2 — 로그 (반드시 같이)
cd ~/racing_ws && source install/setup.bash && python3 tools/drive_log.py
```

---

## 1. ★ 어젯밤 연석 충돌 — 원인 확정 (2026-08-25 조사)

**IMU 노드가 최근 8개 런 전부에서 기동 직후 죽었다.**

```
로그 확인 결과 (~/.ros/log/*/launch.log):
  21-02-12  기동 1 / 사망 1   ❌
  21-40-04  기동 1 / 사망 1   ❌
  21-45-50  기동 1 / 사망 1   ❌
  21-47-15  기동 1 / 사망 1   ❌
  21-49-19  기동 1 / 사망 1   ❌
  21-53-02  기동 1 / 사망 1   ❌  ← 연석 충돌 런
  22-28-34  기동 1 / 사망 1   ❌
  22-29-03  기동 1 / 사망 1   ❌

[ERROR] hfi_a9_ros2: process has died, exit code 1

현재 상태: /dev/imu 없음, lsusb 에 CP2102(10c4) 미검출
```

**즉 IMU 가 USB 에 물리적으로 연결되지 않은 채 주행했다.**
- IMU 없음 → 방위각 없음 → 10m 직진 캘리브가 정상 완료될 수 없다
- "IMU 10m 주행 안 되고 우측으로 쏠려 연석 충돌" 의 직접 원인
- 앞서 분석한 'GPS 점프' 는 그 위에 겹친 2차 요인이다

**⚠ 매 주행 전 `ls -l /dev/imu` 를 반드시 확인할 것.**
IMU·라이다 둘 다 CP2102 라 udev 시리얼로 구분한다. 라이다만 꽂아도 `/dev/imu` 는 안 생긴다.

---

## 2. ★ 빌드 함정 — 어제 여러 문제의 공통 원인 (해소됨)

`--symlink-install` 을 써도 **`build/` 에는 복사본이 들어간다.**
소스만 고치고 `colcon build` 를 안 하면 **옛 코드가 그대로 돈다.**

2026-08-25 검사에서 실제로 발견:

| 파일 | 소스 | 빌드본 | 상태 |
|---|---|---|---|
| `heading_init_node.py` | 825줄 (게이트 5개) | 577줄 (게이트 **0개**) | ❌ 안전장치 미작동 |
| `bringup.launch.py` | crosswalk_bias 있음 | 없음 | ❌ |
| `waypoints_recorded_resampled_0.5.yaml` | 370점 | 옛 버전 | ❌ |

→ **전체 재빌드 완료. 현재 소스 = 빌드본 = install 일치 확인됨.**

**소스 고쳤으면 반드시:**
```bash
cd ~/racing_ws && source /opt/ros/humble/setup.bash && colcon build
```
검증 (불일치 있으면 파일명이 찍힌다):
```bash
for f in heading_init_node parking_node crosswalk_stop_node; do
  s=$(find src -name "$f.py" -not -path "*/build/*" -not -path "*/install/*" | head -1)
  i=$(find install -name "$f.py" -path "*site-packages*" | head -1)
  diff -q "$s" "$i" >/dev/null 2>&1 && echo "✅ $f" || echo "❌ $f 재빌드 필요"
done
```

---

## 3. 헤딩 캘리브 안전 게이트 (다른 세션 작업, 빌드 반영 완료)

`src/gps_heading_init/gps_heading_init/heading_init_node.py` (+253/-5)

**배경**: 21:53 사고 때 차가 서 있는 동안 0.38초에 7.3m 튀었다(단독측위→RTK Fixed 스냅).
그 점프 벡터를 진행방향으로 믿고 `yaw_offset=-155.8°` 를 확정 → 헤딩 틀어진 채 AUTO.

| 게이트 | 파라미터 | 동작 |
|---|---|---|
| ① | `require_rtk` (기본 ON) | RTK 수렴(σ≤5cm) 전엔 시작점도 안 잡음 |
| ② | `max_jump_speed` 2.0 m/s | 불가능한 이동 = 측위 점프 → 무효화 |
| ③ | 최소 소요시간 | 거리/(auto_speed×2) 보다 빠르면 거부 |
| ③-b | `max_peak_dev_deg` 25° | peak 편차 하드 상한 (사고 때 36° 가 통과했음) |
| ④ | `require_wheels_straight` (기본 ON) | `/steering_adc` 로 앞바퀴 ±2° 밖이면 출발 안 함 |

**조향 상수 정정** (옛 amap 값이 남아 있었음):
- `steer_center` 424 → **412**
- counts/도 21.2 단일 → **좌 26.2 / 우 20.6 분리**
- ⚠ 사고 런의 "STEER_CENTER 424→518 권장" 은 이 틀린 상수 탓. **그 값 쓰지 말 것.**
  (권고 메시지 전용이라 주행 제어엔 영향 없었다)

**검증 상태**: 게이트①만 22:29 실차에서 확인(RTK 1.3초 대기 후 시작, 점프 없음).
②③④ 는 미검증 — `tools/test_heading_calib_guard.py` 가 `ExternalShutdownException` 으로
아직 안 돌아간다(테스트 코드 버그, 제품 코드 아님).

---

## 4. ★ 후진주차 — 현재 상태 (핵심)

### 4-1 수정한 것 (2026-08-25)

`parking_node.begin()` — **전 구간 최근접 탐색으로 변경**

```
기존: 첫 구간(전진 접근) 안에서만 커서 탐색 + 궤적 첫 점과의 거리로 시작 판정
      → 완주 종점에서 5.07m 라 임계 5m 에 걸려 거부
      → 통과시켜도 이미 지나온 전진 구간을 되밟으려 뒤로 감

수정: 전 구간을 훑어 차량 최근접 점을 찾고 그 구간부터 이어서 재생
      → slot1 은 후진구간 idx45 에서 0.36m, slot2 는 idx52 에서 0.11m 로 정상 진입
```

### 4-2 검증 결과 (시뮬, `tools/test_parking_node.py`)

**A. 궤적 시작점에서 출발 — 셋 다 성공**
```
slot1  17cm   ✅      slot2  15cm   ✅      slot3  13cm   ✅
cusp 완전정지 후 기어전환 정상, 완료 후 정지 유지 정상
```

**B. 실제 완주 종점 `(-25.605, 103.797) yaw +166.8°` 에서 출발**
```
slot1  ABORT ("후진 구간인데 목표점이 앞") — cte 0.36 → 0.77m 로 벌어짐
slot2  ABORT (동일)
slot3  ✅ 13cm 성공
```

### 4-3 왜 1·2 가 실패하는가 — 측정으로 확정

**완주 종점의 차량 헤딩과, 그 지점 궤적의 차량 헤딩이 어긋난다.**

| 자리 | 최근접점 | 거리 | 궤적상 차 헤딩 | 완주 종점 헤딩과 차이 | 결과 |
|---|---|---|---|---|---|
| slot1 | 구간1 후진 idx45 | 0.36m | −135.6° | **+57.6°** | ❌ |
| slot2 | 구간1 후진 idx52 | 0.11m | −115.4° | **+77.8°** | ❌ |
| slot3 | 구간0 전진 idx22 | 0.53m | −163.1° | **+30.1°** | ✅ |

위치는 가까운데 **자세가 58~78° 틀어져** 있어서, 후진 pursuit 가 조향 −18°(포화)로도
궤적에 못 붙고 이탈 감시에 걸린다. slot3 만 30° 라 붙는다.

### 4-4 대안 검토 결과 (전부 시도했고 기록으로 남긴다)

`parking_direct` (궤적 무시, 목표점으로 직접 후진) 를 만들어 시뮬했으나 **1.7~2.3m 에서 맴돈다.**
- lookahead 하한 0.5/1.2/1.5, ld=0.6d, 전진 허용, cusp(정체 시 기어반전) 전부 시도 → 개선 없음
- 선회반경 한계(최소 R 2.42m) 때문에 그 자세에서는 목표에 못 붙는다
- **결론: 궤적 재생 방식(parking_node)이 맞고, 자세 문제만 풀면 된다**

`parking_direct` 는 `src/mission_perception/mission_perception/parking_direct.py` 에 남아 있고
entry_point 도 등록돼 있다. **지금은 쓰지 말 것**(검증 실패).

### 4-5 선택지 (사용자 판단 대기 중)

1. **slot3 기준으로 가기** — 유일하게 검증된 자리(13cm). 다른 자리는 현장에서 재기록
2. **ABORT 조건 완화** — '후진인데 목표가 앞' 감시를 끄거나 느슨하게. **위험**: 잘못된 방향 폭주
3. **현장에서 3자리 재기록** — 완주 종점에서 바로 이어지는 궤적으로. 가장 확실, 시간 필요
4. **완주 경로 종점 이동** — 주차 진입 자세에 맞게. **완주 로직을 건드려 위험**

### 4-6 부가 발견 — recorder yaw 버그

`parking_*.yaml` 의 **yaw 가 전부 0.0°** 로 저장돼 있다.
`parking_recorder` 가 yaw 를 제대로 안 넣는다. 현재는 `parking_node` 가 궤적 진행방향으로
대신 계산해서 동작에 지장은 없지만, **현장 재기록 전에 고치는 게 좋다.**

---

## 5. 횡단보도 정지 (해결됨)

**증상**: 앞바퀴가 정지선을 30cm 넘어감.
**조치**: `bringup.launch.py` 에 `crosswalk_bias` 인자 추가(기본 **0.35m**).
`crosswalk_stop_node` 의 `stop_bias` 로 전달 → 정지지점을 35cm 앞당겨 봐서 그만큼 뒤에 선다.

미세조정:
```bash
crosswalk_bias:=0.40   # 아직 넘어가면
crosswalk_bias:=0.20   # 너무 뒤에 서면
```

---

## 6. 완주 → 주차 자동 연동 (구현됨)

`parking_node` 에 `trigger_on_goal_reached` 파라미터 추가 (**기본 True**).
`/goal_reached` (완주 신호)를 받으면 자동으로 주차를 시작한다. **사람 개입 불필요.**

```
완주 → /goal_reached True → parking_node 자동 시작 → 후진주차
```

수동으로 하려면:
```bash
ros2 topic pub --once /parking/select std_msgs/Int32 "{data: 3}"   # 자리 지정
ros2 topic pub --once /parking/start  std_msgs/Bool  "{data: true}" # 시작
```
끄려면 `trigger_on_goal_reached:=false`.

---

## 7. 현재 확정 설정

### 펌웨어 (arduino/henes_firmware/henes_firmware.ino)
| 항목 | 값 |
|---|---|
| `Steering_Sensor` | **A15** |
| 조향 캘리브 | center **412** / 0~936 |
| 조향 스케일 | 좌 **26.2** / 우 **20.6** counts/도 |
| 엔코더 | SPI 카운터 CS 22/23 |
| `NO_ENCODER` | 0 (폐루프 정상) |
| `MAX_DRIVE_PWM` | **160** |

### 경로 / 좌표
- 원점: `(477800.0, 3964400.0)` 대구권 시험장
- 완주 경로: **370점 / 184.0m** / 종점 `(-25.60, 103.80)` 진행방향 `+166.8°`
- `~/parking_1/2/3.yaml`: 59/61/70점, 원점 일치 확인
- `~/stop_points.yaml`: 정지선 1점 `(-25.09, 78.55)`, 완주경로에서 6cm ✅

### 제어
- `min_lookahead` **1.6m** (충주에서 직진 악화 관측 → 대구선 1.9m 재시험 여지)

---

## 8. 미해결 / 리스크

| # | 항목 | 상태 |
|---|---|---|
| 1 | **IMU 미연결** | ★ 물리 조치 필요. 8개 런 전부 사망 |
| 2 | **배터리 방전** | 18초에 879mV 하락 관측. 충전 필수 |
| 3 | **후진주차 slot1·2** | 헤딩 58~78° 불일치로 ABORT. 4-5 선택지 참고 |
| 4 | 게이트 ②③④ 미검증 | 테스트 하네스 버그 |
| 5 | recorder yaw=0 버그 | 현장 재기록 전 수정 권장 |
| 6 | 앞바퀴 좌 6~9° 틀어짐 | 정지 중 조향 스톨 유발. **출발 전 손으로 정면 맞출 것** |

---

## 9. 절대 규칙

1. **매 주행 전 `ls -l /dev/imu` 확인** — 어젯밤 사고의 직접 원인
2. **소스 고치면 `colcon build`** — `--symlink-install` 믿지 말 것
3. **pure_pursuit / 완주 로직 수정 금지** — 주차는 teleop 채널로만 얹는다
4. **원점(site_origin) 확인 먼저** — 장소 바뀌면 이것부터 (150km 어긋난 전례)
5. **E-stop 손에** — 매 실차 단계
6. **매 세션 헤딩 캘리브 필요** — IMU yaw 는 부팅마다 리셋

---

## 10. 자주 쓰는 명령

```bash
# 빌드 (소스 고쳤으면 필수)
cd ~/racing_ws && source /opt/ros/humble/setup.bash && colcon build

# 실차 주행 (완주 + 횡단보도 + 주차 전자동)
bash tools/ros_cleanup.sh && source install/setup.bash
ros2 launch gps_localization bringup.launch.py \
    control:=true auto_calib:=true rviz:=false max_speed:=1.0 \
    crosswalk:=true parking:=true parking_slot:=3
python3 tools/drive_log.py            # 터미널2

# 주차 시뮬 검증 (하드웨어 없이)
python3 tools/test_parking_node.py --file ~/parking_3.yaml
python3 tools/test_parking_node.py --file ~/parking_3.yaml --start-pose="-25.605,103.797,166.8"

# 좌표 재기록 (현장)
ros2 run mission_perception parking_recorder --ros-args -p slot:=1
ros2 run mission_perception stop_point_recorder

# 상태 확인
ros2 topic echo /parking/state
ros2 topic echo /crosswalk/state
ros2 topic echo /vcc_min_mv --once
```

---

**한 줄: 어젯밤 충돌은 IMU 미연결이 원인(8개 런 전부 사망). 빌드 함정으로 안전게이트가
안 돌고 있던 것도 해소했다. 후진주차는 slot3 만 완주 종점에서 성공하고 1·2 는 헤딩
58~78° 불일치로 ABORT — 대응 선택 필요. 매 주행 전 /dev/imu 확인할 것.**

---

# 🔴 추가 — 02:00~02:30 진단 결과 (실차 주행 실패 원인 확정)

## 증상
```
[longitudinal_controller] ⚠ 경로(/curvature) 끊김 → 정지 — 완주 신호는 없었다
[local_pure_pursuit]      정지: ⚠ 경로 35.1s 끊김 — 완주 신호 없음
```
헤딩 캘리브는 **성공**했는데(편차 4°, yaw_offset=124.1°) 차가 안 움직였다.

## ★ 원인: IMU USB 접촉 불량 → 측위 발행 차단

**추적 순서 (전부 실측):**

1. `/curvature` 발행자는 있는데 **메시지가 안 옴** (echo 타임아웃)
2. `local_sliding_window` 디버그 인스턴스를 따로 띄움
   → **전역 경로는 정상 수신(370점)**, 그런데 curvature 안 냄
   → 즉 `odom_callback` 이 아예 안 불린다
3. `/odometry/filtered` echo → **타임아웃. 발행 중단 상태**
4. `direct_localization.publish_odom()` 코드 확인:
   ```python
   if self.have_imu and (t_now - self.last_imu_time) > self.imu_timeout:
       self.imu_lost = True
       return          # ← 여기서 막힘
   ```
5. 커널 로그가 결정적:
   ```
   02:15:49  cp210x attached to ttyUSB0
   02:15:57  disconnected          (8초 만에)
   02:15:57  attached again
   02:16:21  disconnected          (24초 만에)
   ```
   그리고 `/dev/imu` 가 **ttyUSB0 → ttyUSB1** 로 바뀌어 있었다(재연결 흔적).

**결론**: 주행 중 IMU 가 빠졌다 붙기를 반복 → `imu_lost` 플래그가 서서
측위 발행이 멈춤 → 로컬경로 없음 → 제어기가 "경로 끊김" 으로 정지.
**안전 로직은 의도대로 작동한 것이다. 고장이 아니다.**

## USB 토폴로지 — 왜 IMU 만 끊기나
```
IMU:      usb 3-2.1.4.1   ← 허브 3단 경유 (불안정)
아두이노:  usb 3-1        ← 노트북 직결 (그래서 멀쩡)
GPS:      Bus 003        ← 정상
```

## 조치 (물리, 코드 수정 불필요)

1. **IMU 를 허브에서 빼서 노트북에 직결.**
   포트가 부족하면 GPS 를 허브로 옮기고 IMU 를 직결한다.
2. 꽂은 뒤 **30초 안정성 검사** — 10번 전부 ✅ 여야 주행 가능:
   ```bash
   for i in $(seq 1 10); do printf "%2ds " $((i*3)); \
     ls /dev/imu >/dev/null 2>&1 && echo -n "✅ " || echo -n "❌ "; \
     lsusb | grep -q 10c4 && echo "USB✅" || echo "USB❌"; sleep 3; done
   ```
3. 안정 확인되면 **시스템 재시작**(`imu_lost` 플래그 초기화):
   ```bash
   cd ~/racing_ws && bash tools/ros_cleanup.sh && source install/setup.bash
   ros2 launch gps_localization bringup.launch.py \
       control:=true auto_calib:=true rviz:=false max_speed:=1.0 \
       crosswalk:=true parking:=true parking_slot:=3
   ```

## 이 진단에서 확인된 정상 항목 (재검증 불필요)

| 항목 | 검증 방법 | 결과 |
|---|---|---|
| `global_path_publisher` | 단독 실행 | ✅ 370점 로드 |
| `local_sliding_window` | 단독 + 가짜 odom | ✅ 경로 수신, curvature 0.0664 발행 |
| `build_local_path()` | 실제 pose 로 직접 호출 | ✅ ok=True, 20점 |
| 헤딩 무관성 | yaw 45.6° / 169.7° 양쪽 | ✅ 둘 다 ok=True |
| QoS 정합 | 발행/구독 both TRANSIENT_LOCAL depth=1 | ✅ 일치 |
| GPS | `/fix` echo | ✅ status=1, 위경도 정상 |
| IMU 데이터 | `/handsfree/imu` echo | ✅ 나옴 (붙어 있을 때는) |

**즉 소프트웨어는 손댈 것이 없다. USB 물리 연결만 잡으면 된다.**

## ⚠ 진단할 때 쓴 방법 (다음에도 그대로)

증상이 "경로 끊김" 이어도 **원인은 상류에 있을 수 있다.** 아래 순서로 좁힐 것:
```bash
ros2 topic echo /curvature --once          # 안 나오면 ↓
ros2 topic echo /odometry/filtered --once  # 안 나오면 ↓  ← 여기서 걸렸다
ros2 topic echo /fix --once                # GPS
ros2 topic echo /handsfree/imu --once      # IMU
journalctl -k -n 40 | grep -iE "cp210|ttyUSB|disconnect"   # ← 결정적이었다
```
`topic info` 의 Publisher/Subscription count 는 **연결만 보여줄 뿐 데이터 흐름을
보장하지 않는다.** 반드시 `echo` 로 실제 수신을 확인할 것.

---

# 🟢 추가 — 후진주차 재설계 완료 (2026-08-25 오후)

## 무엇을 바꿨나

**궤적을 미리 만들지 않는다. 주행 중 지금 자세에서 계획한다.**

  /parking/start ─→ [parking_planner]  (지금 자세 → 자리 궤적)
                    → [parking_follower] (pure pursuit + 이탈 감시)
                    → /teleop/cmd_vel

경로: `src/mission_perception/mission_perception/parking_planner.py` (신규),
      `parking_follower.py` (신규 — 노드에서 뜯어낸 상태기계),
      `parking_node.py` (재작성, 이 둘을 감쌈)

## 왜 이렇게 했나

기존은 `make_parking_path.py` 로 미리 만든 yaml 을 재생하면서 "가장 가까운
점" 을 찾아 이어 갔다. 그런데:
- 완주 종점은 매 주행마다 다름 (8/24 yaw 142.9°, 8/25 yaw 166.8°)
- 자리1·2 는 최근접이 후진 원호 한복판. 위치 0.1~0.4m 로 가까웠지만
  **궤적의 진행 자세와 차 자세가 58~78° 어긋남**
- 최소회전반경 2.42m 로는 그 자세차를 좁은 주차공간에서 못 메움 → 매번 ABORT

이제 계획기가 **차의 실제 자세** 에서 시작해 Dubins 로 전진부(끝 자세까지 정확히
일치)를, 해석해로 후진 원호+직선을 이어붙인다. 자리 옆에서 시작해 전진만으론
못 붙는 경우(1·2)엔 **먼저 살짝 뒤로 물러섰다 전진**을 자동으로 추가한다.
사람이 좁은 자리에 넣을 때 하는 그대로다.

## 시뮬 검증 결과

**A. 완주 경로 종점(-25.605, 103.797, yaw +166.9°) 에서 출발**
```
slot1: DONE  22cm  뒤로 2.25m → 전진 2.66m → 후진 3.40m
slot2: DONE  15cm  뒤로 1.90m → 전진 2.96m → 후진 3.10m
slot3: DONE  14cm  뒤로 0     → 전진 3.31m → 후진 2.83m
```

**B. 자세 격자 스윕 — dx ±1m · dy ±0.6m · dθ ±30° (525회)**
```
slot1: 173/175 (98.9%)   최악 30cm   실패 2건 (극단 코너)
slot2: 173/175 (98.9%)   최악 21cm   실패 2건 (극단 코너)
slot3: 175/175 (100.0%)  최악 29cm
합계 : 521/525 (99.2%)
```
실패 4건은 전부 (±1m, +0.6m, ±30°) 극단 자세. 실제 완주 종점 오차 범위 밖.

**C. 실제 ROS 노드 (`tools/test_parking_node.py`)**
```
slot1 ✅ 22cm   slot2 ✅ 15cm   slot3 ✅ 14cm
```
셋 다 CUSP 정상, 완료 후 정지 유지 정상.

## 파라미터 변경

| 항목 | 옛 값 | 새 값 |
|---|---|---|
| launch 파라미터 | `parking_dir` | `pose_dir` (뜻: parking_pose_*.yaml 위치) |
| 필요한 파일 | `~/parking_N.yaml` (궤적) | `~/parking_pose_N.yaml` (목표 자세만) |
| 다른 슬롯 keep-out | 있음 | **없음** (인접 슬롯 0.9m 간격, 상자 겹쳐 계획 실패). 현장에서 실제 차 있을 때는 crosswalk/lidar 가 감지 |

`~/parking_N.yaml` 은 안 읽는다. 지워도 되지만 두면 안 읽기만 하므로 무해.

## 주행 명령 (변경 없음)

```bash
cd ~/racing_ws && bash tools/ros_cleanup.sh && source install/setup.bash
ros2 launch gps_localization bringup.launch.py \
    control:=true auto_calib:=true rviz:=false max_speed:=1.0 \
    crosswalk:=true parking:=true parking_slot:=3
```

`parking_slot:=1`, `2`, `3` 모두 안전하게 사용 가능. 자리 1·2 는 후진 진입 전에
2m 정도 뒤로 물러섰다가 진입한다(계획된 동작, 이상 아님).

## 시험 명령 (앞으로 이걸로 회귀)

```bash
# 빠른 폐루프 (ROS 없이, ~10초)
python3 tools/test_parking_plan.py                    # 3자리 실제 종점 자세
python3 tools/test_parking_plan.py --sweep            # 525회 격자 (~1분)
python3 tools/test_parking_plan.py --slot 3 --plot    # 그림 저장

# 실제 ROS 노드 회귀 (~30초/자리)
python3 tools/test_parking_node.py --slot 1 --start-pose="-25.605,103.797,166.9"
```

## 미해결 / 남은 리스크

1. **IMU USB 접촉 불량** — 아직 물리 조치 필요 (허브→직결). 이거 안 잡으면 주행 자체가 안 된다.
2. `recorder yaw=0` 버그 — 궤적 파일을 안 쓰게 됐으므로 무관해졌다.
3. 계획기는 `steer_lag=0.12s`, `steer_bias=0°` 가정. 실차 조향 지연이 더 크면
   실차에서 오차가 30cm 넘길 수 있음 — 첫 시운전에서 확인할 것.

**한 줄: IMU 만 잡으면 slot 1/2/3 셋 다 완주 종점에서 바로 후진주차 가능. 시뮬 99.2% 성공.**
