hanmin0211/racing_ws/HANDOFF_2026-09-04.md

# HANDOFF — 2026-09-04 (HL FMA 2026 용인 대비)

> **이 문서가 최신본.** 이전: `HANDOFF_2026-08-25.md`(배경), `PLAN_HL_FMA_2026.md`(전략 로드맵).
> 원칙: **예측 말고 측정. 완주 코드(pure_pursuit)는 어댑터로만 얹는다.**
> 대회: 용인운전면허시험장 · **9/19 기능점검(각 코스 1회) · 9/20 본경기** · 8분 완주 · 감점 적은 팀 시상.

---

## 0. 지금 당장 (미해결 최우선)

### ★ 카메라 — 가로 신호등 미인식 (열려 있는 이슈)
- 새 HEF(3클래스)는 **정상 로드·발행**되는데, **가로형 신호등을 못 잡음.**
- 의심: calib/학습 데이터가 **인도 자율주행 데이터셋**(`golf`/`india` 태그) → **세로 신호등 위주**, 한국 가로 신호등 부재.
- **판정 필요**(5분): 가로 신호등 이미지 하나로 **원본 ONNX 직접 추론** → 점수 <0.2면 학습데이터 문제(재학습), ≥0.4면 양자화 문제(재컴파일). §4-5 참조.
- **가로 인식은 대회 필수** — 이거 못 잡으면 신호교차로 미션 실패.

### ★ 경사로 홀드 — 5V 정상 상태에서 재시험 (접지 고친 뒤 아직 안 함)
- 홀드 펌웨어 완성·벤치 통과했으나, 실전 램프 테스트는 **저전압(3.8V) 상태에서** 해서 결과 오염됨(160 PWM으로 못 잡고 0.2m/s 크리프).
- **접지 고쳐 VCC 5V 정상됨** → **깨끗한 상태로 램프 재시험 필요.** §3, §5-2.

---

## 1. 이번 세션(9/2~9/4) 한 일 요약

| 트랙 | 성과 |
|---|---|
| **전략** | 탈락/감점 구조 재정리 + 8분 예산 + 4트랙 로드맵 → `PLAN_HL_FMA_2026.md` |
| **A1 원점** | `tools/set_origin_from_fix.py` 신규 — 현장 fix로 원점 자동 세팅(150km 사고 방지) |
| **bringup 버그** | `waypoints:=` 인자 무시 → 정지점 149km 오판 → 크래시. **수정 완료** |
| **헤딩 통찰** | yaw_offset은 위치 독립 → 평지 run-up에서 캘리브. 램프 캘리브 시 40° 오차 실측 |
| **A5 경사로 홀드** | 펌웨어에 위치 PI + 속도 D + 안티와인드업 구현. 벤치 부호 통과 |
| **전원/접지** | **페라이트 하중이 GND 접점 불량 유발 = 만성 리셋 근원 발견·해결** |
| **텔레옵** | `tools/teleop_drive.launch.py`(최소구성) + BT키보드 조작 정리 |
| **카메라/Hailo** | HEF 자체 컴파일 성공 → 파이 배포 → 파이프라인 검증. **단 가로 미인식(§0)** |

---

## 2. Track A — 완주 기반

### 2-1 A1 원점 (도구 완성, 현장 세팅만 남음)
`tools/set_origin_from_fix.py` — RTK fix 20개(σ≤5cm) 평균 → UTM52N → 100m 내림 → `config/site_origin.yaml` 자동 기록(백업 .bak).
```bash
python3 tools/set_origin_from_fix.py                          # 미리보기
python3 tools/set_origin_from_fix.py --write --site "용인 (2026-09-05)"
```
- 현재 원점은 **대구권**(477800/3964400). 9/5 용인에서 위 명령으로 교체.
- RTK는 **지난 대회 검증됨**(전국 VRS). 원점 세팅이 A1의 유일한 잔여.

### 2-2 bringup 버그 수정 (중요)
`src/gps_localization/launch/bringup.launch.py` — `load_stop_points`가 `waypoints:=` 오버라이드를 무시하고 **기본(대구) 경로**와 정지점을 비교 → 다른 장소면 149km 오판 → `[]` → 빈 파라미터 `()` → **런치 크래시.**
- **수정**: `sys.argv`에서 `waypoints:=` 직접 파싱해 검사(줄 158~). 재빌드 완료.
- **용인에서도 같은 버그 터졌을 것**(커스텀 waypoints 넘길 거라) — 이제 안 걸림.

### 2-3 헤딩 캘리브 — 평지 run-up 필수 (실측 교훈)
- yaw_offset = `course − imu_yaw` = **세션 전체에 통하는 회전 상수**(위치 독립).
- `auto_calib`은 `calib_distance`(기본 10m) 직진 필요. **평지 3m + 경사로**인 경로로 캘리브하면 램프로 올라가며 **40° 틀어짐**(실측 drive_log: 횡오차 1~2.5m).
- **대책**: waypoint를 **평지 직진 10m run-up 포함**해 기록. 캘리브가 평지에서 끝나야 함. `calib_distance`는 파라미터라 6m까지 축소 가능(헤딩오차 0.5°).

---

## 3. Track A5 — 경사로 정지·출발 (홀드)

### 3-1 문제 진단 (실측)
- **정지 시 coast**: 목표속도 0 → FF(0)=0 PWM → 잡는 힘 0 → 경사로에서 스르륵 밀림(안 잡으면 계속). 속도루프는 정지마찰 데드밴드(~34PWM) 때문에 무력.
- **등판 stutter**: 구동 스톨가드(`DRIVE_STALL_MS 700`)가 고부하 등판을 스톨 오인 → 700ms 컷.

### 3-2 구현 (펌웨어)
`arduino/henes_firmware/henes_firmware.ino` (+ 읽기용 `arduino/henes_firmware_clean/`):
- **위치 홀드 PI + 속도 감쇠 D + 조건부 안티와인드업**. `velocity_pid_control()` 정지 분기 교체.
- 제어식: `PWM = HOLD_KP·perr + HOLD_KI·∫perr − HOLD_KD·current_velocity` (perr = encoder1count − hold_target)
- 게인: `HOLD_KP 3.0 / HOLD_KI 0.5 / HOLD_KD 3.0 / HOLD_ISUM_MAX 300 / HOLD_MAX_PWM 160`
- 진입 시 hold_target 래치 + hold_isum=0. 포화 방향엔 적분 정지(오버슈트 방지).
- **스톨가드 자동 회피**: 홀드는 target_velocity≈0이라 스톨 조건(target>0.05) 미충족 → 컷 안 됨.
- 부호 확정: 전진=encoder 감소(cpr=−290) → 뒤로 밀림=perr>0 → +PWM=전진(복원).

### 3-3 벤치 검증 (통과)
`tools/hold_bench.py` — 바퀴 들고 손으로 뒤로 굴리니 **모터가 되밀고 원위치로 복원(오버슈트 후 정착), 런어웨이 없음**. 부호 정상.

### 3-4 램프 실측 (오염됨 — 재시험 필요)
- 저전압(VCC 3.8V) 상태에서 함. **160 PWM 포화인데도 0.22m/s로 계속 크리프 → 67cm(>50cm) 밀림.**
- **단 접지 문제(§4) 때문에 결과 못 믿음.** 5V 정상 후 재시험 시 잡힐 가능성.
- 판정법: 램프 홀드 중 텔레메트리 `PWM=` 값 — **160 미만 안정=✅, 160 고정+크리프=❌(PWM 한계)**. ❌면 KP↑ 또는 MAX_DRIVE_PWM↑(브라운아웃 주의) 또는 감점 감수(경사로는 감점).

---

## 4. ★ 전원/접지 — 페라이트 하중 = 만성 리셋 근원 (오늘 최대 수확)

### 4-1 발견
- 램프 테스트 중 **VCC 3.8V**(정상 5V) 관측. `tools/vcc_check.py`로 감시하며 배선 흔드니 **VCC가 2.9V~5.1V로 미친듯이 널뜀** = 접촉 불량.
- **엔코더 GND 선에 물린 페라이트 코어의 하중**이 약한 GND 조인트를 흔들어 접촉 붙었다 떨어졌다 유발.
- **페라이트 제거 → VCC 5091~5115mV 완전 안정.**

### 4-2 의미
- **handoff에 계속 나오던 "주행 중 브라운아웃/리셋"의 진짜 원인일 가능성 큼** — 진동이 이 GND를 흔들어 리셋시킨 것.
- **저전압 + 만성 리셋 둘 다 이걸로 해결.**

### 4-3 남은 조치
- **그 GND 조인트를 재납땜/고정** 권장(페라이트가 악화시킨 거지 조인트 자체가 부실할 수 있음).
- 검증: `python3 tools/vcc_check.py` 켜고 배선·커넥터 흔들어도 5V 유지되나.
- ※ VCC = 아두이노 5V 로직(밴드갭). 24V 모터배터리는 별개 — 멀티미터로 따로 측정.

---

## 5. Track D — 카메라 / Hailo (이번 세션 최대 신규 작업)

### 5-1 하드웨어·모델
- **파이5 + Hailo-8** (AI HAT+ 26TOPS, M.2). HailoRT **4.24.0**. Device HAILO8.
- 파이 IP **192.168.99.8**, user **pi**, eth0 MAC **88:a2:9e:45:d8:19**.
- 새 모델 `best_hailo_op11.onnx` = **YOLOv8s 3클래스** `{0:green, 1:orange, 2:red}`, 640×640, NMS 미포함.

### 5-2 파이 네트워크 복구 (docx 매뉴얼에서 해결)
노트북↔파이 직결(enp3s0=192.168.99.1). **파이 IP 못 받던 원인 = 노트북 ufw가 DHCP 막음 + dnsmasq 미실행.**
**재부팅마다 필요한 3명령(노트북):**
```bash
sudo ufw allow in on enp3s0 to any port 67 proto udp   # (한번만, 유지됨)
sudo ufw allow in on enp3s0 to any port 53             # (한번만)
sudo sysctl -w net.ipv4.ip_forward=1                   # 매 부팅
sudo iptables -t nat -A POSTROUTING -o wlp4s0 -j MASQUERADE   # 매 부팅
sudo dnsmasq --interface=enp3s0 --bind-interfaces --except-interface=lo \
    --dhcp-range=192.168.99.2,192.168.99.10,255.255.255.0,24h \
    --dhcp-option=3,192.168.99.1 --dhcp-option=6,192.168.99.1 \
    --log-dhcp --no-daemon      # 이 창 열어둬야 함
```
DHCPACK 뜨면 `ssh pi@192.168.99.8`. **매번 귀찮으면 systemd 서비스화 가능(미구현).**

### 5-3 HEF 자체 컴파일 (성공)
- **Hailo AI Software Suite Docker (2026-07 = HailoRT 4.24)** 다운로드(Dev Zone 로그인 필요, 8.5GB) → `hailo_ai_sw_suite_docker_run.sh`로 컨테이너 진입.
- 컨테이너 마운트: 노트북 `~/Downloads/shared_with_docker/` ↔ 컨테이너 `/local/shared_with_docker/`.
- **표준 컴파일 실패**: 자동 end-node가 DFL 뒤 `depth_to_space` → NMS가 conv 요구하며 거부.
- **성공 명령**(디텍션 헤드 conv 6개에서 자름):
```bash
hailomz compile yolov8s --ckpt best_hailo_op11.onnx --calib-path hailo_calib/ \
    --classes 3 --hw-arch hailo8 \
    --end-node-names \
        /model.22/cv2.0/cv2.0.2/Conv /model.22/cv3.0/cv3.0.2/Conv \
        /model.22/cv2.1/cv2.1.2/Conv /model.22/cv3.1/cv3.1.2/Conv \
        /model.22/cv2.2/cv2.2.2/Conv /model.22/cv3.2/cv3.2.2/Conv
```
- 산출: `yolov8s.hef`(4.4MB). 스크립트: `~/Downloads/compile_hef.sh`.
- ⚠ **양자화 경고**: calib 64장만 사용 + 최적화 level 0(GPU 없음). 정확도 suboptimal — 필요시 GPU 환경서 512장·level max 재컴파일.

### 5-4 배포 (완료)
- `detector_node.py` **3클래스 인덱스 매핑**으로 수정(0→GREEN, 2→RED, 1(orange)→RED 안전정지). `classes.json` 신규 3클래스. → 파이 배포됨.
- HEF 파이로 scp(`~/yolov8s.hef`). 노드 재실행 시 로드 성공, `/traffic_light_state` NONE 안정 발행. 웹 스트리밍(`traffic_light_combined.py`, `http://192.168.99.8:5000`) 정상.
- **HEF repo 백업 권장(미완)**: `cp ~/Downloads/shared_with_docker/yolov8s.hef src/mission_perception/pi_deploy/yolov8s_3class.hef`

### 5-5 ★ 열린 문제 — 가로 신호등 미인식
- **파이프라인은 완벽, 근데 가로 신호등을 못 잡음.**
- calib 파일명 `golf`/`india` = 인도 자율주행 데이터셋 → 세로 신호등 위주 의심.
- **판정 테스트(컨테이너 안, test.jpg에 가로 신호등 저장 후):**
```python
import onnxruntime as ort, numpy as np, cv2
sess = ort.InferenceSession('best_hailo_op11.onnx')
img = cv2.resize(cv2.imread('test.jpg'), (640,640))
x = img.transpose(2,0,1)[None].astype(np.float32)/255.0
scores = sess.run(None, {'images': x})[0][0, 4:, :]   # [3,8400]
print([f'{scores[i].max():.3f}' for i in range(3)])    # <0.2=학습문제, >0.4=양자화문제
```
- **<0.2 → KNUT에 가로 신호등 재학습 요청**(또는 AI Hub 한국 신호등 데이터 병합). 백업: HSV색+원형검출 고전 영상처리.
- **>0.4 → GPU 환경서 calib 늘려 재컴파일.**

### 5-6 아직 없는 카메라 미션
- **신호제어 차선유지(↓/X)**·**돌발 급정지(어린이 더미)** — 이 모델에 클래스 없음. **별도 모델/검출 필요.**

---

## 6. 9/5 용인 현장 계획 (실제 대회 코스 데이터 확보일)

용인이 실제 대회장 → 9/5 기록물이 9/19/20까지 유효. **고정 요소 다 확보 + 센서 미션용 영상 수집.**
1. `set_origin_from_fix.py --write` → 원점 확정
2. waypoint 기록 — **맨 앞 평지 10m run-up 포함**, 전 코스 연속, RTK FIXED 유지
3. 정지점: 경사로 검지구역 + 신호교차로 정지선 (`stop_point_recorder`)
4. 주차 자세: 직각 + 평행 (`parking_pose_recorder`) — 평행 planner 미구현이나 자세는 찍어둠
4-b. ★ **기록할 때마다 바로 `python3 tools/preflight.py`** — ❌ 가 있으면 **그 자리에서**
     다시 찍는다. 현장을 떠난 뒤엔 되돌릴 수 없다. (§10 참조)
5. **카메라 참고자료**: 실제 신호등(가로!) 영상 촬영 → 재학습/검증용. S코스 T870 규격 실측. 경사 각도 실측
6. ※ 당일 변수(돌발 기준선·S 장애물·↓X 신호)는 센서가 처리 — waypoint 무의미

---

## 6-b. ★ 원점 가드 + 현장 사전검사 (2026-09-04 추가)

### 6-b-1 뚫려 있던 구멍 — 웨이포인트에 원점이 없었다
로컬좌표는 `(UTM − 원점)`이라 원점 없이는 해석이 안 된다. 그런데:

| 데이터 | 원점 저장 | 로드 시 검증 |
|---|---|---|
| 정지점 | ✅ | ✅ bringup 이 환산 + 코스거리 검사 |
| 주차 자세 | ✅ | ✅ parking_node 가 1m 초과 시 거부 |
| **주행 경로** | **❌ 없음** | **❌ 없음** ← 여기만 뚫려 있었다 |

**9/5 에 원점을 용인으로 바꾸는 순간 터질 자리였다.** 옛 대구 경로가 조용히
149km 어긋난 채 로드된다(정지점은 걸러지는데 경로는 안 걸러짐).

**조치 (전부 재빌드·검증 완료)**
- 웨이포인트 저장 시 원점을 **파일 맨 위**에 기록 (`waypoint_recorder` /
  `waypoint_resample` / `smooth_path` — 기록→리샘플→평활화 체인 전부)
- `global_path_publisher` 에 `origin_check`(기본 **strict**):
  일치→통과 / 소폭차이→자동환산 / **1km 초과·EPSG 불일치→발행 거부**
  거부 시 5초마다 에러 반복(하류 "경로 끊김" 을 상류로 되짚는 시간 제거)
- `tools/shift_waypoints.py` **신규** — `site_origin.yaml` 주석이 가리키던
  도구가 실제로는 없었다. 환산 + `--stamp-only`. 대구 파일 6개 소급 스탬프 완료
- 종료 시 `ExternalShutdownException` traceback 제거
  (`set_origin_from_fix` / `waypoint_recorder` / `global_path_publisher`)

검증: 원점을 용인으로 임시 교체 → 대구 경로 **발행 거부 확인**, 원점 복원 후 정상.

### 6-b-2 `tools/preflight.py` — 현장 데이터 사전검사 (신규)
```bash
python3 tools/preflight.py            # ❌ 없으면 exit 0
python3 tools/preflight.py --waypoints <새로 찍은 파일> --calib-distance 10
```
| 검사 | 잡는 사고 |
|---|---|
| A 원점 | 150km 어긋남 |
| B 경로 — 스탬프 / 곡률(최소R) / **시작 10m run-up 직선성** | 못 도는 커브, **램프 캘리브 40° 틀어짐** |
| C 정지점 — 스탬프 / 경로까지 거리 | 다른 장소 정지점 |
| D 주차 — **parking_planner 직접 호출** | 진입 불가 자세 |

**B 의 run-up 검사가 §2-3 문제를 파일만 보고 잡는다** — 시작 10m 구간의
헤딩 최대편차와 직선 대비 이탈을 재서, 캘리브 중 직진하면 코스를 벗어나는지
판정한다. (현 대구 경로: 2.1° / 0.05m ✅ / 인공 곡선 경로: 18.0° / 0.39m ❌)

### 6-b-3 발견된 데이터 문제
- **`~/stop_points.yaml` 이 못 쓰는 파일이다.** 대구 원점 스탬프인데 좌표가
  `(-77973, 127827)` = 경로에서 **149.6km**. 옛 충주 좌표가 대구 스탬프를 달고
  있어 **환산으로는 못 고친다.** 지금은 bringup 의 '코스에서 멀다' 검사가 겨우
  막고 있다. 대구용 정상본은 `racing_ws/stop_points_0824_1814.yaml`(경로에서 6cm).
  → 용인에서 어차피 새로 찍으므로, 찍은 뒤 `STOP_POINTS_FILE` 로 지정하거나
     `~/stop_points.yaml` 을 덮어쓸 것.

### 6-b-4 ★ 후진주차는 이미 해결돼 있었다 (문서가 낡았음)
`PROJECT_HANDOVER.md` §4.3 의 "slot1·2 ABORT, slot3 만 사용" 은 **옛 정보**다.
`parking_planner`(Dubins 전진 + 후진 원호, 필요 시 `d_back` 만큼 먼저 후진)로
바뀐 뒤 **3자리 전부 성공**한다. 2026-09-04 재측정:

| 자리 | 뒤로 | 전진 | 후진 | 계획 | 폐루프 정차오차 |
|---|---|---|---|---|---|
| 1 | 2.25m | 2.66m | 3.40m | ✅ | **22cm** |
| 2 | 1.90m | 2.96m | 3.10m | ✅ | **15cm** |
| 3 | 0.00m | 3.36m | 2.73m | ✅ | **15cm** |

⚠ `test_parking_node.py` 의 **`--file` 은 무시된다.** 자리는 `--slot` 으로 고른다.
옛 문서의 `--file ~/parking_3.yaml` 은 실제로 slot1 을 시험하고 있었다.
→ **"slot3 만 노려야 한다" 는 대회 전략 제약이 사라졌다.**

---

## 6-c. ★ 미션 시퀀서 — 상위 상태기계 (2026-09-04 신규)

### 6-c-1 왜 필요했나
미션 노드는 각자 상태기계를 갖고 있었지만 **서로를 모른다.** 그런데 출구는 공유한다:

| 토픽 | 쓰는 노드 |
|---|---|
| `/teleop/cmd_vel` | parking_node |
| `/stop_line_distance` | crosswalk_stop_node, traffic_light_bridge |
| `/lidar/avoid_steer` | cluster_plot_node (먹스에서 조향 override) |

지금까지는 **"mission:=true 와 crosswalk:=true 를 같이 켜지 말 것"** 이라는
사람이 지키는 규칙으로 막았다. 용인은 미션이 8개다 — 지킬 수 있는 규모가 아니다.

### 6-c-2 설계
`mission_sequencer` 가 `/global_path` 로 **코스 진행거리 s** 를 계산하고,
`config/mission_plan.yaml` 순서대로 **한 번에 하나만** arm 한다.

```
/odometry/filtered + /global_path → [mission_sequencer] → /<미션>/arm (Bool)
                                            ↑ /<미션>/done
```

핵심 규칙 세 가지:
1. **동시 활성 금지** — arm 된 미션이 있으면 다른 건 켜지 않는다
2. **타임아웃 강제 복귀** — 넘기면 disarm 하고 자율로 돌아간다.
   **미션 실패는 감점이지만 그 자리에 멈추면 탈락**이다
3. **예산 기반 스킵** — 남은 시간이 모자라면 `critical: false` 미션을 버린다

좌표(`type: point`) 대신 **진행거리(`type: course_s`)** 를 기본으로 쓴다.
좌표만 보면 경로가 자기 근처로 되돌아오는 굴절·방향전환에서 오작동한다.

### 6-c-3 arm 규약 — 내려갈 때 반드시 '해제값' 을 쏜다
`longitudinal_controller` 는 `/stop_line_distance` 를, 먹스는 `/lidar/avoid_steer`
를 **타임아웃 없이 계속 들고 있는다.** HOLD 중 0.0 을 쏘다가 조용히 발행만
멈추면 그 0.0 이 영원히 남아 차가 굳는다 → **1분 정지 = 탈락.**
그래서 disarm 시 `999`(제약 없음) / `NaN`(회피 없음)을 한 번 쏘고 물러난다.

### 6-c-4 ★ 발견한 실차 결함 — 주차 무한 재시작
`/goal_reached` 는 완주 후 **20Hz 로 계속 True 를 발행한다**(latched).
`parking_node.start_cb` 는 `DRIVE`/`CUSP` 만 막고 있었으므로,
**주차가 DONE 이나 ABORT 로 끝난 다음 프레임에 곧바로 begin() 이 다시 불렸다.**
= 대회에서 주차를 성공해 놓고 그 자리에서 다시 주차를 시도한다.
→ 상승엣지 래치(`_started`) 추가. 재시도는 `/parking/reset` 으로 명시적으로만.

### 6-c-5 실행
```bash
ros2 launch gps_localization bringup.launch.py \
    control:=true auto_calib:=true sequencer:=true \
    crosswalk:=true parking:=true lidar:=true
```
`sequencer:=true` 면 자동으로:
- crosswalk / lidar → `require_arm:=true` (arm 전엔 발행 안 함)
- parking → `trigger_on_goal_reached:=false` (트리거 주인을 시퀀서로 일원화)

검증 (하드웨어 없이):
```bash
python3 tools/test_mission_sequencer.py     # 순서 / 동시활성 / 타임아웃 / 예산스킵
```

### 6-c-6 ★ 라이다는 '감속' 과 '조향' 을 따로 다뤄야 한다
처음엔 arm 으로 라이다 노드 전체를 껐는데 **그건 틀렸다.** 출력이 두 갈래이고
성격이 정반대다.

| 출력 | 하는 일 | 켜는 범위 |
|---|---|---|
| `/obstacle_distance` | 종방향 **감속·정지** | **코스 전체 — 항상** (안전 기능) |
| `/lidar/avoid_steer` | **조향 override** | S코스 구간에서만 |

- 감속까지 끄면 **코스 어디서든 앞을 막아도 안 선다.** 회피 못 하는 것보다 위험하다.
- 조향을 항상 켜두면 S코스가 아닌 곳에서 관중·표지물·연석에 반응해 틀 수 있다 =
  **이탈=탈락.**

→ 파라미터 이름도 `require_arm_for_steer` 로 바꿔 **조향만 게이트한다**는 걸 명시.
   `mission_plan.yaml` 의 `lidar_avoid` 항목이 켜고 끄는 것도 조향뿐이다.

### 6-c-7 ★ 구간 미션 vs 배경 기능 (exclusive)
라이다 회피를 일반 미션으로 넣으면 **"한 번에 하나만" 규칙에 걸려 라이다가 켜진
동안 횡단보도·주차가 아예 못 켜진다.** 라이다는 차를 직접 모는 게 아니라
조향을 덧씌우는 **배경 기능**이라 성격이 다르다.

```yaml
exclusive: true   (기본) 구간 미션 — 하나만. done/타임아웃 있음
exclusive: false        배경 기능 — 구간 안이면 켜고 벗어나면 끔.
                        다른 미션을 막지 않고 막히지도 않는다. 타임아웃 없음
```

⚠ 현재 `lidar_avoid` 의 s 범위는 **0~9999(코스 전체)** = 예전처럼 항상 켜둔 것과 같다.
용인에서 S코스 구간 s 를 알아낸 뒤 **반드시 좁힐 것.** 회피는 조향을 통째로
뺏으므로 엉뚱한 구간에서 관중·표지물에 반응하면 그게 곧 **이탈=탈락**이다.

### 6-c-8 라이다 연결 (이 노트북)
```bash
# ① 드라이버 — bringup 에 없다. 따로 띄운다
ros2 launch sllidar_ros2 sllidar_a1_launch.py serial_port:=/dev/ldlidar

# ② 스택
ros2 launch gps_localization bringup.launch.py ... lidar:=true

# ③ 확인 (마운트 방향·회피 결정)
python3 tools/lidar_monitor.py
```
- udev 는 이미 정리돼 있다: 라이다 `/dev/ldlidar`(고유 시리얼) / IMU `/dev/imu`(serial 0001).
  **문서 §2.4 의 "CP2102 충돌" 은 해결된 옛 이야기다.**
- **라이다 = RPLIDAR A2M12 / 256000 baud / scan_mode Sensitivity** (2026-09-05
  라이다 작업자 zip 으로 확정). udev 주석의 "A1" 은 틀렸다.
- ⚠ `sllidar_a2m12_launch .py` 의 **파일명에 공백**이 있어 정상 이름으로는 런치가
  안 됐다(`file ... was not found`). 이름을 고쳤다 — 실제 모델의 런치가 이것뿐이라
  현장에서 그대로 막힐 자리였다.
- ⚠ `sequencer:=true` 면 `mission_plan.yaml` 에 `lidar_avoid` 항목이 **있어야**
  회피가 켜진다. 없으면 arm 이 영영 안 와서 조용히 죽는다.

### 6-c-9 ★ 돌발 급정지 — 카메라 없이 라이다로 (신규 구현)
"어린이 더미 감지 → 완전정지" 를 카메라 미션으로 분류해 뒀는데, **더미는
물리적 물체라 2D 라이다에 잡힌다.** 그리고 경로가 이미 다 깔려 있었다:

```
/scan → cluster_plot_node → /obstacle_distance → longitudinal_controller (감속·정지)
```

**서는 것까지는 공짜였다.** 없던 건 두 가지뿐이라 `sudden_stop_node` 로 만들었다.

**① 정지 확인 + 유지** — 완전정지(|v|<0.05)를 확인하고 **5초** 붙잡는다.

**② ★ 재출발 — 이게 진짜 문제였다**
더미가 앞에 있는 한 `/obstacle_distance` 가 계속 작게 나오고 longitudinal 은
계속 v=0 을 낸다. **가만히 두면 영원히 못 간다.** 그런데 대회에서
**1분 이상 정지는 감점이 아니라 탈락**이다. 그래서 단계적으로 빠져나온다:

```
IDLE → HOLD(5초 유지) → WAIT_CLEAR(치워지길 대기, 10초) → PASSING(mute) → CLEARED
```

`PASSING` 은 신규 `/lidar/mute` 로 **전방 감속만** 잠깐 끄고 지나간다(조향 회피는
그대로). 위험한 선택이라 `pass_when_blocked:=false` 로 끌 수 있고, 켠 동안
경고를 계속 남긴다. **정지 유지는 탈락, 통과는 감점**이라는 전략에 따른 것이다.

검증 (`tools/test_sudden_stop.py`, 하드웨어 없이):
- ① 치워지는 경우: 더미 1.19m 앞 완전정지 → **5.30s 유지** → 치워지자 재출발 ✅
- ② 안 치워지는 경우: mute 켜고 통과 → 다시 끔

실행:
```bash
ros2 launch gps_localization bringup.launch.py ... \
    lidar:=true sudden_stop:=true sudden_stop_dwell:=5.0
```
⚠ `crosswalk` 와 **같은 `/stop_line_distance`** 를 쓴다. 둘 다 켜려면
`sequencer:=true` 로 하나씩만 arm 되게 하고, s 구간이 겹치지 않게 할 것.

### 6-c-10 ★ 경기규정 원본 대조 (2026-09-05) — 틀린 스펙 정정

`HL FMA [1/5] 경기규정` PDF 를 처음으로 대조했다. **코드에 적혀 있던 S코스
스펙이 규정에 없는 값이었다.**

| 항목 | 코드에 적혀 있던 값 | **규정 원문** |
|---|---|---|
| S코스 장애물 | 이삿짐박스 900×500×600mm **3개** | **T870 차체(바퀴 없음) 2대** |
| 배치 | 2케이스 | **좌→우/우→좌 랜덤, 매 주행마다 변동 가능** |
| 간격·오프셋 | 2.5m / ±0.65m | **규정에 없음 — 실측 필요** |

출처를 찾지 못했다(옛 규정이거나 추정치). `tools/lidar_slalom_test.py` 와
`cluster_plot_node` 주석을 규정대로 고치고, 치수는 CLI 인자로 빼서
**"잠정치 — 실측 후 덮어쓸 것"** 을 명시했다.

**정정된 판정**: 배치가 매 주행마다 바뀌므로 **웨이포인트로 궤적을 찍어둘 수
없다는 것이 규정으로 확정**됐다. 라이다가 필수다.

#### 규정에서 새로 확인된 것들

**① 회피기동 금지 (항목 7)**
> ※ 회피기동은 미션 성공으로 인정하지 않음 (10점)

돌발 구간에서 라이다가 더미를 **피해 나가면 미션 실패**다. `lidar_avoid` 가
코스 전체로 켜져 있었으므로 그대로면 실패했을 것이다.
→ 시퀀서에 `inhibits` 추가. 미션이 `inhibits: [lidar_avoid]` 를 선언하면
  그 구간 동안 배경 기능을 **강제로 끈다**(s 구간을 잘못 적어도 막힌다).
  검증: crosswalk 진입 시 lidar_avoid DISARM, 이탈 시 복구 ✅

**② 3초 정지 후 우회 허용 (항목 7)**
> ※ 3초 정지 후 더미를 치우거나 우회하여 주행 재개 가능

`sudden_stop_node` 의 PASSING(mute 통과) 단계가 **규정상 허용**됨을 확인.
규정 최소는 **3초**다. 현재 기본값 5초는 여유분이고 그만큼 8분을 쓴다.

**③ 주차는 차고에 넣는 걸로 안 끝난다 (항목 6·8)**
> 후진으로 차고에 진입하여 뒷바퀴가 확인선을 접촉하고
> **전진으로 진입확인선을 통과**해야 함 / 미수행 10점

`parking_node` 는 DONE 에서 멈추고 끝났다 — **규정상 미완**이었다.
→ `DONE → EXIT → FINISHED` 추가. `~/parking_exit_{slot}.yaml` 이 있으면
  전진 Dubins 로 탈출한다(전진 전용이라 후진 원호가 필요 없다).
  검증: 탈출 자세까지 14cm, 하위호환(파일 없으면 기존 DONE 종료) 15cm ✅

**④ 주차칸 경계는 라바콘 (항목 6·8)**
> 주차공간은 대형면허시험 기준으로 **라바콘**을 이용하여 가변한다

페인트가 아니라 **수직 구조물**이다 → **2D 라이다에 보인다.**
라이다 주차가 원리적으로 가능하다. (평행주차 공간은 차량규격의 1.5배)

**⑤ 경사로엔 새 노드가 필요 없다 (항목 3)**
정지검지구역 3초 이상 정지 → 출발, 후방 50cm 이내, 정상부까지 30초 이내.
이건 `crosswalk_stop_node` 가 하는 일과 **같은 패턴**이다(정지선 접근 →
완전정지 → dwell → 재출발). 경사로 정지점을 찍고 `dwell:=3.0` 으로 띄우면 된다.
⚠ 시퀀서 `timeout_s` 는 30 미만이어야 한다.

**⑥ 8분 예산 (항목 10)**
> 교차로 신호대기시간, 정지선 1m 이내 정지시간은 **제외**

시퀀서는 지금 벽시계로 센다 = **실제보다 시간을 더 썼다고 본다.** 방향은
안전하지만(미션을 더 일찍 버림) 최적은 아니다. 미구현.

**⑦ 탈락 조건 확정**
입력장치 사용 / **1분 이상 정지** / DNF / **연석·규정도로 이탈**.
신규 3개(S코스·돌발·신호제어차선) 실패는 **감점만**. 총 195점 만점.

### 6-c-11 남은 것
- `config/mission_plan.yaml` 의 s 값은 **대구 코스 기준 임시값**이다.
  9/5 용인 waypoint 기록 후 각 미션 구간의 s 를 채워야 한다.
- 경사로·신호등·S코스 항목은 파일에 **주석 뼈대**로 들어 있다.
- `tools/test_crosswalk_stop.py` 가 `import os` 누락으로 **실행조차 안 되던 것**을
  고쳤다(그동안 횡단보도 회귀검증이 돌지 않고 있었다).

---

## 7. 남은 미션 / 리스크

| # | 항목 | 상태 |
|---|---|---|
| 1 | **가로 신호등 인식** | ❌ 재학습 유력(§5-5). 대회 필수 |
| 2 | **경사로 홀드 5V 재시험** | ⏳ 접지 고침, 재측정 필요(§3-4) |
| 3 | **평행주차 planner** | ❌ 미구현(직각만). Dubins 확장 필요 |
| 4 | **S코스 T870 튜닝** | ⏳ Follow-the-Gap 프레임워크 있음, 파라미터 미조정 |
| 5 | 신호제어 차선(↓/X)·돌발 더미 | ❌ 모델 없음 |
| 6 | IMU USB 접촉불량 | ⚠ 만성. 매 주행 전 `ls -l /dev/imu` |
| 10 | `~/stop_points.yaml` 오염 | ❌ 149km 밖 좌표. 용인에서 재기록 필요(§6-b-3) |
| 11 | mission_plan.yaml s 값 | ⏳ 대구 임시값. 용인 기록 후 채울 것(§6-c-11) |
| 7 | 파이 5A 전원 경고 | ⚠ 카메라 전류 제한 가능. 대회 시 카메라 뻑나면 의심 |
| 8 | 8분 시간 예산 | ⚠ 직선 속도 상향 필요 |
| 9 | GND 조인트 재납땜 | ⏳ 페라이트 제거로 임시 해결, 영구 고정 권장 |

**전략 상기**: 탈락은 이탈/1분정지/DNF/입력장치뿐. **신규 3개(S·돌발·신호제어차선)는 감점-only.** 완주 안정 > 미션 완벽.

---

## 8. 파일·명령 레퍼런스 (이번 세션 신규)

| 파일 | 용도 |
|---|---|
| `PLAN_HL_FMA_2026.md` | 대회 전략 로드맵 |
| `tools/set_origin_from_fix.py` | 현장 fix→원점 세팅 |
| `tools/hold_bench.py` | 경사로 홀드 벤치/램프 관찰 |
| `tools/vcc_check.py` | 아두이노 5V 감시(접지 진단) |
| `tools/teleop_drive.launch.py` | 수동조종 최소구성(serial_bridge+mux) |
| `~/Downloads/compile_hef.sh` | ONNX→HEF 컴파일 명령 |
| `~/Downloads/KNUT_hef_request.md` | HEF 요청 사양서(참고) |
| `src/.../pi_deploy/detector_node.py` | 3클래스 수정본(파이 배포됨) |
| `src/.../pi_deploy/classes.json` | 3클래스 라벨 |
| `arduino/henes_firmware_clean/` | 홀드 포함 정리본(읽기용) |

**자주 쓰는 명령:**
```bash
# 빌드 (소스 고쳤으면)
cd ~/racing_ws && source /opt/ros/humble/setup.bash && colcon build

# 파이 접속 (dnsmasq 먼저 §5-2)
ssh pi@192.168.99.8

# 파이 신호등 노드
ssh pi@192.168.99.8
source ~/ros2_humble/install/setup.bash && source ~/ros2_ws/install/setup.bash
nohup ros2 run traffic_light_detector traffic_light_node > ~/tld.log 2>&1 < /dev/null & disown

# 파이 웹 스트리밍 (노드와 동시 X — 칩·카메라 단일점유)
nohup python3 ~/traffic_light_combined.py > ~/stream.log 2>&1 < /dev/null & disown
# → http://192.168.99.8:5000
```

---

## 9. 절대 규칙

1. 매 주행 전 `ls -l /dev/imu` — 어젯밤 연석사고 직접 원인
2. 소스 고치면 `colcon build` — `--symlink-install` 믿지 말 것
3. **pure_pursuit/완주 로직 수정 금지** — 미션은 mux 어댑터(토픽)로만
4. 원점(site_origin) 먼저 — 장소 바뀌면 이것부터 (150km 사고 전례)
4-b. **좌표를 기록할 때마다 `python3 tools/preflight.py`** — 현장 떠나면 못 되돌린다
5. E-stop 손에 — 매 실차
6. 매 세션 헤딩 캘리브 (IMU yaw 부팅마다 리셋). **평지 10m run-up에서**
7. 펌웨어 플래시 후 **바퀴 들고 홀드 부호 확인**(런어웨이 방지)
8. 파이 칩·카메라는 **한 프로세스만** 점유 — detector와 stream 동시 실행 금지

---

**한 줄(9/4 추가): 주행경로에만 원점 가드가 없어 9/5 원점 교체 때 149km 어긋날 자리였고 — 스탬프 저장 + strict 검증으로 막았다. `tools/preflight.py` 로 현장에서 기록 직후 판정 가능. 후진주차는 planner 교체로 이미 3자리 전부 해결돼 있었다(문서가 낡았음).**

**한 줄: HEF 자체 컴파일·파이 배포까지 성공했으나 가로 신호등 미인식(재학습 유력)이 최대 열림. 접지 접촉불량(페라이트) 발견·해결로 만성 리셋 근원 잡음. 경사로 홀드는 5V 정상 상태 재시험 남음. 9/5 용인에서 원점·waypoint(run-up 포함)·정지점·주차자세·신호등 영상 확보가 핵심.**
