hanmin0211/racing_ws/PLAN_HL_FMA_2026.md

# PLAN — HL FMA 2026 (용인) 대회 준비 로드맵

> 작성 2026-09-02 (D-18). 규정: `~/Downloads/HL FMA[1_5] 경기규정`.
> 원칙: **예측 말고 측정. 완주 코드(pure_pursuit)는 어댑터로만 얹는다.**
> 이 문서 = 준비 기간 작업 정본. 상황 바뀌면 여기부터 고친다.

---

## 0. 대회 팩트

| 항목 | 값 |
|---|---|
| 장소 | **용인운전면허시험장** 1종 대형 기능코스 (※ 대구권 아님 — 새 맵) |
| 기능점검 | 2026-09-19 (토) · 각 코스 1회 주행 |
| 본경기 | 2026-09-20 (일) |
| 지정시간 | **8분** (초과 매 1분당 5점 감점) |
| 배점 | 195점 만점 · **감점 적은 팀 시상** |
| 동점 시 | ①시간 ②미션수행 횟수·점수 ③참가품행 |

## 1. 전략 — 왜 이 순서인가

**탈락(실격)은 딱 4가지뿐:**
1. 도로/연석 **이탈** (지난해처럼 탈락)
2. **1분 이상 정지**
3. 주행불가 **DNF** (지체 1분)
4. 입력장치(리모컨 등) 사용

**나머지 미션 실패는 전부 감점.** 특히 **신규/변경 3개(S코스 회피·돌발 급정지·신호제어 차선유지)는 2026년 감점-only, 탈락 아님.**

→ **우승 공식 = "8분 안에 이탈·정지 없이 완주" + 시간 되는 만큼 감점 회피.**
- 가장 어렵고 새로운 3개 미션이 오히려 위험도(risk-adjusted)는 **낮다** (감점만).
- 반대로 주차·S코스는 연석 근처 타이트 기동 → **못하면 감점, 잘못하면 이탈=탈락**. 양날의 검. 안정성 확보 전엔 무리 금지.

## 2. 8분 시간예산 (초안 — 실측으로 갱신)

480초를 미션에 배분. 정지 미션은 3초 홀드가 규정. 주차는 후진 기동으로 각 ~45–60초.

| 구간 | 예상 소요 | 비고 |
|---|---|---|
| 순수 주행(직선·코너·굴절·곡선·방향전환) | ~180–240s | **직선 속도 올려야 예산 맞음** (현재 max_speed 1.0은 느림) |
| 신호교차로(좌회전+신호대기) | ~20–40s | 신호대기시간은 지정시간서 제외됨 |
| 경사로 정지·출발 | ~10s | 3초 홀드 + 힐스타트 |
| S코스 장애물 회피 | ~20s | 슬라롬 감속 |
| 돌발 급정지 | ~10s | 3초 완전정지 |
| 직각주차 | ~50s | 전진진입→후진차고 |
| 평행주차 | ~50s | 후진차고 |
| 버퍼 | 나머지 | 재시도·정렬 여유 |

**결론: 직선 속도 상향이 8분 예산의 핵심.** 미션 구간만 감속하는 속도 프로파일 필요.

## 3. 코드 자산 현황 (2026-09-02 조사)

| 기능 | 상태 | 담당 파일 |
|---|---|---|
| 완주 주행 GPS RTK+IMU | ✅ 견고·실차검증 | `gps_localization/direct_localization_node.py`, `waypoint_follower/*`, `pure_pursuit_pkg/local_pure_pursuit_node.py` |
| 라이다 회피 Follow-the-Gap | ✅ 통합완료 | `lidar_clustering/*` → `/lidar/avoid_steer`,`/obstacle_distance` |
| 신호등 인식 빨강/초록 | 🟡 RPi5+Hailo(파이) | `mission_perception/pi_deploy/*`, `traffic_light_bridge.py` |
| 직각(후진) 주차 | ✅ 시뮬 99.2% | `parking_node/planner/follower.py` |
| 정지 미션 GPS 기반 | ✅ | `crosswalk_stop_node.py`, `stop_detector.py` |
| mux 단일출구·어댑터 | ✅ 견고 | `velocity_controller/vehicle_cmd_mux_node.py` |
| 원점 정본 | ✅ | `config/site_origin.yaml` (현재 대구권 — **용인으로 교체 필요**) |

**없는 것(신규 개발):** S코스 T870 2대 전용 튜닝 · 경사로 정지·출발 · **평행주차**(planner 직각만) · 신호제어 차선유지(↓/X) · 좌회전 신호교차로 판단 · 돌발 급정지(더미 감지)

## 4. 작업 트랙 (병렬)

### Track A — 완주 기반 【최우선·탈락 방지】
- **A1** 용인 `config/site_origin.yaml` 교체 + RTK/NTRIP 커버리지 확인 (용인 VRS 되는지)
- **A2** 하드웨어 안정화: **IMU USB 허브→노트북 직결**(만성 접촉불량), 조향 캘리브(center 412), 배터리
- **A3** 용인 코스 waypoint 재기록 + 차로준수 튜닝 → **이탈 0** 목표
- **A4** 속도 프로파일: 직선 가속(8분 예산), 미션 구간 감속
- **A5** 경사로 정지·출발 (신규): 위치기반 정지점 + IMU pitch 감지 + 3초 홀드 + 힐스타트(후방 50cm 밀림 방지)

### Track B — 주차 【큰 감점 회피】
- **B1** 직각주차 용인 자세 재기록(`parking_pose_recorder`) + 공터 실차 검증
- **B2** 평행주차 planner 확장 (신규 기하 — 후진 평행 진입)

### Track C — 라이다 S코스 【감점-only】
- **C1** T870 차체 2대 파라미터 튜닝 (`cluster_plot_node` 슬라롬 파라미터를 T870 규격으로)
- **C2** 공터 슬라롬 실차 검증

### Track D — 카메라 【감점-only·학습데이터 대기】
> **차단**: 학습된 데이터 수신 후 착수. 도착 전까진 대기.
- **D1** 학습 데이터/모델 수신 → Hailo HEF 통합·실물 검증
- **D2** 신호교차로 좌회전 + 신호 정지
- **D3** 신호제어 차선유지 (↓/X 신호 → 차선 선택)
- **D4** 돌발 급정지 (더미 감지 → 3초 완전정지)

## 5. 주차별 일정 (D-18)

| 주차 | 기간 | 목표 |
|---|---|---|
| **W1** | 9/2–9/8 | Track A(완주 기반) 굳히기 + B1(직각주차 용인). 공터 실차로 **이탈 0 완주** 달성 |
| **W2** | 9/9–9/15 | Track C(S코스 라이다) + B2(평행주차) + A5(경사로). 카메라 데이터 오면 D 착수 |
| **W3** | 9/16–9/18 | 통합 리허설: **8분 풀런 반복**, 미션 연결 검증, 실패시 감점 우선순위대로 취사 |
| **점검** | 9/19 | 실코스 첫 주행 — 1회뿐. waypoint 현장 재기록·정지점·주차자세 확정 |
| **본경기** | 9/20 | 실행 |

## 6. 리스크

| # | 항목 | 대응 |
|---|---|---|
| 1 | 용인 RTK 커버리지 미확인 | A1에서 최우선 확인. 안되면 전체 측위 재설계 = 최대 리스크 |
| 2 | IMU USB 접촉불량(만성) | 허브→직결 물리조치. 매 주행전 `ls -l /dev/imu` |
| 3 | 8분 시간압박 | 직선 속도 상향(A4). 못하면 미션 취사선택 |
| 4 | 카메라 데이터 도착 시점 불확실 | Track D 병렬·후순위. 최악시 신호 미션 감점 감수(탈락 아님) |
| 5 | 9/19가 실코스 첫 주행 | 시뮬+공터로 로직 굳히고 현장은 재기록·튜닝만 |

## 7. 절대 규칙 (기존 유지)

1. 매 주행 전 `ls -l /dev/imu` 확인
2. 소스 고치면 `colcon build` (`--symlink-install` 믿지 말 것)
3. **pure_pursuit/완주 로직 수정 금지** — 미션은 mux 어댑터(토픽)로만 얹는다
4. 원점(site_origin) 먼저 — 장소 바뀌면 이것부터 (150km 어긋난 전례)
5. E-stop 손에 — 매 실차
6. 매 세션 헤딩 캘리브 (IMU yaw 부팅마다 리셋)

---

**한 줄: 8분 안에 이탈·정지 없이 완주하는 게 유일한 탈락 리스크. 완주+주차부터 공터에서 굳히고, S코스(라이다)·카메라(데이터 대기)는 감점-only라 병렬 후순위로 얹는다.**
