hanmin0211/racing_ws/HANDOFF_2026-08-20.md

> ⚠️ **이 문서는 더 이상 최신본이 아니다. `HANDOFF_2026-08-22.md` 를 먼저 볼 것.**
> 여기 적힌 "엔코더 신호 없음 / ms2405 / 조향 A8" 관련 내용은 **보드 교체로 해결**됐고,
> 현재 보드는 조향 A15 + SPI 엔코더 카운터다. 이 문서는 그 시절 진단 기록으로만 참고할 것.

# HANDOFF (최신) — 2026-08-20 세션 인수인계

> **이 문서가 현재 상태의 최신본이다.** 배경/상세는 `HANDOFF.md`(08-17)를 참고하되,
> 값이 충돌하면 **이 문서와 실제 코드**를 따를 것. 08-17 문서의 "구동 병목/ff_sweep 재실행"
> 항목은 이 세션에서 **해결됨**(FF 80/95).
>
> 다음 세션(AI)은 **`## 0. 지금 당장 하던 것`부터 읽고 그대로 이어가라.** 예측하지 말고
> 측정값으로 진행할 것(사용자 강력 요구).

---

## 0. 지금 당장 하던 것 (미완결 — 여기서 이어가라)

**★ 조향은 완성됐다(커밋 f6f741d). 새 병목 = 엔코더 신호가 아두이노에 안 온다.**

### 조향 — 완료 ✅ (2026-08-20 오후, 전부 실측)
- A8 캘리브 실측: **완전왼쪽 627 / 직진중앙 282 / 완전오른쪽 0** (모터 OFF 상태에서 60샘플씩).
  옛 A15 값(center424, 0~949)은 폐기. 424 는 A8 에선 직진이 아니라 좌로 꺾인 위치였다.
- `STEER_COUNTS_PER_DEG` 21.2 → **14.1** (좌반17.25/우반14.1 비대칭 → 보수적으로 작은값).
- **모터 극성 원복**: A15 시절 했던 ENA/ENB 스왑이 A8 에선 과반전이었다.
  실측으로 확정 — +5°(목표352) 명령에 PWM +111~130 나갔는데 ADC 278→**0 폭주**. 원복 후 정상.
- `STEER_MOTOR_TEST 0` (정상 모드). 양방향 추종 실측: +15°→14.9° / −15°→−14.0° / 0°→0.7°.
  작은~중간 각도는 데드밴드(16/24) 탓 최대 3.8° 언더슈트 — 의도된 동작이라 유지.
  실트랙에서 코너를 밖으로 밀면 그때 데드밴드 12/18 로 낮출 것.
- VCC 4630~5068mV 안정 → ms2405 교체로 브라운아웃 해결됨을 재확인.
- amap 불량(Vcc 를 2.5~3.5V 로 끌어 브라운아웃)이 그동안 전원 삽질의 진짜 원인이었다는 것도 확정.

### ★ 엔코더 — 신호 없음 (현재 병목, 하드웨어 문제)
**증상**: `ENC1` 이 **정확히 0 고정**. 바퀴를 손으로 굴려도, 모터로 돌려도 안 변한다.
그래서 속도가 항상 0 으로 읽혀 **스톨가드가 정상 주행을 스톨로 오인해 700ms 만에 컷**한다
(개루프 PWM:60 테스트에서 모터는 잘 돌았는데 정확히 700ms 에 PWM 0 — DRIVE_STALL_MS 그대로).

**⚠ 엔코더가 죽은 동안 폐루프(`VEL:`) 명령 금지.** 속도가 0 으로 읽히면 PID 가 오차를 메우려
PWM 을 255 까지 밀어올린다. 그리고 이땐 바퀴가 실제로 돌고 있어 **스톨가드가 안 잡는다**.
진단은 반드시 개루프(`PWM:`)로 할 것.

**소프트웨어 진단 전수 완료 — 원인은 하드웨어다:**
1. 전원 순서 가설(HANDOFF.md:224 "배터리 먼저 ON") → **기각**. 배터리 ON 상태로 아두이노
   리셋해도 여전히 0.
2. SPI 카운터 스캔(`arduino/enc_scan/enc_scan.ino`): CS 후보 **29핀 전부 0x00 무응답**.
   MDR0 write/read-back 이 전혀 안 돌아온다 ⇒ LS7366R 카운터 칩이 응답하지 않음(= 없음).
3. A/B 직교펄스 스캔(`arduino/enc_pulse_scan/enc_pulse_scan.ino`): 모터핀(2~10) 제외 전 핀
   (11~53 + A0~A15) **무전이**. 1차에서 D17 이 뛰었지만 **바퀴 정지 상태에서도 동일**해
   노이즈로 판명(D17=Serial2 RX) — 대조군 측정이 오판을 막았다.
   ⇒ 어느 핀에도 엔코더 펄스가 도달하지 않는다.
4. **아날로그 스캔**(adc_scan.ino, 구동바퀴 굴리며 A0~A15): 회전에만 반응하는 핀 **없음**.
   (A0 가 폭 94 로 컸지만 정지 대조군에서도 52 → 뜬 핀 노이즈). ms2405 가 속도를
   아날로그 전압으로 내보내는 것도 아니다.
5. 모터핀 2~10 은 구동/조향 모터가 정상 동작하므로 엔코더 입력일 수 없다.
⇒ 디지털·아날로그 **모든 경로 배제**. ms2405 는 엔코더 신호를 아두이노로 주지 않는다.
  **A/B 를 아두이노에 직결하는 것 외에 방법이 없다.**

**사용자 확인**: 엔코더 케이블은 **ms2405 보드에 꽂혀 있다**. 그런데도 신호가 안 온다.

### 다음 순서 (물리 점검부터 — 소프트웨어로 할 것은 끝났다)
1. **ms2405 의 그 커넥터가 정말 엔코더용인지** 확인(실크스크린/매뉴얼). 다른 용도 포트에
   꽂혔을 수 있다. 보드가 엔코더 신호를 아두이노로 **중계하지 않는** 타입일 가능성도 크다.
2. **엔코더 전원(보통 5V) 이 실제로 오는지** 멀티미터로 측정.
3. **엔코더 출력선을 바퀴 굴리며 직접 측정**(멀티미터/오실로스코프). 펄스가 나오면 엔코더는
   살아있고 경로 문제, 안 나오면 엔코더/전원 문제.
4. **펌웨어는 이미 인터럽트 방식으로 전환 완료**(SPI 카운터 폐기, 컴파일 검증됨).
   **남은 건 배선뿐이다** — 엔코더 4선(5V/GND/A/B)을 아래대로 아두이노에 직결:
   ```
   엔코더1(전륜, 속도계산에 사용): A→D18, B→D19
   엔코더2(후륜, 현재 미사용)    : A→D20, B→D21
   5V→아두이노 5V, GND→아두이노 GND
   ```
   (ATmega2560 인터럽트 핀은 2,3,18,19,20,21 뿐이고 2·3 은 구동모터가 쓴다)
5. 배선 후 플래시 → **엔코더 재캘리브 필수**(henes_firmware.ino 의 counts_per_revolution
   주석 참고). `-290` 은 옛 SPI 카운터 기준이라 4체배 값·부호가 다를 수 있고,
   틀리면 속도가 통째로 어긋나 FF/PID/스톨가드가 전부 무너진다:
   ① 바퀴 1바퀴 굴려 ENC1 증가량 측정 → 절댓값 확정
   ② 전진(PWM:60)에 ENC1 이 **증가**해야 정상. 감소하면 부호 반전.
   ③ tools/encoder_calib 로 RTK 대조 보정.
6. 그다음: 구동 개루프 회전 확인 → 폐루프 속도추종 → HIL 맵주행 → 실차 완주/속도.

**엔코더 없이 가능한 것**: 조향 검증(완료), 개루프 구동. **불가능**: 속도 폐루프 = 자율주행.

---

## 1. 오늘 세션에서 해결/커밋한 것 (배경)
- **소나 오작동 수정**(랩 10분 주범): serial_bridge `publish_sonar_obstacle=False` 기본.
- **FF 상향**(2km/h 크롤링 탈출): STATIC_FF 80, VELOCITY_FF_GAIN 95, kp30/ki15/클램프±8. (플래시됨)
- **구동 스톨가드**: DRIVE_STALL_MS 700 + 쿨다운 재시도.
- **헤딩 캘리브 강건화**: 순간튐 관용/조기실패/자동재시도3회(후진X,원점복귀)/적응형트림.
- **udev 고정**: /dev/arduino, /dev/imu(CP2102 시리얼0001), /dev/ldlidar(CP2102 f072916a...).
- **라이다 회피 통합**(lidar_clustering): /obstacle_distance + /lidar/avoid_steer, 먹스 override.
  실HW 검출 검증. **슬라롬 조향융합은 실트랙 튜닝 필요**(override 이탈, 스코프 Artifact 참고).
- **HIL 맵주행**(tools/hil_vehicle.py + hil.launch.py + tools/hil.rviz): 공중 제어검증. RViz 로
  제어가 맵 완벽 추종 확인(지그재그는 제어 아니라 전원/헤딩노이즈 탓).
- **실차 완주(3.6km/h) 성공** 확인. pure_pursuit 완주 크래시 수정.
- ⚠ 조향 관련(A8 변경, 방향반전, STEER_MOTOR_TEST)은 **아직 git 미커밋** — 조향 완성 후 커밋할 것.

## 2. 하드웨어 함정 (필수)
- **ms2405 보드 = 조향센서 A8** (amap = A15). ← 현재 작업 핵심.
- 아두이노 로직 전원 = 노트북 USB. 드라이버보드가 5V 끌면 브라운아웃.
- IMU·라이다 둘 다 CP2102 → 시리얼 구분(udev).
- **numpy 1.23.5 고정 필수**(tf_transformations np.float + sklearn>=1.22).
- 라이다 baud 256000, RPLidar A1, /scan. sllidar_ros2 소스빌드됨(.gitignore).
- 공중(무부하) 테스트는 전원강하 재현 안 됨.

## 3. 펌웨어 주요값 (arduino/henes_firmware/henes_firmware.ino)
- `Steering_Sensor A8` / `STEER_CENTER 282` / `LEFT_MAX 0` `RIGHT_MAX 627` / `COUNTS_PER_DEG 14.1`
  (전부 2026-08-20 A8 실측 확정. 고ADC=물리 왼쪽, 저ADC=물리 오른쪽)
- `STEER_MOTOR_TEST 0`(정상) / steer_motor_control ENA/ENB **원복 완료**(pwm>0 → ENA=LOW,ENB=HIGH)
- FF `STATIC_FF 80, VELOCITY_FF_GAIN 95` / `velocity_kp 30, ki 15, kd 0.5`
- `MAX_DRIVE_PWM 255, ACCEL_LIMIT 0.8` / `DRIVE_STALL_MS 700`(+쿨다운재시도)
- max_speed(목표속도) 기본 2.8(bringup). 첫 실차는 1.6 권장.

## 4. 자주 쓰는 명령
```bash
# 펌웨어 플래시
cd ~/racing_ws && arduino --upload --board arduino:avr:mega:cpu=atmega2560 --port /dev/arduino arduino/henes_firmware/henes_firmware.ino
# 조향 ADC (Steering_Sensor 핀을 읽음)
ros2 run velocity_controller serial_bridge          # 터미널1
ros2 topic echo /steering_adc                       # 터미널2
# ADC 스캔(센서 핀 찾기)
arduino --upload ... arduino/adc_scan/adc_scan.ino ; python3 tools/adc_find_sensor.py
# 정상 주행(저속)
bash tools/ros_cleanup.sh && ros2 launch gps_localization bringup.launch.py control:=true auto_calib:=true rviz:=false max_speed:=1.6 calib_distance:=10.0
python3 tools/lap_timer.py
# HIL(공중 맵주행) — 바퀴 공중에!
ros2 launch gps_localization hil.launch.py max_speed:=1.0    # + python3 tools/hil_vehicle.py + rviz2 -d tools/hil.rviz
colcon build && source install/setup.bash
```

## 5. 소프트웨어 상태
| 미션 | 상태 |
|---|---|
| 기본 완주(속도) | 코드완성, 실차 완주(3.6km/h) 확인. **조향 살리면 재확인** |
| 10km/h | 전원 해결(ms2405)로 열림. 조향 후 실차 검증 |
| 라이다 회피 | 검출 실HW검증. 조향융합 실트랙 튜닝 남음 |
| 카메라 정지 | 인프라(파이+Hailo) 존재, 통합 미실시 |

## 6. 참고 링크/메모리
- 슬라롬 회피 스코프: https://claude.ai/code/artifact/dafe9492-365d-4df6-a3e5-3e78a65667c8
- 실차 테스트 종합집: https://claude.ai/code/artifact/9292b353-46a3-41b3-b32f-d84e66c4f403
- 메모리: ~/.claude/projects/-home-han-racing-ws/memory/ (numpy, 라이다통합, 조향센서A8)

---
**한 줄: 전원(ms2405)·조향(A8 캘리브 282/0~627 + 극성 원복) 둘 다 실측으로 해결 완료.
지금 막힌 곳은 딱 하나 — 엔코더 신호가 아두이노에 전혀 안 온다(SPI·펄스 전수 스캔 무응답,
소프트웨어 원인 배제됨). 다음=엔코더 배선/전원 물리 점검 → 필요시 인터럽트 핀 직결로
펌웨어 전환 → 그다음에야 구동 폐루프/HIL/실차. 예측 말고 측정으로.**

---

## 부록 (2026-08-22) — 보드/전압 정정 ★중요

### 현재 쓰는 보드 (검증 완료 — 이 설정을 유지할 것)
`Steering_Sensor A15` / `ENC1_ADD 22`(SPI 카운터) / `NO_ENCODER 0` /
캘리브 `center 412, 0~936, 20.6 counts/도`

이 보드로 **실측 검증을 모두 통과**했다:
- 조향 전 구간 오차 **0.92° 이내**(+15°→14.2°, -15°→-14.6°, 0°→0.0°), 극성 정상
- 엔코더 SPI 카운터 정상(손으로 굴려 카운트, 모터 전진 시 감소 = 부호 음수 맞음)
- 속도 폐루프 수렴 확인(VEL:0.5 → 목표 근처 안정 유지)

### ★ VCC 3.9~4.1V 는 정상이다 (이전 기록 정정)
`VCC≈3893~4062mV` 가 관측되지만 **이 차의 원래 전압대**다. 완주하던 시절에도
4018mV 였다(펌웨어 MAX_DRIVE_PWM 주석 참고). ATmega2560 의 실제 BOD 는 퓨즈 설정값
(아두이노 메가는 보통 2.7V)이라 3.9V 에서도 정상 동작한다 — 실제로 텔레메트리·조향·
엔코더가 모두 정상이다.

**주의할 점은 여유가 적다는 것**이다. 완주 시절 PWM 190 으로 올렸을 때 부하에서
3483mV 까지 떨어져 랩 종반에 리셋됐고, 111 로 낮춰 완주했다. 속도를 올릴 때는
VMIN 을 보면서 단계적으로 할 것.

※ serial_bridge 의 "⚠공급전압 강하 VMIN=3893mV" 경고와 arduino/board_id 의
  "문턱아래-주행불가" 판정은 **4300mV 기준이라 이 차에는 과한 경고**다. 무시해도 된다.

### 보드 교체 시 확인 절차
보드마다 조향센서 핀과 엔코더 카운터 유무가 다르다. 교체하면 반드시 실측할 것:
1. 조향 핀: `arduino/adc_scan/adc_scan.ino` + 앞바퀴 좌우로 돌리며 최대변동 핀 확인
2. 엔코더: `arduino/enc_scan/enc_scan.ino` 로 SPI 카운터(CS22/23) 응답 확인
3. 그 결과로 `Steering_Sensor` / 엔코더 방식 / 캘리브를 맞춘 뒤 좌/중/우 재측정

과거 관측: ms2405 계열은 조향 A8 + 엔코더 카운터 없음(RC 조종기용 보드로,
D17 에 115200 "Frame Lost or FailSafe" 를 보낸다). 그 보드를 쓸 경우
`NO_ENCODER 1`(FF 개루프 + 구동 스톨가드 off)로 완주는 가능하다 — 커밋 b557453.
