hanmin0211/racing_ws/paper/ITS논문_규정판.md

# RTK-GNSS 기반 저비용 자율주행 플랫폼의 실시간 측위 시스템 구현

## A Real-Time Localization System for a Low-Cost Autonomous Driving Platform Based on RTK-GNSS

홍 길 동\*ㆍ한국교통대학교 ○○공학과 학부생

\* 교신저자 : 성명, 소속, 직위 / E-mail

---

## 요 약

자율주행 차량의 경로 추종 성능은 측위 정확도에 직접 의존한다. 본 연구는 소형 전동 차량을 개조한 저비용 자율주행 플랫폼에 RTK-GNSS(Real-Time Kinematic GNSS) 기반 실시간 측위 시스템을 구현하고 실차 주행으로 검증하였다. 국토지리정보원 VRS(Virtual Reference Station) 보정을 NTRIP으로 수신해 cm급 측위를 확보하였으며, 이 과정에서 기존 ROS 2 패키지가 지원하지 않는 GGA 상향 전송 기능을 갖춘 전용 클라이언트를 구현하였다. 또한 자력계 오차로 지도 좌표계에 정렬되지 않는 IMU 방위각 문제를 해결하기 위해, 직진 구간의 GNSS 이동방향을 참값으로 삼아 방위각 오프셋을 추정하고 방위각 변화량 기반 폐루프 제어로 직진성을 확보하는 초기화 기법을 적용하였다. 센서 두절 시에는 마지막 위치를 유지하지 않고 측위 발행을 중단해 하위 제어기가 안전 정지하도록 설계하였다. 실차 시험에서 RTK Fixed 유지율 94.8%, 수평정확도 평균 1.4cm, 방위각 오차 1.02°를 얻었으며, 경로 추종 횡방향 오차는 직선 구간에서 평균 3~14cm였다.

**핵심어 :** RTK-GNSS, NTRIP, 자율주행, 측위, 방위각 초기화

---

## ABSTRACT

The path-tracking performance of an autonomous vehicle depends directly on its localization accuracy. This study implements and field-validates a real-time localization system based on RTK-GNSS for a low-cost autonomous driving platform converted from a small electric vehicle. Centimeter-level positioning was obtained by receiving Virtual Reference Station corrections from the National Geographic Information Institute over NTRIP; because the NTRIP client bundled with the existing ROS 2 package does not transmit the NMEA GGA sentences that the VRS service requires to generate corrections for the rover location, a dedicated client providing this capability was implemented so that the receiver converges to an RTK Fixed solution. To resolve the misalignment between the map frame and the yaw angle of a low-cost IMU affected by magnetometer error, an initialization method was applied that estimates the yaw offset by treating the GNSS course over a straight segment as the true heading; although the absolute heading is unknown at initialization, the change in heading is measured accurately by the IMU, so a closed-loop controller maintaining the initial yaw keeps the vehicle straight without knowing the absolute heading. For safety, the system stops publishing localization output when sensor data is interrupted rather than holding the last known pose, so that downstream modules detect the condition by timeout and stop the vehicle safely. Field tests achieved an RTK Fixed rate of 94.8%, a mean horizontal accuracy of 1.4 cm, and a heading error of 1.02 degrees, with a lateral tracking error of 3 to 14 cm on straight sections.

**Keywords :** RTK-GNSS, NTRIP, autonomous driving, localization, heading initialization

---

## Ⅰ. 서 론

### 1. 연구 배경 및 목적

자율주행 시스템은 인지(perception), 측위(localization), 판단·제어(planning and control)로 구성되며, 측위 오차는 그대로 경로 추종 오차로 전이된다. 차선 폭이 좁은 주행 환경에서는 수십 cm의 오차도 차선 이탈로 이어진다.

측위 방식은 GNSS 기반, LiDAR·카메라 기반 SLAM, 그리고 이들의 융합으로 구분된다. SLAM 기반 방식은 GNSS 음영에서도 동작하나 사전 지도 구축과 연산 자원을 요구한다(Kim et al., 2019). 반면 개활지에서는 RTK-GNSS만으로 cm급 정확도를 얻을 수 있어 저비용 플랫폼에 적합하다.

RTK는 반송파 위상 관측치의 미지정수를 해결해 cm급 정확도를 달성하며, 미지정수가 정수로 확정된 RTK Fixed와 실수로 남은 RTK Float의 정확도 차이는 수 cm 대 수십 cm로 크다. 보정 신호 전달에는 NTRIP(Networked Transport of RTCM via Internet Protocol)이 표준으로 쓰이며(RTCM, 2011), 다수 상시관측소 관측치로 이동체 근처에 가상 기준국을 만드는 VRS 방식이 기선 길이 문제를 완화한다.

한편 단일 안테나 GNSS는 위치는 제공하나 방위각을 직접 제공하지 않는다. 이중 안테나 방식은 정확하나 추가 수신기가 필요하고, 자력계는 모터가 근접한 소형 플랫폼에서 오차가 크다.

본 연구는 유아용 전동 차량을 개조한 저비용 플랫폼을 대상으로, VRS 기반 RTK 측위와 GNSS 이동방향 기반 방위각 초기화를 구현하고 실차 주행으로 검증한 사례를 보고한다.

### 2. 연구의 기여

본 연구의 기여는 다음과 같다.

1) VRS 보정 수신에 필요한 GGA 상향 전송을 포함한 NTRIP 클라이언트를 구현하여 기존 ROS 2 패키지의 제약을 해소하였다.

2) GNSS 이동방향 기반 방위각 초기화에 **방위각 변화량 기반 폐루프 직진 제어**를 결합하여 초기화 신뢰성을 확보하였다.

3) 센서 두절 시 측위 발행을 중단하는 안전 지향 설계를 적용하고 실주행에서 그 동작을 확인하였다.

---

## Ⅱ. 시스템 구성

### 1. 하드웨어

<Table 1> Hardware configuration

| Component | Specification | Note |
|---|---|---|
| Vehicle platform | HENES T870, wheelbase 0.785 m | Modified electric ride-on car |
| GNSS receiver | u-blox ZED-F9P | Multi-band, RTK capable |
| IMU | HandsFree A9 | 300 Hz |
| MCU | Arduino Mega 2560 | Low-level drive/steering control |
| Onboard computer | Laptop PC | ROS 2 Humble |

축거는 자전거 모델 기반 조향각 산출에 직접 사용되므로 실측하였다(0.785m).

### 2. 소프트웨어 구성

시스템은 ROS 2 Humble 기반이며 측위 데이터 흐름은 <Fig. 1>과 같다. NTRIP 클라이언트가 캐스터에 GGA를 상향 전송하고 RTCM 보정을 수신해 수신기에 주입하며, 측위 노드가 위치와 방위각을 결합해 주행 좌표계 상태를 발행한다.



<Fig. 1> Node and topic graph of the localization system

---

## Ⅲ. RTK 측위 구현

### 1. GGA 상향 전송

VRS 서비스는 이동체 위치 기준으로 가상 기준국을 생성하므로 이동체가 개략 위치를 캐스터에 알려야 한다. 그러나 `ublox_dgnss` 패키지의 기본 NTRIP 클라이언트는 RTCM 하향 수신만 지원하고 GGA 상향 전송 기능이 없다.

이에 GGA 전송을 포함한 클라이언트를 구현하였다. 동작은 (1) 캐스터에 HTTP Basic 인증으로 접속, (2) 이동체 위치를 NMEA GGA로 구성해 1초 주기로 전송, (3) 수신 RTCM3를 프레임 단위로 분리해 발행, (4) 수신기에 주입하여 RTK Fixed로 수렴하는 순서다.

초기에는 `/fix`가 있어야 GGA를 보낼 수 있고 GGA를 보내야 정밀한 `/fix`를 얻는 순환 의존이 존재하였다. 시험장 근방 고정 좌표를 파라미터로 두어 초기 GGA를 생성함으로써 이를 해소하였다. VRS는 수 km 범위에서 유효하므로 개략 좌표로 충분하다.

### 2. 좌표 변환

위경도(WGS84)를 UTM Zone 52N으로 투영하고 사전 정의한 원점을 감산해 지역 좌표를 구성한다.

$$(x, y) = \mathcal{T}_{UTM52N}(\lambda, \phi) - (x_0, y_0)$$

지역 원점은 경로 기록 노드와 측위 노드가 완전히 동일한 값을 사용해야 한다. 두 값이 다르면 전역 경로 전체가 평행이동한다. 본 연구 초기에는 이 값이 다섯 곳에 개별 정의되어 있었고, 시험 장소 변경 시 일부만 갱신되어 지역 좌표가 약 150km 어긋나는 오류가 발생하였다. 이후 단일 설정 파일로 통합하여 재발을 방지하였다.

---

## Ⅳ. 방위각 초기화

### 1. GNSS 이동방향 기반 오프셋 추정

차량이 직진할 때 GNSS 위치 변화 방향은 실제 방위각과 일치한다. 이를 이용해 오프셋을 산출한다.

$$course = atan2(\Delta n, \Delta e)$$
$$\psi_{offset} = normalize(course - \psi_{IMU})$$

여기서 $\Delta e, \Delta n$은 시작점 대비 동·북 방향 변위이다. 산출된 오프셋은 래치 토픽으로 발행되어 초기화 노드 종료 후에도 측위 노드가 참조한다. 초기화 거리는 10m로 설정하였다. 거리가 짧으면 GNSS 잡음 대비 변위 비율이 작아 추정 오차가 커진다.

### 2. 폐루프 직진 제어

초기화의 전제는 차량이 곧게 주행하는 것이다. 초기 시험에서 사람이 밀거나 원격 조종한 경우 궤적 방향 편차가 43°, 157°로 측정되어 직진성 검증에서 연속 거부되었다.

여기서 핵심은 다음과 같다. **방위각의 절대값은 아직 알 수 없으나(그것을 구하는 것이 목적이다) 출발 시점 대비 변화량은 IMU로 정확히 알 수 있다.** 따라서 출발 시점의 방위각을 유지하는 폐루프 제어는 절대 방위각을 몰라도 성립한다. 조향각 0°를 인가하는 개루프 방식은 조향 중립값이 조금만 어긋나도 궤적이 휘어 검증에 실패하나, 폐루프 방식은 이러한 기구적 편차를 자동 보상한다.

### 3. 센서 두절에 대한 안전 설계

초기 구현에서는 GNSS가 끊겨도 마지막 위치를 계속 발행하였다. 이 경우 차량은 이동하나 측위 출력은 고정되어 하위 모듈이 이상을 감지하지 못한다. 이를 다음과 같이 변경하였다.

- `/fix`가 설정 시간(1.0초) 이상 수신되지 않으면 측위 발행을 중단한다.
- IMU에도 동일한 감시를 적용한다. 실제로 주행 중 IMU 프로세스는 살아 있으나 데이터 송신이 멈추는 사례가 관측되었다.
- 발행이 중단되면 하위 모듈이 타임아웃으로 안전 정지한다.

---

## Ⅴ. 실험 및 결과

### 1. 시험 환경

한국교통대학교 충주캠퍼스 구내 총연장 99.6m 순환 경로에서 실차 주행 시험을 수행하였다. 경로는 차량을 수동 주행하며 GNSS 위치를 0.5m 간격으로 기록해 생성하였다. RTK 보정은 NGII VRS를 통해 수신하였다.

### 2. 측위 정확도

<Table 2> Localization performance in field test

| Metric | Result |
|---|---|
| RTK Fixed rate | 94.8% |
| Horizontal accuracy in Fixed (mean) | 0.014 m |
| Horizontal accuracy in Float (mean) | 0.281 m |
| Heading error after initialization (median) | 1.02° |
| Heading error before initialization (median) | 118.35° |

RTK Fixed 상태가 전체 주행의 94.8%를 차지하였고 이 구간의 수평정확도는 평균 1.4cm였다. 반면 RTK Float 구간(4.3%)에서는 수평정확도가 28.1cm로 20배 저하되었고 경로 추종 횡방향 오차도 0.31m에서 0.98m로 3배 증가하였다(<Fig. 2>). 이는 Fixed 유지 여부가 측위뿐 아니라 추종 성능까지 좌우함을 보여준다.



<Fig. 2> Localization and tracking error by RTK solution status

방위각 초기화 이후 구간에서 보고 방위각과 GNSS 이동방향의 차이는 중앙값 1.02°였다. 반면 초기화 완료 이전 구간에서는 118.35°의 차이가 나타나, 오프셋 적용 여부가 방위각 정확도를 결정함을 확인하였다.

### 3. 경로 추종 성능

주행 궤적과 기준 경로의 비교는 <Fig. 3>과 같다. 궤적 색상은 각 지점의 횡방향 오차를 나타낸다.



<Fig. 3> Vehicle trajectory colored by lateral tracking error

경로 구간별 평균 횡방향 오차와 해당 구간의 최소 곡률반경을 함께 보면 <Fig. 4>와 같다. 직선 구간(곡률반경 100m 이상)에서 횡방향 오차는 평균 3~14cm였으나, 곡률반경 3.03m의 급커브 구간에서는 87cm까지 증가하였다.



<Fig. 4> Lateral error and minimum curve radius by path segment

급커브에서의 오차 증가는 해당 구간의 lookahead 거리(2.3m)가 곡률반경(3.03m)에 육박하여 코너 인식이 지연된 것으로 판단된다. 이는 측위 정확도가 아니라 추종 제어 파라미터의 문제이며, 측위 출력이 정확하더라도 제어 파라미터가 경로 기하와 맞지 않으면 추종 오차가 발생함을 보여준다.

### 4. 안전 설계 동작 확인

주행 중 IMU 데이터 두절이 발생하였고, 설계대로 측위 발행이 중단되어 차량이 정지하였다. 두절 원인은 USB 허브 다단 연결로 확인되었으며, 커널 로그에서 통신 오류가 반복 기록되었다. 마지막 위치를 유지하는 방식이었다면 차량이 잘못된 방향으로 주행을 계속했을 것이므로, 데이터 부재를 명시적으로 전파하는 설계가 유효함을 확인하였다.

---

## Ⅵ. 결론

본 연구는 저비용 자율주행 플랫폼에 RTK-GNSS 기반 실시간 측위 시스템을 구현하고 실차 주행으로 검증하였다. 주요 결과는 다음과 같다.

1) VRS 보정 수신을 위해 GGA 상향 전송을 포함한 NTRIP 클라이언트를 구현하여 RTK Fixed 유지율 94.8%, Fixed 구간 수평정확도 1.4cm를 달성하였다.

2) GNSS 이동방향 기반 방위각 초기화에 방위각 변화량 기반 폐루프 직진 제어를 결합하여, 초기화 후 방위각 오차 1.02°를 얻었다.

3) 센서 두절 시 측위 발행을 중단하는 설계가 실주행에서 의도대로 동작하여 안전 정지를 유도함을 확인하였다.

향후 과제로는 (1) 기준점 측량 성과를 이용한 절대 정확도 평가, (2) RTK Fixed/Float 전환이 추종 오차에 미치는 영향의 정량 분석, (3) 급커브 구간의 lookahead 적응 기법 적용, (4) GNSS 음영 구간 대응을 위한 추측항법 결합이 있다.

---

## 참고문헌

1. Kim, D. G., Park, J. H. and Lee, C. W.(2019), "A study on localization for autonomous driving using LiDAR-based SLAM", *Journal of Korean Society of Intelligent Transport Systems*, vol. 18, no. 4, pp.1-12.

2. Korea Expressway Corporation, http://www.ex.co.kr, 2026.08.23.

3. National Geographic Information Institute(2024), *Guide to Real-Time GNSS Data Service* (위성기준점 실시간 데이터 서비스 이용 안내).

4. RTCM Special Committee No. 104(2011), *Networked Transport of RTCM via Internet Protocol (Ntrip) Version 2.0*, RTCM.

5. RTCM Special Committee No. 104(2016), *RTCM Standard 10403.3 for Differential GNSS Services*, RTCM.

6. u-blox AG(2022), *ZED-F9P Integration Manual*, u-blox.
