hanmin0211/racing_ws/docs/papers/논문초안_측위-경사보상_결합.md

# RTK-GNSS/IMU 로컬라이제이션과 IMU 피치 기반 경사 전방보상을 결합한 저비용 자율주행 플랫폼의 실차 검증

## Field Validation of a Low-Cost Autonomous Driving Platform Combining RTK-GNSS/IMU Localization and IMU-Pitch-Based Grade Feed-Forward Compensation

한재민 · 한국교통대학교 전자공학과 학부생

---

## 요 약

저비용 자율주행 플랫폼은 고가의 관성항법장치나 이중 안테나 없이 cm급 측위와 실차 수준의 주행 성능을 동시에 확보해야 한다. 그러나 단일 안테나 GNSS는 방위각을 직접 제공하지 못하고, 속도 되먹임이 없는 개루프 구동계는 경사 구간에서 속도가 단조 감소하거나 과속한다. 본 논문은 이 두 제약이 **단일 저가 IMU와 하나의 출발 거리 예산을 공유하는 결합 문제**임을 제시하고, IMU의 yaw를 방위각 정렬에, pitch를 중력 성분 상쇄에 각각 사용하는 통합 구조를 제안한다. 방위각은 직진 구간의 GNSS 이동방향을 참값으로 삼아 오프셋을 추정하고, 경사는 IMU 피치로부터 전방보상 PWM을 산출하며, 남는 정상편차는 역 PWM 거버너가 흡수한다. 유아용 전동 차량(축거 0.785 m)을 개조한 플랫폼으로 검증한 결과, 방위각 초기화는 직진 10.1 m에서 최대 편차 2°로 완료되었으며, 주행마다 추정된 오프셋이 39.5°와 77.2°로 달라져 매 주행 초기화가 필요함을 확인하였다. 경사 전방보상 미적용 상태의 내리막 시험에서는 제어 PWM이 +60~−51 범위를 5초 동안 4주기 왕복하며 전체 표본의 38.6 %에 역 PWM이 인가되었으나, 보상을 적용한 본선 주행에서는 271.9 초 동안 거버너 개입이 8회(평균 간격 34.0 초)에 그쳤다. 용인운전면허시험장 1종 대형 기능코스 648.3 m를 사람의 개입 없이 271.9 초(평균 2.38 m/s, 최고 4.07 m/s)에 완주하였다. 다만 개루프 구동 모델의 속도 과소 예측은 해소되지 않아 거버너가 이를 사후적으로 억제하고 있으며, 통제된 반복 실험을 통한 재검증이 필요하다.

**핵심어:** RTK-GNSS, IMU, 로컬라이제이션, 방위각 초기화, 경사 전방보상, 자율주행

---

## Ⅰ. 서 론

### 1. 연구 배경

자율주행 플랫폼의 경로 추종 성능은 측위 정확도와 구동 제어 성능에 함께 의존한다. 고가 장비를 쓰는 연구용 차량에서는 두 요소가 각각 관성항법장치와 폐루프 구동계로 독립적으로 해결되므로, 측위와 구동은 별개의 설계 문제로 다루어진다.

그러나 저비용 개조 플랫폼에서는 사정이 다르다. 비용 제약 때문에 두 기능이 **하나의 저가 IMU를 공유**하며, 출발 절차 또한 서로의 거리 예산을 잠식한다. 본 연구는 이 결합을 설계 단계에서 명시적으로 다루지 않으면 현장에서 조용한 실패가 발생함을 실측으로 보인다.

### 2. 저비용 플랫폼의 두 제약

**제약 1 — 방위각 부재.** 단일 안테나 GNSS는 위치는 제공하나 방위각을 직접 제공하지 않는다. 이중 안테나는 추가 수신기를 요구하고, 자력계는 모터가 근접한 소형 플랫폼에서 지도 좌표계에 정렬되지 않는다.

**제약 2 — 속도 되먹임 부재.** 저가 구동계는 속도 센서 없이 PWM을 인가하는 개루프 구조다. 경사 구간에서는 중력 성분만큼 가속 능력이 줄어 오르막에서 속도가 단조 감소하고, 내리막에서는 반대로 과속한다.

### 3. 두 제약의 결합

두 제약은 독립적이지 않다.

첫째, **센서를 공유한다.** IMU의 yaw는 방위각 정렬에, pitch는 경사 추정에 쓰인다. 하나의 센서가 두 기능의 신뢰도를 동시에 결정한다.

둘째, **거리 예산을 공유한다.** 방위각 초기화는 직진 구간을 요구하며, 본 연구의 구현에서는 10 m를 소비한다. 초기화가 끝나면 차량은 일단 정지하므로, 자율 주행은 s ≈ 10 m 지점에서 속도 0으로 시작한다. 시험 코스에서 경사로 입구까지의 거리가 21 m였으므로 **가속에 쓸 수 있는 거리는 11 m뿐**이었다. 초기화 구간을 늘리면 가속 거리가 줄고, 가속이 부족하면 중력을 지고 경사로 위에서 가속하게 되어 가장 불리한 조건에 놓인다.

### 4. 연구의 기여

1) 저비용 플랫폼에서 방위각 초기화와 경사 보상이 단일 IMU와 하나의 거리 예산을 공유하는 **결합 설계 문제**임을 제시하고, 이를 반영한 통합 구조를 제안한다.

2) IMU 피치 기반 경사 전방보상의 적용 전후를 동일 플랫폼의 실차 로그로 비교하여 **제어 진동 억제 효과**를 정량 검증한다.

3) 제안 구조를 1종 대형 기능코스 648.3 m 무개입 완주로 실증하고, 내리막 구간에서 GNSS 좌표 점프가 오르막 대비 2.2배 증가함을 보여 **거버너 입력을 GNSS가 아닌 엔코더로 선택한 설계 근거**를 제시한다.

---

## Ⅱ. 시스템 구성

### 1. 하드웨어

**〈표 1〉 하드웨어 구성**

| 구성요소 | 사양 | 비고 |
|---|---|---|
| 차량 플랫폼 | HENES T870, 축거 0.785 m | 유아용 전동 차량 개조 |
| GNSS 수신기 | u-blox ZED-F9P | 다중 대역, RTK 지원 |
| IMU | HandsFree A9 | 300 Hz |
| MCU | Arduino Mega 2560 | 구동·조향 하위 제어 |
| 탑재 컴퓨터 | 노트북 PC | ROS 2 Humble |

축거는 자전거 모델 기반 조향각 산출에 직접 사용되므로 실측하였다.

### 2. 소프트웨어 구조

ROS 2 Humble 기반이며, NTRIP 클라이언트가 국토지리정보원 VRS 캐스터에 NMEA GGA를 상향 전송하고 RTCM3 보정을 수신하여 수신기에 주입한다. 측위 노드는 GNSS 위치와 IMU 방위각을 결합해 주행 좌표계 상태를 발행하고, 하위 구동 노드는 IMU 피치로부터 경사 보상 PWM을 산출한다.

> ⟨그림 1⟩ 측위·구동 노드 및 토픽 구성도 *(제작 예정 — 기존 `paper/Fig1_system_graph.png` 갱신 활용 가능)*

### 3. 제작된 그림

| 파일 | 내용 | 대응 절 |
|---|---|---|
| `figs/Fig_grade_off.png` | 경사 보상 미적용 시 속도·PWM 시계열 (한계주기) | Ⅳ.3 |
| `figs/Fig_grade_on.png` | 보상 적용 본선 주행 전 구간 속도와 거버너 개입 시점 | Ⅳ.3 / Ⅳ.5 |
| `figs/Fig_gnss_jump.png` | 경사 방향별 측위 점프 분포 (CCDF) | Ⅳ.4 |

---

## Ⅲ. 제안 구조

### 1. 방위각 초기화

차량이 직진할 때 GNSS 위치 변화 방향은 실제 방위각과 일치한다. 이를 참값으로 삼아 오프셋을 산출한다.

$$course = \mathrm{atan2}(\Delta n,\ \Delta e) \tag{1}$$

$$\psi_{offset} = \mathrm{normalize}(course - \psi_{IMU}) \tag{2}$$

여기서 $\Delta e,\ \Delta n$은 출발점 대비 동·북 방향 변위이다. 초기화 거리는 10 m로 두었다. 거리가 짧으면 GNSS 잡음 대비 변위 비율이 작아 추정 오차가 커진다.

초기화의 전제는 차량이 곧게 주행하는 것이다. 여기서 **방위각의 절대값은 아직 알 수 없으나 출발 시점 대비 변화량은 IMU로 정확히 알 수 있다.** 따라서 출발 시점의 방위각을 유지하는 폐루프 제어는 절대 방위각을 몰라도 성립한다. 조향각 0°를 인가하는 개루프 방식은 조향 중립값이 조금만 어긋나도 궤적이 휘어 검증에 실패하나, 폐루프 방식은 이 기구적 편차를 자동 보상한다.

### 2. 경사 전방보상

경사각 $\theta$에서 중력의 진행방향 성분은 $g\sin\theta$이다. 구동 이득 $k$ (단위 PWM당 가속도)를 실측하면 이를 상쇄하는 전방보상 PWM은 다음과 같다.

$$PWM_{ff} = \frac{g\sin\theta}{k} \tag{3}$$

이 항을 평지 구동 모델에 가산한다.

$$PWM_{total} = (a\,v_{cmd} + b) + \gamma \cdot PWM_{ff} \tag{4}$$

여기서 $\gamma$는 보상 이득(실차 적용값 1.00), 상한은 95로 제한하였다.

**연산 순서 규정.** 정지마찰 보상은 평지 성분 $(a\,v_{cmd}+b)$에만 적용한다. 전체 합에 하한을 걸면 내리막에서 음수가 되어야 할 중력 상쇄항이 지워진다.

**가감속 피칭 분리.** 차량의 가감속 시 차체 피칭이 경사로 오인되므로, 피치 신호에 시정수 $\tau = 0.30\ \mathrm{s}$의 저역통과 필터를 적용하였다.

**부호 안전장치.** 부호가 반대이면 내리막에서 가속한다. 따라서 기본값을 꺼짐으로 두고, 평지 영점 측정과 경사로 부호 확인을 통과한 뒤에만 활성화한다.

### 3. 역 PWM 거버너

전방보상만으로는 개루프의 정상편차가 남는다. 측정 속도가 명령보다 데드밴드(0.20 m/s)를 넘어 빠르면 역 PWM을 인가한다.

$$PWM_{gov} = -\min\big(G\cdot(v_{meas} + \lambda \dot v - v_{cmd}),\ PWM_{max}\big) \tag{5}$$

실차 적용값은 $G = 300$ (초과 1 m/s당), 선행 $\lambda = 0.30\ \mathrm{s}$, 상한 60이다.

**입력 선택.** 거버너의 속도 입력으로 GNSS 위치 차분이 아닌 **엔코더 위치 차분**을 사용하였다. 근거는 Ⅳ장 3절에서 제시한다.

### 4. 거리 예산 결합

```
s=0 ──── 방위각 초기화 10 m ────► s=10 (정지) ──── 가속 11 m ────► s=21 경사로
```

초기화가 끝나면 차량은 정지하고, 상위 먹스의 타임아웃 이후 자율 제어로 인계된다. 따라서 구간 속도 상향 지점을 경사로 입구가 아니라 **s = 10 m**에 두어, 가속 슬루레이트가 평지에서 소진되도록 설계하였다. 입구에서 속도를 올리면 중력을 지고 가속하는 가장 불리한 조건이 된다.

---

## Ⅳ. 실험 및 결과

### 1. 실험 환경

**〈표 2〉 실험 구성**

| 항목 | 값 |
|---|---|
| 시험 장소 | 용인운전면허시험장 1종 대형 기능코스 |
| 경로 길이 | 648.3 m (웨이포인트 1,298점) |
| 보정 서비스 | 국토지리정보원 VRS (NTRIP) |
| 로깅 주기 | 20 Hz |
| 최대 속도 설정 | 1.6 m/s |
| 경사 보상 이득 / 상한 | 1.00 / 95 |
| 거버너 이득 / 상한 / 선행 | 300 / 60 / 0.30 s |

### 2. 방위각 초기화 정확도

**〈표 3〉 방위각 초기화 결과 (2회 주행)**

| 항목 | 2026-09-19 주행 | 2026-09-20 본선 |
|---|---|---|
| RTK 수렴 판정 (수평 σ) | 1.5 cm | 0.5 cm |
| 초기화 직진 거리 | 10.3 m | 10.1 m |
| **직진 최대 편차** | **1°** | **2°** |
| GPS course | 159.4° | 160.3° |
| IMU yaw | 120.0° | 83.1° |
| **추정 yaw_offset** | **39.5°** | **77.2°** |
| 조향 중앙 횡편차 | +0.04 m | — |
| 초기화 → AUTO 전환 | 1.5 s | 1.5 s |

주목할 점은 동일 차량·동일 절차임에도 **추정된 yaw_offset이 39.5°와 77.2°로 크게 다르다**는 것이다. 이는 자력계 오프셋이 전원 재투입과 주변 자기환경에 따라 달라짐을 의미하며, 사전 1회 캘리브레이션 값을 저장해 두는 방식이 성립하지 않고 **매 주행마다 초기화가 필요함**을 실측으로 보여준다.

### 3. 경사 보상 적용 전후 비교

동일 플랫폼에서 경사 보상 미적용(거버너 단독)과 적용 상태의 제어 거동을 비교하였다.

**〈표 4〉 경사 보상 미적용 — 내리막, 명령 속도 1.11 m/s**

| t (s) | 측정 v (m/s) | PWM |
|---|---|---|
| 1.82 | 1.38 | +60 |
| 2.29 | 1.55 | +6 |
| 2.76 | 2.59 | **−42** |
| 3.26 | 1.67 | +33 |
| 3.76 | **2.88** | **−51** |
| 4.26 | 2.24 | +33 |
| 4.76 | 2.24 | **−51** |
| 5.26 | 2.19 | +24 |
| 5.76 | 2.53 | **−42** |

**〈표 5〉 경사 보상 적용 — 본선 주행 271.9 초 중 거버너 개입 전량 (8회)**

| 개입 순번 | 거버너 출력 PWM | 비고 |
|---|---|---|
| 1~3 | −60, −60, −60 | 상한 포화 |
| 4 | +60 | 상한 포화 (구동측) |
| 5~6 | −60, −60 | 상한 포화 |
| 7 | −34 | |
| 8 | +32 | |

평균 개입 간격 **34.0 초**, 8회 중 **6회가 출력 상한(±60)에 포화**하였다.

**〈표 6〉 정량 비교 — 주의: 통제된 동일 조건 비교가 아님**

| 지표 | 미적용 (내리막 전용 시험, 6.5 s) | 적용 (본선 전 코스, 271.9 s) |
|---|---|---|
| 역 PWM 인가 표본 비율 | **38.6 %** (105/272) | — (이벤트 로깅) |
| 제어 진동 | **5초에 4주기 왕복**, 진폭 111 | 관측되지 않음 |
| 거버너 개입 빈도 | 사실상 연속 | **8회 / 271.9 s** (평균 간격 34.0 s) |
| 명령 대비 최대 초과 | 2.88 / 1.11 = **260 %** | 4.07 / 1.60 = **254 %** |
| 주행 결과 | 8 m 구간 시험 | **648.3 m 무개입 완주** |

미적용 상태에서는 제동과 구동이 번갈아 최대 출력에 가깝게 인가되는 전형적인 **한계주기(limit cycle)**가 5초 동안 4주기 관측되었다. 보상을 적용한 본선 주행에서는 동일한 지속 진동이 나타나지 않았고, 거버너 개입이 평균 34초 간격의 산발적 사건으로 줄었다.

그러나 **최대 속도 초과율은 개선되지 않았다**(260 % → 254 %). 본선 주행에서 관측된 최고 속도 4.07 m/s는 설정 상한 1.6 m/s의 2.5배이며, 거버너 개입 8회 중 6회가 출력 상한에 포화하였다. 이는 전방보상이 경사 성분을 상쇄하더라도 **평지 구동 모델 자체가 실제 속도를 과소 예측**하는 문제가 남아 있으며, 현재는 거버너가 이를 사후적으로 억제하고 있음을 의미한다.

또한 두 비교 조건은 경사·구간 길이·명령 속도가 모두 달라 **통제된 실험이 아니다.** 따라서 위 결과는 "경사 보상이 지속 진동의 발생 조건을 제거했다"는 가설을 지지하는 관측 증거로 한정하여 해석해야 하며, 동일 경사에서 보상 유무만 바꾼 반복 실험이 필요하다.

### 4. 경사 구간 GNSS 품질과 거버너 입력 선택

16 % 경사 구간의 자율 주행 로그에서 연속 측위 표본 간 좌표 변화량을 속도로 환산하여 이상치를 판정하였다. 판정 기준은 차량의 물리적 최대 속도를 고려해 6 m/s로 두었다.

**〈표 7〉 경사 방향별 측위 이상치 발생률**

| 구간 | 표본 수 | 6 m/s 초과 점프 | 비율 | 최대 점프 |
|---|---|---|---|---|
| 오르막 16 % | 3,649 | 73 | **2.00 %** | 21.4 m/s |
| 내리막 16 % | 2,585 | 115 | **4.45 %** | 431.5 m/s (21.6 m) |

내리막 구간의 이상치 발생률이 오르막의 **2.2배**였으며, 최대 점프는 단일 표본에서 21.6 m에 달하였다. 이는 RTK 해 전환 순간의 좌표 도약으로 판단된다.

이 결과는 설계상 중요한 함의를 가진다. 거버너가 GNSS 위치 차분 속도를 입력으로 사용했다면, **가장 제어가 필요한 내리막에서 가장 오염된 속도**를 입력받게 된다. 본 연구가 거버너 입력으로 엔코더 위치 차분을 선택한 근거가 여기에 있다.

**〈표 8〉 16 % 경사 자율 주행 결과 (이상치 필터 적용)**

| 구간 | 이동거리 | 소요시간 | 속도 중앙값 | 표준편차 |
|---|---|---|---|---|
| 오르막 | 108.4 m | 182 s | 1.73 m/s | 0.60 |
| 내리막 | 103.1 m | 129 s | 1.88 m/s | 0.63 |

### 5. 실차 완주

**〈표 9〉 본선 주행 요약 (2026-09-20)**

| 항목 | 값 |
|---|---|
| 경로 길이 | 648.3 m |
| **자율 주행 시간** | **271.9 s** |
| 평균 속도 | 2.38 m/s (8.6 km/h) |
| 최고 속도 | 4.07 m/s |
| 거버너 개입 | 8 회 |
| 회피 상태 전환 | 57 회 |
| 완주 시 잔여 거리 | 0.55 m |
| 사람 개입 | **0 회** |

방위각 초기화부터 완주까지 사람의 개입 없이 진행되었으며, 경로 종점에서 잔여 거리 0.55 m로 정상 종료 신호가 발행되었다.

---

## Ⅴ. 결론

본 연구는 저비용 자율주행 플랫폼에서 방위각 초기화와 경사 보상이 단일 IMU와 하나의 출발 거리 예산을 공유하는 결합 설계 문제임을 제시하고, 이를 반영한 통합 구조를 구현·검증하였다.

1) GNSS 이동방향 기반 방위각 초기화에 변화량 기반 폐루프 직진 제어를 결합하여, 직진 10.1 m에서 최대 편차 2°로 초기화를 완료하였다. 추정 오프셋이 주행마다 39.5°와 77.2°로 달라져 매 주행 초기화의 필요성을 확인하였다.

2) IMU 피치 기반 경사 전방보상을 적용한 결과, 미적용 시 5초에 4주기로 나타나던 제어 진동이 본선 주행에서는 관측되지 않았고 거버너 개입이 평균 34초 간격의 산발적 사건으로 감소하였다. 다만 최대 속도 초과율은 개선되지 않았다.

3) 내리막 구간의 GNSS 좌표 이상치 발생률이 오르막의 2.2배임을 확인하여, 거버너 속도 입력을 엔코더로 선택한 설계를 실측으로 뒷받침하였다.

4) 1종 대형 기능코스 648.3 m를 271.9 초에 무개입 완주하였다.

**한계 및 향후 과제.** 첫째, 개루프 구동 모델은 실제 속도를 크게 과소 예측한다. 설정 상한 1.6 m/s에서 최고 4.07 m/s가 관측되었고 거버너 개입 8회 중 6회가 출력 상한에 포화하였다. 현재 구조는 이 편차를 거버너가 사후적으로 흡수하고 있을 뿐이므로, 모델 자체의 정밀화 또는 속도 되먹임 도입이 필요하다. 둘째, 경사도를 직접 계측하는 채널이 로그에 포함되지 않아 운동방정식 역산에 의존하였다. 셋째, 경사로에서의 정지 후 재출발(역주 방지)은 본 연구 범위 밖이다. 넷째, 경사 보상 적용 전후 비교는 동일 경사·동일 명령 속도 조건에서 반복한 것이 아니므로, 통제된 반복 실험을 통한 재검증이 필요하다.

---

## 참고문헌

*(작성 필요 — 10~15편, KCI·IEEE 및 표준 문서 권장)*

1. RTCM Special Committee No. 104(2011), *Networked Transport of RTCM via Internet Protocol (Ntrip) Version 2.0*, RTCM.
2. RTCM Special Committee No. 104(2016), *RTCM Standard 10403.3 for Differential GNSS Services*, RTCM.
3. 국토지리정보원(2024), 『위성기준점 실시간 데이터 서비스 이용 안내』.
4. u-blox AG(2022), *ZED-F9P Integration Manual*, u-blox.

---

---

# 부록 A. 검증 상태표 — 제출 전 반드시 확인

| # | 본문 서술 | 근거 | 상태 |
|---|---|---|---|
| 1 | RTK 수렴 σ 1.5 cm / 0.5 cm | console.log (9/19, 9/20) | ✅ 실측 |
| 2 | 초기화 10.3 m·편차 1° / 10.1 m·편차 2° | console.log | ✅ 실측 |
| 3 | yaw_offset 39.5° / 77.2° | console.log | ✅ 실측 |
| 4 | 경로 648.3 m, 1,298점 | console.log | ✅ 실측 |
| 5 | 자율 주행 271.9 s | AUTO 375.08 → 완주 646.93 | ✅ 산출 |
| 6 | 최고 4.07 m/s, 평균 2.38 m/s | pose 로그 97건 | ✅ 실측 |
| 7 | 거버너 개입 8회 | console.log | ✅ 실측 |
| 8 | 회피 상태 전환 57회 | console.log 상태 변화 집계 | ⚠ **집계 기준 확인 필요** (요약본에는 40회로 기재) |
| 9 | 미적용 PWM +60~−51, 초과 260 % | ramp_4키로_2349.csv | ⚠ **해당 로그의 경사보상 OFF 여부 확인 필요** (RAMP_RUNBOOK 9/18 기준 "grade_ff 실차 미검증"이므로 9/17 로그는 OFF로 추정) |
| 9-1 | 본선 거버너 8회 중 6회 상한 포화 | race_finish/console.log | ✅ 실측 |
| 9-2 | 최대 초과율 260 % → 254 % (미개선) | 양 로그 | ✅ 산출 — **본문에 한계로 명시함** |
| 10 | 역 PWM 38.6 % (105/272) | ramp_4키로_2349.csv | ✅ 산출 |
| 11 | 이상치 2.00 % / 4.45 % | up16_0404, down16_0409 | ✅ 산출 |
| 12 | 16 % 경사 표기 | 파일명 기반 추정 | ⚠ **실제 경사도 확인 필요** |
| 13 | k (구동 이득), 식 (3) | RAMP_RUNBOOK 기재 0.0202 m/s²/PWM | ⚠ **원 측정 근거·조건 확인 필요** |
| 14 | 평지 모델 계수 a, b | ff_gain 42.6 / ff_static 46.0 | ⚠ **본문 식 (4)에 수치 명시 여부 결정** |
| 15 | τ = 0.30 s 저역통과 | 요약본 기재 | ⚠ **코드 확인 필요** |
| 16 | 축거 0.785 m, HENES T870 | 기존 문서 | ✅ |
| 17 | 표 4·5가 서로 다른 경사·다른 날짜 | — | ⚠ **본문 한계에 명시함. 통제 실험 권장** |

## 부록 B. 남은 작업

| 순서 | 작업 | 비고 |
|---|---|---|
| 1 | 위 ⚠ 6건 확인 | 특히 #9, #12, #13 |
| 2 | 그림 4장 제작 | 시스템 구성도 / ON·OFF PWM 비교 / 주행 궤적 / 속도 프로파일 |
| 3 | 참고문헌 10~15편 보강 | GNSS/INS, 경사 보상, 경로 추종 분야 |
| 4 | 학회 양식 적용 | 제출처 템플릿 |
| 5 | 통제 반복 실험 (선택) | 동일 경사에서 ON/OFF 각 3회 |
