hanmin0211/racing_ws/paper/요약본_2026추계/학부논문경진대회-요약본.md

# RTK-GNSS 측위와 경사 전방보상·라이다 회피를 통합한 저비용 자율주행 플랫폼의 실차 실증

## Field Validation of a Low-Cost Autonomous Driving Platform Integrating RTK-GNSS Localization, Grade Feed-Forward Compensation, and LiDAR-Based Obstacle Avoidance

성 명
(한국교통대학교 ○○공학과, 학부생)

---

## 논 문 요 약

자율주행 연구·경진용 플랫폼은 고가 장비 없이도 cm급 측위와 실차 수준의 주행 성능을 확보할 필요가 있다. 그러나 저비용 개조 플랫폼에서는 측위 정확도뿐 아니라 속도 되먹임이 없는 구동계의 개루프 특성과 경로 자체의 기하학적 실현 가능성이 실제 주행 성패를 가른다. 본 연구는 유아용 전동 차량(축거 0.785m)을 개조한 저비용 플랫폼에 ① VRS 기반 RTK-GNSS 측위와 방위각 초기화, ② IMU 피치를 이용한 경사 전방보상, ③ 라이다 Follow-the-Gap 회피를 하나의 ROS 2 구조로 통합하고 실차 주행으로 검증한 사례를 보고한다.

**측위.** 국토지리정보원 VRS 보정을 NTRIP으로 수신하되, 기존 ROS 2 패키지가 제공하지 않는 NMEA GGA 상향 전송 기능을 갖춘 전용 클라이언트를 구현하여 RTK Fixed 수렴을 확보하였다. 단일 안테나 GNSS는 방위각을 직접 제공하지 않고 소형 플랫폼의 자력계는 모터 간섭으로 오차가 크므로, 직진 구간의 GNSS 이동방향을 참값으로 삼아 방위각 오프셋을 추정하였다. 이때 절대 방위각은 아직 알 수 없으나 그 변화량은 IMU로 정확히 알 수 있다는 점을 이용하여, 출발 시점의 방위각을 유지하는 폐루프 직진 제어를 초기화 주행에 결합함으로써 조향 중립 편차로 개루프 방식이 실패하던 문제를 해소하였다. 실차 시험에서 RTK Fixed 유지율 94.8%, 수평정확도 평균 1.4cm, 초기화 후 방위각 오차 1.02°를 얻었다.

**구동.** 저비용 구동계는 속도 되먹임 없이 PWM을 인가하므로 경사 구간에서 속도가 단조 감소하다 정지한다. 이에 IMU 피치 θ로부터 중력 성분을 상쇄하는 전방보상항 PWM = g·sinθ/k (k = 0.0202m/s²/PWM, 실측)를 평지 구동 모델에 더하고, 내리막에서는 엔코더 위치차분 속도를 입력으로 하는 역 PWM 거버너를 자세 게이트와 함께 적용하였다. 가감속 시의 차체 피칭이 경사로 오인되는 오염은 저역통과(τ = 0.30s)로 분리하였으며, 정지마찰 보상은 평지 성분에만 적용하여 내리막에서 중력 상쇄가 지워지지 않도록 연산 순서를 규정하였다. 이 구성으로 최대 15.4% 경사의 오르막·내리막 양방향 주행에 성공하였다.

**경로와 회피.** 수동 주행으로 기록한 원경로는 최소 곡률반경 1.38m로 29.6°의 조향을 요구하여 물리 한계 18°를 넘었으므로, 곡률 제약 평활화를 적용해 최소 곡률반경 2.71m·요구 조향 16.2°로 낮추어 기구학적 실현 가능성을 먼저 확보하였다. 라이다 군집화와 Follow-the-Gap으로 산출한 회피 조향은 단일 출구 명령 먹스(mux)의 한 입력으로 두어, 이미 검증된 전역경로 추종 코드를 수정하지 않고 우선순위만으로 얹는 계층 구조를 취하였다.

**실증.** 2026년 9월 20일 용인운전면허시험장 1종 대형 기능코스(총 연장 648.3m)에서 사람의 개입 없이 완주하였다(주행 272초, 지정시간 8분). 주행 중 최고 속도 4.07m/s, 라이다 회피 전환 40회, 내리막 거버너 개입 8회가 기록되었다. 본 연구는 저비용 플랫폼에서 경로·측위·구동·회피를 서로 분리 가능한 계층으로 통합하는 설계가 실차 환경에서 유효함을 보이며, 특히 개루프 구동 플랫폼의 경사 대응과 경로의 곡률 제약이 측위 정확도와 동등한 수준의 주행 성패 요인임을 실측으로 제시한다.

**핵심어:** RTK-GNSS, 자율주행, 경사 전방보상, 장애물 회피, ROS 2

사사:
