hanmin0211/racing_ws/frames_2026-07-08_08.33.08.pdf

view_frames Result

Recorded at time: 1783467188.6007795

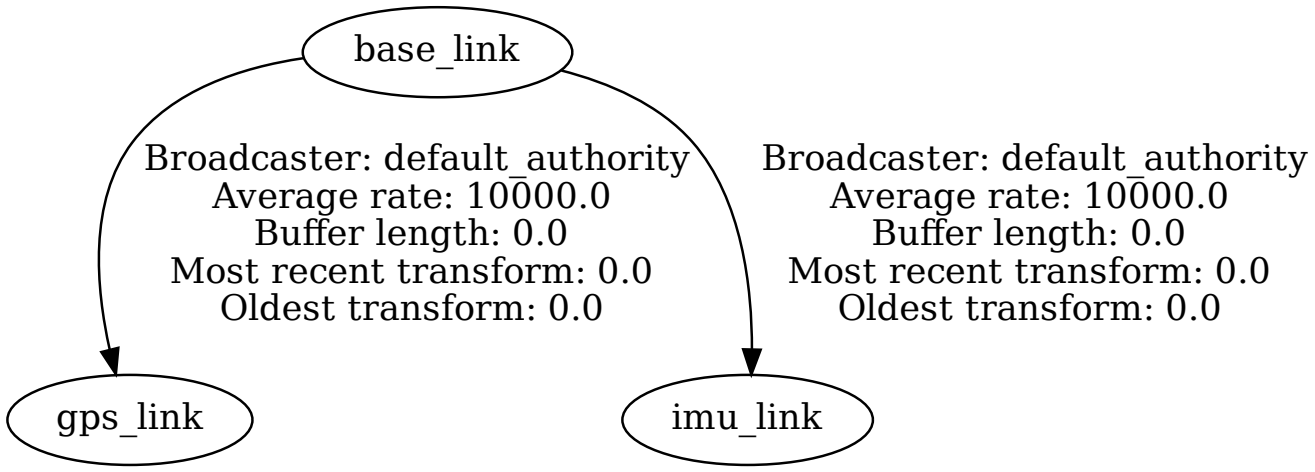
[picture p12: figure]
base_link; gps_link; Broadcaster: default_authority Average rate: 10000.0 Buffer length: 0.0 Most recent transform: 0.0 Oldest transform: 0.0; imu_link
