hanmin0211/racing_ws/frames_2026-07-20_09.49.30.pdf

view_frames Result

Recorded at time: 1784508570.4076037

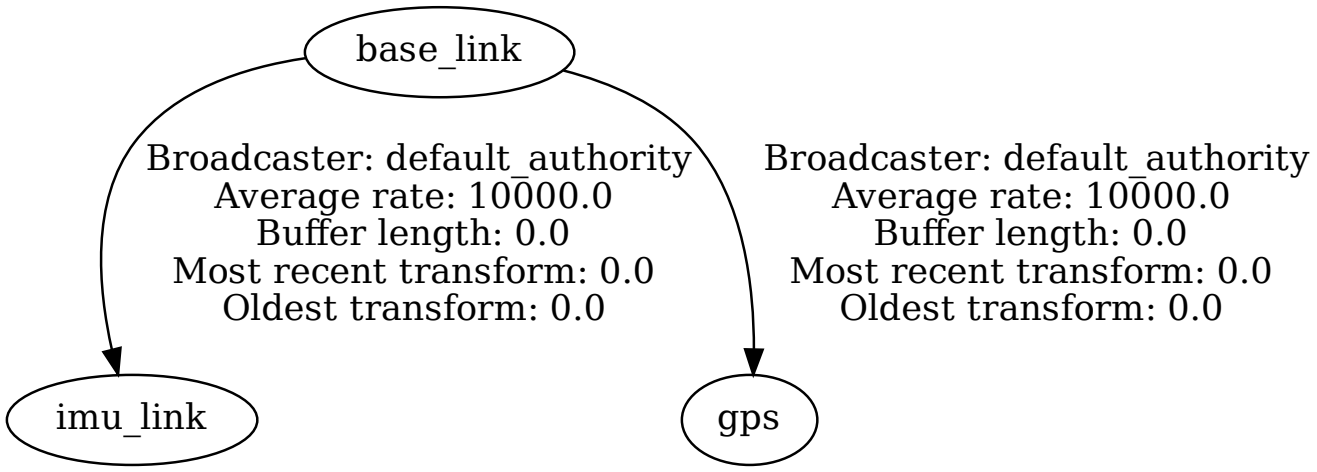
[picture p13: figure]
base_link; imu_link; Broadcaster: default_authority Average rate: 10000.0 Buffer length: 0.0 Most recent transform: 0.0 Oldest transform: 0.0; gps
