hanmin0211/racing_ws/frames_2026-07-24_13.27.38.pdf

view_frames Result

Recorded at time: 1784867258.0163524

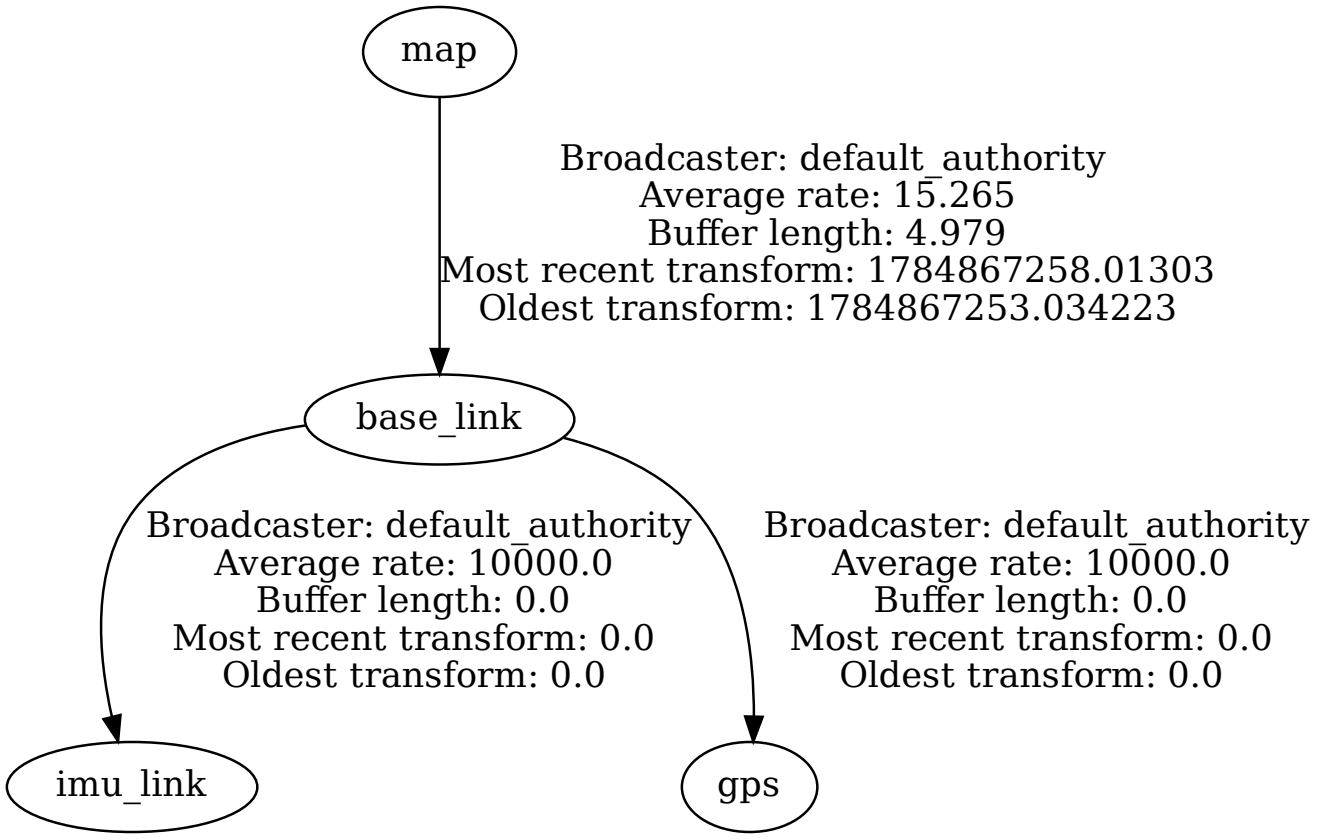
[picture p14: figure]
base_link; imu_link; Broadcaster: default_authority Average rate: 10000.0 Buffer length: 0.0 Most recent transform: 0.0 Oldest transform: 0.0; gps; map; Broadcaster: default_authority Average rate: 15.265 Buffer length: 4.979 Most recent transform: 1784867258.01303 Oldest transform: 1784867253.034223
