hanmin0211/racing_ws/paper/fig1_tall.pdf

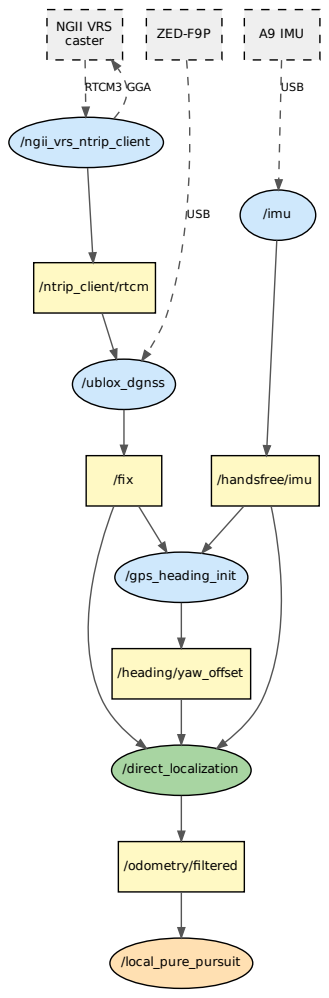
[picture p15: figure]
NGII VRS caster; /ngii_vrs_ntrip_client; RTCM3; ZED-F9P; /ublox_dgnss; USB; A9 IMU; /imu; GGA; /ntrip_client/rtcm; /fix; /handsfree/imu; /gps_heading_init; /heading/yaw_offset; /direct_localization; /odometry/filtered; /local_pure_pursuit
