hanmin0211/racing_ws/config/yongin_2026-09-05/README.md

# 용인운전면허시험장 — 2026-09-05 현장 기록

**원점**: `(332200.0, 4128600.0)` EPSG:32652 — `config/site_origin.yaml` 과 동일해야 한다.
모든 파일에 원점 스탬프가 들어 있어 `global_path_publisher` 가 다른 장소 파일을 거부한다.

## 파일

| 파일 | 내용 |
|---|---|
| `wp_yongin.yaml` | 1차 기록 원본 (GPS 들고 **걸어서**, 1m 간격, 664점 702.0m) |
| `wp_yongin_resampled_0.5.yaml` | 위를 0.5m 리샘플 (1405점 700.9m). **되꺾임 2개 포함 — 그대로 쓰면 안 됨** |
| `wp_yongin_A_smooth.yaml` | 걸은 경로에서 주차구간 앞부분만 잘라 평활화 (581점 289.7m) |
| `wp_yongin_B_smooth.yaml` | 주차구간 뒷부분 (723점 360.7m) |
| `wp_yongin_drive_raw.yaml` | 2차 기록 (1302점 650.3m) |
| **`wp_yongin_drive_0.5.yaml`** | **★ 주행용 최종본** (1298점 648.3m) |
| `wp_yongin_map.png` | 1차 기록 시각화 (되꺾임·급커브 표시) |

## 주행용 최종본

```
wp_yongin_drive_0.5.yaml
  1298점 · 648.3m · 간격 0.5m
  되꺾임 0개 · 못 도는 커브 0개 · 최소R 2.71m (필요타각 16.2° < 상한 18°)
  시작 (56.09, 5.39)  종점 (54.15, -15.54)
```

## ★ 주차 구간이 빠져 있다 (의도된 것)

1차 기록에 **되꺾임(cusp) 2개**가 있었다:

```
s=314.0m  (18.97, -44.39)  헤딩 -113.7° → +41.8°   (155° 반전)
s=326.0m  (27.84, -42.01)  헤딩  -26.1° → +153.8°  (180° 반전)
```

전진 주차 후 후진 주차를 하는 구간이라 **걸어서 들어갔다 나온 자리**다.
경기규정 항목 6·8 도 "후진으로 차고에 진입하여 뒷바퀴가 확인선을 접촉하고
전진으로 진입확인선을 통과" 라고 되어 있어 **웨이포인트로 표현할 수 없다**.

`pure_pursuit` 은 전진 전용이라 경로가 차 뒤로 이어지면 정지한다
(`local_pure_pursuit_node.py`: `lookahead가 차량 뒤/너무 가까움`).

→ 이 구간은 `parking_node` 가 `parking_pose_N.yaml` 을 보고 **그 자리에서** 궤적을
   만든다. 경로 파일에서는 도려낸다 (`tools/split_path.py`).

## 아직 없는 것 (다음 현장에서)

- `parking_pose_1/2.yaml` — 주차 완료 자세. **현재 저장소의 것은 8/24 대구 값이다**
- `parking_exit_1/2.yaml` — 진입확인선 통과 자세 (규정 항목 6·8)
- `stop_points_yongin.yaml` — 경사로 검지구역·신호교차로 정지선·돌발 기준선
- 라이다 스캔 bag — 주차칸(라바콘)·S코스
- `config/mission_plan.yaml` 의 미션별 s 값 (`tools/mission_s.py` 로 추출)
