hanmin0211/racing_ws/HANDOFF_2026-09-12.md

# 인계 — 2026-09-12 (라이다 실물 연결 / 회피 수정)

이전: `HANDOFF_2026-09-11.md` (8분 예산·완주 가능성·5일 계획은 그쪽)
대회까지 **D-7** (9/19 기능점검, 9/20 본경기)

---

## 0. 한 줄

라이다 두 대를 실제로 물려 **마운트 방향을 실측 확정**했고, 그 과정에서
**시뮬로는 절대 안 나오는 결함 두 개**를 잡았다. 회피 알고리즘도 고쳐
시뮬 기준 0/9 → 7/9 통과. 다만 **회피 판단(AVOID)은 아직 한 번도 못 봤다** —
실내가 사방 0.25~0.47m 로 막혀 계속 BLOCKED 였다.

---

## 1. 장치 — 라이다가 **두 대**였다 (앞뒤)

| | CP2102 시리얼 | 라이다 S/N | 심볼릭 링크 |
|---|---|---|---|
| **전방** | `f072916a…` | `B2E1FA86…` | `/dev/ldlidar`, `/dev/ldlidar_front` |
| **후방** | `3f70bf12…` | `BBCBFA89…` | `/dev/ldlidar_rear` |

⚠ IMU 도 같은 CP210x 라 `/dev/ttyUSB` 번호가 **꽂는 순서로 뒤바뀐다.**
실제로 전방이 ttyUSB0 → ttyUSB2 로 스왑되는 걸 확인했다. udev 규칙(시리얼 고정)이
`/etc/udev/rules.d/99-ldlidar.rules` 에 들어갔고 검증됐다. **번호로 지정하지 말 것.**

띄우기: `ros2 launch lidar_clustering lidar_dual.launch.py`
  → `/scan_front` (11Hz) · `/scan_rear` (10.7Hz) · `/scan` 은 **없다**

두 대를 예전 방식으로 띄우면 **둘 다 `/scan` 에 발행**해서 전방 회피가 뒤쪽
물체에 반응한다 = 이탈 = 탈락. 그래서 토픽·프레임·노드이름을 전부 분리했다.
검증: `/scan_front` 구독 1 · `/scan_rear` 구독 0, 같은 각도 빈 355개 평균 차이 1.24m
(= 서로 다른 장면을 본다).

### 전방 마운트 방향 — 실측 확정
`tools/lidar_orient.py --moving 8` (정면 1.5m 에 사람이 좌우로 흔듦)
→ 원본각 **−167.6°**, 변동폭 1.37m, 91스캔 → **`fg_yaw_offset_deg 180`** (기본값이 맞다)
덩어리 분석으로도 사람 크기 둘이 +175.6°/−173.0° 에 있어 같은 결론.
**개체를 바꾸면 다시 잴 것.** 이 값이 틀리면 회피가 장애물 쪽으로 꺾는다.

---

## 2. ★ 시뮬로는 안 나오던 결함 두 개

### (1) 노드가 반쯤 죽어 있었다
메서드 정의를 `__init__` **중간에** 끼워 넣어서, 그 뒤 초기화가 전부 그 메서드
본문이 되어 있었다. 퍼블리셔 3개와 `/scan` 구독이 통째로 생성되지 않았다.
**프로세스는 멀쩡히 살아 있는데 토픽이 하나도 안 나온다** — 크래시가 아니라
`__init__` 이 조용히 일찍 끝난 것이라 에러도 안 남는다.

시뮬 하네스는 `FollowGapPlanner` 를 직접 import 해서 쓰므로 노드를 안 거친다.
그래서 오프라인 검증을 전부 통과했고 **실제 노드를 처음 띄운 날 드러났다.**

### (2) 안전버블이 장애물의 **한 점**에만 씌워지고 있었다
`_apply_safety_bubble` 이 최근접 점 하나에만 버블을 씌웠다. 길이 1.3m 짜리
박스는 각도를 넓게 차지하는데 그 나머지가 보호되지 않아, **갭의 가장자리가 곧
박스 모서리**였다. 모든 점에 각자 거리로 버블을 씌우도록 고쳤다.
→ 장애물 최소간격 0.00m(접촉) → **0.28m**.

---

## 3. 회피 알고리즘 — 겨냥점을 경로 기준으로

갭 안에서 '가고 싶은 방향' 에 가장 가까운 각을 고르되, 그 기준을:

| `fg_aim` | 기준 | 학교 트랙 9배치 |
|---|---|---|
| `center` | 갭의 한가운데 (원형) | **0/9** — 차선 1.0~2.9m 이탈 |
| `nearest` | 직진 0° | 4/9 — 지난 뒤 벗어난 채 직진 |
| **`path`** (기본) | **경로가 원하는 방향** | **7/9** — 여유 0.28m, 최대이탈 0.39~0.86m |

`path` 는 `plan(target_deg=)` 으로 pure pursuit 의 `/steering_cmd` 를 받는다.
못 받으면 0 으로 폴백해 `nearest` 와 같아진다.
실패한 2건은 간격 4m 뿐(장애물 길이 1.3m 를 빼면 사이가 2.7m 인 극단).

⚠ **이 숫자는 전부 내가 만든 합성 라이다 + 추측 장애물 치수(1.30×0.78m) 다.**
현장 실측 치수로 다시 돌릴 것:
`python3 tools/avoid_on_track.py --waypoints <코스> --auto 3 --length L --width W --spacing S --offset O`

---

## 4. 막힘 탈출 — 고착은 두 종류였다

**BLOCKED 고착**: 갭이 없어 서면 스캔이 안 바뀌어 영원히 BLOCKED.
**AVOID 고착**: AVOID 일 때도 `obstacle_distance = front_distance` 라 종방향이
차를 세우는데, 안 나가니 스캔이 안 바뀐다. 학교 트랙에 장애물 3개를 놓았더니
**400초에 7m** 만 갔다. 둘 다 1분 이상 정지 = **탈락**이다.

  `blocked_escape_s` **8초** (3초는 돌발 급정지의 '3초 이상 정지'와 겹쳐서 위험)
  `stuck_distance` **1.2m** — 차가 실제로 서는 거리는 obs_stop(0.8)이 아니라
    **1.0m** 다. `0.8·(d−0.8)/3.2 = 0.05` 에서 v 가 0 으로 떨어지기 때문.
  AVOID 고착 탈출 시에는 **조향을 유지**한다(속도만 푼다). GPS 조향으로
    되돌리면 장애물 쪽으로 되돌아간다.

부수 효과: 시퀀서 없이 더미를 만나도 8초 서 있다가 빠져나가므로 규정의
'3초 이상 완전정지' 를 자동으로 충족한다.
**실제 라이다에서 동작 확인함** (실내 BLOCKED → 8초 → `BLOCKED(ESCAPE)`, obs 999).

---

## 5. 스캔 워치독

토픽 이름이 어긋나면 이 노드는 **아무 말 없이 라이다가 없는 것처럼** 동작한다
(회피도 전방정지도 조용히 사라진다). 2초마다 구독 토픽 이름을 박아 경고한다.
시작 로그에도 설정을 박았다: `(scan=/scan_front, yaw_offset=180°, aim=path)`

`hil.launch.py` / `bringup.launch.py` 에 `scan_topic` 인자 추가(기본 `/scan_front`).
한 대만 띄웠으면 `scan_topic:=/scan` 으로 줄 것.

---

## 6. 학교(충주) 시험 환경

- `config/chungju_school/wp_school_track_0.5.yaml` — 179점 88.0m 닫힌 루프.
  git 이력 커밋 `16ded96` 에서 복원했다(8/17 대구 기록이 같은 파일명으로 덮어썼었다).
- **`site_origin` 을 충주로 바꿔 뒀다.** 대회 전 `bash tools/use_site.sh yongin` 으로
  되돌릴 것. 안 되돌리면 용인 경로가 219km 밖으로 판정돼 차가 안 움직인다.
- 직선 구간: s 0.0~23.5m(캘리브 10m 와 겹침) · **s 37.5~54.0m** · s 79.5~88.0m
  → 장애물은 **둘째 직선(s 39/45/51)** 에 놓을 것. 첫 직선은 캘리브와 겹친다.
- ⚠ 캘리브 자동직진은 `/teleop/cmd_vel` 로 나가는데 먹스의 TELEOP 분기는
  **전방 정지도 회피도 안 거친다.** 캘리브 주행 중엔 앞에 뭐가 있어도 들이받는다.
  (parking_node 도 같은 토픽을 쓰므로 여기에 장애물 정지를 넣으면 안 된다)

---

## 7. 다음에 할 것 (우선순위)

1. **차 앞 좌우 1.4m·앞 3m 비우고 AVOID 판단 확인** ← 오늘 못 한 것.
   지금까지 회피 판단을 **한 번도 못 봤다**. 실내가 사방 0.25~0.47m 로 막혀 있었다.
   `ros2 run lidar_clustering cluster_plot_node --ros-args -p scan_topic:=/scan_front`
   → `CLEAR` 뜨는지 → 사람이 서면 `AVOID` + 비켜갈 각도가 나오는지
2. **배터리 연결** → 조향 추종·스톨 4%·전원 한계 (공백 셋이 한 번에 열린다)
3. **펌웨어 플래싱** (조향 스톨 상수 4개, 컴파일 통과·업로드 안 함)
4. **지상 주행** → 진짜 회피 검증. HIL + 실제 라이다로는 차가 안 움직여
   스캔이 고정이라 '체인이 반응하는가' 까지만 나온다.
5. 용인 현장 — 미션 s, 주차 자세, 정지선, **S코스 장애물 실측 치수**

## 8. 후방 라이다

용도 미정. 지금은 `/scan_rear` 로 분리만 해 두고 **아무도 구독하지 않는다**
(동작 변화 없음). 후진주차 안전(뒷범퍼 경계석 접촉 10점)에 쓸 수 있지만,
회피 시야를 넓히는 용도로는 쓰면 안 된다 — 뒤 물체에 조향을 뺏기면 이탈이다.
