hanmin0211/racing_ws/paper/실험결과_상세자료.md

# 실험 결과 상세 자료

주행 로그: drive_20260823_015757.csv / 전체 10308행 / 주행중 4960샘플

## 1. 횡방향 오차 분포

| Group | n | Mean | Median | 90th | 95th | Max |
|---|---|---|---|---|---|---|
| All (moving) | 4960 | 0.336 | 0.182 | 1.064 | 1.107 | 1.336 |
| RTK Fixed | 4704 | 0.309 | 0.175 | 0.999 | 1.103 | 1.157 |
| RTK Float | 211 | 0.977 | 1.073 | 1.084 | 1.333 | 1.336 |
| RTK Single | 45 | 0.235 | 0.169 | 0.548 | 0.684 | 0.718 |

(단위: m)

## 2. 경로 곡률 구간별 성능

| Curve radius | n | Mean error | 95th | Max |
|---|---|---|---|---|
| < 3.5 m (sharp) | 64 | 0.983 | 0.993 | 0.994 |
| 3.5-10 m | 727 | 0.355 | 0.990 | 0.997 |
| 10-30 m | 1394 | 0.132 | 0.408 | 0.983 |
| > 30 m (straight) | 2518 | 0.376 | 1.138 | 1.157 |

(단위: m)

## 3. RTK 품질

| Status | n | Ratio | h_acc mean | Lateral error mean |
|---|---|---|---|---|
| FIX | 4704 | 94.8% | 0.014 m | 0.309 m |
| FLOAT | 211 | 4.3% | 0.281 m | 0.977 m |
| SINGLE | 45 | 0.9% | 0.768 m | 0.235 m |

## 4. 방위각 오차

| Condition | n | Median | Std. dev. |
|---|---|---|---|
| Before initialization | 225 | -134.71° | 10.32° |
| After initialization | 4627 | +1.02° | 8.86° |

## 5. 주행 요약

- 주행 시간: 338 s
- 평균 속도: 0.69 m/s (2.5 km/h), 최대 2.76 m/s
- 조향 명령: 절대평균 3.09°, 최대 14.74° (물리 한계 18°)
- 조향 포화 발생: 0 회
