hanmin0211/racing_ws/paper/fig3_section_error.pdf

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

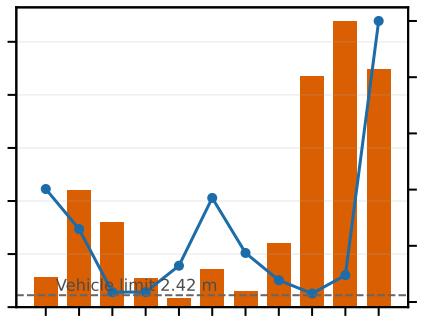
[picture p16: figure]
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
