hanmin0211/racing_ws/config/yongin_2026-09-05/wp_yongin_map.png

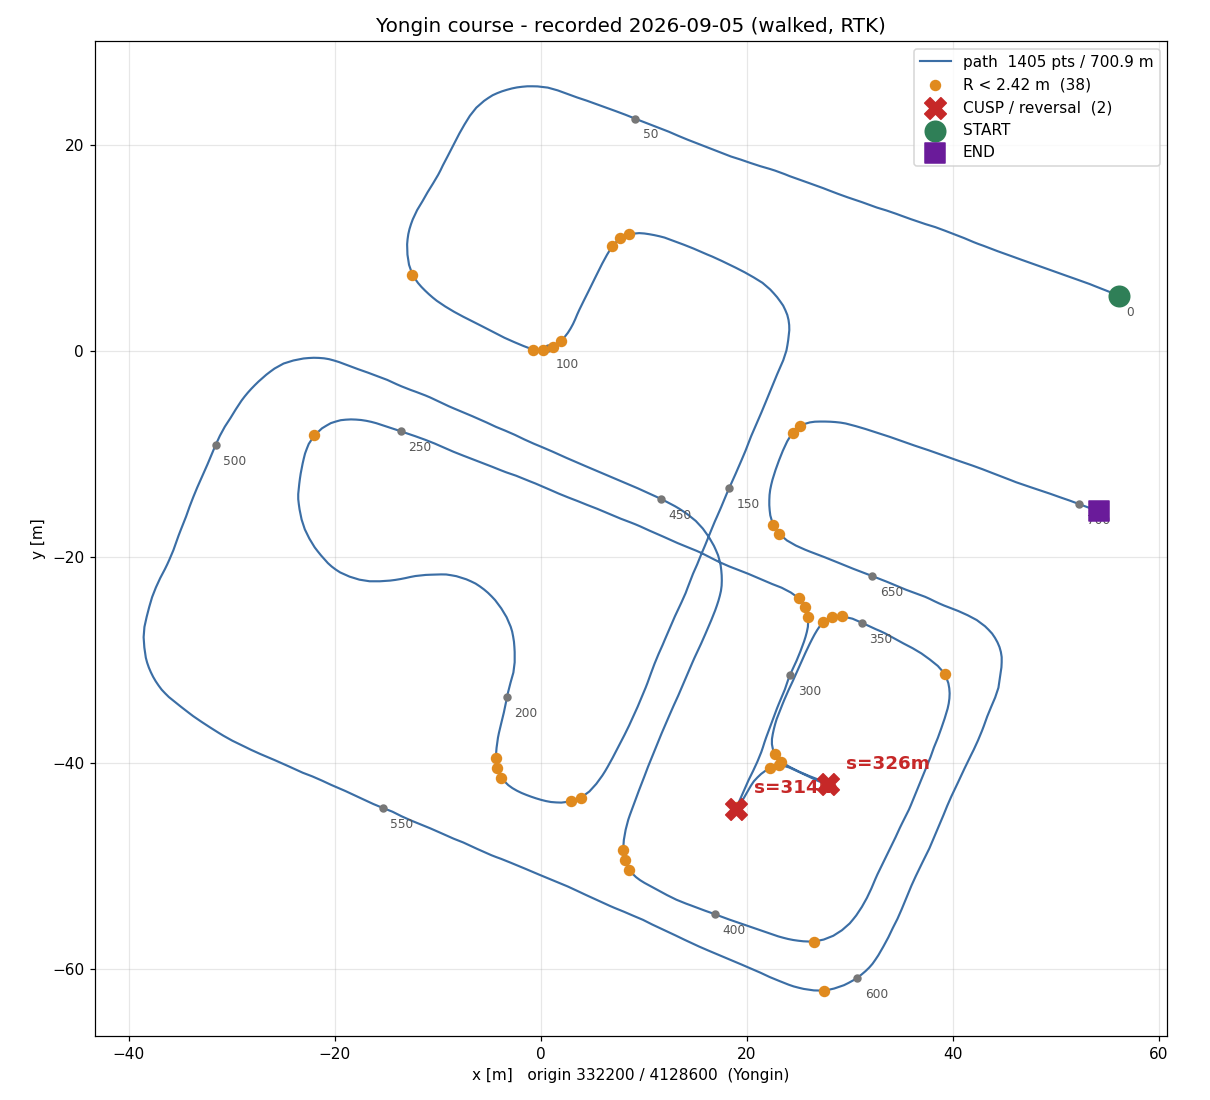
config/yongin_2026-09-05/wp_yongin_map.png
