hanmin0211/racing_ws/data/2026-09-17/traffic_frames/CONFIRMED_GREEN_horizontal.jpg

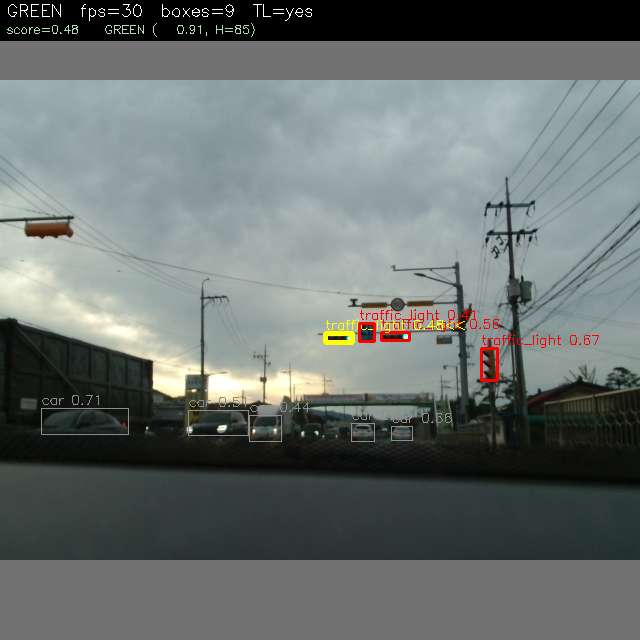
data/2026-09-17/traffic_frames/CONFIRMED_GREEN_horizontal.jpg
