hanmin0211/racing_ws/data/2026-09-17/traffic_frames/TL_GREEN_0171.8.jpg

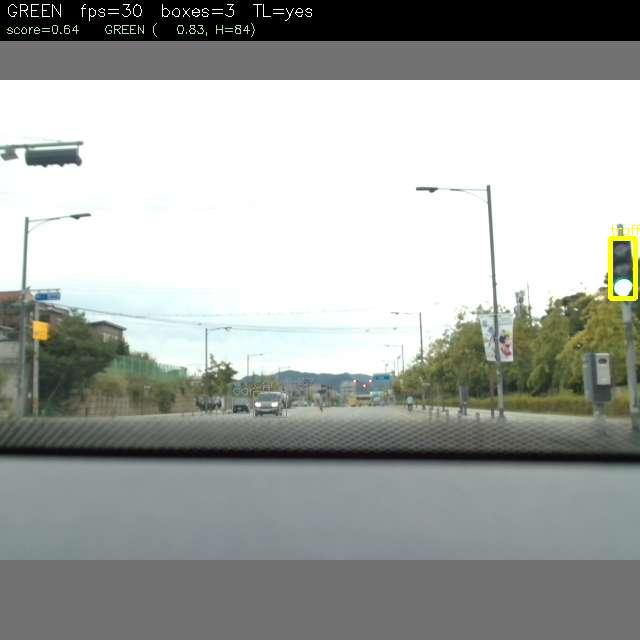
data/2026-09-17/traffic_frames/TL_GREEN_0171.8.jpg
