hanmin0211/racing_ws/data/2026-09-17/traffic_frames/TL_RED_080.2.jpg

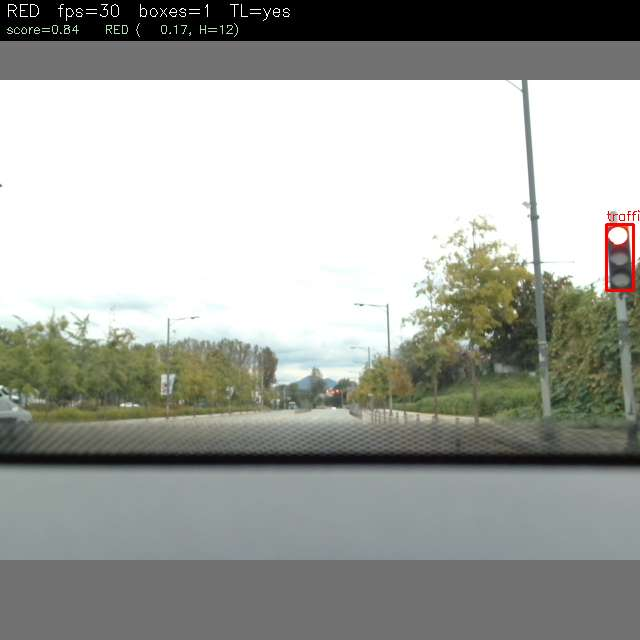
data/2026-09-17/traffic_frames/TL_RED_080.2.jpg
