hanmin0211/racing_ws/data/2026-09-17/traffic_frames/TL_YELLOW_010.5.jpg

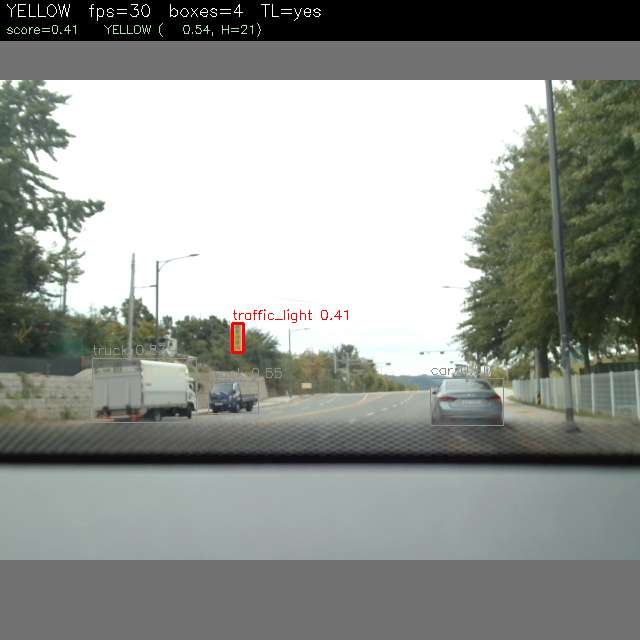
data/2026-09-17/traffic_frames/TL_YELLOW_010.5.jpg
