hanmin0211/racing_ws/docs/images/Fig_grade_off.png

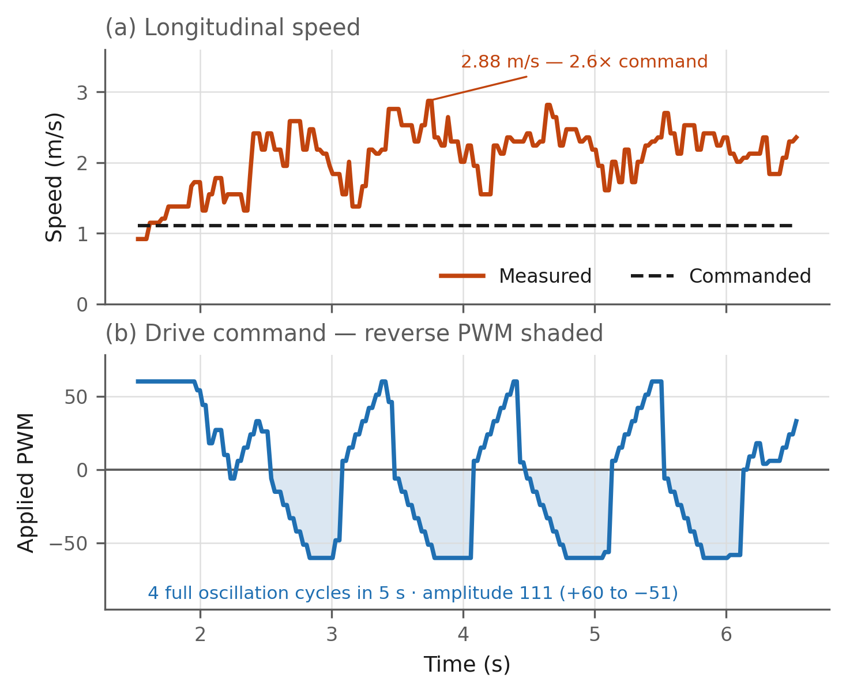
docs/images/Fig_grade_off.png
