hanmin0211/racing_ws/docs/papers/figs/Fig_gnss_jump.png

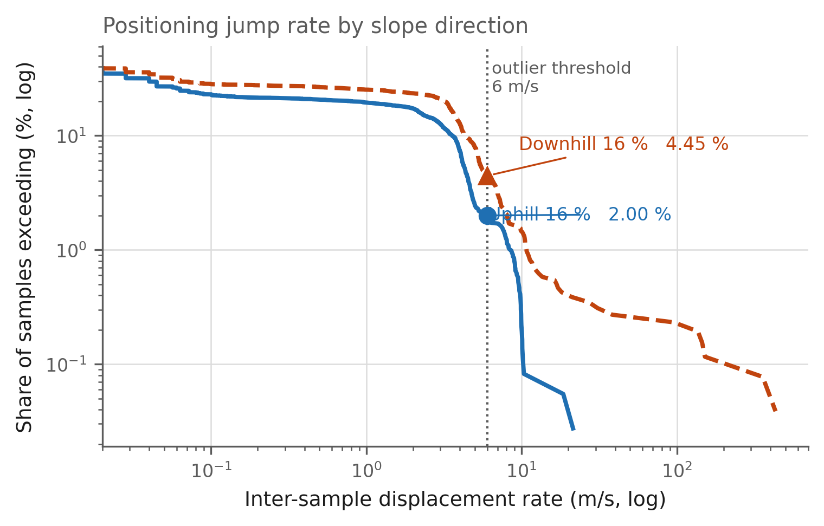
docs/papers/figs/Fig_gnss_jump.png
