hanmin0211/racing_ws/paper/eq_both.png

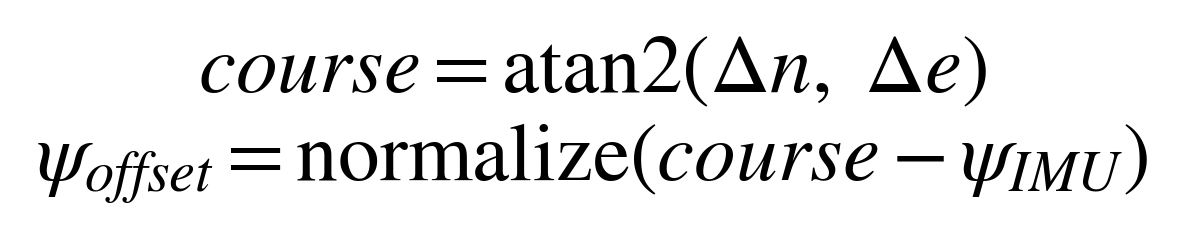
paper/eq_both.png
