hanmin0211/racing_ws/paper/fig1_localization_graph.png

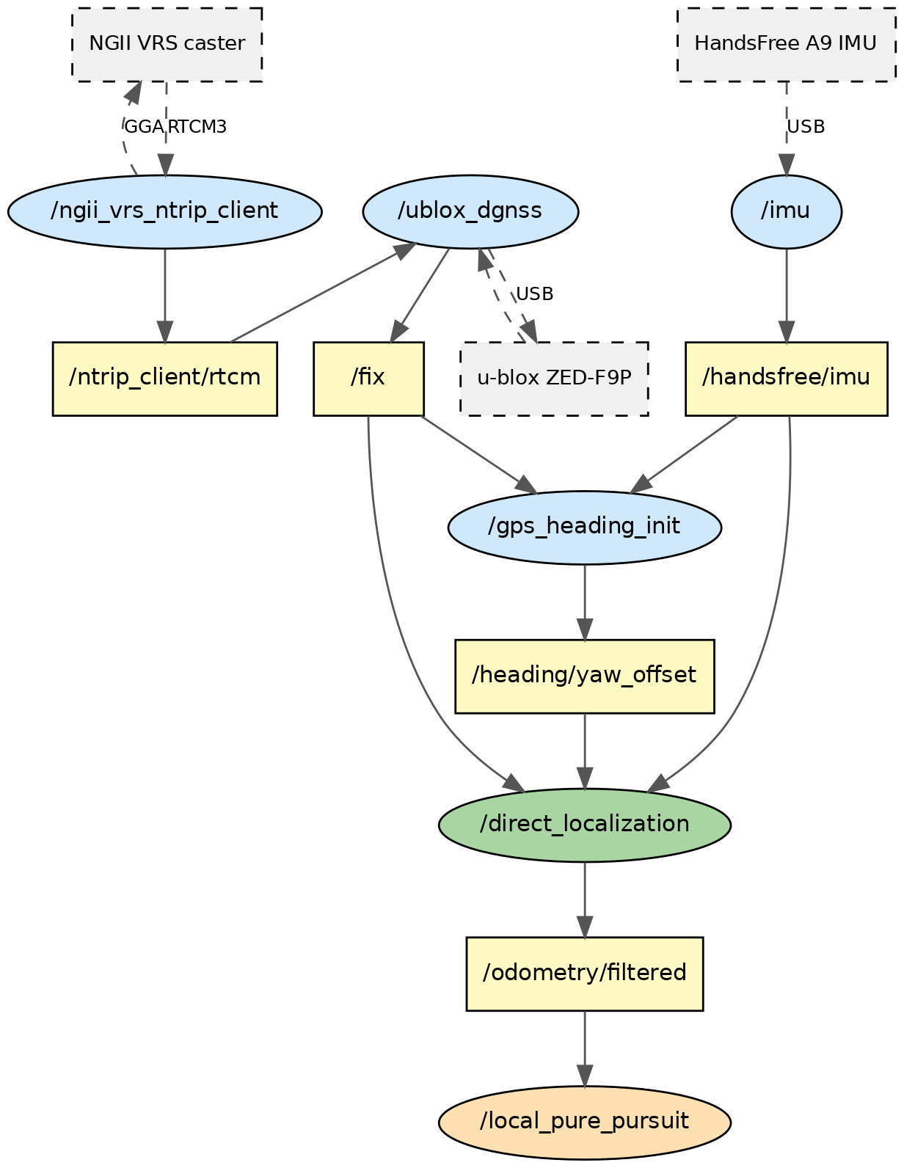
paper/fig1_localization_graph.png
