hanmin0211/racing_ws/paper/fig1_wide.png

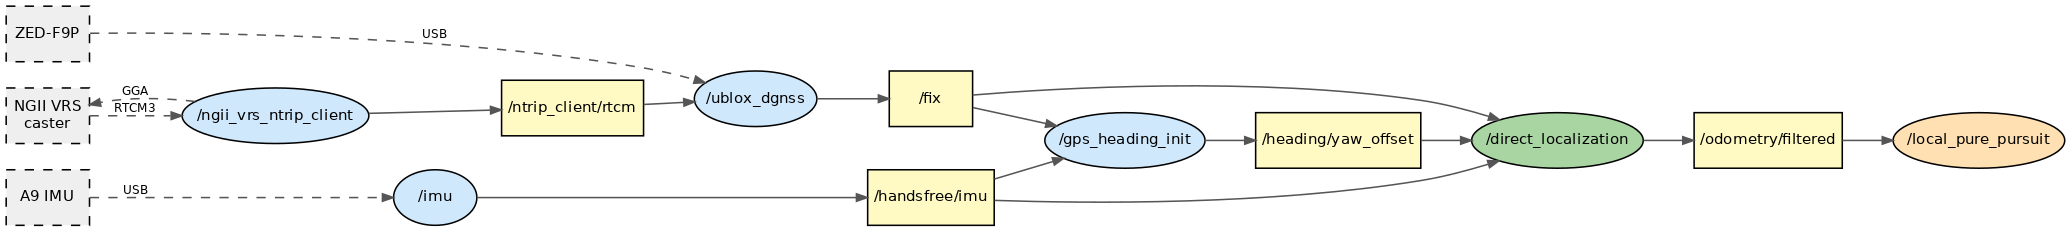
paper/fig1_wide.png
