hanmin0211/racing_ws/paper/track_compare.png

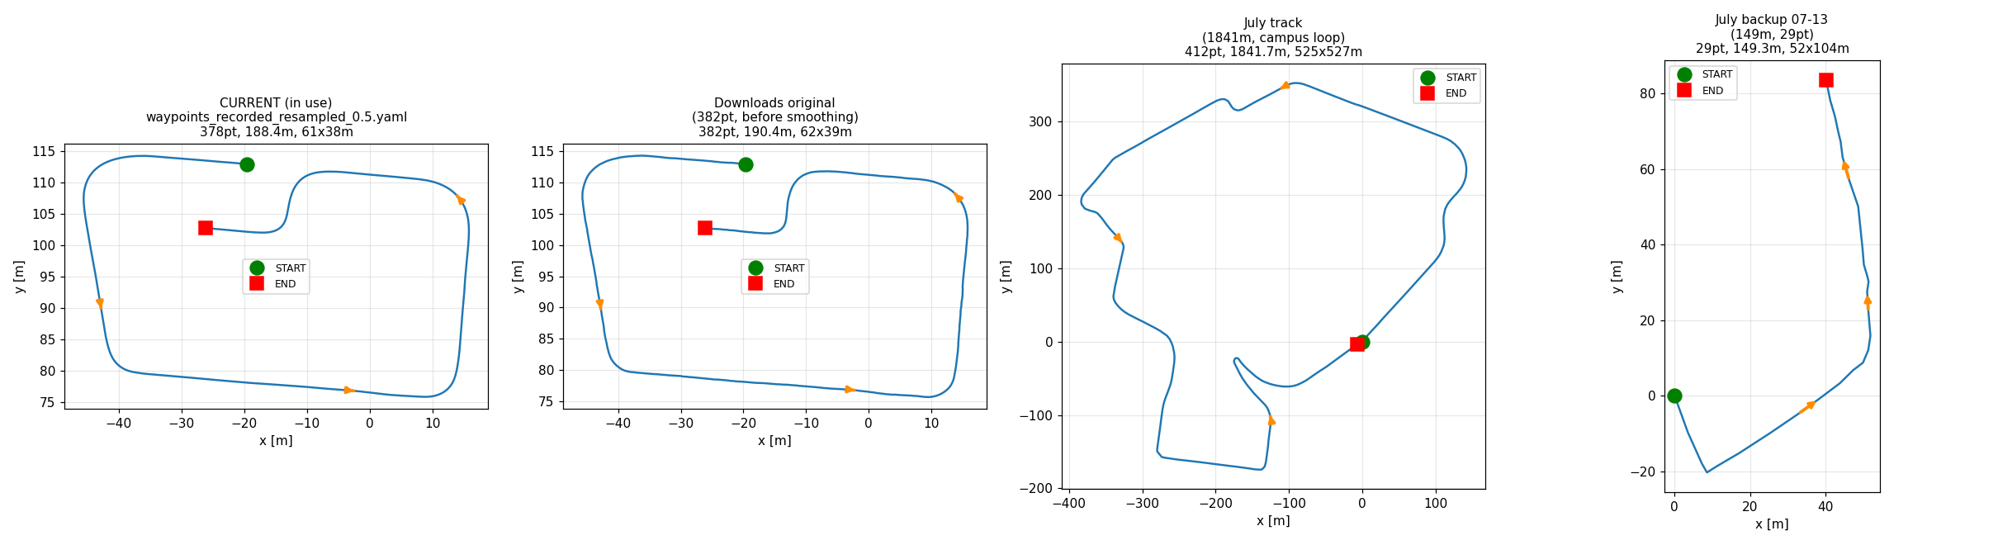
paper/track_compare.png
