hanmin0211/racing_ws/paper/fig1_localization_graph.pdf

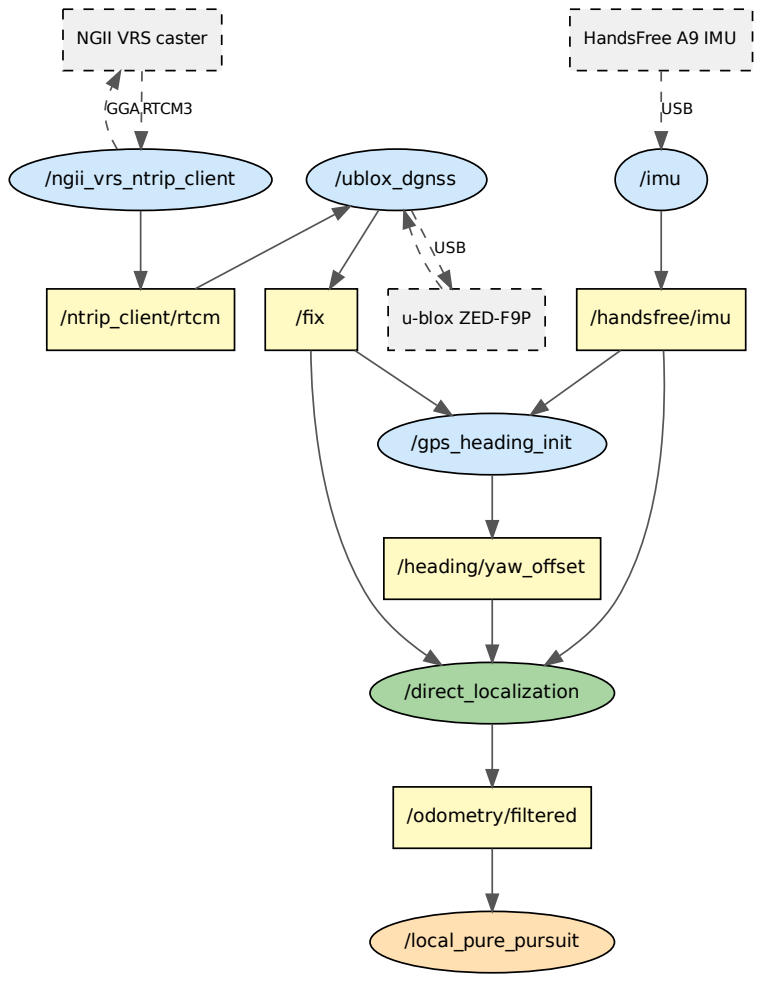
[picture p43: page 1]
/ngii_vrs_ntrip_client; RTCM3; u-blox ZED-F9P; /ublox_dgnss; HandsFree A9 IMU; /imu; GGA; USB; /ntrip_client/rtcm; /fix; /handsfree/imu; /gps_heading_init; /heading/yaw_offset; /direct_localization; /odometry/filtered; /local_pure_pursuit

NGII VRS caster
