hanmin0211/racing_ws/paper/fig1_paper.pdf

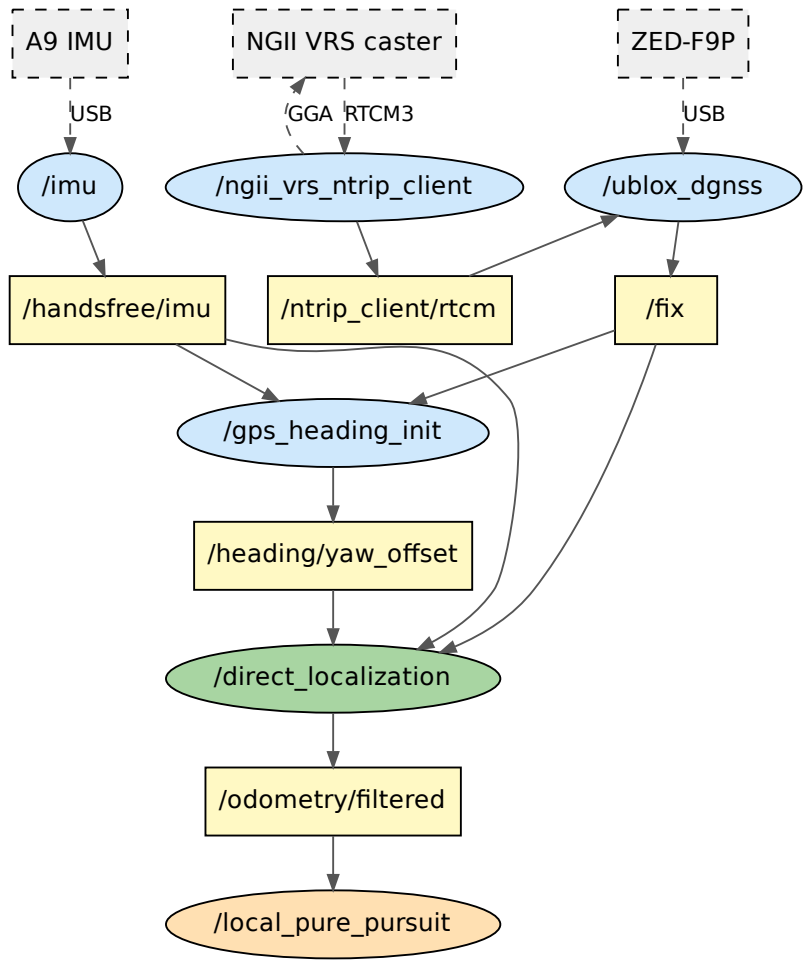
[picture p44: page 1]
/ngii_vrs_ntrip_client; RTCM3; ZED-F9P; /ublox_dgnss; USB; A9 IMU; /imu; GGA; /handsfree/imu; /ntrip_client/rtcm; /fix; /gps_heading_init; /heading/yaw_offset; /direct_localization; /odometry/filtered; /local_pure_pursuit

NGII VRS caster
