hanmin0211/racing_ws/paper/FigA3_radius_vs_error.pdf

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

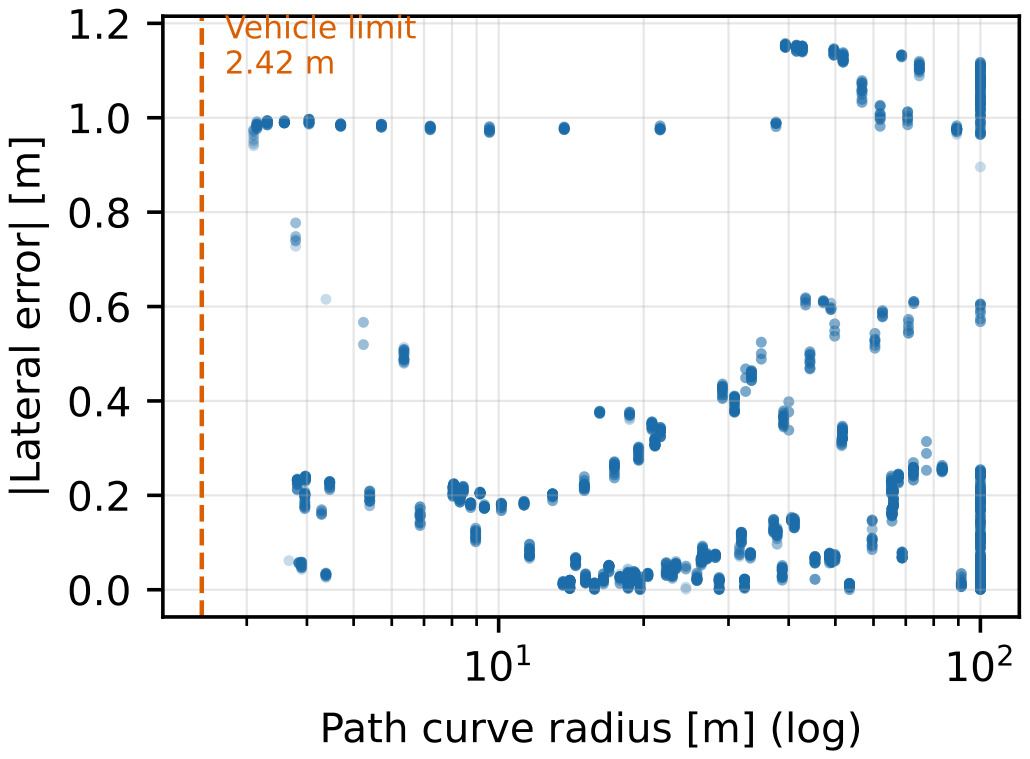
[picture p48: page 1]
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
