hanmin0211/racing_ws/paper/FigA4_profile.pdf

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

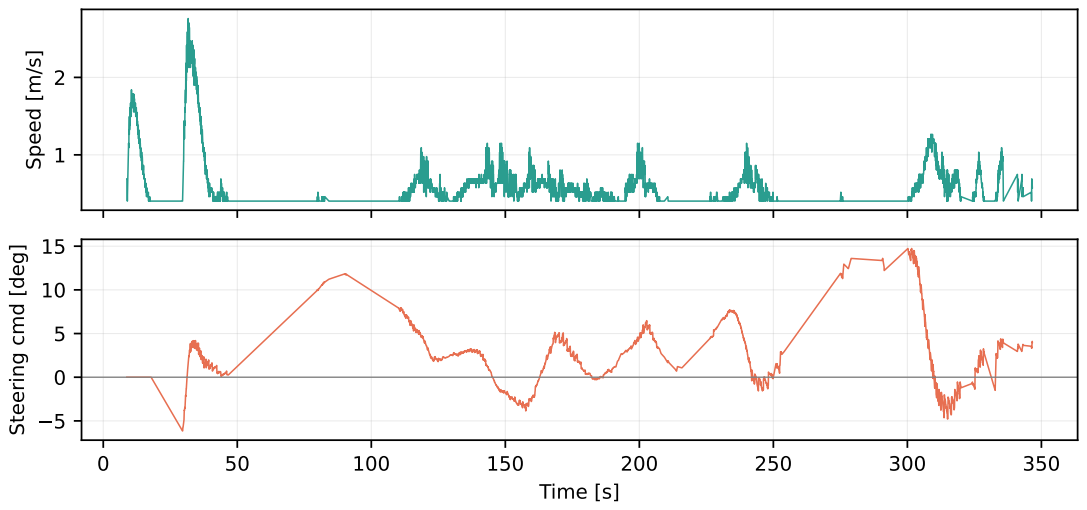
[picture p49: page 1]
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
