hanmin0211/racing_ws/arduino/henes_firmware/henes_firmware.ino

// =============================================================================
// henes_firmware.ino  —  HENES T870 브룬 자율주행 하위제어 펌웨어 (재구축)
// -----------------------------------------------------------------------------
// 설계 철학: "PID가 무엇을 하든, 안전가드가 스톨/과부하를 잘라 모터를 못 태운다."
//   [PID 계산] → PWM → [★안전가드] → analogWrite(모터)
//                          ↑ 스톨/엔드스톱/워치독 감지 시 강제 0
//
// 구성: 구동(전/후 DC모터, 엔코더 속도PID+FF+안티와인드업+소프트스타트),
//       조향(DC모터+포텐셔미터 A15, 위치PID, 캘리브 매핑), 소나 3개,
//       시리얼(serial_bridge 포맷) + 워치독.
//
// ⚠ 안전 수칙:
//   - 반드시 바퀴 들고(공중) 벤치 테스트부터. MAX_*_PWM 낮게 시작해 조금씩 올릴 것.
//   - 스톨 일부러 유발(바퀴/조향 막기)해서 가드가 실제로 컷하는지 확인 후 실주행.
// =============================================================================

// ★ 2026-08-22: SPI 카운터 방식으로 복귀. 보드를 amap 계열로 교체하니 **LS7366R 카운터가
//   D22/D23 에서 응답**했다(MDR0 write/read-back 0x03·0x01 왕복 확인).
//   (ms2405 계열 2개에는 이 칩이 없어 인터럽트 직결 방식을 썼었다 — 커밋 4331b7e)
#include <SPI.h>
#include <NewPing.h>

// ============================ 1. 핀 정의 (검증된 배선) =========================
#define MOTOR1_PWM 5    // 전륜 구동
#define MOTOR1_ENA 6
#define MOTOR1_ENB 7
#define MOTOR2_PWM 2    // 후륜 구동
#define MOTOR2_ENA 3
#define MOTOR2_ENB 4
#define MOTOR3_PWM 8    // 조향
#define MOTOR3_ENA 9
#define MOTOR3_ENB 10

// ★ 2026-08-20: ms2405 v2.0 보드는 조향 포텐셔미터를 A8 로 보낸다(amap 은 A15 였음).
// ADC 스캔(adc_scan.ino)으로 확인: 바퀴를 돌리면 A8 만 0~612 로 크게 변했다.
// ★ 2026-08-22: amap 계열 보드로 교체 → 조향 포텐셔미터가 **A15** 로 돌아왔다.
//   ADC 스캔 실측: 앞바퀴를 좌우로 돌리면 A15 만 0~913 으로 변동(폭 913).
//   A8(폭 498)·A9(405) 등은 인접채널 크로스토크다. ms2405 계열일 땐 A8 이었다.
#define Steering_Sensor A15   // 조향 포텐셔미터 (★이 보드로 조향테스트 성공: 오차 0.92°)
// ★ 2026-08-20: 엔코더 = A/B 직교펄스 **인터럽트 직결** (옛 SPI 카운터 방식 폐기).
//   경위: ms2405 교체 후 ENC1 이 0 고정 → SPI CS 후보 29핀 전수 스캔 전부 0x00 무응답,
//   A/B 펄스 스캔도 전 핀 무전이. amap 보드에 LS7366R 카운터가 내장돼 있었고 ms2405 엔
//   없는 것으로 판단(엔코더 케이블은 4선 = 5V/GND/A/B 로 확인됨).
//   ⇒ 카운터 칩 없이 아두이노가 직접 4체배 디코딩한다.
//
// 배선(ATmega2560 외부인터럽트 핀만 사용 가능: 2,3,18,19,20,21 — 2·3 은 구동모터가 씀):
//   엔코더1(전륜, 속도계산에 사용): A→D18, B→D19
//   엔코더2(후륜, 현재 미사용)    : A→D20, B→D21
//   5V→아두이노 5V, GND→아두이노 GND
// ★ 2026-08-22: amap 계열 보드 = **SPI 카운터 CS 22/23** (실측 확인).
//   ms2405 계열이었을 땐 카운터가 없어 A/B 인터럽트 직결(D18/19, D20/21)을 준비했었다.
//   보드를 다시 ms2405 로 바꾸면 그 방식으로 되돌릴 것(커밋 4331b7e 참고).
#define ENC1_ADD 22           // 엔코더 SPI CS
#define ENC2_ADD 23
#define SONAR_NUM 3
#define MAX_DISTANCE 200

// ============================ 2. 조향 캘리브 (★A8 실측 2026-08-20) ============
// ★ ms2405 보드(센서 A8) 재캘리브. amap(A15) 시절 값(center424/L0/R949)은 폐기.
// 손으로 각 위치 잡고 /steering_adc 60샘플 측정:
//   완전 왼쪽끝 = 627 (high rail),  완전 오른쪽끝 = 0 (low rail),  직진(중앙) = 282
//   → 총 가동범위 627카운트. 부호규약(좌+ → ADC↑)과 일치: 왼쪽=고ADC, 오른쪽=저ADC.
// ※ LEFT_MAX/RIGHT_MAX 는 '측면 이름'이 아니라 constrain·엔드스톱의 수치 하한/상한이다.
//   A8 에선 저ADC rail(0)=물리 오른쪽, 고ADC rail(627)=물리 왼쪽. 이름은 레거시라 헷갈리지만
//   로직(steerAngleToADC 클램프, at_left/right_limit)은 수치 min/max 로만 동작해 그대로 옳다.
// ※ 중앙 282 는 좌우 중점(313)과 다른 비대칭(링키지 기하). 얼추중앙(220) 아닌 직진 정밀측정값.
// ★ 2026-08-22: amap 계열 보드(A15)로 교체 → A15 시절 값으로 복귀.
//   ※ 아래 424/0~949 는 옛 amap 실측값이다. 이 보드가 '그때 그 보드'인지 확실치 않으므로
//     STEER_MOTOR_TEST 1 로 좌/중/우를 재측정해 확정할 것(ADC 스캔 관측범위는 0~913였음).
//   (ms2405 계열이었을 때의 A8 실측값은 center282 / 0~627 / 14.1 — 커밋 f6f741d)
// ★ 2026-08-22 이 보드 실측 확정(모터 OFF 상태, 각 위치 80~100샘플):
//     완전 왼쪽 = 936(고rail) / 직진 중앙 = 412 / 완전 오른쪽 = 0(저rail)
//   옛 amap 값(424 / 0~949)과 미세하게 다르다 → 이 보드 개체값으로 갱신.
#define STEER_CENTER    412
#define STEER_LEFT_MAX    0
#define STEER_RIGHT_MAX 936
// 최대 타각: 30°는 가정값이었고, 2026-08-13 실측 결과 **20°**. (가정대로 두면
// pure pursuit가 20° 명령해도 실제로는 13°만 꺾여 코너마다 밖으로 밀린다.)
#define STEER_MAX_ANGLE  20.0
// 엔드스톱 안전마진 (물리 끝값보다 안쪽에서 컷)
#define STEER_AD_MIN  (STEER_LEFT_MAX  + 10)   // 10
#define STEER_AD_MAX  (STEER_RIGHT_MAX - 10)   // 939

// 조향각(도, 좌+/우−) → 목표 ADC
// ★ 부호 정정(2026-08-15 실차 확인): 예전 매핑은 '+각도 → ADC 감소'였는데, 육안
//   확인 결과 그게 **실제로는 우회전**이었다. 즉 ADC가 낮은 쪽이 우, 높은 쪽이 좌.
//   (관찰 조건: 차량 뒤집힘 + 정면에서 관찰 → 반전이 두 번이라 상쇄되어 '눈에
//    보이는 오른쪽 = 차의 오른쪽'. 그 상태에서 +15° 명령에 우측으로 꺾였음.)
//   → +각도(좌)는 ADC 증가(949 방향), −각도(우)는 ADC 감소(0 방향)로 정정.
//
// ★ 단일 선형 스케일 채택(2026-08-15).
//   예전엔 '좌우 양 끝이 각각 정확히 20°'라고 가정해 방향별로 따로 스케일했는데
//   (좌 26.25 / 우 21.2 counts/도), 그 가정은 검증된 적이 없다. 최대타각 20°는
//   **한쪽만 실측**한 값이다. 포텐셔미터가 조향축에 직결이면 카운트/도는 전 구간
//   일정한 것이 물리적으로 옳으므로, 스케일을 하나로 통일한다.
//   보수적으로 작은 값(424counts/20° = 21.2)을 쓴다:
//     · 실제가 21.2면 → 정확
//     · 실제가 26.25면 → 명령보다 덜 꺾임(언더스티어) = 안전한 방향의 오차
//     (큰 값을 쓰면 반대로 오버스티어가 되어 위험하다)
//   ※ 반대쪽 최대타각을 실측하면 이 값만 고치면 된다.
// ★ A8 재산정(2026-08-20): center282, 좌rail627, 우rail0.
//   좌반 (627-282)/20°=17.25, 우반 (282-0)/20°=14.1 (counts/도). 비대칭이라 단일값은
//   보수적으로 **작은 14.1** 채택(오버스티어 회피). 결과:
//     · 우측 -20° 명령 → ADC 0 (정확)
//     · 좌측 +20° 명령 → ADC 564 (실제 ~16.3°, 언더스티어=안전측)
//   실트랙에서 코너를 밖으로 밀면 15.7(평균)까지 올릴 것.
// ★ 2026-08-22: A15 복귀 → 옛 amap 값 21.2 로 되돌림(A8 시절은 14.1 이었다).
//   좌/중/우 재측정 후 (rail-center)/20° 로 다시 산출할 것.
// ★ 2026-08-22 이 보드 실측 재산정: center412, 좌rail936, 우rail0.
//   좌반 (936-412)/20°=26.20, 우반 412/20°=20.60. 비대칭이라 기존 철학대로
//   **보수적으로 작은 20.6** 채택(오버스티어 회피 — 큰 값을 쓰면 명령보다 더 꺾인다).
//     · 우측 -20° → ADC 0 (정확)
//     · 좌측 +20° → ADC 824 (실제 ~15.7°, 언더스티어 = 안전측 오차)
//   실트랙에서 코너를 밖으로 밀면 23.4(평균)까지 올릴 것.
// ★ 2026-08-22: **방향별 스케일로 분리**. 단일값(20.6)을 쓰던 것을 좌/우 각각의
//   실측 기울기로 나눈다.
//   근거: 이 보드에서 좌rail 936 / center 412 / 우rail 0 을 모두 실측했다.
//     좌반 (936-412)/20° = 26.2,  우반 (412-0)/20° = 20.6 counts/도 (링키지 비대칭)
//   단일값 20.6 을 쓰면 **좌회전이 명령의 78% 만 꺾여**(18° 명령 → 실제 약 14°)
//   좌코너에서 밖으로 밀려 차선을 밟는다. 과거엔 좌우 최대타각이 실측되지 않아
//   보수적으로 단일값을 썼지만, 이제 양쪽 rail 이 모두 실측됐으므로 분리가 옳다.
//   ※ 각 방향의 '최대타각 20°' 가정 자체는 남아있다. 실트랙에서 한쪽만 계속 밀리면
//     그쪽 값을 조정할 것.
#define STEER_CPD_LEFT   26.2    // +각(좌회전) counts/도
#define STEER_CPD_RIGHT  20.6    // -각(우회전) counts/도
#define STEER_COUNTS_PER_DEG  23.4   // 레거시 참조용 평균값

int steerAngleToADC(float ang) {
  if (ang >  STEER_MAX_ANGLE) ang =  STEER_MAX_ANGLE;
  if (ang < -STEER_MAX_ANGLE) ang = -STEER_MAX_ANGLE;
  // 좌+ → ADC↑ (방향별 기울기 적용)
  float adc = STEER_CENTER + ang * (ang >= 0 ? STEER_CPD_LEFT : STEER_CPD_RIGHT);
  return constrain((int)adc, STEER_LEFT_MAX, STEER_RIGHT_MAX);
}

// ADC → 실제 조향각[도]. 명령각이 아니라 '지금 바퀴가 실제로 몇 도인지'.
// 자율주행 중 조향 추종 오차를 감시하려면 이 값이 필요하다.
float steerADCToAngle(int adc) {
  int d = adc - STEER_CENTER;
  return (d >= 0) ? (d / STEER_CPD_LEFT) : (d / STEER_CPD_RIGHT);
}

// ============================ 3. 안전 파라미터 ================================
// ★ 벤치 테스트는 이 값들을 낮게 시작해서 단계적으로 올린다.
// 구동 PWM 상한. 80은 근거 없는 보수값이었고, FF 실측 결과 1.5m/s에 PWM 71이
// 필요해 PID 여유를 더한 111 로 상향(ff_sweep 권장치). 스톨가드가 보호한다.
// ★ 2026-08-17 저녁: 190 으로 올렸더니 랩 종반에 아두이노가 꺼졌다.
// 모터 부하 시 공급전압이 4018mV → **3483mV** 로 535mV 떨어지는데,
// ATmega2560 브라운아웃 문턱(약 4.3V)보다 한참 아래라 리셋된다.
// 차량 배터리를 교체해도 전압이 그대로였으므로(4018→3987mV) 원인은
// 배터리가 아니라 **아두이노 전원 경로**다. 이건 실내에서 멀티미터로
// 5V 핀을 직접 재서 확정해야 한다.
//
// 그때까지는 완주 실적이 있는 111 로 되돌린다(전류 ↓ → 전압 강하 ↓).
// 전원 문제가 해결되면 190 으로 올릴 것 — FF 는 이미 검증됐다
// (0.5 명령에 PWM 158, 상한 미접촉).
// ★ 2026-08-18: 리셋의 진짜 원인은 USB 버스 충돌(ublox↔아두이노)이었고
// 버스 물리분리로 해결됐다. 전원/FF 문제가 아니었으므로 속도 상향이 가능하다.
// 단계적 상향: 111(완주 실적) → 150 → 190. 각 단계에서 VMIN·리셋을 확인한다.
// FF/PID 는 완주한 값 그대로 두고 이 값만 바꾼다(한 번에 한 변수).
// ★ 2026-08-22: 255 → **160**. 주행 중 전압강하로 멈추는 일을 막기 위해 낮춘다.
//   이력: 111 완주 실적 / 190 에서 부하 시 3483mV 까지 떨어져 랩 종반 리셋.
//   160 은 그 사이 값이다. VMIN 을 보며 문제없으면 단계적으로 올릴 것.
// ★ 2026-08-23: 150 으로 설정 (전압 여유 우선).
//   FF 역산 기준 상한 속도: (150-80)/95 = 0.74m/s ≈ 2.65km/h.
//   190 에서 부하 시 3483mV 까지 떨어져 랩 종반 리셋된 이력이 있어 보수적으로 잡았다.
//   더 빠르게 필요하면 175(3.6km/h) → 186(4.0km/h) 순으로 올리되 VMIN 을 확인할 것.
// ★ 2026-08-24: 4.5km/h 목표로 180 까지 올렸다가 **160 으로 되돌렸다.**
//   180 주행에서 헤딩 캘리브 편차가 3° → 36° 로 나빠지고 10m 직진이 우로 1.25m
//   휘었다(조향각 오차 -4.42°, VMIN 3920mV). 출력이 올라가며 돌입전류가 커져
//   전압이 흔들린 것으로 본다.
//   160 은 **완주 실적이 있는 값**이다. 속도를 올리려면 조향 중립부터 잡고,
//   VMIN 을 보며 175 → 186 순으로 한 단계씩. 한 번에 한 변수만 바꾼다.
// ★ 2026-09-05: 160 → **200**. 8분 지정시간을 맞추기 위한 상향.
//   근거 — 용인 코스 실측 700.9m. MAX 160(=0.84m/s)이면 주행만 834초,
//   주차·정지 포함 15.7분이라 지정시간 8분을 7.7분 초과 = 약 40점 감점.
//   200 이면 (200-80)/95 = 1.26m/s → 주행 556초로 줄어든다.
//   전제 — 2026-09-03 페라이트 하중에 의한 GND 접점 불량을 잡아 VCC 가
//   5091~5115mV 로 안정됐다. 180 에서 났던 문제(헤딩 캘리브 편차 3°→36°,
//   VMIN 3920mV)는 그 접지 불량이 원인이었을 가능성이 크다.
//   ★ 반드시 확인할 것 — 올린 뒤 **헤딩 캘리브 편차**를 본다.
//     3~5° 면 정상, 수십 도로 나빠지면 되돌린다. VMIN 3900mV 미만도 되돌림.
//   더 올리려면 200 → 220 → 255 순으로 한 단계씩(255 = 1.84m/s = 8분 턱걸이).
// ★ 2026-09-08: 200 → **160 으로 되돌림.** HIL 실측으로 상향 근거가 깨졌다.
//   9/7 에 8분 예산(용인 648.5m) 때문에 160→200 으로 올렸다. 근거는
//   "9/3 접지 수리로 VCC 가 5091~5115mV 로 안정됐다" 였고, 정지 상태에서는
//   실제로 5161~5308mV 였다. 그런데 **주행 중에는 다르다**:
//     직선 주행      VCC 4262mV
//     커브(조향 동시) VCC 3618 → 3329 → 3224 → **3215mV**
//   바퀴를 든 무부하 HIL 인데도 이 정도다. 지면에서는 조향 부하가 더 크다.
//   과거 리셋 발생선(3483mV)보다 낮고, 실제로 그 직후 스택이 내려갔다.
//   → 정지 시 VCC 가 좋아도 주행 중 강하는 별개다. 접지 수리는 정지 전압을
//     올렸을 뿐 순간 전류에 의한 강하를 없애지 못했다.
//   더 올리려면 전원계를 먼저 손봐야 한다(굵은 전원선/별도 레귤레이터/
//   구동·로직 전원 분리). PWM 만 올리는 것으로는 안 된다.
//   ⚠ 단서: 위 VCC 값은 ATmega 내부 밴드갭 기준 자가측정이라 PWM 노이즈에
//     오염될 수 있다(조향 −18° 에서 5115mV 로 무부하 4121mV 보다 높게 나온
//     물리적으로 불가능한 샘플이 있었다). 160 유지는 '안전측 선택'이고,
//     상향 판단은 **멀티미터 실측 후** 할 것.
#define MAX_DRIVE_PWM   160
// 조향 PWM 상한. 90은 벤치 초기 보수값이었는데, 실측 결과 '완전 정지 상태에서의
// breakaway(정지마찰 뜯기)'에 부족했다(움직이는 중엔 90으로 충분히 잘 감).
// 130으로 상향 — 스톨가드(PWM>30이 250ms간 무이동 시 컷 + 1.5s 쿨다운)가 보호한다.
#define MAX_STEER_PWM   130
// ★ 진단 스위치. 1 = 조향모터 OFF(손으로 돌려 센서 ADC 측정). 측정 끝나면 0 으로.
//   플래시 확인용도 겸함: 이 펌웨어가 들어가면 조향모터가 안 버틴다(손으로 돌아감).
#define STEER_MOTOR_TEST 0
// ★★ 엔코더 없음 모드 (2026-08-22).
//   ms2405 에는 amap 에 있던 SPI 카운터 IC 가 없어 엔코더 신호가 아두이노에 오지 않는다
//   (SPI 라인 전기 진단: D50~53·D22/23 이 '아무것도 안 물린 기준핀'과 동일).
//   엔코더가 0 이면 (a) 속도 PID 가 오차를 못 줄여 PWM 을 255 까지 밀어올리고
//   (b) 구동 스톨가드가 '정상 주행'을 스톨로 오인해 700ms 마다 컷한다 — 주행 불가.
//
//   1 로 두면: 속도 PID 를 우회해 **FF 개루프**(PWM = STATIC_FF + GAIN*v)로 달리고,
//              구동 스톨가드를 끈다. 조향은 A8 피드백이 살아있으므로 그대로 폐루프.
//   ⇒ 속도 정밀도는 떨어지지만(경사·부하에 따라 편차) **웨이포인트 완주는 가능**하다.
//
//   ★ 엔코더 A/B 를 D18/D19 에 직결하면 **이 값을 0 으로 되돌릴 것**. 그러면 원래의
//     속도 폐루프·스톨보호가 전부 복귀한다(ROS 쪽은 고칠 것 없음 — VEL: 인터페이스 동일).
//   ⚠ 이 모드에서는 구동 스톨 보호가 없다. 바퀴가 걸려도 못 자르니 장시간 무인 주행 금지.
// ★ 2026-08-22: 0 으로 복귀. amap 계열 보드에 SPI 카운터가 있어 엔코더가 살아났다.
//   속도 폐루프와 구동 스톨 보호가 모두 정상 동작한다.
// ★ 2026-09-17 — **0 으로 되돌렸다.** 엔코더가 살아 있음을 실차에서 확인했다:
//   · 차를 4.6m 밀어 카운트 -1422 → -3025 (연속, 갱신 18~20Hz)
//   · 전진에 **감소** → counts_per_revolution=-290 부호 맞음
//   · /current_speed 434샘플 전부 양수, 최대 +0.46 m/s
//   · 주행 중 최장 정지 0.03~0.07s (한계 0.25s) — 끊김 없음
//   2026-09-05 의 ENC1=0 은 그날의 배선/접점 문제였고 그 뒤 되돌린 기록이 없었다.
//
//   왜 되돌리나 — 개루프로는 **평지 속도와 경사 토크가 한 값에 묶인다**:
//     ff_min_pwm  90 → 평지 2.7 m/s · 경사 못 버팀(7.7m 되밀림)
//     ff_min_pwm 170 → 평지 3.5 m/s · 굴절코스 상한(3.0) 초과
//   법정 경사로(오르막 10~12.5%, 도로교통법 시행규칙 별표 23)를 **1.0 m/s 로**
//   오르는 데 필요한 PWM 은 실측 역산으로 91~100 이다(추진력 계수 0.0278
//   m/s²/PWM, 211샘플). MAX_DRIVE_PWM 160 안에 넉넉히 들어간다.
//   닫힌 루프면 평지 PWM 56 / 경사 PWM 100 을 PID 가 알아서 낸다 —
//   지속 고 PWM 이 필요 없으니 드라이버 열보호(9/17 실제로 걸렸다)도 피한다.
//
//   ⚠ 되돌리려면 1 로 바꾸고 다시 구우면 된다. 직전 플래시는
//     arduino/backup/ 에 있다.
#define NO_ENCODER 0
// 부팅 후 이 시간 동안 조향 PWM 상한을 0→MAX 로 램프 (돌입 전류 방지).
// 아래 steering_pid_control 말미의 소프트스타트 주석 참고.
#define STEER_SOFT_MS   2500UL
#define STEER_SOFT_MIN  25       // 너무 낮으면 아예 안 움직이므로 하한

// 조향 위치제어 파라미터 (자율주행용).
// pure_pursuit가 20Hz로 내는 연속 목표각(ROS단에서 90°/s 슬루제한)을 매끄럽게 추종.
// ※ AC 디더 방식은 폐기: 50Hz 반전은 기어드 모터가 못 따라가 net 이동 없이 버즈(삐-)만
//   나고, 스티션 극복도 안 됨. 대신 '움직이면 최소 STEER_MIN_MOVE의 steady DC, 아니면 0'
//   방식(옛 검증본)으로 확실히 움직이게 하고, 히스테리시스로 중앙 헌팅/버즈를 막는다.
// ★ 2026-09-10 상향 (16→24 / 24→32). 근거: 2026-09-09 용인 648.3m HIL 완주 랩에서
//   조향 스톨이 19회 66초, **랩의 4.0%** 를 먹었다(전부 `drive=0 steer=1` — 구동은
//   정상이고 조향만 컷). 3초 링버퍼로 잡은 실제 순간:
//     -2.46s  명령 -7.3°  실제 -7.5°  ADC 257   → 도달, settled, 모터 정지
//     -1.25s  명령 -6.4°  실제 -7.5°  ADC 257   → 오차 29카운트(1.1°) → 재출발
//      0.00s  ADC 257 그대로 2.5초                → 스톨 판정, 컷
//   끝단 아님(257 은 rail 에서 한참 안쪽), 전압 문제 아님(4935mV), 센서 정상
//   (같은 캡처에서 ADC 224→257 통과). **부스트가 PWM 130 까지 올려도 못 이긴
//   정지마찰**이다. 즉 이길 수 없는 1.1° 를 쫓다가 모터만 지지고 컷된 것이다.
//   → 재출발 문턱(RESUME)을 그 1.1°(29카운트) **위**로 올려 애초에 안 쫓게 한다.
//   counts/도: 좌 26.2 · 우 20.6  →  24카운트 = 0.92°(좌) / 1.17°(우)
//                                    32카운트 = 1.22°(좌) / 1.55°(우)
//   정상 추종에는 영향이 없다(실측 추종오차가 이미 0.8° 수준이라 원래도 이 안이다).
#define STEER_DEADBAND    24   // ADC. 이내로 도달하면 정지(무부하·무소음)
#define STEER_RESUME      32   // 정지상태에서 오차가 이 이상 벌어져야 재출발(히스테리시스)
#define STEER_MIN_MOVE    34   // 스티션 극복 최소 PWM. 이 이하 DC로는 실제로 안 움직임
                               //   → 움직일 땐 반드시 이 이상 실어 '확실히 이동 or 정지'
// ★ 정지마찰 탈출 부스트.
// 실측(2026-08-13): 큰 각도(300카운트↑)는 PWM이 130까지 올라가 잘 뜯기는데
// **작은 보정(60카운트≈2.8°)은 PWM 60으로 정지마찰을 못 이겨 아예 안 움직였다.**
// pure pursuit가 내는 명령 대부분이 이런 작은 보정이라, 그대로 두면 직진 유지가 안 된다.
// 대책: '명령이 있는데 실제로 안 움직이는' 동안만 PWM을 점진적으로 키우고, 움직이기
// 시작하면 즉시 0으로 리셋해 정상 PID로 복귀. 끝내 안 움직이면 스톨가드가 250ms에
// 컷하므로 모터 보호는 그대로 유지된다.
#define STEER_BOOST_STEP   6   // 사이클(10ms)당 증가량 → 약 160ms에 +96
#define STEER_MOVING_DELTA 2   // ADC가 이만큼 변하면 '움직이는 중'으로 판정

// 구동 스톨: PWM 높은데 안 움직임이 지속되면 컷
#define DRIVE_STALL_PWM    55     // 이 이상 PWM인데
#define DRIVE_STALL_SPEED  0.05   // 속도가 이 이하로 (m/s)
// ★ 2026-08-19: 300 → 700. FF 상향(80/95) 후 출발 즉시 PWM 이 80+ 로 55 를
//   넘는데, 무거운 차(배터리뱅크+철근기둥)가 정지마찰을 이기고 0.05 m/s 에
//   도달하기까지 300ms 로는 부족해 '출발 = 스톨'로 오인, 매 출발마다 컷됐다.
//   (기존 FF 20.7 은 출발 시 PWM 이 55 아래라 이 조건에 안 걸렸었다)
#define DRIVE_STALL_MS     700    // 이 시간 지속되면 스톨
// 구동 스톨 컷 유지시간. 조향 스톨과 같은 이유로 쿨다운 재시도를 둔다:
// 옛 구동 로직은 '목표속도<0.05'가 되어야만 래치가 풀려, 자율주행이 계속
// 목표를 주면(예 2.8) 한 번 오인 컷되면 영영 안 풀려 차가 멈춘 채 방치됐다.
// 쿨다운 재시도면 일시적 걸림·출발지연은 스스로 회복하고, 진짜 스톨이면
// 컷/재시도를 반복하며 모터를 보호한다.
#define DRIVE_STALL_COOLDOWN_MS 2000

// 조향 스톨: PWM 높은데 ADC가 목표로 안 감
#define STEER_STALL_PWM    30    // 이 이상 PWM인데 (실측: PWM 38~49에서도 스톨 발생.
                                 //   옛 50/60은 그 구간을 못 잡아 모터가 계속 전류만 먹었음)
#define STEER_STALL_DELTA  3      // ADC 변화가 이 이하이고 (카운트)
// ★ 2026-09-10: 15 → 24, 250 → 400ms.
//   [ERR 15 → 24]
//     설계 불변식은 **STALL_ERR ≤ DEADBAND** 다. 모터가 미는 상태(=오차가
//     DEADBAND 초과)라면 언제나 스톨 판정이 가능해야, '모터는 영원히 미는데
//     가드가 못 잡는 구간'이 안 생긴다. DEADBAND 를 24 로 올렸으므로 여기도
//     24 로 따라 올린다.
//     ⚠ 28 로 올리자는 안이 있었지만 채택하지 않았다. 28 이면 오차 25~28 구간에서
//       모터는 밀고(24 초과라 settled 아님) 가드는 못 잡아(28 이하) **무한 구동**이
//       된다. 정확히 모터를 태우는 조합이다.
//     해제 조건(`abs(steering_error) < STEER_STALL_ERR`)이 24, 재출발 문턱이 32 라
//     STALL_ERR < RESUME 도 만족한다 — 컷이 풀린 직후 곧바로 다시 밀지 않는다.
//   [MS 250 → 400]
//     부스트가 STEER_MIN_MOVE 34 에서 +6/10ms 로 PWM 130(상한)에 닿는 데 160ms 다.
//     250ms 컷이면 최대 힘으로 시도해 볼 시간이 90ms 뿐이라, 이길 수 있는
//     정지마찰도 못 이기고 컷됐다. 400ms 면 240ms 를 최대 힘으로 시도한다.
//     진짜 잠김이면 여전히 0.4초 안에 컷되므로 모터 보호는 유지된다.
#define STEER_STALL_ERR    24     // 아직 오차가 이 이상이면 (≤ STEER_DEADBAND 유지)
#define STEER_STALL_MS     400    // 이 시간 지속되면 스톨
// 스톨 컷 유지시간. 이 시간이 지나면 래치를 풀고 '재시도'한다.
// ★ 옛 로직은 '오차<15'가 되어야만 래치가 풀렸는데, 컷 상태(PWM 0)에선 움직일 수
//   없어 오차가 줄지 않아 → 조향이 영구 사망했다(주행 중이면 사고). 쿨다운 재시도로
//   일시적 걸림은 스스로 회복하고, 진짜 고장이면 컷/재시도를 반복하며 모터를 보호한다.
#define STEER_STALL_COOLDOWN_MS 1500

#define SERIAL_TIMEOUT_MS  500    // 명령 없으면 워치독 정지
#define CONTROL_DT_MS      10      // 제어주기 (100Hz)
#define TEL_INTERVAL_MS    50      // 텔레메트리 주기 (20Hz, serial_bridge STATUS_10ms)

// 소프트 스타트/브레이크 (가속도 제한, m/s^2)
// ★ 하중이 무거워(배터리뱅크+노트북+철근기둥) 급가속 시 전류가 크게 튄다.
// 0.5(원래)와 1.2(과격) 사이 0.8 로 절충: 직선 가속은 빨라지되 돌입전류는 억제.
const float ACCEL_LIMIT = 0.8;
const float BRAKE_LIMIT = 0.8;
const float WATCHDOG_BRAKE_LIMIT = 2.5;

// ============================ 4. 전역 상태 ===================================
float target_velocity = 0.0;     // ROS 목표 속도
float commanded_velocity = 0.0;  // 소프트스타트 반영된 PID 목표
float current_velocity = 0.0;
float target_steer_angle = 0.0;  // ROS 목표 조향각(도)

// ---- 개루프(open-loop) 모드 : FF/PID 식별 전용 ----
// `PWM:x` 명령을 받으면 속도 PID를 우회하고 지정 PWM을 그대로 인가한다.
// FF(정지마찰·속도비례 항)를 재식별하려면 '이 PWM에서 실제로 몇 m/s가 나오는가'를
// 측정해야 하는데, PID가 개입하면 그 관계가 가려지기 때문이다.
// ★ 안전가드(스톨 감지)·워치독은 개루프에서도 그대로 살아있다.
// `VEL:` 명령이 오면 즉시 폐루프로 복귀한다.
bool openloop_active = false;
int openloop_target_pwm = 0;
int openloop_pwm = 0;            // 레이트 제한이 적용된 실제 인가값
// ★ 레이트 제한은 **올릴 때만** 건다 (2026-09-13).
//   이 제한은 급가속으로 전원이 무너지는 걸 막으려고 넣은 것이다. 그런데
//   내릴 때까지 같이 묶어 두면 PWM 56 → 0 에 187ms 가 걸리고, 그 동안 차는
//   계속 달린다. 돌발 급정지(규정 항목 7)는 어린이 더미가 **좌우에서 이동해
//   들어와** 도로 중앙에 서는 미션이라 그 187ms 가 그대로 정지거리가 된다.
//   동력을 끊는 방향은 전원에 부담이 없으므로 제한할 이유가 없다.
#define OPENLOOP_RATE      3     // 사이클(10ms)당 **증가** 한도 → 급가속 방지
#define OPENLOOP_RATE_DOWN 255   // 감소는 제한 없음 (한 사이클에 0 까지)
// 식별용 상한 (MAX_DRIVE_PWM 과 별개).
// ★ 2026-08-17: 140 이면 지면에서 약 0.5 m/s 까지만 측정된다. 그 위를 쓰려면
//   외삽해야 하는데, 바로 그 외삽이 FF 를 10배 틀리게 만든 원인이었다.
//   **실제로 쓸 속도 범위 전체를 스윕이 덮어야 한다.**
//   모터는 24V 240W(16000rpm) 이고 현재 듀티는 43% 에 불과하다. 230 은
//   원차 설계 속도(약 1.4 m/s) 이내이며 255 대비 여유도 남긴다.
#define MAX_OPENLOOP_PWM 230

signed long encoder1count = 0, encoder2count = 0, prev_encoder1 = 0;
unsigned long prev_time = 0, last_rx_time = 0, last_tel_time = 0;
// ★ 부팅 직후에는 '워치독 작동' 상태로 시작한다 (true).
//
// false 로 두면 setup() 의 last_rx_time=millis() 때문에 **명령을 한 번도
// 받지 않았는데도 조향 PID 가 즉시 돌기 시작한다.** 목표각은 0(중앙)이라
// 바퀴가 중앙에서 벗어나 있으면 부팅하자마자 조향모터에 최대 PWM 이 걸린다.
//
// 2026-08-17 현장: 조향이 중앙에서 15° 벗어난 상태였고, 부팅 0.32초 뒤마다
// 정확히 리셋이 반복됐다(전류 급증 → 5V 강하 → 브라운아웃 → 재부팅 → 반복).
// serial_bridge 가 재연결할 때마다 DTR 로 또 리셋시켜 루프가 유지됐다.
//
// true 로 시작하면 첫 명령(VEL:/STEER:/PWM:)이 올 때까지 모터가 완전히
// 꺼져 있어 이 루프가 성립하지 않는다. 명령이 오면 handle_line() 이
// watchdog_tripped=false 로 풀어준다.
bool watchdog_tripped = true;

// 스톨 상태
unsigned long drive_stall_ms = 0, steer_stall_ms = 0, steer_cut_ms = 0;
unsigned long drive_cut_ms = 0;   // 구동 스톨 컷 유지시간(쿨다운 재시도용)
bool drive_stalled = false, steer_stalled = false;
int prev_sensorValue = STEER_CENTER;

// 바퀴 파라미터
// ★ RTK 실측 보정(2026-08-15). encoder_calib 결과 보정계수 1.0208
//   (RTK 8.844m vs 엔코더 환산 8.664m, 3076counts, 직진편차 0.24m).
//   0.13 은 공칭 추정값이었고 실제 유효 구름반경이 조금 더 컸다.
//   ※ 재검증: encoder_calib 다시 돌려 보정계수가 1.00±0.02 면 통과.
// ★★ 2026-08-20 경고: counts_per_revolution(-290)은 **옛 SPI 카운터(LS7366R) 기준**이다.
//   엔코더를 인터럽트 4체배 직결로 바꿨으므로 체배수·부호가 달라질 수 있다.
//   이 값이 틀리면 속도가 통째로 어긋나 FF/PID/스톨가드가 전부 무너진다.
//   ⇒ 배선 후 **반드시 재측정**할 것:
//     ① 바퀴를 손으로 정확히 1바퀴 굴려 ENC1 증가량 확인 → 절댓값 확정
//     ② 전진 명령(PWM:60)에 ENC1 이 **증가**해야 정상. 감소하면 부호를 뒤집는다
//        (배선 A/B 를 바꾸거나 이 상수의 부호를 반전).
//     ③ 그다음 tools/encoder_calib 로 RTK 대조 보정.
// ★ 2026-08-22 새 보드(amap 계열, SPI 카운터)에서 재검증:
//   · 부호: 모터로 전진 구동(PWM:60) → ENC1 **감소**(0→-2428), 속도 +3.0m/s 로 정상 계산.
//     ⇒ 음수 부호가 맞다. (손으로 굴렸을 땐 증가해서 반대로 보였는데, 그 방향이 후진이었다.
//        손 방향은 착각하기 쉬우니 부호는 반드시 모터 구동으로 확인할 것)
//   · 크기: 5바퀴 손 측정 1504 counts → 1바퀴 301. 290 대비 +3.8% 로 손측정 오차 범위다.
//     290 은 RTK 대조(encoder_calib, 보정계수 1.0208)로 나온 값이므로 그대로 유지하고,
//     실차에서 encoder_calib 재실행으로 정밀 보정한다.
const float wheel_radius = 0.1327;
const int counts_per_revolution = -290;
const float wheel_circumference = 2 * 3.14159 * wheel_radius;

// 구동 속도 PID
// ★ FF가 정확해졌으므로 PID는 작은 오차만 보정하면 된다. 이전 30/24 는 틀린 FF를
//   억지로 메우던 값이고, 정지마찰에 걸린 6초 동안 적분이 쌓였다가 터지는
//   **급발진의 원인**이었다(2026-08-16 현장 관측). 대폭 낮춘다.
// ★ PID 게인은 플랜트 기울기에 비례해야 한다. 기울기가 200 PWM/(m/s) 인데
// kp=8 이면 0.1m/s 오차에 0.8 PWM — P 제어가 사실상 없는 것과 같았다.
// FF 가 제대로 들어간 지금은 PID 가 작은 오차만 다듬으면 된다.
//   kp=50  → 0.1m/s 오차에 5 PWM
//   ki=30  → 0.1m/s 오차가 1초 지속되면 3 PWM 추가 (수 초 내 수렴)
// 완주 실적이 있는 값(2026-08-17 아침). FF 를 되돌렸으므로 게인도 함께 복귀.
// FF 가 무거운 하중을 감당하므로 PID 는 오차만 다듬는다. 플랜트 슬로프(95)에
// 맞춰 kp 상향. ki 는 경사·마찰 변동 보정용.
float velocity_kp = 30.0, velocity_ki = 15.0, velocity_kd = 0.5;
float velocity_error = 0.0, velocity_error_old = 0.0, velocity_error_sum = 0.0;
int velocity_pwm_output = 0;
const float VELOCITY_DT = CONTROL_DT_MS / 1000.0;
// ★ FF 실측 식별(2026-08-16, ff_sweep 103샘플, 속도 0.06~1.15m/s, PWM 22~62,
//   피팅 잔차 RMS 4.3 PWM). 이전 35/60 은 근거 불명이었고 속도항이 3배 과다했다.
//   ※ 스윕을 한 방향에서만 했으므로 경사 편향 가능성이 있다. 반대 방향으로
//     한 번 더 재서 평균 내면 더 정확해진다.
// ★ 2026-08-17 재설정. 이전 값(40.5 / 20.7)은 **바퀴가 접지되지 않은 상태**의
// ff_sweep 에서 나온 것이라 속도항이 10배 작았다. 그 결과 FF 가 내야 할 몫을
// 적분항이 전부 메우게 되어 (a) 적분 클램프에 걸려 속도가 0.33m/s 에서 막히고
// (b) 적분이 포화돼 코너 감속이 수십 초 지연됐다.
//
// 지면 실측 2점으로 역산:
//     MAX_DRIVE_PWM 80  → 0.198 m/s
//     MAX_DRIVE_PWM 111 → 0.33  m/s
//   ⇒ 기울기 ≈ 200~240 PWM/(m/s), 절편 ≈ 30~42
// 보수적으로 200 / 35 를 쓴다. ±20% 틀려도 PID 가 흡수하는 범위다.
// 마른 노면에서 ff_sweep 을 다시 돌리면 이 값을 확정할 수 있다.
// ★ 2026-08-18: 어제 아침 190m 완주에 성공한 값으로 되돌린다.
// 200 은 지면 실측 2점으로 역산한 '더 정확한' 값이지만, 출발 시 돌입 PWM 을
// 43 → 61 로 40% 키워 전원 여유가 없는 이 차에서 보드 리셋을 유발했다.
// 정확도보다 **도는 것**이 우선이다. 전원 계통을 보강한 뒤 다시 올릴 것.
// ★ 2026-08-18: 무거운 하중(배터리뱅크+노트북+철근기둥)에 맞춰 FF 대폭 상향.
// 이전 40.5/20.7 은 2.8 m/s 명령에 FF 가 98 PWM 밖에 안 내보내, 무거운 차가
// 필요로 하는 ~250 PWM 에 한참 못 미쳐 실제 속도가 2 km/h 에 머물렀다.
// 지상 실측(PWM 111→0.33, 150→0.74)의 역관계 PWM=80+95*v 를 FF 로 그대로.
// (예전 200 상향 후 리셋은 USB 버스충돌이었고 FF 문제가 아니었다 — 버스분리로
//  해결됨. 이제 제대로 올려도 된다.)
// ★ 2026-09-13 지면 실측으로 교체. 옛 값 80 / 95 는 **4배 틀렸다**.
//   그 값이면 0.15 m/s 명령에 PWM 94 가 나가 차가 2 m/s 로 달렸고,
//   헤딩 캘리브가 8회 연속 '측위 점프' 로 거부됐다.
//   근거: 캘리브 10m 직진 로그의 1m 구간 9개가 전부 1.00±0.02 m/s
//         (명령 0.5 m/s → PWM 56) + calib_trace 의 PWM 94 → 1.98 m/s.
//   ⚠ 평소 주행은 ROS 쪽 FF 를 쓴다(serial_bridge 의 ff_mode:=ros → PWM: 명령).
//     현장에서 노면이 바뀌면 펌웨어를 다시 굽지 않고 고칠 수 있기 때문이다.
//     여기 값은 ff_mode:=firmware 로 되돌렸을 때의 **폴백**이다.
const float STATIC_FF = 17.2, VELOCITY_FF_GAIN = 38.8;

// 조향 위치 PID
float steering_kp = 1.0, steering_ki = 0.0, steering_kd = 0.2;
float steering_error = 0.0, steering_error_old = 0.0, steering_error_sum = 0.0;
int steering_pwm_output = 0;
int sensorValue = STEER_CENTER;

NewPing sonar[SONAR_NUM] = {
  NewPing(11, 11, MAX_DISTANCE),
  NewPing(12, 12, MAX_DISTANCE),
  NewPing(13, 13, MAX_DISTANCE)
};

// ============================ 5. 저수준 모터 제어 =============================
void front_motor_control(int pwm) {
  int lim = openloop_active ? MAX_OPENLOOP_PWM : MAX_DRIVE_PWM;
  pwm = constrain(pwm, -lim, lim);
  if (pwm > 0)      { digitalWrite(MOTOR1_ENA, HIGH); digitalWrite(MOTOR1_ENB, LOW);  analogWrite(MOTOR1_PWM, pwm); }
  else if (pwm < 0) { digitalWrite(MOTOR1_ENA, LOW);  digitalWrite(MOTOR1_ENB, HIGH); analogWrite(MOTOR1_PWM, -pwm); }
  else              { digitalWrite(MOTOR1_ENA, LOW);  digitalWrite(MOTOR1_ENB, LOW);  analogWrite(MOTOR1_PWM, 0); }
}
void rear_motor_control(int pwm) {
  int lim = openloop_active ? MAX_OPENLOOP_PWM : MAX_DRIVE_PWM;
  pwm = constrain(pwm, -lim, lim);
  if (pwm > 0)      { digitalWrite(MOTOR2_ENA, HIGH); digitalWrite(MOTOR2_ENB, LOW);  analogWrite(MOTOR2_PWM, pwm); }
  else if (pwm < 0) { digitalWrite(MOTOR2_ENA, LOW);  digitalWrite(MOTOR2_ENB, HIGH); analogWrite(MOTOR2_PWM, -pwm); }
  else              { digitalWrite(MOTOR2_ENA, LOW);  digitalWrite(MOTOR2_ENB, LOW);  analogWrite(MOTOR2_PWM, 0); }
}
// 조향 모터: ★엔드스톱 하드컷 (센서가 안전범위 밖이면 그 방향으로 더 안 밀음)
void steer_motor_control(int pwm) {
  if (STEER_MOTOR_TEST) pwm = 0;   // ★ 진단모드: 조향모터 끄고 손으로 돌려 센서만 읽음
  pwm = constrain(pwm, -MAX_STEER_PWM, MAX_STEER_PWM);
  // pwm>0 = ADC↑ 방향(=A8 기준 물리 왼쪽)으로 민다.
  // ★ 2026-08-20 A8 실측으로 극성 확정. 경위:
  //   ① A15 시절 "왼쪽 폭주" 증상을 보고 ENA/ENB 를 스왑했었다(HIGH/LOW ↔ LOW/HIGH).
  //   ② A8 재캘리브(center282) 후 실측: +5°(목표 ADC352) 명령에 PWM +111~130 이
  //      나갔는데 ADC 가 278 → **0 으로 폭주**(반대 rail). 즉 스왑 상태가 과반전이었다.
  //      (스톨가드가 0.8s 에 컷 → 모터 보호는 정상 동작 확인)
  //   ③ 그래서 ①의 스왑을 **원복**한다: pwm>0 → ENA=LOW, ENB=HIGH.
  //   이제 pwm>0 → ADC↑ 가 성립해 폐루프·엔드스톱 로직이 모두 맞는다.
  // ※ 변수명 at_right/left_limit 은 레거시(A15 시절 이름). A8 에선 고ADC rail 이
  //   물리 왼쪽이지만, 로직은 수치 상/하한으로만 동작하므로 그대로 옳다.
  bool at_right_limit = (sensorValue >= STEER_AD_MAX);
  bool at_left_limit  = (sensorValue <= STEER_AD_MIN);
  if ((pwm > 0 && at_right_limit) || (pwm < 0 && at_left_limit)) pwm = 0;  // 엔드스톱 컷
  if (pwm > 0)      { digitalWrite(MOTOR3_ENA, LOW);  digitalWrite(MOTOR3_ENB, HIGH); analogWrite(MOTOR3_PWM, pwm); }
  else if (pwm < 0) { digitalWrite(MOTOR3_ENA, HIGH); digitalWrite(MOTOR3_ENB, LOW);  analogWrite(MOTOR3_PWM, -pwm); }
  else              { digitalWrite(MOTOR3_ENA, LOW);  digitalWrite(MOTOR3_ENB, LOW);  analogWrite(MOTOR3_PWM, 0); }
}
void all_motors_off() { front_motor_control(0); rear_motor_control(0); steer_motor_control(0); }

// ============================ 5.5 공급전압(VCC) 모니터 =======================
// 내부 1.1V 밴드갭을 ADC로 읽어 역산하면 VCC를 알 수 있다(별도 배선 불필요).
// 모터 스톨 순간 전압이 얼마나 주저앉는지(sag) 보려고 매 제어주기 샘플링하고,
// 텔레메트리 주기 동안의 최솟값(VMIN)을 함께 보고한다.
//   - 정상: 4900~5100mV 부근에서 안정
//   - 4300mV 이하로 떨어지면 brownout 위험(ATmega2560 BOD 트립 영역)
int vcc_mv = 0;
int vcc_min_mv = 9999;

int readVccMv() {
  // MUX[5:0]=011110 → 1.1V 밴드갭 (ATmega2560). REFS0=1 → 기준전압 AVCC.
  ADCSRB &= ~_BV(MUX5);
  ADMUX = _BV(REFS0) | _BV(MUX4) | _BV(MUX3) | _BV(MUX2) | _BV(MUX1);
  // 기준/채널 전환 후 첫 변환은 버린다(정착). delay 대신 더미 변환 → 루프 영향 최소.
  ADCSRA |= _BV(ADSC); while (bit_is_set(ADCSRA, ADSC));
  ADCSRA |= _BV(ADSC); while (bit_is_set(ADCSRA, ADSC));
  uint8_t low = ADCL, high = ADCH;
  long raw = ((long)high << 8) | low;
  if (raw == 0) return 0;
  return (int)(1125300L / raw);   // 1.1V * 1023 * 1000 / raw
}

// ============================ 6. 엔코더 (인터럽트 4체배 직교 디코딩) ==========
// 옛 SPI 카운터(LS7366R) 방식은 카운터 칩이 없어 폐기했다(핀 정의 주석 참고).
// 외부 함수 인터페이스(initEncoders / readEncoder / clearEncoderCount)는 그대로 유지해
// 호출부는 손대지 않는다.
//
// 4체배 디코딩 원리 — 정방향 시퀀스는 (A,B): 00 → 10 → 11 → 01 → 반복.
//   · A 가 변하는 순간엔 항상 A!=B  (00→10, 11→01)
//   · B 가 변하는 순간엔 항상 A==B  (10→11, 01→00)
// 역방향이면 각각 반대가 되므로, 위 조건으로 ±1 을 정한다. A/B 양쪽 CHANGE 를 잡아
// 한 주기에 4틱 → 분해능 4체배.
void initEncoders() {
  pinMode(ENC1_ADD, OUTPUT); pinMode(ENC2_ADD, OUTPUT);
  digitalWrite(ENC1_ADD, HIGH); digitalWrite(ENC2_ADD, HIGH);
  SPI.begin();
  digitalWrite(ENC1_ADD, LOW); SPI.transfer(0x88); SPI.transfer(0x03); digitalWrite(ENC1_ADD, HIGH);
  digitalWrite(ENC2_ADD, LOW); SPI.transfer(0x88); SPI.transfer(0x03); digitalWrite(ENC2_ADD, HIGH);
}
long readEncoder(int no) {
  unsigned int c1, c2, c3, c4;
  digitalWrite(ENC1_ADD + no - 1, LOW);
  SPI.transfer(0x60);
  c1 = SPI.transfer(0x00); c2 = SPI.transfer(0x00); c3 = SPI.transfer(0x00); c4 = SPI.transfer(0x00);
  digitalWrite(ENC1_ADD + no - 1, HIGH);
  return ((long)c1 << 24) + ((long)c2 << 16) + ((long)c3 << 8) + (long)c4;
}
void clearEncoderCount(int no) {
  digitalWrite(ENC1_ADD + no - 1, LOW);
  SPI.transfer(0x98); SPI.transfer(0x00); SPI.transfer(0x00); SPI.transfer(0x00); SPI.transfer(0x00);
  digitalWrite(ENC1_ADD + no - 1, HIGH);
  delayMicroseconds(100);
  digitalWrite(ENC1_ADD + no - 1, LOW); SPI.transfer(0xE0); digitalWrite(ENC1_ADD + no - 1, HIGH);
}

// ============================ 7. 속도 계산 (10ms 이동평균) ====================
void calculate_velocity() {
  long d = encoder1count - prev_encoder1;
  float rev = (float)d / counts_per_revolution;
  float raw = (rev * wheel_circumference) / VELOCITY_DT;
  static float buf[5] = {0,0,0,0,0}; static int bi = 0;
  buf[bi] = raw; bi = (bi + 1) % 5;
  float s = 0; for (int i = 0; i < 5; i++) s += buf[i];
  current_velocity = s / 5.0;
  prev_encoder1 = encoder1count;
}

// ============================ 8. 소프트스타트 + 구동 속도 PID =================
void apply_acceleration_limit() {
  float limit = watchdog_tripped ? WATCHDOG_BRAKE_LIMIT
                : ((fabs(target_velocity) > fabs(commanded_velocity)) ? ACCEL_LIMIT : BRAKE_LIMIT);
  float md = limit * VELOCITY_DT;
  if (target_velocity > commanded_velocity) commanded_velocity = min(target_velocity, commanded_velocity + md);
  else if (target_velocity < commanded_velocity) commanded_velocity = max(target_velocity, commanded_velocity - md);
}
// ---- 정지 홀드 (경사로 밀림 방지) — 위치 피드백 ----
// 속도 setpoint 0 은 정지마찰 데드밴드로 못 잡는다(2026-09-02 실측: 안 잡으면
// 계속 스르륵 밀림). 정지 순간 엔코더 위치를 래치하고 위치 PI 로 되돌린다.
// forward = encoder1count 감소(cpr<0) → 뒤로 밀리면 perr>0 → +PWM = 전진.
// target_velocity≈0 이라 구동 스톨가드(safety_guard 줄 625 조건)는 자동 비활성.
// ★ 게인은 벤치 튜닝 시작값. 첫 시험은 반드시 바퀴 들고(공회전) 부호부터 확인:
//   손으로 뒤로 굴리면 바퀴가 전진 방향으로 되밀어야 정상. 반대면 HOLD_KP 부호 뒤집기.
bool  hold_active = false;
long  hold_target = 0;
float hold_isum   = 0.0;
#define HOLD_KP        3.0     // PWM / 엔코더카운트 (되돌림 세기)
#define HOLD_KI        0.5     // 적분 (잔여 밀림 제거)
#define HOLD_ISUM_MAX  300.0   // 적분 권한 제한 (와인드업 방지)
#define HOLD_MAX_PWM   160     // 홀드 최대 PWM
#define HOLD_KD        3.0     // 속도 감쇠(D). 움직임에 저항해 진동 억제. 가속도항=0

void velocity_pid_control() {
  // 개루프 모드: PID를 건너뛰고 지정 PWM을 레이트 제한만 걸어 인가한다.
  if (openloop_active) {
    // 크기가 커지는 쪽만 제한한다(위 OPENLOOP_RATE 주석 참고).
    int tgt = openloop_target_pwm;
    // 방향이 바뀌는 명령은 **0 을 거쳐서** 간다. 한 사이클에 +40 → -40 으로
    // 뒤집으면 전류 스파이크가 난다. 0 까지는 감속이라 제한 없이 내려가고,
    // 반대 방향 가속은 다음 사이클부터 OPENLOOP_RATE 로 붙는다.
    if ((long)tgt * (long)openloop_pwm < 0) tgt = 0;
    int d = tgt - openloop_pwm;
    bool speeding_up = (abs(tgt) > abs(openloop_pwm));
    int lim_rate = speeding_up ? OPENLOOP_RATE : OPENLOOP_RATE_DOWN;
    if (d >  lim_rate) d =  lim_rate;
    if (d < -lim_rate) d = -lim_rate;
    openloop_pwm += d;
    velocity_pwm_output = constrain(openloop_pwm,
                                    -MAX_OPENLOOP_PWM, MAX_OPENLOOP_PWM);
    velocity_error_sum = 0.0;
    velocity_error_old = 0.0;
    commanded_velocity = 0.0;
    return;
  }
#if NO_ENCODER
  // ★ 엔코더 없음: 속도 피드백이 없으므로 PID 를 쓸 수 없다(속도가 늘 0 으로 읽혀
  //   오차가 안 줄고 PWM 이 255 로 포화한다). FF 만으로 개루프 주행한다.
  //   FF 는 지상 실측 역관계(PWM = 80 + 95*v)라 목표속도 근처는 나온다.
  {
    float ffo = 0.0;
    if (commanded_velocity > 0.02)       ffo =  STATIC_FF + VELOCITY_FF_GAIN * commanded_velocity;
    else if (commanded_velocity < -0.02) ffo = -STATIC_FF + VELOCITY_FF_GAIN * commanded_velocity;
    velocity_pwm_output = constrain((int)ffo, -MAX_DRIVE_PWM, MAX_DRIVE_PWM);
    if (fabs(target_velocity) < 0.05 && fabs(commanded_velocity) < 0.05)
      velocity_pwm_output = 0;
    velocity_error = 0.0; velocity_error_sum = 0.0; velocity_error_old = 0.0;
    return;
  }
#endif
  velocity_error = commanded_velocity - current_velocity;
  float ed = (velocity_error - velocity_error_old) / VELOCITY_DT;
  float ff = 0.0;
  if (commanded_velocity > 0.02)  ff =  STATIC_FF + VELOCITY_FF_GAIN * commanded_velocity;
  else if (commanded_velocity < -0.02) ff = -STATIC_FF + VELOCITY_FF_GAIN * commanded_velocity;
  // 조건부 안티와인드업
  float ts = velocity_error_sum + velocity_error * VELOCITY_DT;
  // ★ 적분 클램프. ki 가 4→30 으로 커졌으므로 같은 ±25 를 쓰면 적분 권한이
  // 750 PWM 이 되어 조금만 어긋나도 포화한다. FF 가 맞는 지금은 적분이
  // ±90 PWM 정도만 다듬으면 충분하다 (경사·배터리 새그 보정분).
  ts = constrain(ts, -8.0, 8.0);   // ki=15 → 적분권한 ±120 PWM (FF 오차 보정)   // ki=4 복귀에 맞춰 원래 클램프로
  float tout = ff + velocity_kp * velocity_error + velocity_ki * ts + velocity_kd * ed;
  bool sat_p = (tout > MAX_DRIVE_PWM && velocity_error > 0);
  bool sat_n = (tout < -MAX_DRIVE_PWM && velocity_error < 0);
  if (!sat_p && !sat_n) velocity_error_sum = ts;
  float out = ff + velocity_kp * velocity_error + velocity_ki * velocity_error_sum + velocity_kd * ed;
  velocity_pwm_output = constrain((int)out, -MAX_DRIVE_PWM, MAX_DRIVE_PWM);
  // ---- 정지: coast (PWM 0) ----
  // ★ 2026-09-05 용인: 정지 홀드 PI 제거 → 옛 coast 복귀.
  //   홀드는 target≈0(출발 직후 포함)에 켜지며 엔코더 위치로 잡는데, 이 보드에서
  //   출발하자마자 계속 후진하는 회귀를 유발했다(정지 시 엔코더 값이 불안정 →
  //   perr≠0 → 역방향 구동). 저번 대회에 되던 동작 = 정지 시 coast. 경사로 홀드가
  //   필요하면 엔코더 극성·안정성 확정 후 재도입할 것.
  if (fabs(target_velocity) < 0.05 && fabs(commanded_velocity) < 0.05) {
    velocity_pwm_output = 0;
    velocity_error_sum = 0.0;
    hold_active = false;
  }
  velocity_error_old = velocity_error;
}

// ============================ 9. 조향 위치 PID ================================
void steering_pid_control() {
  // 워치독(comms 끊김) 시: 조향을 중앙으로 몰아붙이지 않고 정지(모터 off).
  // 저PWM 스톨로 모터 태우는 것 방지. comms 복구되면 정상 추종 자동 재개.
  if (watchdog_tripped) {
    steering_pwm_output = 0;
    steering_error_old = 0;
    return;
  }
  int target_adc = steerAngleToADC(target_steer_angle);
  steering_error = target_adc - sensorValue;   // +면 ADC 올려야, −면 내려야
  float ed = steering_error - steering_error_old;
  // 히스테리시스 데드밴드: 목표 도달(±STEER_DEADBAND)하면 멈추고, 다시
  // ±STEER_RESUME 넘어야 재출발 → 중앙 근처를 넘나들며 삐- 하는 리밋사이클/버즈 방지.
  static bool settled = true;
  int ae = abs(steering_error);
  if (settled) { if (ae > STEER_RESUME)  settled = false; }
  else         { if (ae <= STEER_DEADBAND) settled = true;  }

  static int breakaway_boost = 0;
  int pwm;
  if (settled) {
    pwm = 0;                    // 목표 도달 → 정지(무부하·무소음)
    breakaway_boost = 0;
  } else {
    pwm = (int)(steering_kp * steering_error + steering_kd * ed);
    // 스티션 극복: 움직일 땐 최소 이 PWM은 실어줘야 실제로 돈다(steady DC).
    // 이 이하로는 '버즈만 나고 안 움직임'이라 아예 최소값으로 끌어올린다.
    if (abs(pwm) < STEER_MIN_MOVE)
      pwm = (steering_error > 0) ? STEER_MIN_MOVE : -STEER_MIN_MOVE;

    // 정지마찰 탈출 부스트: 명령했는데 ADC가 안 변하면(=안 움직임) PWM을 점점
    // 키운다. 움직이기 시작하면 즉시 0으로 리셋 → 과도한 힘이 남지 않는다.
    // prev_sensorValue는 safety_guard가 매 사이클 끝에 갱신하므로 여기선 직전값.
    bool moving = abs(sensorValue - prev_sensorValue) >= STEER_MOVING_DELTA;
    if (moving) {
      breakaway_boost = 0;
    } else {
      int room = MAX_STEER_PWM - abs(pwm);
      if (room < 0) room = 0;
      breakaway_boost = min(breakaway_boost + STEER_BOOST_STEP, room);
    }
    pwm += (pwm > 0) ? breakaway_boost : -breakaway_boost;
  }
  // ★ 부팅 직후 조향 소프트스타트.
  //
  // 부팅 시 목표각은 0(중앙)이다. 바퀴가 중앙에서 크게 벗어나 있으면 첫 사이클부터
  // 최대 PWM(130)이 걸리고, 그 전류 급증에 보드가 리셋된다. 리셋되면 다시 부팅해
  // 또 슬램 → **바퀴가 중앙에 닿기 전에 영원히 리셋을 반복하는 교착**이 된다.
  // 2026-08-18 현장: 모터가 한 번 돈 뒤부터 300초간 41회 끊김, 모터를 멈춰도
  // 회복되지 않았다. 손으로 바퀴를 중앙에 맞춰야만 풀렸다.
  //
  // 부팅 후 STEER_SOFT_MS 동안 상한을 0→MAX 로 선형 증가시켜 돌입 전류를 없앤다.
  // 조향 속도만 잠깐 느려질 뿐 추종 성능에는 영향이 없다(2초 후 정상).
  int lim = MAX_STEER_PWM;
  unsigned long up = millis();
  if (up < STEER_SOFT_MS) {
    lim = (int)((long)MAX_STEER_PWM * up / STEER_SOFT_MS);
    if (lim < STEER_SOFT_MIN) lim = STEER_SOFT_MIN;
  }
  steering_pwm_output = constrain(pwm, -lim, lim);
  steering_error_old = steering_error;
}

// ============================ 10. ★ 안전가드 (스톨 감지) ======================
void safety_guard() {
  // --- 구동 스톨: PWM 높은데 안 움직이고 목표는 있음 ---
  // ★ NO_ENCODER 모드에서는 이 판정을 건너뛴다. 속도가 늘 0 으로 읽혀 잘 달리는
  //   중에도 700ms 마다 오인 컷되기 때문(실측 확인). 대신 진짜 스톨 보호도 사라지므로
  //   엔코더 직결 후 NO_ENCODER 0 으로 되돌릴 것.
  if (!NO_ENCODER &&
      abs(velocity_pwm_output) > DRIVE_STALL_PWM &&
      fabs(current_velocity) < DRIVE_STALL_SPEED &&
      (fabs(target_velocity) > 0.05 || openloop_target_pwm != 0)) {
    drive_stall_ms += CONTROL_DT_MS;
    if (drive_stall_ms >= DRIVE_STALL_MS) drive_stalled = true;
  } else {
    drive_stall_ms = 0;
  }
  if (drive_stalled) {
    velocity_pwm_output = 0;             // 컷
    velocity_error_sum = 0;
    drive_cut_ms += CONTROL_DT_MS;
    // 해제 조건 ①목표가 0이면 즉시(정상 정지) ②쿨다운 경과 시 재시도
    //          (출발지연·일시적 걸림을 스스로 회복. 진짜 스톨이면 재트립).
    if ((fabs(target_velocity) < 0.05 && openloop_target_pwm == 0) ||
        drive_cut_ms >= DRIVE_STALL_COOLDOWN_MS) {
      drive_stalled = false;
      drive_cut_ms = 0;
      drive_stall_ms = 0;
    }
  } else {
    drive_cut_ms = 0;
  }

  // --- 조향 스톨: PWM 높은데 ADC 안 변하고 오차 큼 ---
  if (abs(steering_pwm_output) > STEER_STALL_PWM &&
      abs(sensorValue - prev_sensorValue) < STEER_STALL_DELTA &&
      abs(steering_error) > STEER_STALL_ERR) {
    steer_stall_ms += CONTROL_DT_MS;
    if (steer_stall_ms >= STEER_STALL_MS) steer_stalled = true;
  } else {
    steer_stall_ms = 0;
  }
  if (steer_stalled) {
    steering_pwm_output = 0;             // 컷 (모터 보호)
    steering_error_sum = 0;
    steer_cut_ms += CONTROL_DT_MS;
    // 해제 조건 ①목표 근처로 오면(외부에서 밀렸거나 목표가 바뀜) 즉시
    //          ②쿨다운 경과 시 재시도 (영구 사망 방지)
    if (abs(steering_error) < STEER_STALL_ERR ||
        steer_cut_ms >= STEER_STALL_COOLDOWN_MS) {
      steer_stalled = false;
      steer_cut_ms = 0;
      steer_stall_ms = 0;
    }
  } else {
    steer_cut_ms = 0;
  }
  prev_sensorValue = sensorValue;
}

// ============================ 11. 시리얼 파서 + 워치독 ========================
void parseCommand(String line) {
  line.trim();
  if (line.length() == 0) return;
  int vi = line.indexOf("VEL:");
  if (vi >= 0) {
    int st = vi + 4, en = line.indexOf(",", st);
    float v = (en >= 0 ? line.substring(st, en) : line.substring(st)).toFloat();
    target_velocity = constrain(v, -3.0, 3.0);
    if (openloop_active) {           // VEL 명령 → 즉시 폐루프 복귀
      openloop_active = false;
      openloop_target_pwm = 0;
      openloop_pwm = 0;
    }
  }
  // 개루프 식별 명령: "PWM:<-140..140>" — 속도 PID를 우회한다.
  int pi = line.indexOf("PWM:");
  if (pi >= 0) {
    int st = pi + 4, en = line.indexOf(",", st);
    int v = (en >= 0 ? line.substring(st, en) : line.substring(st)).toInt();
    openloop_active = true;
    openloop_target_pwm = constrain(v, -MAX_OPENLOOP_PWM, MAX_OPENLOOP_PWM);
    target_velocity = 0.0;
    commanded_velocity = 0.0;
  }
  int si = line.indexOf("STEER:");
  if (si >= 0) {
    int st = si + 6, en = line.indexOf(",", st);
    float s = (en >= 0 ? line.substring(st, en) : line.substring(st)).toFloat();
    target_steer_angle = constrain(s, -STEER_MAX_ANGLE, STEER_MAX_ANGLE);
  }
  last_rx_time = millis();
  watchdog_tripped = false;
}
void check_watchdog() {
  if (millis() - last_rx_time > SERIAL_TIMEOUT_MS) {
    if (!watchdog_tripped) Serial.println("WATCHDOG: serial timeout - stop");
    watchdog_tripped = true;
    target_velocity = 0.0;
    openloop_active = false;      // 개루프도 즉시 해제
    openloop_target_pwm = 0;
    openloop_pwm = 0;
    // 조향은 중앙으로 몰지 않고 정지(freeze)한다. comms 끊긴 뒤 중앙 복귀를
    // 시도하다 breakaway 스티션에 걸려 저PWM 스톨 → 모터 발열/소손하는 것을 방지.
    // (steering_pid_control이 watchdog_tripped를 보고 PWM 0 출력)
  }
}

// ============================ 12. 텔레메트리 (serial_bridge 포맷) =============
void send_telemetry() {
  unsigned long now = millis();
  if (now - last_tel_time < TEL_INTERVAL_MS) return;
  last_tel_time = now;
  const char* slope = "FLAT";
  Serial.print("STATUS_10ms: ENC1="); Serial.print(encoder1count);
  Serial.print(" VEL="); Serial.print(current_velocity, 3);
  Serial.print(" TARGET="); Serial.print(target_velocity, 3);
  Serial.print(" PWM="); Serial.print(velocity_pwm_output);
  Serial.print(" SLOPE="); Serial.print(slope);
  Serial.print(" MODE="); Serial.print(openloop_active ? "OPENLOOP" : "PID");
  // 소나 ping_cm()은 에코 대기(최대 ~11ms/개) 블로킹이라 3개를 한 번에 핑하면
  // 100Hz 제어루프가 밀린다. 매 텔레메트리(50ms)마다 1개씩만 순번으로 핑하고
  // 나머지는 직전 캐시값을 낸다(각 소나 ~150ms/6.7Hz 갱신). 완전 비블로킹이
  // 필요하면 NewPing 타이머(ping_timer) 방식으로 후속 고도화.
  static float sonar_m[SONAR_NUM] = {0, 0, 0};
  static uint8_t si = 0;
  sonar_m[si] = sonar[si].ping_cm() / 100.0;
  si = (si + 1) % SONAR_NUM;
  Serial.print(" SONAR1="); Serial.print(sonar_m[0], 2);
  Serial.print(" SONAR2="); Serial.print(sonar_m[1], 2);
  Serial.print(" SONAR3="); Serial.println(sonar_m[2], 2);
  // 조향 진단 (ADC 현재/목표, PWM, 목표각)
  Serial.print("STEER: ADC="); Serial.print(sensorValue);
  Serial.print(" TGT="); Serial.print(steerAngleToADC(target_steer_angle));
  Serial.print(" PWM="); Serial.print(steering_pwm_output);
  Serial.print(" ANG="); Serial.print(target_steer_angle, 1);
  // ANGACT = ADC로 환산한 '실제' 조향각. ANG(명령각)과의 차이가 추종 오차다.
  Serial.print(" ANGACT="); Serial.print(steerADCToAngle(sensorValue), 1);
  // 공급전압: 현재값과 이 구간 최솟값(스톨 sag 확인용). 보고 후 최솟값 리셋.
  Serial.print(" VCC="); Serial.print(vcc_mv);
  Serial.print(" VMIN="); Serial.println(vcc_min_mv);
  vcc_min_mv = 9999;
  // 스톨 진단
  if (drive_stalled || steer_stalled) {
    Serial.print("STALL: drive="); Serial.print(drive_stalled);
    Serial.print(" steer="); Serial.println(steer_stalled);
  }
}

// ============================ 13. setup ======================================
void setup() {
  Serial.begin(57600);

  // ---- PWM 주파수 상향 (모터 '삐-' 소음 제거) ----
  // analogWrite 기본 주파수가 490Hz라 가청대역에서 모터 코일이 울린다(삐 소리).
  // ★ 구동과 조향의 드라이버 특성이 달라 **타이머별로 주파수를 다르게** 준다.
  //   Timer3 = 핀 2,3,5 → 구동(MOTOR1_PWM=5, MOTOR2_PWM=2)
  //   Timer4 = 핀 6,7,8 → 조향(MOTOR3_PWM=8)
  //   Timer0(핀 4,13)은 millis()/delay()용 — 절대 건드리지 않는다.
  //
  // 실측(2026-08-13):
  //   구동: 490Hz만 정상. 3.9kHz·31kHz에선 **회전 자체가 안 됨**(PWM만 오르고
  //         속도 0 → 스톨가드 컷). 드라이버 게이트 스위칭이 느려서 고주파에선
  //         온타임 대부분이 전환손실로 날아가는 것으로 보인다.
  //   조향: 3.9kHz에서 정상 동작 확인(ADC 684카운트 이동). 490Hz의 가청 소음이
  //         줄어든다.
  // → 구동은 기본값(0x03=/64, 488Hz) 유지, 조향만 0x02(=/8, 3.9kHz)로 올린다.
  TCCR3B = (TCCR3B & 0b11111000) | 0x03;   // 구동 488Hz (드라이버 한계)
  TCCR4B = (TCCR4B & 0b11111000) | 0x02;   // 조향 3.9kHz (소음 저감)

  // (핀13 하트비트 제거: 핀13은 SONAR3 트리거/에코와 충돌 → 소나 정합성 우선)
  int mp[] = {MOTOR1_PWM,MOTOR1_ENA,MOTOR1_ENB,MOTOR2_PWM,MOTOR2_ENA,MOTOR2_ENB,MOTOR3_PWM,MOTOR3_ENA,MOTOR3_ENB};
  for (int i = 0; i < 9; i++) pinMode(mp[i], OUTPUT);
  all_motors_off();                 // 부팅 시 안전 상태
  initEncoders(); clearEncoderCount(1); clearEncoderCount(2);
  sensorValue = analogRead(Steering_Sensor);
  prev_sensorValue = sensorValue;
  prev_time = last_rx_time = last_tel_time = millis();
  Serial.println("HENES firmware ready: drive PID + steer PID + STALL guard + watchdog");
  Serial.print("  STEER cal: center="); Serial.print(STEER_CENTER);
  Serial.print(" L="); Serial.print(STEER_LEFT_MAX);
  Serial.print(" R="); Serial.print(STEER_RIGHT_MAX);
  Serial.print("  MAX_PWM drive="); Serial.print(MAX_DRIVE_PWM);
  Serial.print(" steer="); Serial.println(MAX_STEER_PWM);
}

// ============================ 14. loop (100Hz 제어) ===========================
void loop() {
  // 시리얼 수신
  while (Serial.available() > 0) {
    String cmd = Serial.readStringUntil('\n');
    parseCommand(cmd);
  }
  check_watchdog();

  unsigned long now = millis();
  if (now - prev_time >= CONTROL_DT_MS) {
    prev_time = now;

    // 센서 갱신
    encoder1count = readEncoder(1);
    encoder2count = readEncoder(2);
    sensorValue = analogRead(Steering_Sensor);
    // 공급전압 감시 (스톨 순간 sag를 놓치지 않도록 매 주기 샘플 + 최솟값 유지)
    vcc_mv = readVccMv();
    if (vcc_mv > 0 && vcc_mv < vcc_min_mv) vcc_min_mv = vcc_mv;
    calculate_velocity();

    // 제어 계산
    apply_acceleration_limit();
    velocity_pid_control();
    steering_pid_control();

    // ★ 안전가드 (PID 결과를 덮어씀)
    safety_guard();

    // 모터 출력
    front_motor_control(velocity_pwm_output);
    rear_motor_control(velocity_pwm_output);
    steer_motor_control(steering_pwm_output);
  }

  send_telemetry();
}
