hanmin0211/racing_ws/data/2026-09-19/prelim_gujeol_1410/params/launch_params_b3gywqyk.yaml

/**:
  ros__parameters:
    auto_drive: false
    auto_speed: 0.5
    auto_speed_cap: 2.0
    calib_distance: 6.0
    fix_topic: /fix
    imu_topic: handsfree/imu
    invert_imu_yaw: false
    max_jump_speed: 2.0
    retry_start_radius: 2.0
