hanmin0211/racing_ws/bringup/config/ekf_gps.yaml

### ekf_node 설정 (IMU + GPS(변환된 좌표) 융합)
ekf_filter_node:
  ros__parameters:
    frequency: 30.0
    two_d_mode: true
    publish_tf: true
    map_frame: map
    odom_frame: odom
    base_link_frame: base_link
    world_frame: odom

    # IMU 입력 (자세, 각속도만 사용. 가속도는 사용 안 함 - 드리프트 방지)
    imu0: /handsfree/imu/corrected
    imu0_config: [false, false, false,
                  true,  true,  true,
                  false, false, false,
                  true,  true,  true,
                  false, false, false]
    imu0_differential: false
    imu0_relative: false
    imu0_queue_size: 10
    imu0_remove_gravitational_acceleration: true

    # GPS를 변환한 오도메트리 입력 (navsat_transform_node가 만들어줌)
    odom0: /odometry/gps
    odom0_config: [true,  true,  false,
                   false, false, false,
                   false, false, false,
                   false, false, false,
                   false, false, false]
    odom0_differential: false
    odom0_relative: false
    odom0_queue_size: 10

### navsat_transform_node 설정 (GPS 위경도 -> 로컬 x,y 변환)
navsat_transform:
  ros__parameters:
    frequency: 30.0
    delay: 3.0
    magnetic_declination_radians: 0.0
    yaw_offset: 0.0
    zero_altitude: true
    broadcast_utm_transform: true
    publish_filtered_gps: true
    use_odometry_yaw: false
    wait_for_datum: false
