hanmin0211/racing_ws/(commit log)

2026-08-15 초기 커밋: 검증 완료 상태 스냅샷 (조향/구동 벤치 통과)
    이 시점의 검증 상태:
    - 조향: 캘리브(중앙 424, 20°), 부호 확정, 단일 선형 스케일(21.2 counts/도),
    정확도 오차 ≤1.2°, 정지마찰 부스트, 60초 연속 x2 재현성 확인
    - 구동: 방향(전진/후진), 스톨가드 실작동, 무부하 안정 수렴
    - 안전: E-stop, 워치독 freeze, 엔드스톱, 스톨 컷/쿨다운 전부 실측 검증
    - ROS 체인: teleop → vehicle_cmd_mux → serial_bridge → 펌웨어 관통 확인
    - 로컬라이제이션/경로: RTK+IMU 야외 검증됨
    미해결(코드리뷰에서 발견, 다음 커밋들에서 수정 예정):
    - local_sliding_win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
    [control.launch.py]
2026-08-15 로컬 경로 생성 개정: 호길이 매개변수 피팅 + 열린경로 지원 + 전방 곡률
    오프라인 하네스(tools/local_path_harness.py)로 재현·검증한 3개 결함 수정.
    계산부를 local_path_core.py 로 분리해 하네스와 노드가 같은 코드를 쓴다.
    1) y=f(x) 3차 피팅 → 호길이 매개변수 x(s), y(s)
    급코너에서 경로가 차량 뒤로 말리면 x가 단조롭지 않아 표현 불가였음.
    실측: 179지점 중 39지점(22%)에서 전제 붕괴.
    2) 순환 인덱싱(% total) → 열린/닫힌 경로 자동 판정
    기록 경로는 시작-끝 3.82m 벌어진 열린 경로인데 순환시켜 이음매마다
    경로가 3.82m 튀었음.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
    [local_path_harness.py]
2026-08-15 안전 보강: GPS 끊김 감지, 헤딩 캘리브 직진성 검증, 기본 경로 정정
    코드리뷰에서 나온 나머지 결함 3건 수정.
    1) direct_localization: fix_timeout(1.0s) 추가
    예전엔 /fix가 끊겨도 마지막 위치를 30Hz로 계속 발행했다. 차는 움직이는데
    위치는 고정되어 하류가 엉뚱한 경로를 따라가면서도 타임아웃이 안 걸렸다.
    이제 끊기면 발행을 중단해 local_sliding_window/pure_pursuit가 정지한다.
    2) heading_init: 직진성 검증(max_deviation_deg, 기본 20°)
    시작점→현재점 '직선 방향'을 헤딩으로 쓰므로, 캘리브 중 휘거나 후진하면
    yaw_offset이 통째로 틀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
2026-08-15 구동 캘리브 도구 일습: 개루프 모드 + 엔코더 스케일 검증 + FF 자동 식별
    구동(60%)을 잡기 위한 도구를 모두 준비. 야외 세션 한 번에 끝낼 수 있게
    측정→계산→적용값 출력까지 자동화했다.
    펌웨어:
    - 개루프 모드 추가. `PWM:x` 명령이 오면 속도 PID를 우회하고 지정 PWM을 인가.
    FF 식별에는 'PWM과 실제속도의 관계'가 필요한데 PID가 개입하면 가려진다.
    레이트 제한(3/사이클), 별도 상한(MAX_OPENLOOP_PWM 140), 스톨가드·워치독 유지.
    `VEL:` 수신 시 즉시 폐루프 복귀. 텔레메트리에 MODE= 추가.
    serial_bridge:
    - /encoder_count, /drive_pwm 발행 (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
2026-08-15 야외 세션 종합 체크리스트 추가 (FIELD_SESSION.md)
    실내 준비가 끝나 남은 작업이 전부 야외인 상태. 의존관계 순서대로 정리했다.
    세션 A(기본검증+구동캘리브 1.5h) → 세션 B(경로기록+통합주행 2h).
    포함: 챙길 것, 단계별 명령·통과기준·실패 시 조치, 안전수칙,
    시간 부족 시 우선순위(헤딩 반전 확정 → 엔코더 스케일이 최우선).
    구동 캘리브 상세는 DRIVE_CALIB.md 참조.
2026-08-15 폐기된 ros2-ublox-zedf9p 빌드 제외 (COLCON_IGNORE)
    빌드 실패 원인: build/ublox_msgs 에 심볼릭 링크 자리에 디렉터리가 남아
    ament_cmake_python 심링크 생성이 실패했다. 이 패키지들은 RTCM 주입 미지원으로
    폐기한 옛 ublox 드라이버이고, 실제 RTK는 apt의 ublox_dgnss_node 를 쓴다.
    우리 소스 중 ublox_msgs/ublox_gps/ublox_serialization 에 의존하는 것은 없다.
    COLCON_IGNORE 로 제외 → 빌드 실패 재발 방지 + 빌드 시간 단축.
    전체 재빌드 13개 패키지 성공, 현장용 노드 전부 확인.
2026-08-15 야외 절차서 수정: RTK 중복 실행 경고 + udev 규칙 확인 추가
    현장에서 발견한 두 문제 반영.
    1) bringup.launch.py 가 ngii_rtk 를 이미 포함하는데 절차서가 따로 켜라고 안내해
    NTRIP 클라이언트가 2개가 됐다. NGII 계정당 1접속 제한 → 401 Unauthorized,
    RTCM 0프레임. ublox_dgnss 도 중복 실행되어 USB 충돌.
    → bringup 하나만 켜도록 수정.
    2) /etc/udev/rules.d/99-ublox-dgnss.rules 가 실제로는 없어서
    ublox_dgnss_node 가 LIBUSB_ERROR_ACCESS 로 죽었다(NTRIP은 정상이라 헷갈림).
    → 세션 시작 전 확인 단계와 생성 명령 추가.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
2026-08-15 ROS 고아 프로세스 정리 스크립트 추가 (tools/ros_cleanup.sh)
    현장에서 RTK가 계속 401 Unauthorized 였던 근본 원인.
    `pkill -f ros2` 는 런처만 죽인다 — 노드 실행파일 경로가 /opt/ros/humble/lib/... 라
    'ros2' 패턴에 안 걸려 자식 노드가 고아로 남는다. 재실행할수록 쌓여서
    NTRIP 클라이언트 3개 / global_path_publisher 4개가 되었고, NGII 계정당 1접속
    제한에 걸려 RTCM 0프레임이 되었다.
    - tools/ros_cleanup.sh : 실행파일 경로 기준으로 확실히 정리 + 잔존 개수 확인
    (확인은 pgrep -x 로 해야 스크립트 자신이 오탐되지 않는다)
    - FIELD_SESSION.md : 재실행 전 정리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
2026-08-15 ros_cleanup.sh 잔존 확인 방식 수정 (오탐/미탐 제거)
    확인 부분이 틀린 값을 주고 있었다. 두 가지 문제:
    - `pgrep -f <패턴>` : 스크립트 자신의 명령줄이 패턴에 걸려 오탐
    (실제로 ublox_dgnss 가 1개인데 3개로, rviz2 가 0개인데 2개로 나왔다)
    - `pgrep -x <이름>` : 리눅스가 프로세스명을 15자로 자르므로 매칭 실패
    (ublox_dgnss_node → ublox_dgnss_nod) → 프로세스가 있어도 0으로 보고
    `ps -eo comm` + 15자 절단 이름으로 비교하도록 수정하고,
    파이썬 노드(comm=python3)를 위해 경로 기준 확인을 추가했다.
    `|| echo 0` 때문에 0이 두 번 찍히던 것도 제거.
    C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
2026-08-15 헤딩 부호 검증 도구 추가 (tools/heading_check.py)
    헤딩 초기화 직후의 yaw=course 비교는 순환논리라 부호 검증이 안 된다.
    yaw 부호가 뒤집혔다면 **회전할 때** yaw가 반대로 돌아 오차가 벌어지므로,
    곡선 주행 중 위치변화로 계산한 course 와 보고된 yaw 를 비교한다.
    판정: 평균오차 <20° 정상 / ~180° 뒤집힘 / 회전구간에서 오차 증가면 부호반전.
    현장 중간 결과(2026-08-15): 헤딩 초기화 성공(yaw_offset=173.5°),
    yaw -142.5° 가 GPS course -142.3° 와 일치하고 /local_path 끝점이
    (+7.23,+4.34) 로 차량 앞을 향함 → 180° 뒤집힘은 아님. 부호는 이 도구로 확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
2026-08-15 IMU 끊김 감지 추가 (imu_timeout) — 현장에서 실제로 터진 결함
    2026-08-15 현장: 주행 중 A9 IMU가 송신을 멈췄다. 노드 프로세스는 살아있고
    포트도 잡고 있어서 아무도 눈치채지 못했고, direct_localization 은 마지막
    yaw(+34.1°)를 30Hz로 계속 발행했다. 차량은 175° 넘게 회전했는데 헤딩은
    그대로여서 실제 진행방향(course)과의 오차가 180°까지 벌어졌다.
    이 상태로 자율주행하면 경로를 완전히 이탈한다.
    GPS 끊김(fix_timeout)은 이미 막아뒀는데 IMU 는 같은 구멍이 남아 있었다.
    imu_timeout(기본 0.5s) 초과 시 odom 발행을 중단해 하류(local_sliding_windo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
2026-08-15 전원 순서 경고 추가 + encoder_calib 대기 메시지 개선
    현장에서 엔코더가 83.6m 주행에 2카운트만 세어 캘리브가 무의미했다.
    원인은 하드웨어가 아니라 **부팅 순서**:
    엔코더 SPI 카운터 칩 설정은 아두이노 setup() 의 initEncoders() 에서 부팅 시
    한 번만 들어가는데, 배터리가 꺼진 상태로 아두이노가 부팅되면 칩에 전원이 없어
    설정이 안 들어가고, 나중에 배터리를 켜도 카운트하지 않는다.
    (같은 날 낮 벤치에서는 배터리를 먼저 켰기에 정상 동작했다: ENC1 -563/-683)
    - DRIVE_CALIB.md / FIELD_SESSION.md 에 전원 순서 경고 추가
    ① 차량 배터리 O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
2026-08-15 엔코더 스케일 RTK 실측 보정: wheel_radius 0.13 → 0.1327
    2026-08-15 야외 세션에서 encoder_calib 로 처음 검증했다.
    RTK 직선 8.844m vs 엔코더 환산 8.664m(3076counts), 직진편차 0.24m
    → 보정계수 1.0208. 주행 내내 1.013~1.021 로 안정 수렴.
    counts_per_revolution=-290 / wheel_radius=0.13 은 그동안 한 번도 검증된 적이
    없었고, 이 값이 틀리면 그 위의 FF·PID·목표속도가 통째로 어긋난다.
    실측 결과 오차는 2%로 작았다(공칭 반경이 약간 작게 잡혀 있었음).
    현장 기록:
    - 엔코더가 안 세는 것처럼 보였던 원인은 하드웨어가 아니라, 키보드가 한글 입력
    상태여서 te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
2026-08-15 첫 실주행 피드백 반영: 코너 감속 강화 + 추종 모니터 추가
    현장 첫 통합 주행에서 "코너가 빠르고 경로를 잘 못 따라간다"는 관찰.
    근본 원인은 FF 미보정으로 실제 속도가 명령보다 높게 나오는 것이고,
    그 위에서 lookahead(속도 비례)까지 흔들려 조향이 불안정해진다.
    FF 식별(ff_sweep) 전까지 완화할 수 있는 부분을 조정했다.
    ★ 주의: 통합 모드에서 속도는 longitudinal_controller 가 소유한다.
    pure_pursuit 의 target_speed/curvature_speed_gain 은 standalone 에서만 쓰인다.
    (처음에 그쪽만 고쳤다가 실제로 적용되지 않는 것을 발견해 바로잡음)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
2026-08-16 HANDOFF.md 전면 개정 — 2026-08-16 현재 상태로 갱신
    이전 버전(08-13)은 값이 여러 개 틀려 그대로 두면 위험했다:
    최대타각 30°(실제 20°), 조향 부호(반대였음), wheel_radius 0.13(실제 0.1327),
    조향 중앙 459(실제 424) 등.
    새 문서 내용:
    - 현재 완료/미완 상태 (첫 통합 자율주행 성공: 30.7m, 평균오차 0.32m)
    - 캘리브 값 전부 근거와 함께 (왜 그 값인지, 어떻게 바꾸는지)
    - 아키텍처와 역할 분담 원칙 (PWM은 펌웨어 소유, /cmd_vel 규약, 속도 소유자)
    - 파일 지도, 실행 명령, 진단 방법
    - ★ 함정 10개 — 전부 실제로 당한 것 (고아 프로세스, 전원 순서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
2026-08-16 헤딩 캘리브 재시작 대기 추가 — 현장 2연속 실패의 실제 원인
    직진성 검증 실패 시 lat0=None 으로 리셋하면 다음 fix 콜백이 곧바로 새
    시작점을 잡아버린다. 그래서 운전자가 차를 되돌리는 동작이 다음 시도의
    앞구간으로 기록돼 또 거부된다.
    2026-08-16 현장 로그에 그대로 남아 있다:
    804846.761 ❌ 직진이 아닙니다 (최대 편차 43°)
    804846.870 시작점 기록 ← 110ms 뒤, 아직 차 되돌리는 중
    804948.072 ❌ 직진이 아닙니다 (최대 편차 157°) ← 그래서 또 실패
    이제 실패 후에는 차량이 restart_settle_sec(기본 3s) 동안 멈춰 있어야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
2026-08-16 헤딩 캘리브 자동 직진 + 조향 중앙 역산 (실험적, 기본 꺼짐)
    사람이 구루마로 미는 10m 직진이 매번 한쪽으로 기운다. 조향 0°를 유지하는
    건 기계가 낫다. auto_calib:=true 면 차량이 스스로 10m 전진해 헤딩을 잡는다.
    명령은 /teleop/cmd_vel 로 낸다. vehicle_cmd_mux 우선순위가
    E-stop > teleop > 자율 이라, mux를 고치지 않고 세 가지를 얻는다:
    - pure_pursuit의 '정지'(AUTO)를 덮어써서 두 노드가 안 싸운다
    - mux의 teleop_timeout(0.5s)이 데드맨 — 노드가 죽으면 0.5초 안에 정지
    - E-stop이 그대로 최상위로 남는다
    ★ 조향 중앙 역산: 조향 0°를 명령했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
2026-08-16 자동 직진 궤적 버퍼에 상한 추가
    조향 중앙 역산용 self.track 이 GPS 콜백마다 무한정 쌓였다. 캘리브가
    끝나지 않고 세션이 길어지면(10m 미달 상태로 방치 등) 계속 커진다.
    시간당 2MB 수준이라 위험하진 않지만 87e2ea7 이전엔 없던 무한 증가다.
    2000점 상한. 정상 캘리브(10m, ~5Hz)는 100점 안팎이라 걸릴 일이 없다.
    회귀 28/28 통과.
2026-08-16 HANDOFF 갱신: FF 실측 근거 + 재시작 함정 + auto_calib
    측정된 것만 확정으로, 미검증은 미검증으로 표기했다. 기존 캘리브 수치·
    파라미터·아키텍처는 건드리지 않았다.
    - §1/§8 구동 FF: "근거 불명" → 2026-08-16 주행 GPS 로그의 실측으로 교체.
    명령 하한 0.25m/s 대비 실제 중앙값 0.157, 65구간 중 63구간 미달,
    t+90~96s 6초 스톨 후 0.33 급발진. 무부하 측정과 반대 방향이라는 점도 명시.
    - §7 함정 11: 캘리브 거부 뒤 110ms 만에 재측정을 시작하던 문제 (고쳐짐)
    - §6 실행: auto_calib 인자 (실차 미검증 명시)
    - §3 조향 중앙: auto_calib으로 매 세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
2026-08-16 미션 인지 첫 단추: 카메라 노드 (mission_perception)
    카메라 드라이버가 아예 없던 상태 → /camera/image_raw 1280x720 @15Hz.
    Logitech C920 (/dev/video2). /dev/video0 은 노트북 내장이라 구분 주의.
    ★ image_tools/cam2image 를 안 쓴 이유 — FOURCC 를 설정할 수 없다.
    기본 백엔드(GStreamer)로 열리면 YUYV 무압축이라 USB 대역폭에 막힌다.
    2026-08-16 실측:
    기본 백엔드 1280x720 9.1 fps
    V4L2 + MJPG 1280x720 30.0 fps
    cv2.VideoCapture(dev, cv2.CAP_V4L2) + FOURCC MJPG 한 줄 차이로 3배다.
    발행은 기본 15Hz 로 캡처와 분리했다. raw bgr8 720p@30 은 82MB/s 인데
    이 노트북은 r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
2026-08-16 파이(Hailo-8) 쪽 코드·절차를 저장소로 편입 + 신호등 오탐 시간필터
    지금까지 파이 코드는 SD카드에만 있었다. 카드가 죽으면 같이 사라지므로
    원본을 여기 두고 파이는 배포본으로 삼는다. (해시 대조로 동일 확인)
    ★ 시간 필터 (detector_node.py)
    필터 없던 버전은 카메라가 신호등을 보고 있지 않아도 1프레임짜리 GREEN
    오탐을 그대로 발행했다. 이 값이 차량 제어로 들어가면 한 프레임 오탐이
    곧 '출발' 명령이 되고, RED 쪽으로 튀면 급정거가 된다.
    필터 전: 6.6초에 4번 잘못된 상태 변화 (매번 1프레임)
    필터 후: 41초에 0번 (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
2026-08-16 HANDOFF 갱신: 파이+Hailo 신호등 인식 반영, 완성도 재산정
    "미션 인지 0% — 카메라 드라이버조차 없음" 은 노트북 기준이었고, 파이 쪽은
    이미 구축돼 있었다(Ubuntu 24.04 + HailoRT 4.24.0 + ROS2 Humble 소스빌드 +
    yolov8s.hef). 2026-08-16 실측으로 확인하고 문서를 실제에 맞췄다.
    - §1 완료: 신호등 인식 30Hz 발행 + 노트북 수신 확인
    - §1 남은것: "미션 인지 0%" → 정지선·횡단보도(모델에 클래스 없음)와
    주행 연동(토픽은 오는데 소비자 없음)으로 분리. 뭉뚱그리면 이미 된 것까지
    0%로 보인다
    - §2 하드웨어: 파이5+AI HAT+, C920은 **파이에** 꽂힌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
2026-08-16 COCO 사전학습 모델로 세로 신호등 상태 판별 (기존 모델과 비교용)
    기존 커스텀 2클래스 모델은 누가 언제 무슨 데이터로 학습했는지 불명이고,
    best.pt·데이터셋·Dataflow Compiler 가 이 노트북에도 파이에도 없다.
    즉 지금 상태로는 재학습도 수정도 불가능하다. 대안을 하나 확보해둔다.
    Hailo Model Zoo v2.13.0 사전컴파일 yolov8s(COCO 80클래스)를 받아 썼다.
    학습·라벨링·DFC 설치가 전부 불필요하다. COCO 의 traffic light 사진은
    대부분 서구권 도로의 세로 3구라 대회 신호등(세로 3구)과 형태가 맞는다.
    HailoRT 4.24.0 에서 정상 파싱, 칩에서 240 F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
2026-08-16 COCO 검출 전처리를 letterbox 로 수정 + 거리별 실측
    ★ 버그: coco_detector_node 가 cv2.resize(frame,(640,640)) 로 640x480 을
    정사각으로 늘려 세로를 1.33배 왜곡시키고 있었다. YOLO 는 왜곡 없는
    이미지로 학습돼 있어 검출률이 떨어진다. 기존 detector_node 가 쓰는
    common.toolbox.default_preprocess(비율 유지 + 회색 패딩)로 맞췄다.
    램프 위치 판별은 박스 내 상대 위치라 왜곡에 영향을 안 받지만, 검출
    자체가 나빠지면 판별할 박스가 애초에 안 나온다.
    ★ 거리별 실측 (합성 렌더를 칩에 직접 투입 — 카메라·모니터 불필요)
    거리 신호부폭 RED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
2026-08-16 오프라인 램프 판별 테스트 수정 — 스텁이 common.toolbox 를 못 덮었다
    632f7a6 에서 coco_detector_node 에 `from common.toolbox import
    default_preprocess` 를 추가했는데 테스트 스텁을 같이 안 고쳤다.
    common 이 일반 모듈이라 하위 모듈 import 가 안 됐다 (__path__ 필요).
    커밋까지 나간 이유: 검증 명령을 `python3 ... | tail -2 && git commit` 로
    엮어서, python 이 실패해도 tail 의 종료코드 0 이 && 를 통과시켰다.
    파이프 뒤에 tail 을 붙이면 앞단 실패가 가려진다.
    수정 후 10/10 통과, 종료코드 0 확인.
2026-08-16 신호등 → 주행 연동: traffic_light_bridge (제어 코드는 무수정)
    파이가 쏘는 /traffic_light_state 는 "빨강이다"까지만 알고 어디서 설지는
    모른다. 반대로 longitudinal_controller 는 정지선까지의 '거리'만 있으면
    알아서 선다 — √(2ad) 감속과 0.3m 하드정지가 이미 구현돼 있고 입력만
    없었다(주석에 "미구현 시 무시"). 그 사이를 잇는다.
    /traffic_light_state + /odometry/filtered + GPS 정지지점
    → /stop_line_distance → longitudinal_controller (기존 로직)
    정지선을 카메라로 안 찾는 이유: 모델에 클래스가 없고 새로 학습하려면
    데이터 수집부터다. 정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
2026-08-16 대회장용 정지지점 기록 도구 (stop_point_recorder)
    차를 정지선에 세우고 엔터만 누르면 기록된다. Ctrl-C 하면
    traffic_light_bridge 에 그대로 붙여넣을 문자열이 나오고 YAML 로도 저장된다.
    ★ 헤딩 캘리브가 필요 없다 — 기록에는 /fix(위치)만 쓴다. 10m 직진은 주행에
    필요한 것이지 좌표를 찍는 데는 아니다. 대회장 준비 시간을 아끼는 지점.
    ★ 저장 YAML 에 origin_x/y 를 같이 적는다. 원점이 다른 노드와 어긋나면
    정지 지점이 통째로 엉뚱한 데로 가는데, 그게 조용히 일어나는 것을 막는다.
    ★ 안테나 기준이라는 점을 문서화했다. 기록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
2026-08-16 자동 직진 주행 노드 (straight_drive) — 사람이 밀거나 키를 잡지 않아도 됨
    헤딩 캘리브(10m), 엔코더 캘리브(15~20m), FF 식별 구간(30m) 확보를 차가 직접 한다.
    ★ 거리를 RTK 위치로 잰다(시간×속도가 아니라).
    현재 차량은 명령보다 느리게 나간다(0.25 명령 → 실측 0.157m/s)이므로
    시간 기준이면 30m 지시에 19m밖에 못 간다.
    ★ 직진 유지: 출발 헤딩을 기억하고 벗어나면 조향으로 되돌린다.
    보정각은 max_correction(기본 5°)으로 제한해 폭주를 막는다.
    안전: 목표 1m 전 감속 정지 / odom 끊기면 즉시 정지 / 타임아웃
    (예상시간 3배+15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
2026-08-16 straight_drive: 주행 중 헤딩 캘리브로 생기는 유령 오차 수정
    현장(2026-08-16)에서 30m 자동직진 중 '헤딩오차 -135°' 가 표시되고 뒤쪽 20m가
    실제로 휘었다. 원인은 차량이 돈 게 아니라 **기준이 바뀐 것**:
    heading_init 이 10m 지점에서 캘리브를 끝내며 yaw_offset(130.3°)을 발행하면
    direct_localization 의 yaw 가 그만큼 통째로 점프한다. 그런데 straight_drive 는
    출발 시점(캘리브 전) yaw 를 기준(yaw0)으로 잡고 있어서, 점프한 만큼이 그대로
    '오차'로 잡히고 조향 보정(+5°)이 끝까지 들어가 진짜로 휘었다.
    검증: 출발 (-7.11,4.00) → 종료 (-35.86,-15.90),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
    [straight_drive_node.py]
2026-08-16 FF 실측 반영 + 도구 자동종료 + 도착감속 완화
    FF 식별(ff_sweep, 103샘플, 잔차 4.3 PWM):
    STATIC_FF 35.0 → 40.5
    VELOCITY_FF_GAIN 60.0 → 20.7 (속도항이 3배 과다했다)
    MAX_DRIVE_PWM 80 → 111
    velocity_kp/ki 30/24 → 8/4 (급발진 원인이던 적분 와인드업 완화)
    결과: 30m 주행 실측 0.198 → 0.257 m/s (+30%). 다만 명령 0.4 의 64% 로 아직 부족.
    남은 원인 후보는 (a) 엔코더 과대측정 (b) 경사 — encoder_calib 동시 실행으로 판별 예정.
    도구 수정:
    - straight_drive / ff_sweep 이 완료 후 스스로 종료한다. 끝난 노드가 살아남아
    0을 계속 발행하면 다음 인스턴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
    [ff_sweep_node.py, henes_firmware.ino, straight_drive_node.py]
2026-08-17 HANDOFF 정정: FF 는 이미 식별·반영돼 있었다 (내 오독)
    오늘 7748714 에서 "구동 FF 미해결, 현재 값 35/60/80" 이라고 적었는데 틀렸다.
    근거로 쓴 현장 로그는 2026-08-15 23:39 자로, FF 를 반영한 6db7e24
    (2026-08-16 22:28) **이전** 데이터였다. 세션 시작 시 6db7e24 가 HEAD 인 걸
    보고도 커밋 메시지를 읽지 않고 로그만 믿었다.
    실제 상태:
    STATIC_FF 35→40.5, VELOCITY_FF_GAIN 60→20.7, MAX_DRIVE_PWM 80→111,
    velocity_kp/ki 30/24→8/4 (ff_sweep 103샘플, 잔차 4.3 PWM)
    결과 0.198 → 0.257 m/s (+30%)
    남은 문제는 "FF 미식별" 이 아니라 "명령 0.4 대비 64% 잔차" 이고, 다음 수는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
2026-08-17 완주/고장 구분 + 신호등 런치 통합 + 정지지점 검증
    실내에서 장비 없이 가능한 작업들.
    1) /goal_reached 를 실제로 소비한다
    발행만 되고 구독자가 없었다. 경로 끝에서 local_sliding_window 가
    /local_path·/curvature 발행을 멈추면 하류는 '경로 0.5s 끊김'으로만
    인식했다 — 완주인지 GPS 끊김인지 로그로 구분이 안 됐다.
    대회 중 차가 섰을 때 원인 판단이 늦어지는 문제다.
    longitudinal_controller: 완주 래치 후 감속 프로파일로 정지 (🏁)
    local_pure_pursuit: 완주는 INFO, 고장은 WARN 으로 분리 (⚠)
    두 노드 모두 완주 분기를 타임아웃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
2026-08-17 캘리브 전 자율주행 차단 + 스윕 상한을 실사용 범위로
    1) vehicle_cmd_mux 에 헤딩 캘리브 게이트 (require_heading_calib)
    direct_localization 은 yaw_offset=0(IMU 원시 yaw, 방향 의미 없음)으로도
    odom 을 발행한다. 그 위에서 로컬경로·조향이 계산되므로 캘리브 전에
    control:=true 로 띄우면 차가 엉뚱한 방향으로 스스로 출발한다.
    AUTO 만 막고 teleop·E-stop 은 그대로 둔다(캘리브 10m 를 사람이 몰아야 함).
    검증: 캘리브 전 /cmd_vel x=0.0, 캘리브 후 x=0.5.
    2) MAX_OPENLOOP_PWM 140 → 230
    140 은 지면에서 약 0.5 m/s 까지만 측정된다. 그 위를 쓰려면 외삽해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
2026-08-17 현장 체크리스트(TODAY.md) + xterm 없을 때 teleop 경고
    control.launch.py 의 teleop 노드가 prefix='xterm -e' 를 쓰는데 이 PC 에
    xterm 이 없다. teleop:=true 를 주면 조용히 실패해서 현장에서 '왜 키가
    안 먹지'로 헤매게 된다. 런치 시점에 감지해 별도 실행 방법을 안내한다.
    TODAY.md: 완주 우선 순서. 랩을 먼저 확보하고 FF 는 그 뒤에 한다
    (필수 목표를 미검증 펌웨어 변경에 걸지 않는다). 각 단계의 확인 로그와
    차가 안 갈 때의 원인 판별표를 포함.
2026-08-17 헤딩 캘리브 오거부 수정 + serial_bridge 자동 재연결
    1) 직진성 검증이 멀쩡한 직진을 거부했다
    dev = |최근구간 방향 − 시작점→현재점 현(弦) 방향| 으로 판정하는데,
    출발 직후엔 현이 0.3~0.5m 뿐이라 GPS 노이즈(2cm)와 출발 시 차체
    흔들림만으로 현 방향이 수십 도 튄다. 2026-08-17 현장에서 실제 궤적은
    편차 0~1° 의 완전한 직선이었는데 '최대 편차 77°'로 거부됐다.
    → min_chord_for_dev(기본 2.0m) 이상 자란 뒤부터 평가한다.
    → 거부 메시지에 '몇 m 지점에서' 최악이었는지 함께 찍는다.
    2) serial_bridge 가 시리얼 끊김에서 복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
    [serial_bridge_node.py]
2026-08-17 구동 FF/PID 재설정 — 속도 상한 해제 (0.33 → 약 0.7 m/s)
    첫 실전 트랙 완주 성공 후 속도 개선. 상한만 올려서는 안 되는 이유:
    FF 속도항이 10배 작아(20.7) 부족분을 적분이 전부 메우고 있었고,
    적분 권한이 ki(4)×clamp(25)=100 PWM 이라 FF(52)+I(100)=152 에서 막혔다.
    게다가 적분이 포화돼 있으면 코너에서 감속이 수십 초 지연된다.
    지면 실측 2점(PWM 80→0.198, 111→0.33)으로 역산한 기울기 200~240 을 반영:
    STATIC_FF 40.5 → 35.0
    VELOCITY_FF_GAIN 20.7 → 200.0
    MAX_DRIVE_PWM 111 → 190 (듀티 43% → 75%, 모터는 24V 240W)
    velocity_kp/ki/kd 8/4/0.2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
2026-08-17 MAX_DRIVE_PWM 111 로 복귀 + 전원 문제 문서화
    190 으로 올린 뒤 랩 종반에 아두이노가 꺼졌고, 이후 모터 전류가 흐르는
    순간마다 브라운아웃 리셋이 반복됐다(USB 장치번호 2~3초마다 증가).
    측정:
    무부하 VMIN 4018mV / 모터 부하 시 3483mV (BOD 문턱 약 4.3V)
    차량 배터리 교체 후에도 3987mV — **배터리가 원인이 아니다**
    serial_bridge 는 1개뿐이었으므로 중복 문제도 아니다
    → 아두이노 전원 경로 문제. VIN 미연결(USB 전원만 사용)이 유력.
    실내에서 멀티미터로 5V/VIN/배터리단자를 실측해 확정할 것.
    전원이 해결되기 전까지 MAX_DRIVE_PWM 은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
2026-08-17 부팅 직후 조향 폭주로 인한 브라운아웃 리셋 루프 수정
    어제 저녁 29회 반복된 리셋의 원인을 로그 타이밍으로 규명했다.
    연결 → **정확히 0.32초 뒤** 끊김이 매번 반복됐는데, 이런 규칙성은
    접촉 불량으로 설명되지 않는다.
    원인: watchdog_tripped 가 false 로 시작하고 setup() 이
    last_rx_time=millis() 를 넣는다. 그래서 명령을 한 번도 받지 않았는데도
    부팅 즉시 조향 PID 가 돈다. 목표각은 0(중앙)이므로 바퀴가 중앙에서
    벗어나 있으면 부팅하자마자 조향모터에 최대 PWM 이 걸린다.
    당시 조향 ADC 108 (중앙 424에서 약 15° 이탈) → 전류 급증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
    [henes_firmware.ino, serial_bridge_node.py]
2026-08-17 헤딩 캘리브 자동 직진을 폐루프로 — 우측 쏠림 해결
    자동 직진이 조향 0° 만 주는 개루프라, STEER_CENTER 가 조금만 어긋나도
    차가 한쪽으로 계속 휘고 직진성 검증에서 거부됐다(현장: 우측 쏠림).
    헤딩의 절대값은 아직 모르지만(그걸 구하는 게 이 노드의 목적) 출발 시점
    대비 변화량은 IMU 로 정확히 알 수 있다. 그래서 '출발할 때의 yaw 를 유지'
    하는 폐루프를 걸면 절대 헤딩을 몰라도 곧게 간다.
    straight_drive 가 같은 방식으로 30m 를 ±3° 로 유지한 실적이 있다.
    auto_heading_gain 1.5 도/도
    auto_max_correction 5.0 도 (폭주 방지)
    auto_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
2026-08-18 조향 소프트스타트 — 부팅 슬램으로 인한 리셋 교착 해소
    기록 분석으로 원인을 특정했다. 300초 로그에서:
    0~55.9초 끊김 0회 (모터 정지)
    55.9초 첫 끊김(PWM=29) (모터 구동 시작)
    이후 끊김 41회 (모터를 멈춰도 회복되지 않음)
    부팅 시 조향 목표각은 0(중앙)이다. 바퀴가 중앙에서 크게 벗어나 있으면
    첫 사이클부터 최대 PWM(130)이 걸리고, 그 돌입 전류에 보드가 리셋된다.
    리셋되면 다시 부팅해 또 슬램 — **바퀴가 중앙에 닿기 전에 영원히 리셋을
    반복하는 교착**이 된다. 그래서 모터를 멈춰도 회복되지 않았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
2026-08-18 구동 FF/PID 를 완주 실적 설정으로 되돌림
    출발 0.2초 뒤 정확히 리셋되는 패턴이 반복됐다. 출발 시점 PWM 을 계산하면:
    어제 아침(완주 성공) 어제 저녁 이후(전부 실패)
    FF 42.6 55
    P 0.8 5
    합계 ~43 PWM ~61 PWM
    FF 기울기를 20.7 → 200 으로 '정확하게' 고친 것이 출발 돌입 전류를 40%
    키웠고, 전원 여유가 없는 이 차에서 그게 리셋 문턱을 넘겼다.
    정확도보다 도는 것이 우선이므로 완주 실적이 있는 값으로 되돌린다.
    STATIC_FF / VELOCITY_FF_GAIN 35/200 → 40.5/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
2026-08-18 serial_bridge: DTR 억제로 포트 open 시 아두이노 리셋 방지
    커널 로그(dmesg)로 어제부터의 리셋 원인을 확정했다. 전기적 에러(-71/-110)는
    전혀 없고 깨끗한 USB disconnect→재열거가 재연결 백오프 간격(3.3→4.3→6.3초)으로
    찍혔다. 즉 물리 문제가 아니라, serial_bridge 가 포트를 열 때 DTR 을 토글해
    아두이노를 리셋시키고, 그 리셋을 보고 또 재연결하는 자기유발 루프였다.
    _open_no_reset(): termios 로 HUPCL 을 끄고 dsrdtr=False 로 열어 DTR 토글을
    없앤다. 최초 open 과 재연결 양쪽에 적용. sudo 불필요.
    exclusive(TIOCEXCL)는 제거했다. 아두이노와 u-blox 가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
2026-08-18 헤딩 캘리브 직진성 검증을 GPS 튐값에 강하게
    버스 분리로 아두이노 리셋이 해결되어 차가 자율로 9m 직진했으나,
    막판에 '최대 편차 97°' 로 캘리브가 거부됐다. 실제 pose 궤적은 편차
    1~2° 의 완전한 직선이었다.
    원인: 진행방향을 '직전 GPS 점 ~ 현재 점'(약 0.3m)으로 쟀는데, v=1.5m/s
    로 빠르면 5Hz 샘플 간격이 0.3m 라 GPS 한 점만 튀어도 그 구간 방향이
    90° 넘게 꺾인다. 단일 튐값에 그대로 노출됐다.
    대책: 최근 진행방향을 seg_window_m(기본 1.5m) 구간으로 잰다. 구간이
    길수록 점 하나의 튐이 방향에 주는 영향이 작아진다. track 뒤에서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
2026-08-18 MAX_DRIVE_PWM 150 로 상향 + 랩타이머 추가
    리셋 원인이 USB 버스 충돌(해결됨)이었음이 확정되어 속도 상향 재개.
    전원/FF 문제가 아니었으므로 111 → 150 단계 상향(예상 0.33 → 0.5 m/s,
    랩 9.5 → 6.3분). FF/PID 는 완주한 값 그대로 두고 이 값만 바꿨다.
    다음 단계 190 은 이번이 깨끗하면 진행.
    tools/lap_timer.py: 모드 AUTO 출발 → 완주 신호 사이를 자동 측정.
    시간·거리·평균/최고속도를 요약 출력.
2026-08-18 목표속도 5km/h — MAX_DRIVE_PWM 210 + bringup max_speed 전달 + 코너 감속 강화
    반 바퀴 실측(PWM 150 → 0.74 m/s)으로 슬로프를 갱신, 5km/h(1.39 m/s)에
    필요한 PWM ≈ 210 을 확정. 111→0.33, 150→0.74 두 점 회귀 결과.
    세 가지를 함께 바꿔야 실제로 5km/h 가 나온다:
    1. MAX_DRIVE_PWM 150 → 210 (펌웨어 PWM 천장)
    2. bringup 이 max_speed 를 제어 체인에 전달 (예전엔 arduino_port 만 넘겨
    v_max·먹스 상한이 항상 1.0 에 걸렸다 — 이게 5km/h 를 막던 숨은 벽)
    3. bringup 에 max_speed 인자 선언 (기본 1.0, 명령으로 상향)
    무게중심 대응(배터리 뱅크·기둥):
    curvature_gain 6.0 → 9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
2026-08-18 MAX_DRIVE_PWM 255 (절대 최대) — 8km/h 시도
    실측 슬로프상 PWM 255 최대속도는 약 1.84 m/s(6.6km/h)로 추정되어
    8km/h(2.22 m/s)는 드라이브트레인 물리 한계에 부딪힐 수 있다.
    그래도 낼 수 있는 최고속도를 뽑기 위해 PWM 상한을 절대 최대로 둔다.
    실제 도달속도는 lap_timer 로 측정해 확정할 것.
    코너 안전(무게중심 대응)은 유지: curvature_gain 9.0 으로 급코너(R2.68m)는
    1.8km/h 로 감속(횡가속 0.10 m/s²), 제동거리 1.3m < 예측 10m.
    실행: ros2 launch ... control:=true auto_calib:=true max_speed:=2.2
2026-08-18 무거운 하중 고려한 속도 튜닝 — 코너 감속 6.0, 가속 0.8
    배터리뱅크+노트북+철근기둥으로 하중이 크다는 정보 반영.
    curvature_gain 9.0 → 6.0:
    9.0 은 코너를 과하게 줄여 랩타임 2분40초. 6.0 은 2분21초로 빠르면서도
    급코너(R2.68m) 0.56 m/s → 횡가속 0.12 m/s². 철근기둥으로 무게중심이
    높아도 기울기 문턱(약 5.9 m/s²)의 1/50 이라 안전.
    tracking_sim: v_max 1.2~1.8 전 구간 완주·조향포화 0%. 조향바이어스 2°+
    출발 1.5m 이탈+헤딩 20° 어긋남에도 완주(최대오차 0.24m).
    ACCEL_LIMIT 1.2 → 0.8:
    무거운 하중에서 급가속(1.2)은 출발 전류가 크게 튄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
2026-08-18 공중 최고속 측정 도구 (topspeed_test)
    PWM 을 단계적으로 올리며 각 단계 정상상태 속도를 기록해 물리적 최고속을
    확인한다. 개루프(PWM:)라 순수 모터 특성이 나온다.
    용도: "목표 속도가 물리적으로 가능한가" 판별.
    · 공중 무부하는 지상보다 높게 나오지만, 그게 드라이브트레인 상한이다.
    · 지상은 이보다 낮을 뿐 절대 넘지 못한다.
    · FF 식별에는 쓰지 말 것(지상 곡선이 필요 — ff_sweep 을 지면에서).
2026-08-18 직선 목표 10km/h — max_speed 기본 2.8, 코너감속 8.0, 포트 재시도
    공중 최고속 측정으로 판단 뒤집힘: PWM 60 에 이미 10.4 km/h, PWM 180 에
    18.6 km/h(포화). 모터는 10 km/h 충분히 낼 수 있고 앞선 '물리 최대 6.6km/h'
    추정은 틀렸다(지상 저항이 지배적이었을 뿐).
    변경:
    bringup max_speed 기본값 1.0 → 2.8 (직선 10 km/h 목표). 인자 없이도
    빠르게 달린다. 실제 도달속도는 지상 하중·마찰이 결정 — lap_timer 로 측정.
    curvature_gain 6.0 → 8.0: 직선 10km/h 면 코너 진입이 빨라 gain 6 은
    급코너 횡가속 0.28 m/s². gain 8 이면 0.18 m/s²(철근기둥 무게중심에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
2026-08-19 무거운 하중용 FF 대폭 상향 — 목표속도까지 실제로 밀어붙이게
    문제: max_speed 2.8(10km/h) 을 줘도 실제는 ~2km/h. 목표속도에 전혀 도달
    못 함. 원인은 FF 가 하중에 비해 너무 낮았던 것 —
    기존 40.5 + 20.7*2.8 = 98 PWM 만 출력. 무거운 차(배터리뱅크+노트북+
    철근기둥)가 2.8m/s 내려면 ~250 PWM 필요한데 한참 모자람. 적분클램프
    ±25 로도 못 메워 PWM 이 ~200 에서 막히고 실제속도 2km/h.
    변경(펌웨어):
    STATIC_FF 40.5 → 80, VELOCITY_FF_GAIN 20.7 → 95
    지상 실측(PWM 111→0.33, 150→0.74)의 역관계 PWM=80+95*v 를 FF 로.
    2.0 m/s 부터 FF 만으로 상한 255 포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
2026-08-19 소나 오작동 수정 — 빈 트랙에서 상시 장애물 감속(랩 10분의 주범)
    증상: 같은 차로 남들이 4분에 도는 트랙을 우리는 10분+. 평균 1.1 km/h.
    원인: serial_bridge 가 소나 '미검출(장애물 없음)'을 sonar_max(2.0m)로
    발행했는데, longitudinal 의 obstacle_trigger 가 4.0m 라 2.0 < 4.0 이 항상
    참 → 빈 트랙인데도 장애물 감속이 상시 ON.
    v_obs = v_slow(0.8) * (2.0-0.8)/(4.0-0.8) = 0.30 m/s = 1.08 km/h
    전 구간이 0.3 m/s 로 묶여 190m 를 10.6분에 기었다(관측 10분과 일치).
    FF 도 최고속 한계도 아니었고, 이 한 줄이 주범이었다.
    수정: 미검출(d<=0.01)을 sonar_max 가 아니라 CLEAR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
    [serial_bridge_node.py]
2026-08-19 구동 스톨가드 오작동 수정 — FF 상향이 유발한 '출발 불능' 위험 제거
    FF 를 80/95 로 올린 뒤 생긴 상호작용 버그:
    출발 즉시 FF 가 80+ PWM 을 내보내 DRIVE_STALL_PWM(55)을 넘는데, 무거운
    차가 정지마찰을 이기고 0.05 m/s 에 도달하기까지 300ms 로는 부족 →
    '출발 = 스톨'로 오인해 매 출발마다 모터가 컷됐다.
    게다가 해제 조건이 '목표속도<0.05' 뿐이라, 자율주행이 계속 목표(2.8)를
    주면 한 번 컷되면 영영 안 풀려 차가 멈춘 채 방치된다.
    (기존 FF 20.7 은 출발 시 PWM 이 55 아래라 이 조건에 안 걸렸다 — FF 상향으로
    비로소 드러난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
    [henes_firmware.ino]
2026-08-19 라이다 장애물 회피 통합 (lidar_clustering) — 팀 소스 물림
    받은 lidar_clustering(DBSCAN+헝가리안+FollowGap)을 제어체인에 통합.
    원본은 결과를 matplotlib/로그로만 표시하고 ROS 발행이 없었다.
    라이다 노드(cluster_plot_node) 수정:
    · enable_plot 파라미터(기본 False) — 헤드리스에서 그래프 미생성·자폭 방지
    · 발행 추가: /obstacle_distance(CLEAR→999, AVOID/BLOCKED→front, NO_SCAN→0),
    /lidar/avoid_steer(AVOID→best_angle_deg[+좌/−우, 우리 규약 일치], 그 외 NaN),
    /lidar/mode(진단)
    먹스(vehicle_cmd_mux) 수정:
    · AUTO 중 /lidar/avoid_steer 가 신선·유효(NaN 아님)면 GPS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
2026-08-19 sllidar_ros2(서드파티 드라이버) gitignore
2026-08-19 라이다 발행을 scan_size_changed 조기return 앞으로 — 실차 검증
    실제 RPLidar A1 테스트에서 매 프레임 'LaserScan size changed'(A1은 회전마다
    점 개수가 달라지는 정상 특성). preprocessor 가 이걸로 조기 return 했고
    _publish_decision 이 그 뒤라 회피/정지 토픽이 전혀 안 나갔다(실측 토픽 0개).
    수정:
    · _publish_decision 을 scan_callback 맨 앞(gap_decision 직후)으로 이동.
    follow_gap 은 원본 msg 로 독립 계산되므로 트래커 상태와 무관.
    · scan_size_changed 경고 throttle 5s.
    실차 검증(RPLidar A1, ttyUSB0, 256000, /scan 11Hz): end-to-end 동작.
    근접환경 mode=BLOCKED|STOP, obstacle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
2026-08-19 follow-gap 파라미터 ROS화 + 회피미션 기본값
    대회 회피 미션(2026) 스펙 반영: 이삿짐박스 900×500×600mm, 종방향 2.5m 간격,
    좌우 슬라롬 2케이스. follow-gap 은 반응형이라 슬라롬·2케이스 자동 대응.
    planner 파라미터를 코드 하드코딩 → ROS 파라미터(fg_*)로 빼 실트랙에서 리빌드
    없이 튜닝 가능하게. 미션 기본값:
    fg_track_width 3.0→2.7(대회 도로폭), fg_planning_lookahead 3.0→2.2(2.5m 간격서
    근접장애물 집중), fg_safety_margin 0.20→0.25, fg_obstacle_trigger 3.0 유지.
    기하 검토: 18°타각 최소반경 2.42m, 2.5m 전진 최대횡변위 1.29m — 박스 회피
    (~0.85m)엔 충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
2026-08-19 라이다 회피 현장도구 + 슬라롬 오프라인 검증 — 융합 리스크 발견
    tools/lidar_monitor.py: 실시간 콘솔 모니터(섹터별 최근접 + follow-gap 결정).
    마운트 방향(yaw_offset) 확인·현장 튜닝용.
    tools/lidar_slalom_test.py: 대회 슬라롬(박스 0.9×0.5m,2.5m간격,±교차) 합성
    라이다 폐루프 검증. 실물코스 없이 회피거동 확인.
    ★ 발견: 현재 먹스 '조향 완전 override'는 슬라롬 케이스1 통과하나 케이스2는
    누적 yaw 로 코스 이탈. 반응형 follow-gap 이 경로기준 없어 연속 AVOID 구간서
    복귀 안 됨. 단순 blend/damping 은 반대로 under-avoid(첫 박스 못 피함).
    → G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
    [lidar_monitor.py, lidar_slalom_test.py]
2026-08-19 헤딩 캘리브 대회 강건화 — 순간 튐 관용 + 자동 재시도(후진 없음)
    증상: 자동 직진 캘리브 중 발에 부딪히거나 조향이 잠깐 걸려 살짝 끊기면,
    그 순간 편차 peak 하나로 전체 10m 캘리브가 거부되고, 자동직진은 1회 실패로
    바로 포기(drive_aborted)해 주행 불능. 대회에서 재수없으면 답 없는 상황.
    수정 ① 순간 튐 관용 (peak → 지속편차):
    max_deviation 초과가 dev_sustain_m(기본 1.5m) 이상 '연속'돼야 거부한다.
    발 부딪힘/조향 걸림 같은 순간 튐은 곧 회복되면 시작→끝 직선 헤딩이 여전히
    유효하므로 통과. 진짜 곡선 주행만 지속 편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
2026-08-19 헤딩 캘리브 조기 실패 감지 + 원점 복귀 게이트 — 전방 벽/커브 보호
    문제: 10m 다 가서야 직진성을 판정하니, 9m 지점(벽/커브 코앞)에서 실패하면
    위험하고 되돌리기도 멀다. "9m 가서 실패면 무슨 소용?"
    · 조기 감지(early abort): 지속편차가 dev_sustain_m 초과로 확인되는 즉시
    중단한다(약 3m). 10m 끝까지 안 간다 → 벽에서 멀리서 멈춤.
    · 원점 복귀 게이트: 재시도(자동직진)는 최초 시작점 retry_start_radius(2m)
    안으로 되돌아와야 재출발한다. 실패 지점에서 전진 금지 → 커브/벽 돌진 방지.
    (사람이 차를 시작점으로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
2026-08-19 헤딩 캘리브 '무조건 되게' — 재시도마다 적응형 조향 트림 학습
    "첫 직진 때 한쪽으로 쏠림"은 STEER_CENTER 어긋남. 폐루프 헤딩 유지(±5°)로
    곧게 가지만, 센터가 심하게 틀어지면 보정이 포화돼 또 휠 수 있었다.
    수정: 직진성 실패 시(=지속 곡선), 그 곡률에서 필요한 조향 보정을 _steer_bias 로
    역산해 auto_steer_bias 에 절반씩(0.6) 누적한다. 다음 재시도는 그만큼 미리
    상쇄해 더 곧게 가고, 폐루프 authority 도 |bias| 만큼 늘어(±5°→±13°) 포화를
    피한다. 재시도를 거치며 수렴 → 심한 센터 어긋남도 스스로 잡는다.
    이제 캘리브 강건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
2026-08-19 pure_pursuit 완주 시 크래시 수정 — 로거 심각도 충돌
    증상: 실차 완주 성공 직후 local_pure_pursuit 노드가
    'ValueError: Logger severity cannot be changed between calls' 로 사망.
    원인: stop() 에서 info/warn 을 삼항연산자로 골라 같은 줄에서 호출했다.
    rclpy 의 throttle 로깅은 호출 '위치(파일:줄)'로 상태를 캐싱하는데, 같은
    위치에서 심각도(info↔warn)가 바뀌면 예외를 던진다. 주행 중 warn 정지 로그가
    찍힌 뒤 완주 때 info 로 찍히며 충돌 → 완주 순간 노드 사망(조향 정지).
    수정: 심각도별로 호출 위치(줄)를 분리(if/else 로 각각 호출).
    ★ 이 실차 주행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
2026-08-19 지그재그 억제 — lookahead 확대 + 조향 슬루 완화
    증상: 저속(1.0m/s) 완주 중 차가 좌우로 흔들며 지그재그로 차선 이탈.
    조향이 과보정(헌팅)하고 급하게 꺾다 조향 스톨(steer=1)까지 반복.
    수정(pure_pursuit_params):
    k_ld 0.6→0.8, min_lookahead 1.8→2.3 (v=1.0 에서 lookahead 3.1m).
    lookahead 가 길수록 조향각이 완만해져 진동이 준다.
    max_steer_rate_deg 60→45. 조향 변화를 더 부드럽게 → 오버슈트/스톨 억제.
    ⚠ lookahead 가 길면 급코너(R2.68m)를 약간 안쪽으로 자를 수 있다. 코너를
    못 돌면 되돌린다. 실차 튜닝 항목.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
    [pure_pursuit_params.yaml]
2026-08-19 HIL 맵 주행 시험 — 공중에 띄우고 맵대로 조향/구동 확인
    실내에서 GPS·IMU·트랙 없이, 차를 공중에 띄운 채 '맵을 실제 치수대로 주행'하는지
    검증하는 하드웨어-인-더-루프 시험.
    tools/hil_vehicle.py: 실제 스택의 /cmd_vel 을 받아 자전거 모델로 적분,
    /odometry/filtered 발행(폐루프). /heading/yaw_offset 도 발행해 먹스 게이트를 푼다.
    gps_localization/hil.launch.py: global_path + local_sliding_window + 제어체인
    (pure_pursuit+longitudinal+mux+serial_bridge→아두이노).
    폐루프: 가상차량이 맵을 주행 → local_path/조향/속도 제어 → /cmd_vel →
    ① hil_vehicle(위치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
2026-08-20 WIP: ms2405 보드 교체 — 조향센서 A8 발견 + 인수인계 문서
    ★ 미완결 조향 작업(다음 세션 이어갈 것). HANDOFF_2026-08-20.md 참고.
    발견: 불량 amap 보드가 아두이노 Vcc를 3.5V로 끌어 브라운아웃(그간 전원 문제의
    진짜 원인)이었다. ms2405 v2.0으로 교체해 전압 해결. 그런데 ms2405는 조향
    포텐셔미터를 A8로 보낸다(amap은 A15) — ADC 스캔으로 확인.
    변경(펌웨어, ★진단상태 주의):
    · Steering_Sensor A15 → A8 (ms2405 기준)
    · steer_motor_control MOTOR3_ENA/ENB 스왑(방향반전, A8에서 재검증 필요)
    · STEER_MOTOR_TEST 1 (진단: 조향모터 OFF. 정상주행은 0으로 바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
2026-08-20 조향 살림 — A8 재캘리브(center282) + 모터극성 원복, 실측 검증
    ms2405 교체 후 미완결이던 조향을 실측으로 완성했다. 전부 측정값 기반.
    A8 캘리브 재측정(조향모터 OFF 상태에서 손으로 각 위치 잡고 60샘플):
    · 완전 왼쪽 = 627 (고ADC rail)
    · 완전 오른쪽 = 0 (저ADC rail)
    · 직진(중앙) = 282 ← '얼추 중앙' 220 이 아니라 정밀 직진 자세에서 실측
    옛 A15 값(center424 / 0~949)은 A8 에선 틀리다. 424 는 A8 에서 직진이 아니라
    왼쪽으로 꺾인 위치라, 그대로 뒀으면 0° 명령에 좌로 쏠린 채 주행했을 것이다.
    (플래시 후 직진 자세에서 ANGACT=0.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
2026-08-20 엔코더 무신호 진단 — SPI·펄스 전수 스캔, 소프트웨어 원인 배제
    조향 완성 후 구동모터 확인 단계에서 발견: ENC1 이 정확히 0 고정.
    손으로 굴려도, 모터로 돌려도 안 변한다.
    증상 연쇄(이해가 중요):
    속도가 항상 0 으로 읽힘 → 스톨가드가 '정상 주행'을 스톨로 오인 → 700ms 에 컷.
    개루프 PWM:60 테스트에서 모터는 잘 돌았는데 정확히 700ms 에 PWM 0 이 됐다
    (DRIVE_STALL_MS 700 그대로) — 가드는 설계대로 동작한 것이고 입력이 틀렸던 것.
    ⚠ 그래서 엔코더가 죽은 동안 폐루프(VEL:) 금지. 속도 0 으로 읽히면 PID 가 PWM 을
    255 까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
2026-08-20 엔코더를 인터럽트 4체배 직결 방식으로 전환 (SPI 카운터 폐기)
    배선 대기용 준비 커밋 — 컴파일 검증만 했고 아직 플래시/실측 안 했다.
    사유: ms2405 교체 후 엔코더 무신호. SPI CS 29핀·A/B 펄스 전 핀 전수 스캔이
    모두 무응답이었고(커밋 237d2d3), 엔코더 케이블은 4선(5V/GND/A/B)으로 확인됐다.
    ⇒ amap 에 있던 LS7366R 카운터가 ms2405 엔 없다. 카운터 칩 없이 아두이노가
    직접 세는 방식으로 간다.
    · #include <SPI.h> 제거 (엔코더 외 SPI 사용처 없음)
    · ENC1_ADD/ENC2_ADD(CS 22/23) → ENC1_A/B=D18/D19, ENC2_A/B=D20/D21
    (ATmega2560 외부인터럽트 핀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
2026-08-20 엔코더 아날로그 경로도 배제 — 모든 신호 경로 확인 완료
    adc_scan.ino 로 구동바퀴를 굴리며 A0~A15 를 정지/회전 대조 측정.
    회전에만 반응하는 핀 없음(A0 가 폭 94 로 컸으나 정지 대조군에서도 52 →
    뜬 핀 노이즈). ms2405 가 속도를 아날로그 전압으로 내보내는 것도 아니다.
    이로써 디지털(SPI 카운터·A/B 펄스)·아날로그 **모든 경로가 배제**됐다.
    ms2405 는 엔코더 신호를 아두이노로 중계하지 않는다(조향 3선 포텐셔미터는
    중계하지만 엔코더 4선은 자체 커넥터로 받고 끝).
    ⇒ A/B 를 아두이노 D18/D19 에 직결하는 것 외에 방법이 없다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
2026-08-20 버스 전수 스캔 — UART/I2C 까지 확인, 엔코더 경로 완전 배제 + ms2405 는 RC 보드
    "조향도 A15→A8 로 바뀌었는데 엔코더도 다른 데로 오는 것 아니냐"는 지적을 받고
    SPI/디지털/아날로그 외에 **UART·I2C 까지** 전수 확인했다.
    신규 진단 도구:
    · bus_scan.ino — Serial1/2/3 을 9600~115200 으로 열어 수신 확인 + I2C 주소 스캔
    · uart_bridge.ino — Serial2(115200) 스트림을 USB 로 그대로 중계
    · i2c_probe.ino — I2C 0x3C 를 주기적으로 읽어 변하는 바이트 탐색
    · enc_pulse_scan.ino — 모터핀 2~10 까지 포함하도록 확장(INPUT, 풀업 금지)
    결과:
    · Serial1(D19)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
2026-08-21 NO_ENCODER 모드 — 엔코더 없이도 주행 복구 (완주 가능 상태)
    엔코더 신호가 아두이노에 도달하지 않는 원인을 전기적으로 확정하고,
    그 상태로도 완주가 가능하도록 펌웨어에 우회 모드를 넣었다.
    ■ 원인 확정 (spi_line_probe.ino 신규)
    SPI 라인에 내부풀업을 걸어 읽으면 '칩이 없음'과 '칩은 있는데 죽음'이 갈린다.
    결과: D50 MISO/D51 MOSI/D52 SCK/D53 SS/D22/D23 모두 풀업 20/20 HIGH 로,
    **아무것도 안 물린 기준핀(D30~D33)과 완전히 동일**했다.
    ⇒ SPI 라인에 물린 것이 없다 = amap 에 있던 카운터 IC(LS7366R)가 ms2405 엔 없다.
    '전원만 없는 죽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
2026-08-21 핀맵 전수 검증 — D2/D3 엔코더 제보 기각, 현재 핀맵이 실측으로 확정
    "ms2405 는 D2/D3 가 엔코더, D4/D5 가 종방향"이라는 제보를 두 방향으로 검증했다.
    ① d23_probe (앞 커밋): D2/D3 를 INPUT_PULLUP 으로 두어 아두이노 출력을 완전히 떼고
    정지/회전 대조 → 전이 0. 기준핀과 동일.
    ② motor_id.ino (신규): 전륜(D5/6/7)과 후륜(D2/3/4)을 **따로** 3초씩 구동.
    지금까지는 늘 함께 돌려 구분이 안 됐다.
    결과: **전륜 구간엔 앞바퀴, 후륜 구간엔 뒷바퀴가 번갈아 정상 회전**.
    ⇒ D2/D3/D4 는 실제 후륜 모터 제어 핀이 맞다. 제보 기각.
    이로써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
2026-08-21 ★ 엔코더 부활 — amap 계열 보드로 교체, A15 + SPI 카운터 복귀
    보드를 세 번째(amap 계열)로 교체하니 **엔코더가 살아났다**. 손으로 굴리자
    ENC1 이 0→153 으로 카운트. 이틀간의 무신호가 해결됐다.
    ■ 이 보드 실측 (전부 측정으로 확인)
    · 조향센서 = **A15** (ADC 스캔: 앞바퀴 좌우로 돌리면 A15 만 0~913, 폭 913.
    A8 폭 498·A9 405 는 인접채널 크로스토크). ms2405 계열일 땐 A8 이었다.
    · 엔코더 = **SPI 카운터 CS 22/23**. MDR0 에 0x03/0x01 을 쓰고 그대로 되읽어 확인.
    · VCC 5233~5258mV — ms2405(4708) 보다 오히려 높고 안정적.
    ■ 되돌린 것 (ms2405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
2026-08-21 A15 조향 캘리브 실측 확정 + 극성 검증 — 전 구간 오차 1도 이내
    새 보드(amap 계열, A15)에서 조향을 실측으로 재캘리브하고 극성까지 검증했다.
    옛 amap 값(424 / 0~949 / 21.2)을 그대로 쓰지 않고 이 보드 개체값을 다시 쟀다.
    ■ 실측 (조향모터 OFF 상태, 각 위치 80~100샘플)
    완전 왼쪽 = 936(고rail) / 직진 중앙 = 412 / 완전 오른쪽 = 0(저rail)
    옛 기록(949)과 다르므로 재측정이 옳았다.
    좌반 (936-412)/20° = 26.20, 우반 412/20° = 20.60 counts/도 → 비대칭.
    기존 철학대로 **보수적으로 작은 20.6** 채택(오버스티어 회피).
    ■ 극성 검증 → **스왑 불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
2026-08-21 엔코더 부호·체배 검증 + 속도 폐루프 동작 확인 — 실차 준비 완료
    ■ 부호 검증 (중요)
    손으로 굴렸을 땐 ENC1 이 증가해 '부호 반대'로 보였으나, **모터로 전진 구동
    (개루프 PWM:60)** 하니 ENC1 이 0→-2428 로 **감소**하고 속도가 +3.0m/s 로 올바르게
    계산됐다. ⇒ counts_per_revolution 의 음수 부호가 맞다.
    (손으로 굴린 방향이 실제로는 후진이었다. 손 방향은 착각하기 쉬우므로 부호는 반드시
    모터 구동으로 확인할 것 — 잘못 뒤집었으면 폐루프가 폭주했을 사안이다.
    개루프로 확인한 덕에 안전했다)
    ■ 체배 검증
    5바퀴 손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
2026-08-21 불량 보드 판별 — 보드 분리 시 VCC 3893→5209mV, 보드별 특성표 기록
    HIL 실행 중 serial_bridge 가 VMIN=3893mV 경고를 반복해 조사했다.
    무부하(모터 전부 정지)에서도 3893mV 로 완전히 고정 — 부하성 강하가 아니었다.
    **보드를 분리하니 5209mV 로 복귀(+1316mV).** 201샘플 내내 안정.
    ⇒ 아두이노는 정상이고 **그 보드가 5V 를 끌어내리는 불량**이다.
    예전 amap 불량 보드와 동일 증상(그때도 '빼면 정상'으로 판별했다).
    브라운아웃 문턱 4300mV 아래이므로 그 보드로는 주행 중 리셋된다 — 사용 금지.
    HANDOFF 에 보드별 특성표를 남겼다(교체 때마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
2026-08-21 정정 — VCC 3.9~4.1V 는 이 차의 정상대, 조향은 A15 유지
    앞선 두 판단이 틀렸기에 바로잡는다.
    ■ 정정 1: "VCC 3893mV = 불량 보드" → **틀렸다. 정상이다.**
    펌웨어 MAX_DRIVE_PWM 주석에 남아있듯 **완주하던 시절에도 4018mV** 였다.
    ATmega2560 의 BOD 는 퓨즈 설정값(아두이노 메가는 보통 2.7V)이라 3.9V 에서도
    정상 동작하며, 실제로 텔레메트리·조향·엔코더가 모두 정상이다.
    '보드를 빼면 5209mV' 는 보드가 전류를 안 먹으니 당연한 것이고, 불량의 증거가 아니었다.
    → HANDOFF 의 '불량 보드' 표를 삭제하고 정정 내용으로 교체.
    → board_i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
2026-08-21 HIL 맵주행 완주 성공 — 제어체인 전체 검증 + MAX_DRIVE_PWM 160
    ■ MAX_DRIVE_PWM 255 → 160
    주행 중 전압강하로 멈추는 것을 막기 위해 낮췄다.
    이력: 111 완주 실적 / 190 에서 부하 시 3483mV 까지 떨어져 랩 종반 리셋 → 160 은 그 사이.
    VMIN 을 보며 문제없으면 단계적으로 올릴 것.
    ■ HIL 맵주행 결과 (공중, max_speed 1.0)
    ★ 경로 완주 (남은 거리 0.60m) → 정지 신호 발행
    정지: 🏁 완주 (정상 종료)
    · 약 282초 주행, 맵 전 구간 추종 후 정상 종료(x=-25.6, y=102.6 에서 0.00m/s 정지)
    · **크래시·스톨·리셋 없음** — 중간에 멈추는 일 없이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
2026-08-21 조향 좌우 비대칭 보정 — 방향별 스케일 분리로 좌코너 이탈 해결
    증상: 주행 중 커브에서 차선 밖으로 이탈(직진에서 밟는 것은 별개 원인).
    원인: 조향 스케일을 **단일값 20.6** 으로 쓰고 있었는데 실제는 좌우가 비대칭이다.
    이 보드 실측: 좌rail 936 / center 412 / 우rail 0
    좌반 (936-412)/20° = 26.2 counts/도
    우반 (412-0)/20° = 20.6 counts/도 ← 작은 쪽을 단일값으로 채택했었음
    결과적으로 **좌회전이 명령의 78% 만 꺾였다**(18° 명령 → 실제 약 14°).
    좌코너마다 3~4° 부족하니 밖으로 밀려 차선을 밟는다.
    (과거엔 좌우 최대타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
2026-08-21 경로 스무딩 — 못 도는 급커브 제거(최소R 1.73→2.68m), HIL 완주 재확인
    증상: 커브에서 차선 밖으로 이탈. 조향 좌우 비대칭(b6876a8)을 고쳐도 남는 부분이 있었다.
    원인: **경로 자체에 차가 물리적으로 못 도는 커브가 있었다.**
    최대 타각 18° → 최소 회전반경 2.42m 인데,
    idx355 R=1.73m(필요 24.4°), idx357 R=1.91m(22.4°) + 빠듯한 구간(R<3.5m) 16곳.
    이런 곳은 제어가 아무리 정확해도 반드시 이탈한다.
    리샘플 간격 실험 (0.3m 로 줄이면 나아질까? → 아니다):
    0.3m: 점636 최소R 0.80m 못 돔 25개 <- 원본 345점보다 촘촘 = 없는 정보 생성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
2026-08-21 인수인계 문서 — 2026-08-22 세션 (엔코더 부활 + 커브 이탈 해결)
    HANDOFF_2026-08-22.md 신규. 08-20 문서 상단에는 '최신 아님' 배너를 달아
    다음 세션이 옛 정보(ms2405/A8/엔코더 없음)를 최신본으로 오인하지 않게 했다.
    담은 내용:
    - 지금 당장 할 것: 실차 저속 1바퀴 예행(현 구성이 실차 미검증이므로)
    - 현재 확정 설정: A15 / center412·0~936 / 좌26.2·우20.6 / SPI카운터 CS22,23 /
    NO_ENCODER 0 / MAX_DRIVE_PWM 160 / 경로는 스무딩본(378점, 최소R 2.68m)
    - 오늘 해결한 3가지: 엔코더 부활(보드교체), 조향 좌우 비대칭, 못 도는 급커브
    - 남은 문제: 직진 구간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
2026-08-21 진단 도구 추가 — drive_scan(전륜/후륜 개별 구동하며 전 핀 스캔)
    엔코더 무신호 진단 때 '손으로 굴린 회전만 봤다'는 한계를 없애려고 만든 도구.
    모터로 실제 주행 속도만큼 돌리면서 동시에 전 핀 전이를 스캔한다.
    (결과적으로 이때 아두이노가 USB 에서 떨어져 스캔은 못 마쳤지만, 이후 SPI 라인
    전기 진단으로 카운터 부재가 확정됐다)
2026-09-05 원점 가드 — 웨이포인트가 어느 장소 것인지 스스로 말하게 한다
    로컬좌표는 (UTM − 원점)이라 원점 없이는 해석이 불가능하다. 그런데
    정지점·주차자세는 원점을 저장하고 검증하는데 **주행 경로만 뚫려 있었다.**
    stop_point_recorder origin_x/y 저장 O bringup 이 환산·검증 O
    parking_pose_recorder origin 저장 O parking_node 가 1m 초과 시 거부 O
    waypoint_recorder 원점 없음 X 검증 없음 X <- 여기만
    장소를 옮겨 site_origin.yaml 을 갱신하면 옛 경로 파일이 조용히 149km
    어긋난 채 로드된다. 정지점은 걸러지는데 주행경로는 안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
2026-09-05 미션 시퀀서 — 코스 위 미션을 하나씩 켜고 끄는 상위 상태기계
    미션 노드는 각자 상태기계를 갖고 있었지만 서로를 모른다. 그런데 출구는
    공유한다: /teleop/cmd_vel(주차), /stop_line_distance(횡단보도·신호등·돌발),
    /lidar/avoid_steer(회피). 지금까지는 "이건 이거랑 같이 켜지 말 것" 이라는
    사람이 지키는 규칙으로 막았다. 용인은 미션이 8개다.
    mission_sequencer:
    /odometry/filtered + /global_path -> 코스 진행거리(s) -> /<미션>/arm
    1) 동시 활성 금지 - arm 된 미션이 있으면 다른 건 켜지 않는다
    2) 타임아웃 강제 복귀 - 미션 실패는 감점이지만 1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
2026-09-05 라이다 — 감속과 조향을 분리, S코스 스펙을 규정 원본으로 정정
    1) 감속과 조향은 성격이 정반대인데 arm 하나로 둘 다 껐다. 회귀였다.
    /obstacle_distance 종방향 감속·정지 = 안전 기능 -> 코스 전체 항상
    /lidar/avoid_steer 조향 override = 회피 기동 -> S코스 구간에서만
    감속까지 끄면 코스 어디서든 앞을 막아도 안 선다. 회피 못 하는 것보다
    위험하다. 조향을 항상 켜두면 S코스가 아닌 곳에서 관중·표지물·연석에
    반응해 틀 수 있다 = 이탈 = 탈락.
    -> 파라미터 이름을 require_arm_for_steer 로 바꿔 조향만 게이트한다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
    [lidar_slalom_test.py]
2026-09-05 현장 도구 — preflight, mission_s, split_path, mark_path 외
    현장에서 기록한 데이터가 못 쓰는 것이었다는 사실을 현장을 떠난 뒤 알면
    되돌릴 방법이 없다. 이 프로젝트에서 실제로 넷 다 겪었고, 넷 다 파일만
    보면 미리 알 수 있는 것이었다.
    preflight.py 신규 - 한 번에 검사:
    A 원점 150km 어긋남 (2026-08-17)
    B 경로 원점 스탬프 / 최소회전반경 / 시작 10m run-up 직선성
    (못 도는 커브 2026-08-22, 램프 캘리브 40° 2026-09-02)
    C 정지점 원점 / 경로까지 거리
    D 주차 parking_planner 를 직접 호출 - 판정이 곧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
2026-09-05 펌웨어 — 엔코더 미중계 보드 대응(개루프) + 정지 홀드 제거 + PWM 상향
    이 보드는 엔코더가 안 잡힌다(ENC1=0 고정). 그런데 펌웨어가 폐루프로 돌아
    죽은 피드백으로 구동을 제어했다. 속도가 늘 0 으로 읽혀 PID 가 PWM 을 상한까지
    밀어붙인다(폭주). 정지 홀드 PI 도 죽은 엔코더를 읽어 출발 직후 계속 후진했다.
    - NO_ENCODER 1: PID 를 우회하고 FF 만으로 개루프 주행.
    PWM = 80 + 95*v (지상 실측 역관계). 정지 시 PWM 0.
    - 스톨가드 우회: 속도가 늘 0 이라 잘 달리는 중에도 스톨로 오인한다.
    - 정지 홀드 PI 제거 -> 옛 coast 복귀. 홀드는 target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
2026-09-05 용인 현장 기록 — 2026-09-05
    원점을 용인으로 교체(332200 / 4128600, EPSG:32652). 기존 대구 값에서 바뀌었다.
    config/yongin_2026-09-05/ 에 오늘 기록물을 저장소 안으로 넣는다. 그동안
    /home/han 에만 있어 백업이 안 됐다. README 에 각 파일의 성격과 주의점을 적었다.
    주행용 최종본: wp_yongin_drive_0.5.yaml
    1298점 648.3m, 되꺾임 0개, 못 도는 커브 0개, 최소R 2.71m
    (필요타각 16.2° < 상한 18°)
    1차 기록(걸어서, 664점 702.0m)에는 되꺾임 2개가 있었다:
    s=314.0m (18.97, -44.39) 헤딩 -113.7° -> +41.8°
    s=326.0m (27.84, -42.01) 헤딩 -26.1° -> +153.8°
    전진 주차 후 후진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
2026-09-05 문서 — 경기규정 원본 대조 + 인계 문서 갱신
    HL FMA 2026 경기규정 PDF 를 처음으로 대조했다. 코드와 문서에 적혀 있던
    내용 중 규정에 없거나 어긋나는 것들을 정정했다.
    - S코스 장애물: 이삿짐박스 3개 -> T870 차체 2대, 매 주행마다 랜덤 배치
    - 돌발 급정지: 규정 최소 3초, 회피기동은 미션 성공 불인정(10점),
    3초 정지 후 우회 허용
    - 직각·평행주차: 차고에 넣는 걸로 끝이 아니라 전진으로 진입확인선 통과까지
    - 주차 경계는 라바콘 -> 2D 라이다에 보인다(연석만 있으면 안 보인다)
    - 경사로: 새 노드가 필요 없다. crosswalk_stop_node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
2026-09-05 정리 — LibreOffice 잠금 파일 추적 해제
    git add -A 로 .~lock.*.docx# 가 딸려 들어갔다. 편집 중에만 생기는
    임시 파일이라 추적하면 안 된다.
2026-09-09 런치 인자 타입 강제 — 정수로 주면 노드가 즉사하던 문제
    증상: HIL 주행 중 바퀴가 안 굴렀다. /curvature·/local_path·/steering_cmd·
    /target_speed 는 다 나오는데 /cmd_vel 만 끊겼다.
    원인: `max_steer_deg:=15` 처럼 소수점 없이 주면 launch_ros 가 YAML 로
    INTEGER 로 추론하는데, 노드는 declare_parameter('max_steer_deg', 18.0) 으로
    DOUBLE 을 기대한다 → InvalidParameterTypeException 으로 기동 0.7초 만에
    exit 1. 이 파라미터를 받는 vehicle_cmd_mux 와 serial_bridge 두 노드만
    정확히 죽어서, 명령을 합쳐 아두이노로 보낼 주체가 사라졌다.
    max_speed:=0.5 는 소수점이 있어 DOUBLE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
2026-09-09 문서 — 9/9 인계 (HIL 완주 검증 + 8분 예산 판정)
    용인 웨이포인트 648.3m 전 구간 HIL 완주 성공(1670초, v_max 0.5).
    실측으로 보정한 랩타임 모델(예측 1673초, 오차 0.2%)로 8분 예산을 판정했다:
    현재 PWM 160 은 16.8분으로 2.11배 초과, 물리상한 255 로도 주행만 7.7분.
    curvature_gain 6.0→3.0 을 함께 적용해야 6.8분으로 미션 72초를 남긴다.
    조향 스톨 19회/66초(랩의 4.0%) 원인 규명: STEER_STALL_ERR(15)가
    STEER_DEADBAND(16)보다 작아 판정 여유가 0이다. 제안 상수값과 설계
    불변식(STALL_ERR < RESUME)을 문서에 남겼다. 펌웨어 수정은 미적용.
    preflight 결과 주차자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
2026-09-10 미션 계획 코스 대조 — 대구 계획으로 용인을 달리면 코스 한복판에서 후진주차가 켜졌다
    config/mission_plan.yaml 이 대구(184m) 값 그대로였다. 용인(648m) 웨이포인트로
    주행하면 후진주차 트리거 s_enter=175m 가 코스 한복판에 떨어져, 주행 중간에
    후진 기동이 시작된다 → 이탈 → 탈락. 조용히 일어나고 되돌릴 수 없다.
    mission_sequencer 가 /global_path 를 받는 즉시 계획 파일을 대조한다:
    · course.path_length_m vs 실제 경로 총 길이 (허용 10%)
    · course.waypoints vs 실제로 로드된 웨이포인트 파일명 (bringup 이 전달)
    어긋나면 모든 미션을 건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
2026-09-10 8분 예산 판단도구 + 게인 런치인자 + 조향스톨 펌웨어 + 랩 계측 프로브
    ■ 판단 기준을 바꿨다 — tools/lap_budget.py
    규정 확인: 8분 초과는 1분당 5점 감점이고 **탈락이 아니다**(탈락은 이탈 /
    1분 이상 정지 / DNF / 입력장치). 그러면 "8분을 맞추려면 PWM 255 가 필요하다"가
    아니라 "감점 몇 점과 브라운아웃 탈락 위험을 맞바꾸는가"가 판단 기준이다.
    PWM → v_max=(PWM−80)/95 → 랩타임 → 감점 표를 뽑는다 (미션 121s 가정):
    PWM 160 gain 6.0 (현재) : 18.9분 → 55점
    PWM 160 gain 3.0 : 16.9분 → 45점 ← 소프트웨어만으로 10점
    PWM 2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
2026-09-11 대회속도 HIL 완주 검증 + 전원진단 도구 + preflight 미션계획 검사
    ■ 대회 속도 HIL 완주 (v_max 1.84, gain 3.0, max_steer 15)
    랩 404초(6.73분) · 99% 완주 · cte 최대 0.319m · 조향 포화 0% · 최대타각 11.3°
    시뮬 예측과 비교: 랩 407초(0.7% 오차) / cte 0.313m(2%) / 타각 11.3°(일치).
    → tracking_sim 이 저속(0.5)뿐 아니라 **대회 속도에서도 검증**됐다.
    lap_budget.py 의 예측을 현장 판단에 써도 된다.
    런치 인자 curvature_gain:=3 을 정수로 줘도 Double 3.0 으로 들어가는 것 확인.
    ■ ⚠ 이 랩에서 하드웨어는 루프에 없었다 (배터리 미연결)
    조향 ADC 가 409~416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
2026-09-11 문서 — 9/11 인계 (대회속도 완주 검증 · 완주 가능성 판정 · 남은 5일 계획)
2026-09-11 학교(충주) 시험 경로 복원 — 대구 기록이 같은 파일명으로 덮어쓴 것이었다
    라이다 회피를 실차로 시험할 경로를 찾다가, 학교 트랙 웨이포인트가 워킹트리에
    없다는 것을 확인했다. git 이력 커밋 76d3428(2026-08-15)에 남아 있었다.
    2026-08-17 대구권 시험장 기록이 같은 파일명
    (src/pure_pursuit_pkg/config/waypoints_recorded_resampled_0.5.yaml)으로
    덮어쓰면서 사라졌던 것.
    복원: config/chungju_school/
    wp_school_track_raw.yaml 82점 89.4m (1m 간격 기록 원본)
    wp_school_track_0.5.yaml 179점 89.0m (0.5m 리샘플, 닫힌 루프) ★주행용
    동일성 확인 — 논문 paper/Fig3_t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
2026-09-11 학교 라이다 회피 실측 절차 + 프로브에 회피 계측 추가
    hil_probe 가 /lidar/avoid_steer · /obstacle_distance · /lidar/mode 를 같이 남긴다.
    회피 발동 횟수·지점, 회피 중 이탈량, 회피 조향각 최대, BLOCKED 샘플 수를 요약한다.
    BLOCKED 는 라이다가 길을 막혔다고 보고 차를 세운 것이라 대회에서는 탈락 경로다.
    config/chungju_school/LIDAR_TEST.md — 오늘 실측용 절차.
    · 회피는 s 등록이 필요 없다(조향 override 는 sequencer 인자에만 묶여 있다)
    · 마운트 방향(fg_yaw_offset_deg 기본 180) 확인이 최우선 — 틀리면 장애물 쪽으로 꺾는다
    · 차를 움직이기 전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
    [hil_probe.py]
2026-09-11 라이다 막힘 탈출 — BLOCKED 로 영원히 서 있던 것을 막는다
    BLOCKED 는 '트랙 안에 통과할 갭이 없다'는 뜻이고, 그때 obstacle_distance 로
    front_distance 를 내보내 종방향이 선다. 그런데 **차가 서면 스캔이 안 바뀌므로
    계속 BLOCKED 다.** 탈출구가 없어서 영원히 멈춰 있었다 — 규정상 1분 이상 정지는
    감점이 아니라 **탈락**이다.
    cluster_plot_node 에 blocked_escape_s(기본 3.0s) 추가. 그 시간 이상 막히면
    회피를 포기하고 감속을 풀어(obstacle_distance = clear_distance) GPS 경로로
    빠져나간다. 장애물 접촉은 감점(S코스 10점)이지만 거기 서 있으면 탈락이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
2026-09-12 원점을 충주로 전환 + 장소 전환 도구 — 학교 시험 준비 완료
    웨이포인트만 복원해 두고 원점(config/site_origin.yaml)은 용인 그대로였다.
    그 상태로는 학교 경로가 219km 밖으로 판정돼 global_path_publisher 가 발행을
    거부한다(= 차가 안 움직인다). 실제로 전환했다.
    tools/use_site.sh — 장소별 보관본에서 골라 세운다.
    config/site_origin.chungju.yaml (399848.522, 4092209.171)
    config/site_origin.yongin.yaml (332200.0, 4128600.0)
    bash tools/use_site.sh # 현재 원점 + 목록
    bash tools/use_site.sh yongin # 대회 전에 이걸로
    .bak 하나에 의존하면 두 번 바꿀 때 원본이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
2026-09-12 트랙 위 회피 하네스 — "장애물 3개 놓으면 피하는가" 에 답한다
    tools/avoid_on_track.py — 실제 트랙 기하 위에서 경로추종과 라이다 회피를 같이
    돌린다. 기존 lidar_slalom_test.py 는 직선 위 회피만 봐서, 먹스가 AVOID 동안
    GPS 조향을 통째로 갈아끼우는 상호작용이 안 보였다.
    경로/추종 : local_path_core + pure pursuit (tracking_sim 과 같은 계산)
    종방향 : longitudinal_controller_node.decide_target 의 식 그대로
    (곡률 감속 + 전방 장애물 비례 감속/정지 + 가감속 프로파일)
    회피 : lidar_clustering.follow_gap_planner (실제 플래너)
    합성 라이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
    [avoid_on_track.py]
2026-09-12 막힘 탈출 3초 → 8초 — 돌발 급정지의 '3초 이상 정지' 와 정면으로 겹쳤다
    탈출 시간은 **정당한 정지보다 길고 탈락 문턱보다 훨씬 짧아야** 한다.
    돌발 급정지 규정 최소 3초 정지 (sudden_stop_node dwell 기본 5초)
    경사로 3초 이상 정지
    횡단보도 3초 대기
    ---- 탈락 ---- 60초
    3초로 두면 규정 시간을 채우기 전에 차가 출발해 미션을 스스로 망친다
    (항목 7: 3초 이상 완전정지 실패 = 10점). 8초로 옮겼다.
    부수 효과가 좋다: 시퀀서가 없거나 구간을 벗어나 sudden_stop 이 arm 되지
    않은 상태에서 더미를 만나도, 차가 8초 서 있다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
2026-09-12 회피각 환산 옵션(steer_mode) — 측정해 보니 절반짜리라 기본값은 그대로 둔다
    follow-gap 의 best_angle_deg 는 **갭 방위각**이지 조향각이 아닌데, 먹스가
    그대로 조향각으로 쓴다. 자전거 모델 환산은 δ = atan(2·L·sinα/Ld) 이고
    L=0.785·Ld=2.2 에서 α=13° → δ=9.1°, 즉 **1.43배 과조향**이다.
    cluster_plot_node 에 steer_mode 파라미터 추가:
    'bearing' (기본) — 예전 동작 그대로
    'pursuit' — 퓨어퍼슛 환산
    학교 트랙 장애물 3개로 측정 (tools/avoid_on_track.py --steer-mode):
    간격 8m·오프셋 0.65m : 최대이탈 1.081m → 0.967m, 차선초과 102 → 12샘플
    간격 6m·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
    [avoid_on_track.py]
2026-09-12 회피 겨냥점 옵션(fg_aim) — 둘 다 답이 아니라는 것을 측정으로 확정
    follow-gap 이 갭의 **중앙**을 겨냥하는 것이 과조향의 주원인이라 보고,
    '직진에 가장 가까운 각'(nearest)을 대안으로 넣어 재봤다.
    학교 트랙 · 장애물 3개 (tools/avoid_on_track.py):
    center : 접촉 없음(최소간격 0.11~0.16m) · 차선 1~2.6m **이탈**
    nearest : 차선이탈 0(최대이탈 0.18~0.32m) · 시험한 **전 배치에서 접촉**
    nearest 의 접촉은 여유각을 2→16° 로 키워도, 안전여유를 0.25→0.70m 로 키워도
    없어지지 않았다. 안전여유를 키우면 버블만 커지는 게 아니라
    max_center_y = trac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
    [avoid_on_track.py, lidar_slalom_test.py]
2026-09-12 회피 수정 — 안전버블 버그 + 경로 인지 겨냥. 9배치 중 0개 → 7개 통과
    ■ 안전버블이 '가장 가까운 한 점' 에만 씌워지고 있었다 (버그)
    길이 1.3m 짜리 박스처럼 각도를 넓게 차지하는 장애물은 **나머지 부분이
    보호되지 않는다.** 최근접점 기준 버블(3m 에서 ±12.3°)이 박스 전체를 못 덮어
    갭의 가장자리가 곧 박스 모서리가 됐다. 그래서 가장자리를 겨냥하면 여유가
    0 이 되어 스쳤다. 갭 중앙을 겨냥할 때만 우연히 멀찍이 돌아 접촉을 면했다.
    → 장애물의 **모든 점**에 각자의 거리로 버블을 씌운다(가까울수록 넓게).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
    [avoid_on_track.py, lidar_slalom_test.py]
2026-09-12 라이다 마운트 방향 확정 도구 + 확인용 RViz 설정
    fg_yaw_offset_deg 가 틀리면 **회피가 장애물 쪽으로 꺾는다** — 감점이 아니라
    이탈=탈락이다. 그런데 실내는 어질러져 있어 스캔만 봐서는 어느 쪽이 차 앞인지
    알 수 없다. tools/lidar_orient.py 로 기준물 하나로 확정한다.
    세 가지 방법을 넣었고, 실제로 써 보니 마지막 것만 믿을 만했다:
    --baseline/--check : 빈 상태 대비 '새로 생긴 것'. 주변이 조금만 바뀌어도
    엉뚱한 걸 잡는다(센서 0.25m 옆 178점을 사람으로 오인).
    --moving SEC : 시간에 따라 **가장 많이 움직인 방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
2026-09-12 버그 수정 — 메서드 정의가 __init__ 안에 끼어들어 노드가 반쯤 죽어 있었다
    어제 path_steer_cb / _path_target_deg / _bearing_to_steer 를 추가하면서 이것들을
    __init__ **중간에** 끼워 넣었다. 그래서 그 뒤에 오던 초기화 코드가 전부
    _bearing_to_steer 의 본문이 되어 버렸다:
    · /obstacle_distance · /lidar/avoid_steer · /lidar/mode 퍼블리셔 생성 안 됨
    · /scan 구독 생성 안 됨
    · arm/mute 구독, 시작 로그도 전부 안 됨
    증상이 고약했다 — **프로세스는 멀쩡히 살아 있는데 토픽이 하나도 안 나온다.**
    크래시가 아니라 __init__ 이 조용히 일찍 끝난 것이라 에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
2026-09-12 라이다 두 대 분리 — 앞뒤가 같은 /scan 에 섞이면 회피가 뒤쪽에 반응한다
    이 차에는 RPLidar A1 이 앞뒤로 두 대 달려 있다(둘 다 CP2102).
    sllidar_a1_launch.py 를 두 번 띄우면 기본 토픽이 같아 **둘 다 /scan 에 발행**하고,
    그러면 전방 회피가 뒤쪽 물체에 반응해 조향을 튼다 = 이탈 = 탈락.
    ■ 개체 확정 (2026-09-12 실측)
    전방 CP2102 f072916a7f58c6418f97ba0c944c359f (라이다 S/N B2E1FA86…)
    ← 오늘 마운트 방향을 확정한 개체. 정면 물체가 원본각 180° 로 보인다
    → fg_yaw_offset_deg 180 (기본값). 개체를 바꾸면 다시 잴 것.
    후방 CP2102 3f70bf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
2026-09-12 문서 — 9/12 인계 (라이다 실물 연결 · 회피 수정 · 시뮬로는 안 나오던 결함 2건)
2026-09-12 평행주차 기하 검토 — 단일 S자로는 불가, 끊어 넣기로는 5사이클
    tools/parking_feasibility.py. 규정(항목 8) 평행주차 공간은 **차량규격의 1.5배**
    = 2.10m 인데, 우리 차는 최소회전반경이 전장보다 크다:
    전장 1.40m · 전폭 0.775m · 축거 0.785m · 최대타각 18°
    → R_min = 2.42m = **전장의 1.7배** (승용차는 보통 1.3~1.5배)
    ■ 단일 S자(2원호) — 차체를 직사각형으로 쓸어 검사
    필요 최소 칸 길이 **약 4.0m (전장의 2.9배)**. 규정 2.10m 의 두 배 가까이다.
    횡으로 0.98m 밀려면 원호각 41° 가 필요하고 그때 종방향 2.9m 를 쓴다.
    → **제어를 아무리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
2026-09-12 평행주차 끊어 넣기 플래너 — 규정 2.10m 에 **들어간다** (24스트로크·66초)
    tools/parallel_park_plan.py. 단일 S자로는 4.0m 가 필요해 규정 공간(2.10m)에
    못 들어간다는 것을 앞서 확인했다. 사람처럼 **짧게 여러 번 왕복**하는 궤적을
    만든다. 현재 parking_planner 는 '후진 원호 1개 + 직선'(cusp 2개) 구조라
    이런 다중 왕복을 구조적으로 못 만든다.
    ■ 결과 (칸 2.10m × 깊이 1.10m, 안전여유 0.15m)
    스트로크 24개 · 기어전환 17회 · 전진 6.32m / 후진 6.02m · **약 66초**
    최종 자세 오차 θ +1.4°, 최소여유 0.150m
    여유를 0.05/0.10/0.15m 로 바꿔도 전부 해가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
2026-09-12 평행주차 — 탈출까지 포함. 규정 2.10m 에 진입 66s + 탈출 52s = 약 118초
    규정은 주차로 끝나지 않는다. 항목 6·8 은 '뒷바퀴가 확인선을 접촉하고
    **전진으로 진입확인선을 통과**' 까지를 요구하고, 항목 10 은 '뒷바퀴가
    **종료지점**을 통과' 할 때까지를 지정시간에 넣는다. 탈출도 예산이다.
    (parking_node 의 _load_exit 주석이 이미 같은 지적을 하고 있었다)
    진입 24스트로크 66초 + 탈출 32스트로크 52초 = **약 118초 (2분)**
    주차 미션 예산(expected_s 45~50초)의 2.4배다.
    ■ 탈출 탐색이 처음엔 실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
2026-09-12 급정지 — 라이다 막힘탈출을 '더미가 치워졌다' 로 오독하던 문제
    sudden_stop_node 의 재출발 조건이 `obstacle >= clear_dist(3.0m)` 하나뿐이었다.
    그런데 어제 넣은 라이다 막힘탈출은 8초 뒤 obstacle_distance 를
    clear_distance(999) 로 **푼다**. 그래서:
    t=0 더미 앞 1.0m 정지
    t=5 dwell 끝 → WAIT_CLEAR
    t=8 라이다 탈출 발동 → obstacle_distance = 999
    sudden_stop: 999 >= 3.0 → "전방 확보 — 재출발" ← 더미는 그대로 있다
    lidar_avoid 는 inhibits 로 꺼져 있어 우회도 안 함 → 그대로 들이받음
    규정 항목 7 은 '3초 정지 후 더미를 **치우거나 우회하여**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
2026-09-12 학교 트랙 — 시작선에서 '완주' 로 오판하던 문제 (현장에서 발생)
    현장 로그:
    [local_pure_pursuit] 정지: 🏁 완주 (정상 종료)
    [longitudinal_controller] 🏁 완주 정지 완료
    출발도 하기 전에 완주 판정이 나서 차가 안 움직였다.
    원인은 **트랙의 시작-끝 간격이 4.26m** 인 것이다.
    local_path_core 의 완주 판정: 끝점까지 남은 호길이 <= goal_tolerance(1.0m)
    closest_index 는 prev_idx 가 없는 첫 프레임에 **전역 최근접**을 쓴다.
    → 출발선(-19.35,-5.38) 의 최근접이 idx 172/177(s=86.0m) 로 잡히고
    남은거리가 2.1m 라, 조금만 움직이면 1.0m 아래로 떨어져 완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
2026-09-12 캘리브 점프 가드·재시작 반경을 런치 인자로 노출 (현장에서 막혔다)
    2026-09-12 학교 현장: 헤딩 캘리브가 3.2m 에서 거부됐다.
    ❌ 헤딩 캘리브 무효: 주행 중 측위 점프 0.2m/0.09s = 2.0m/s (상한 2.0m/s)
    그 뒤 차가 시작점에서 8.7m 앞이라 재시작도 거부되고(retry_start_radius 2.0m)
    명령을 아예 안 보내, 차가 '전원 꺼진 듯' 멈춘 채 방치됐다.
    원인: RTK 수렴에 45초가 걸렸고(σ 72cm → 0.5cm) 붙자마자 출발했다.
    갓 수렴한 RTK 는 몇 초간 좌표가 들썩이는데, 0.2m 가 0.09s 간격이면
    2.2 m/s 로 계산돼 점프 가드에 걸린다.
    두 파라미터가 노드에는 있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
2026-09-12 FF 식별 도구 + 캘리브 체인 추적 — 펌웨어 FF 상수가 실제와 13배 어긋난다
    ■ tools/calib_trace.py 로 확정한 것 (2026-09-12 학교 현장)
    캘리브가 8회 연속 실패해서 명령부터 바퀴까지 한 줄에 찍었다:
    t+41.4s 이동 1.46m GPS 0.04m/s │ teleop 0.15 cmd_vel 0.15 PWM 94
    t+43.4s 이동 3.27m GPS 1.16m/s │ teleop 0.15 cmd_vel 0.15 PWM 94
    t+45.4s 이동 6.54m GPS 1.77m/s │ teleop 0.15 cmd_vel 0.15 PWM 94
    t+46.4s 이동 8.52m GPS 1.98m/s │ teleop 0.00 cmd_vel 0.00 PWM 0
    t+50.4s 이동 12.03m GPS 0.15m/s │ (PWM 0 인데 3.5m 더 굴러감)
    · teleop → cmd_vel → PWM 전달은 **완벽하다** (80 + 95×0.15 =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
2026-09-12 FF 식별 — RTK 수렴 게이트 추가 (측정 하나가 통째로 거짓이었다)
    σ=15.6cm 상태로 재니 PWM 30 에서 '1.52m 이동, 정상상태 0.84m/s' 가 나왔는데
    차는 가만히 있었다. **GPS 가 수렴하며 떠다닌 거리**를 이동으로 센 것이다.
    같은 PWM 을 σ=0.0cm 에서 다시 재니 0.00m 였다.
    위치로 속도를 재는 도구는 측위 품질을 먼저 확인해야 한다 —
    heading_init_node 가 같은 이유로 require_rtk 게이트를 갖고 있다.
    · --sigma-max (기본 5cm) 안으로 수렴할 때까지 측정을 시작하지 않는다
    · 단계마다 σ 를 같이 찍고, 측정 중 올라가면 경고한다
    같이 고친 것: 최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
2026-09-12 구동 FF 실측 반영 — 펌웨어 안 굽고 ROS 쪽에서 변환
    펌웨어의 개루프 FF(PWM = 80 + 95·v)가 지면 실측과 4배 어긋나 있었다.
    0.15 m/s 명령이 PWM 94 로 나가 차가 2 m/s 로 달렸고, 그래서 헤딩 캘리브가
    8회 연속 '측위 점프'로 거부됐다. 캘리브 속도를 0.3→0.2→0.15 로 낮춘 건
    방향이 반대였다.
    실측(tools/ff_identify.py, RTK σ<5cm):
    PWM 55 → 0.46 m/s · 65 → 1.11 · 94 → 1.98(calib_trace)
    적합 PWM = 22.6·v + 44.2 (신뢰점 2개 적합 25.7·v+43.2 과 일치)
    - serial_bridge: ff_mode:='ros' 면 VEL: 대신 실측 상수로 만든 PWM: 을 보낸다.
    보드를 다시 굽지 않고 현장에서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
2026-09-12 FF 재적합 — 캘리브 10m 로그가 ff_identify 보다 정확했다
    캘리브가 성공하면서(yaw_offset 81.6°, 최대편차 1°) 그 주행 자체가 속도
    측정이 됐다. '직진 중... N.N/10m' 로그의 1m 구간 9개가 전부 1.00±0.02 m/s:
    명령 0.5 m/s → PWM 56 → 실측 1.00 m/s (정확히 2배 빨랐다)
    ff_identify 의 'PWM 55 → 0.46' 은 틀린 측정이었다. 12초에 3.6m 만 가 놓고
    정상상태를 0.46 으로 뽑았으니 앞뒤가 안 맞는다. 9구간 일관된 1.00 을 믿는다.
    (56, 1.00) + calib_trace (94, 1.98) → PWM = 38.8·v + 17.2
    - ff_static 44.2 → 17.2, ff_gain 22.6 → 38.8
    - ff_min_pwm 55 → 50. 이 선은 '구르는 중'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
2026-09-12 회피가 꺼진 줄 모르고 달리는 사고를 막는다
    2026-09-12 학교 주행에서 차가 의자를 그대로 박았다. 라이다 드라이버는
    정상이었고(/scan_front 전방 720점, 최근접 6.82m) 회피 알고리즘도 멀쩡했다.
    bringup 에 **lidar:=true 를 빼먹은 것**이 전부였다 — 스캔을 받아 판단하는
    cluster_plot_node 가 아예 안 떠서 차 입장에선 장애물이 없었다.
    - bringup: lidar:=false 면 시작할 때 배너로 크게 경고한다. 조용히 넘어가면
    대회장에서 똑같이 반복되고, 그때는 장애물 충돌 감점이다.
    - tools/avoid_monitor.py: 차를 세운 채로 회피 체인을 눈으로 확인한다.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
    [avoid_monitor.py]
2026-09-13 회피 조향각 부족 — 원인은 클램프가 아니라 조준 창 기하였다
    '회피는 하는데 각이 모자라 장애물을 스친다'. 조향 클램프(18°)를 의심했지만
    플래너에 직접 물어보니 원인이 달랐다.
    갭을 겨냥할 수 있는 각도 창은
    atan(max_center_y / planning_lookahead),
    max_center_y = track_width/2 − 차폭/2 − safety_margin
    이고 옛 값(2.7 / 2.2)에서 **±17.9°** 뿐이었다. aim_margin 2° 를 빼면 실제로
    나올 수 있는 최대가 ±16° 다 — 즉 18° 클램프에 닿은 적조차 없었다.
    게다가 정면 장애물이 안전버블로 막는 각은 2.0m 에서 ±25.7° 로 창보다 넓어서
    남는 갭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
2026-09-13 콘 사이로 '통과' 한다 — 가장 넓은 갭만 고르면 문 바깥으로 샌다
    follow-gap 은 원래 max(갭 폭) 으로만 골랐다. 그러면 라바콘·의자 두 개가 만든
    **문**을 지날 때 문 사이(좁음)가 아니라 문 바깥(넓음)으로 돌아 나간다.
    S코스는 콘 사이 통과가 미션이라 그건 실패다.
    prefer_path_gap(기본 true): 가고 싶은 방향을 품은 갭을 먼저 고르고, 그런 갭이
    없을 때만 가장 넓은 갭으로 떨어진다.
    넉넉한 문(중심 2.2m)이 한쪽으로 치우치고 바깥이 더 넓을 때:
    track_width 4.0 · 끄면 +18.0°(문 바깥으로 샘) · 켜면 -8.0°(문 사이 통과)
    track_width 3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
2026-09-13 규정 도면으로 회피 기하 확정 — 연석을 장애물로 잡으면 커브에서 탈락한다
    '미션지에 장애물 간 거리가 있나' → 경기규정 PDF 에는 **없다**:
    "T870 차체(바퀴 없음) 2대를 고정 장애물로 랜덤 배치"
    "중앙선 없이 좌·우측으로 자유 회피 주행"
    "배치는 좌→우 또는 우→좌 랜덤으로 매 주행마다 변동 가능"
    치수는 차량규격 PDF p6 도면에 있다(구 사양, 이삿짐박스 3개 기준):
    도로 폭 2700mm (중앙선 위 1400 + 아래 1300) · 장애물 종방향 간격 2500mm
    장애물이 중앙선 넘어 200mm 돌출 · 차선 폭 100mm · 헤네스 차량 폭 775mm
    → 통과폭 15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
2026-09-13 펌웨어 — 실측 FF 반영 + 정지는 레이트 제한에서 뺀다
    어제 ROS 쪽에 넣은 실측 FF 를 펌웨어에도 맞춘다. 평소 주행은 계속
    ff_mode:=ros(PWM: 명령)를 쓴다 — 현장에서 노면이 바뀌면 보드를 다시 굽지 않고
    고칠 수 있기 때문이고, 여기 값은 ff_mode:=firmware 로 되돌렸을 때의 폴백이다.
    STATIC_FF 80.0 → 17.2 · VELOCITY_FF_GAIN 95.0 → 38.8
    ★ FF 를 펌웨어로 되돌리는 건 정지거리에 **오히려 손해**라 확인해 두었다.
    VEL: 경로는 BRAKE_LIMIT 0.8 m/s² 로 commanded_velocity 를 내리므로
    1.0 m/s → 0 에 1187ms 가 걸린다. PWM: 경로(187ms)보다 느리다.
    ★ OPENLO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
2026-09-13 ff_identify — 공급전압을 남기고 덜컹거린 단계를 적합에서 뺀다
    'FF 는 /drive_pwm_cmd 로 직접 PWM 을 걸어 쟀는데 왜 그 결과를 버렸나' 에 대한
    정리. 같은 PWM 에서 두 측정이 2배 어긋났다:
    ff_identify PWM 55 → 0.46 m/s
    캘리브 10m PWM 56 → 1.00 m/s
    둘 다 GPS 실측이다(캘리브의 진행거리는 heading_init_node 의
    dist = hypot(east, north) 로, 시작점에서의 실제 직선거리다). 즉 '측정이
    틀린' 게 아니라 조건이 달랐거나 한쪽이 대표값을 잘못 뽑은 것이다.
    PWM 55 런은 내부부터 앞뒤가 안 맞았다: 12초에 3.60m(평균 0.30)를 가 놓고
    정상상태 0.46, 최대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
2026-09-13 펌웨어 업로드 — 조향 스톨 + 정지 램프 + FF 폴백
    /dev/ttyACM0 (2341:0042) 에 13716 bytes 업로드·검증 완료.
    굽기 전 플래시를 읽어 arduino/backup/ 에 보관했다(롤백용).
    올라간 변경:
    STEER_DEADBAND 16→24 · STEER_RESUME 24→32
    STEER_STALL_ERR 15→24 · STEER_STALL_MS 250→400
    OPENLOOP_RATE 를 증가 방향에만 적용 (감속은 한 사이클에 0 까지)
    STATIC_FF 80→17.2 · VELOCITY_FF_GAIN 95→38.8 (ff_mode:=firmware 폴백)
    업로드 후 텔레메트리 확인:
    VCC=5115 VMIN=5091 — 무부하라 정상. 어제의 3948mV 는 모터 부하 때였다.
    STEER ADC=131 TGT=412 PWM=0 ANGACT=-13.6 — 바퀴가 우측으로 돌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
2026-09-13 avoid_monitor — 방금 구운 펌웨어까지 한 화면에서 본다
    정지 상태 점검에 조향·스톨·전압을 붙였다. 회피만 보면 '각이 모자란' 원인이
    기하인지 조향 응답인지 구분이 안 된다.
    스캔 · 최근접 · 장애물 · mode · 회피각 · **조향 명령→실제** · PWM · 전압 · 스톨
    - /steering_angle (Float64, 펌웨어 ADC 환산 실제각) 을 먹스 명령각과 나란히
    찍는다. 둘이 벌어지면 각도 문제가 아니라 조향이 못 따라가는 것이다.
    - /vehicle_stall — 2026-09-13 에 구운 조향 스톨 상수(DEADBAND 24 / RESUME 32 /
    STALL_ERR 24 / STALL_MS 400)가 실제로 들었는지 여기서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
    [avoid_monitor.py]
2026-09-13 회피 조향만 따로 끌 수 있게 — 돌발정지는 '서야' 성공이다
    규정 항목 7: 회피기동(정지 없이 피해 주행)으로 수행하면 **미션 실패 10점**.
    그런데 sudden_stop_node 는 HOLD 에서 /stop_line_distance=0 만 내고 회피를
    막지 않는다. 막는 건 미션계획의 inhibits 인데 그건 시퀀서가 있어야 돈다.
    시퀀서 없이 돌발정지만 시험하면 차가 **서면서 동시에 옆으로 핀다**.
    - bringup 에 no_avoid_steer 추가. true 면 라이다 **조향 override 만** 끈다.
    감속·정지(/obstacle_distance)는 안전 기능이라 항상 나간다.
    실제 노드로 검증: 기본 False · no_avoid_steer:=true True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
2026-09-13 문서 — 9/13 인계 (FF 확정 · 회피 기하 · 펌웨어 업로드)
2026-09-13 학교 리허설 배치 — 회피 먼저, 돌발정지 나중. 곡률을 실측으로 고쳤다
    한 런에서 회피와 돌발정지를 둘 다 보려면 s 로 갈라야 한다. 조향 요구가
    정반대이기 때문이다 — 회피는 arm 돼야 피하고, 돌발은 arm 되면 피해 버려서
    미션 실패(10점)다. 그래서 돌발(12~30)·회피(35~55) 순서를 맞바꿨다.
    바꾸면서 트랙 곡률을 실제로 쟀더니 인계문서가 틀려 있었다:
    · 34~42m 는 직선이 아니라 커브 탈출 중(R 7.1 → 38)
    · 55~73m 는 '완만한 커브' 가 아니라 R 7~9m
    55~73 에 돌발정지를 두면 커브 한복판에서 감지·정지하게 되고 라이다 정면
    섹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
2026-09-13 인계문서 — 곡률표 정정, ①②④ 합친 런, max_speed 무력화
    곡률을 실제로 재보니 ③ 표가 틀려 있었다. 34~42 는 직선이 아니라 커브
    탈출 중(R 7.1→38)이고, 55~73 은 '완만한 커브' 가 아니라 R 7~9m 다.
    그 표를 믿고 장애물을 놓으면 회피는 커브에서 경로조향을 뺏고(이탈),
    돌발정지는 커브 한복판에서 감지하게 된다.
    max_speed 가 아무 효과가 없다는 것도 적었다. ff_min_pwm=50 이 모든 속도
    명령을 덮어써서 커브 감속도 장애물 감속 램프도 무력화된다. 캘리브 10m
    소요시간이 그 하한 속도의 유일한 실측 수단이라는 것도 함께 남긴다.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
2026-09-13 캘리브 가드 테스트가 자기 노드를 안 죽여서 멈추고, 남의 값을 읽었다
    증상 두 가지가 같은 뿌리였다.
    ① A 케이스에서 540초를 넘겨 멈췄다. run() 에 45초 타임아웃이 있는데도
    그랬던 이유는 proc.terminate() 가 `ros2 run` **래퍼**만 죽이기 때문이다.
    heading_init_node 는 SIGTERM 을 무시해 살아남고, 그 노드가 stdout
    파이프를 계속 잡아 타임아웃 없는 communicate() 가 영원히 블록됐다.
    내 첫 수정도 불완전했다 — proc.wait() 는 래퍼가 죽은 것만 알려주는데
    그걸 보고 SIGKILL 을 안 보내고 빠져나왔다. 이제 wait() 결과와 무관하게
    **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
    [test_heading_calib_guard.py]
2026-09-13 vcc_watch — bringup 을 끄지 않고 공급전압을 본다
    전원 경로를 만지는 일은 스택을 띄워 둔 채로 한다. 커넥터를 흔들면서
    전압이 어떻게 변하는지 봐야 하기 때문이다. 그런데 vcc_check.py 는
    시리얼 포트를 직접 열어서 serial_bridge 와 같이 못 쓴다. 이 도구는
    /vcc_mv · /vcc_min_mv 토픽을 읽어 같은 판정을 내므로 동시에 쓸 수 있다.
    9/13 21시 학교에서 이 진단이 필요했다. 무부하 VCC 4047mV · 최저 3920mV —
    모터가 안 도는데도 판정선 4300 아래였다. 펌웨어 주석의 이력과 대조하면
    9/3 GND 접점 불량일 때의 VMIN(3920mV)과 같은 값이다.
    Co-Authored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
2026-09-13 라이다 마운트를 바꿨을 때 쓰는 길이 끊겨 있었다
    9/13 밤 학교에서 라이다를 범퍼 위 → 차량 정면으로 옮겼다. 마운트가
    바뀌면 fg_yaw_offset_deg 를 다시 재야 한다(lidar_dual.launch.py 주석에
    이미 경고가 있다). 그런데 재는 길도, 적용하는 길도 둘 다 막혀 있었다.
    ① lidar_orient.py 가 /scan 을 구독하고 있었다. 9/12 에 앞뒤 라이다를
    분리하면서 전방이 /scan_front 로 바뀌었는데 도구는 안 따라갔다.
    그 뒤로 이 도구는 **아무것도 못 받고 조용히 타임아웃만 났다.**
    기본값을 /scan_front 로 바꾸고 --topic 으로 고를 수 있게 했다.
    ② fg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
2026-09-13 lidar_orient — 점 하나가 마운트 방향을 정하고 있었다
    9/13 밤 학교. 라이다를 범퍼 위 → 차량 정면으로 옮기고 방향을 재니
    `원본각 -49.9° · 거리 0.16m · 폭 1점` 이 나왔다. 1~2m 에 놓은 물체가
    아니라 라이다 바로 옆 16cm 의 잡음 점 하나였다. 마운트를 앞으로 옮긴
    뒤라 차체가 스캔에 들어오고 있었던 것이다.
    원인은 선택 방식이었다:
    closest = idx[np.argmin(cur[idx])]
    '가장 가까운 점' 을 골랐다. 크기를 안 보니 0.16m 점 하나가 1.7m 의
    54점짜리 진짜 물체를 이긴다. fg_yaw_offset_deg 는 틀리면 회피가
    장애물 쪽으로 꺾는 값이다 — 점 하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
2026-09-13 lidar_orient --body — 차체 가려짐으로 마운트 방향을 잰다
    9/13 밤 학교에서 --check 는 +119.1°, --moving 은 -149.7° 를 내놨다.
    20° 넘게 어긋났고 둘 다 틀렸다. 라이다를 차량 정면에 달면서 **차체가
    라이다 뒤 120° 를 가리는데**, 두 방법 모두 그 가려짐의 **가장자리**를
    집었다. 경계에서는 사람이 조금만 움직여도 거리가 크게 튀어서 '변화량'
    을 보는 두 방법이 나란히 속는다.
    차체 가려짐 자체는 차에 고정된 강체다. 그 중심이 '뒤' 이고 반대가
    정면이다. 주변이 바뀌어도 안 움직인다 — 벽 앞과 열린 곳에서 각각
    +10.0° 와 +7.05° 로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
2026-09-13 preflight 에 공급전압 검사 — 오늘 같은 하루를 5초로 줄인다
    9/13 학교에서 차가 안 움직였다. 명령·경로·라이다·PWM 상수가 전부 맞았고
    (git 으로 확인했다) 다른 건 전압 하나였다. 전날 무부하 5115mV 가 그날
    4030mV 였다.
    PWM 은 전압이 아니라 비율이다. `PWM 50` 은 걸 수 있는 전압의 50/255 를
    걸라는 뜻이고 얼마가 걸릴지는 전원이 정한다. 1V 가 빠지자 같은 PWM 이
    정지마찰을 못 넘었고, 모터가 잠긴 채 전류만 빨아 VMIN 이 2938mV 까지
    무너졌다. 로그에는 'PWM 50 이 나가는데 좌표가 1cm 도 안 변함' 으로
    남았다. 원인을 찾는 데 세 시간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
2026-09-13 저전압에서도 달려야 할 때 — 막지 말고 보정값을 주자
    preflight 가 4300mV 아래를 '치명' 으로만 찍고 끝냈다. 그런데 현장에서는
    전원을 못 고친 채로도 달려야 한다. 막기만 하면 preflight 를 무시하게 되고,
    그러면 다른 검사까지 같이 죽는다.
    --allow-low-voltage 를 주면 경고로 낮추고, 그 전압에서 **무엇을 올려야
    굴러가는지** 계산해준다.
    PWM 은 전압이 아니라 비율이다. 9/13 학교 4030mV 실측:
    ff_min_pwm 50 → 정지마찰을 못 넘음. 좌표 1cm 도 안 변하고 VMIN 2938mV
    ff_min_pwm 60 → 굴렀다. 출발 8.0초, 그 뒤 1.07 m/s
    역설적이지만 PWM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
2026-09-13 drive_school.sh — 전압을 재서 하한 PWM 을 스스로 맞춘다
    9/13 학교에서 하루를 잃었다. 명령·경로·라이다·PWM 상수가 전부 맞았는데
    공급전압만 전날보다 1V 낮았고, PWM 은 전압이 아니라 비율이라 같은 값이
    전날엔 굴리고 그날엔 모터를 잠갔다(VMIN 2938mV, 좌표 1cm 도 안 변함).
    사람이 매번 전압 재고 배수 계산해서 인자를 붙이면 또 빠뜨린다.
    · 장치(아두이노·라이다·IMU·GPS)를 먼저 확인하고 없으면 안 띄운다
    · 전압을 읽어 ff_min_pwm 과 auto_calib_speed 를 자동으로 정한다
    · **전압이 정상(≥4700mV)이면 기본값 50/0.5 를 그대로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
2026-09-13 drive_school --no-avoid, 그리고 set -u 가 스크립트를 조용히 죽이던 것
    ★ --no-avoid
    9/13 학교에서 차가 가드레일을 박고 경로를 못 따라갔다. 로그를 보니
    라이다가 Width=7.89m 짜리 물체(가드레일)를 잡아 AVOID 가 계속 떴고,
    회피가 뜨면 먹스가 **경로조향을 통째로 버린다**(§2-5). best_angle 이
    −18° 풀락까지 갔다. 차는 경로가 아니라 회피각을 따라간 것이다.
    라이다를 범퍼 위 → 차량 정면으로 옮기면서 스캔 평면이 낮아진 것이
    원인으로 보인다. 위에 있을 땐 가드레일 위를 지나갔다. track_width 2.4 는
    연석(±1.35m)을 창 밖으로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
2026-09-13 점프 게이트가 도착 시각을 쓰고 있었다 — 정상 주행이 거부됐다
    ❌ 헤딩 캘리브 무효: 주행 중 측위 점프 0.1m/0.01s = 5.9m/s (상한 2.0)
    0.01초는 GPS 측정 간격이 아니다(이 수신기는 5~10Hz). 게이트가
    get_clock().now() — 즉 **fix 가 도착한 시각**을 분모로 썼다. 실행기 지연으로
    메시지가 몰려 도착하면 도착 간격만 10ms 가 되고, 실제 200ms 동안 간
    0.1m(=0.5m/s, 지극히 정상)가 20배로 부풀려진다. 가드가 `dt > 1e-3` 뿐이라
    전혀 못 걸렀다.
    ① 측정 시각(header.stamp)이 있으면 그걸 쓴다. 속도의 분모는 '언제
    측정됐나' 지 '언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
    [tracking_sim.py]
2026-09-13 tracking_sim 새 인자가 lap_budget 을 깨뜨렸다 — getattr 로 고침
    --heading-bias 를 추가하면서 simulate() 안에서 args.heading_bias 를 직접
    읽었다. 그런데 lap_budget.py 는 **자체 Namespace 를 만들어** simulate() 를
    부른다. 그 Namespace 에는 새 인자가 없어서 전부 AttributeError 로 죽었다.
    AttributeError: 'Namespace' object has no attribute 'heading_bias'
    시뮬 인자를 추가할 때는 기본값을 갖는 getattr 로 읽을 것. 주석으로 남긴다.
2026-09-13 후진주차 기하 테스트가 임포트 단계에서 죽어 있었다
    ImportError: cannot import name 'pursuit_steer' from
    'mission_perception.parking_node'
    pursuit_steer/split_segments 가 parking_follower 로 옮겨졌는데 이 테스트만
    안 따라갔다. 죽은 테스트는 통과도 실패도 아니라 **검증 없음**이다. 그동안
    후진 조향 부호를 아무도 지키지 않고 있었다(test_parking_plan 은 이미
    parking_follower 를 보고 있어서 살아 있었다).
    고친 뒤 실행: 3/3 통과. 후진 조향 부호는 전진과 같다(+1)가 재확인됐다.
2026-09-13 정지마찰 하한 — fe22bc7 가 "따로 둔다" 고 쓰고 안 만든 것
    오늘 차가 출발을 못 한 진짜 원인이다. 전압이 아니었다.
    fe22bc7 커밋 메시지:
    "ff_min_pwm 55 → 50. 이 선은 '구르는 중' 을 맞춘 것이라 출발 순간에는
    모자랄 수 있어 **정지마찰용 하한을 따로 둔다**(PWM 45 는 안 굴렀다)."
    그 '따로 둔' 하한이 코드에 없다. 약속만 남고 구현이 빠진 채, 유일한
    하한이 55 → 50 으로 내려갔다.
    어제 주행(b1c6fb5): ff 22.6·v+44.2 → 명령 0.5 → PWM **56** → 굴렀다
    오늘 (fe22bc7) : ff 38.8·v+17.2 → 명령 0.5 → 36.6 → 하한 **50** → 안 굴렀다
    실측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
2026-09-13 breakaway_check — 정지마찰 하한이 실제로 나가는지 본다
    고쳤다고 말하는 것과 PWM 이 실제로 나가는 것은 다르다. 바퀴를 들고
    2분 만에 확인한다. 기대 파형은 0 → 60(600ms) → 50 → 0 이다.
    바퀴를 들면 정지마찰 자체는 못 보지만 '명령 경로가 살아 있는가' 는
    확인된다. 지면 시험은 밖에서.
2026-09-13 breakaway 600 → 1200ms — 펌웨어 램프가 앞의 390ms 를 먹는다
    breakaway_check 실측 파형(바퀴 들고, 9/13):
    0.35s 명령 0.5 나감 PWM 0
    0.39s PWM 3
    0.64s PWM 48
    0.74s PWM 60 ← 도달까지 **390ms**
    1.00s PWM 50 ← breakaway 종료
    펌웨어 OPENLOOP_RATE 가 증가 방향으로 3/10ms 제한을 건다. 그래서 600ms
    창에서 실제로 60 이 나가는 건 260ms 뿐이고, 앞의 390ms 동안 모터는
    정지마찰 문턱(55~56) 아래에서 **잠긴 채 전류만 빤다.** 전원을 지키려고
    만든 램프가 오히려 스톨을 길게 만든다.
    1200ms 로 하면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
2026-09-13 drive_school --min-pwm — 크리프 하한을 직접 지정
    breakaway(출발용)와 ff_min_pwm(구르는 중)은 다른 값이다. 후자가 50 으로
    충분한지는 아직 실측이 없다 — 출발은 뚫었는데 1.2초 뒤 다시 설 수 있다.
    PWM 55 는 9/12 캘리브에서 1.00 m/s 로 구른 실측이 있으므로, 확실히 굴려야
    할 때 전압 보정을 무시하고 지정한다.
2026-09-13 breakaway_check — 움직였는지를 IMU 로 판정한다 (복도에서도 된다)
    '차가 정지마찰을 뚫는가' 는 구동계 문제라 GPS 가 필요 없다. 캘리브와
    경로추종은 RTK 가 있어야 하지만 이건 실내에서도 답이 나온다 — 오늘 안에
    결론을 내야 하는데 밖에 못 나가는 상황을 위해서다.
    엔코더가 없고 실내엔 GPS 도 없으니 '움직였나' 를 눈으로 판단하게 된다.
    그건 애매하다. 대신 IMU 가속도로 잰다: 정지 구간의 축별 평균을 기준으로
    잡고 굴리는 구간의 최대 편차를 본다. 중력이 어느 축에 실리는지 모르므로
    축을 고르지 않고 세 축 편차의 크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
2026-09-13 breakaway_check — 텔레메트리를 기다리지 않아 시험을 날렸다
    실측 트레이스:
    0.37s 명령 0.5 나감 PWM - ← 텔레메트리 자체가 안 옴
    1.60s PWM 0 ← 1.6초 만에 첫 수신
    1.80s PWM 24 ← 램프 오르는 중
    1.84s 명령 0.0 PWM 33 ← 명령이 이미 끝났다
    serial_bridge 가 아두이노에 붙는 데 1.6초가 걸렸는데 그 전에 명령을
    내보냈다. PWM 이 램프를 다 오르기도 전에 시험이 끝나서 'breakaway 가
    안 나갔다(최대 24)' 로 보였지만, 실제로는 **볼 기회가 없었다.**
    · /drive_pwm 이 올 때까지 최대 15초 기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
2026-09-13 drive_school 이 라이다 드라이버를 안 띄웠다 + RTK 메시지가 자기모순이었다
    ★ 라이다
    bringup 의 lidar:=true 는 판단 노드(cluster_plot_node)만 띄운다.
    드라이버(sllidar)는 lidar_dual.launch.py 가 따로 띄워야 하는데 스크립트가
    장치 파일만 확인하고 넘어갔다. 현장에서:
    ❌ 스캔이 한 번도 안 왔다 — 구독 토픽: /scan_front
    9/12 에는 lidar:=false 로 띄워 의자를 박았다. 같은 종류의 실수가 두 번
    났으니 사람이 기억하게 두지 않는다 — 스크립트가 직접 띄운다.
    ★ RTK 메시지
    RTK 수렴 대기 중 (수평 σ=0.0cm > 5cm)
    0.0 은 5 보다 크지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
2026-09-13 fg_min_range 노출 — 차체가 시야에 들어와 영구 BLOCKED 였다
    라이다를 범퍼 위 → 차량 정면으로 옮긴 뒤 차체(또는 마운트) 일부가 매
    프레임 같은 자리에 잡혔다:
    ID=58 X=0.31m Y=-0.20m Width=0.02m Depth=0.01m Distance=0.37m
    FollowGap: mode=BLOCKED, direction=STOP, front=0.37m
    막힘 탈출 중 — 전방 감속 없음 (24s)
    폭 2cm 짜리가 항상 front=0.37m 를 만들어 follow-gap 이 **영구 BLOCKED**
    가 됐다. 갭이 없으니 회피각도 0 이다. 차는 서고, 8초 뒤 막힘탈출이
    감속을 풀고, 그대로 박는다. 9/13 밤에 실제로 박았다.
    fg_min_range 가 노드 파라미터로만 있고 런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
2026-09-13 vcc_watch 가 Ctrl-C 에서 역추적을 뱉었다
    rclpy 가 이미 내려간 뒤 shutdown() 을 또 불러 RuntimeError 가 났다.
    감시 도구가 종료하면서 역추적을 뱉으면 '또 뭐가 깨졌나' 로 읽힌다.
2026-09-13 lidar_orient — 스캔이 안 오면 무엇을 하라는지 말해준다
    '드라이버 확인' 만으로는 현장에서 뭘 쳐야 하는지 모른다. 띄우는 명령과
    USB 재삽입까지 적어둔다(9/13 밤에 둘 다 필요했다).
2026-09-13 drive_school — 중복 실행을 막는다
    이전 스택을 안 끄고 새로 띄우면 모든 노드가 두 개씩 돈다. 9/13 밤에
    한 시간을 여기에 썼다. 증상이 전부 다른 얼굴로 나타나 원인을 못 봤다:
    · serial_bridge 2개가 /dev/arduino 경합
    → '시리얼 전송 실패: port that is not open' → 재연결 반복
    · NTRIP 은 계정당 1세션이라 두 번째가 401 Unauthorized
    → RTCM 0프레임 → RTK 안 붙음
    · hfi_a9_ros2 2개가 /dev/imu 경합 → IMU 무발행
    → /odometry/filtered → /curvature 끊김 → 차가 선다
    · vehicle_cmd_mux 2개가 서로 덮어써 먹스 모드가 깜빡임
    하나라도 남아 있으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
2026-09-13 반복 성공을 막던 두 가지 — IMU 자동재연결, 장치 데이터 확인
    9/13 밤 학교. 주행마다 다른 장치가 끊겨 매번 다른 데서 끝났다. 한 번의
    성공이 아니라 **반복 성공**이 필요한데, 끊김이 곧 주행 종료였다.
    ★ IMU 노드가 끊기면 그대로 죽었다
    주행 중 IMU 가 끊기면 direct_localization 이 위치 발행을 멈추고,
    로컬경로가 사라져 차가 그 자리에 선다. 대회에서 1분 정지는 탈락이다.
    원래 코드의 결함 둘:
    ① `except: exit(1)` — 읽기 오류 한 번에 노드가 죽는다
    ② **파이프가 멈추면 예외가 안 난다.** CP210x 가 urb stopped: -32 로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
2026-09-13 장치 확인 가드가 멀쩡한 장치를 두 번 막았다
    ★ 보드레이트를 안 맞췄다
    tty 는 새로 열거되면 기본 9600 인데 IMU 는 921600 이다. 안 맞추면 프레이밍
    에러로 전부 버려져 **멀쩡한 장치가 0바이트로 보인다.** 갓 재열거된 정상
    IMU 를 '죽었다' 고 막았다. stty 로 먼저 맞춘다.
    ★ 라이다를 같은 방식으로 검사했다
    sllidar 는 드라이버가 스캔 시작 명령을 보내야 응답하는 **요청/응답** 장치라
    가만히 있으면 0바이트가 정상이다. 그걸 '죽었다' 로 읽으면 멀쩡한 라이다를
    막는다. 검사에서 빼고, 드라이버를 띄운 뒤 /scan_front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
2026-09-14 주행 기록·지도화 도구 — '의자 사이로 안 간다' 를 눈으로 본다
    회피가 되긴 하는데 문 사이로 안 가는 것을 로그 텍스트로 판정하려니
    한계가 있었다. cluster_plot_node 가 찍는 좌표는 차량 기준이고 프레임마다
    튀어서, 의자가 실제로 어디 있었고 차가 어디로 갔는지를 못 본다.
    drive_record.py — 주행 중 CSV 로 쌓는다
    · 궤적(지도 좌표) · 속도 · mode · 회피각 · 조향 명령/실제 · 전압
    · **라이다 점을 지도 좌표로 변환**해 따로 쌓는다. 차량 기준으로 두면
    같은 물체가 프레임마다 다른 자리에 찍혀 아무것도 안 보인다. 지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
2026-09-14 라이다가 안 도는 이유 — 토픽 목록으로 발행 여부를 판정했다
    Publisher count: 0
    Subscription count: 1
    `ros2 topic list` 는 **구독자만 있어도** 토픽을 보여준다. 이전 스택의
    cluster_plot_node 가 /scan_front 를 구독한 채 남아 있으면 목록에 뜨고,
    스크립트가 '이미 발행 중' 으로 오판해 드라이버를 안 띄웠다. 그러면 스캔이
    영원히 안 온다. 발행자 수로 판정하도록 고쳤다.
    ★ check_build.py 도 추가
    이 워크스페이스는 패키지마다 설치 방식이 다르다. 어떤 것은 소스를 바로
    물고(egg-link) 어떤 것은 빌드 때 복사된다. 후자는 colcon build 없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
2026-09-15 회피 기하 시험 — 불변식 두 개를 못 박는다 (가설 하나는 기각)
    "차가 문 사이 대신 바깥으로 돈다" 를 조사했다. 처음엔 prefer_path_gap 의
    '품었는가' 판정이 원인이라고 보고 거리 기반 선택으로 고쳤다. 근거도 있었다
    — 2.0m 문이 3m 앞이면 갭이 ±6.15°, aim_margin 2° 를 빼면 목표가 ±4.15° 안에
    들어와야 하는데, 경로오차 0.25m 만으로 순수추종 조향이 ~10° 가 된다.
    **그런데 시험해 보니 옛 코드도 문을 고른다.** 구조를 따져보니 이유가 있었다:
    트랙 반폭 1.2m · 의자(폭0.45) 바깥끝 0.92~1.33m · 안전반경 0.6375m
    → 문 바깥에 갭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
2026-09-15 능동 제동 — 기본 꺼짐, 안전장치 셋, 하드웨어 없이 검증
    `PWM 0` 은 '동력 끊기' 지 '멈추기' 가 아니다. 그 뒤는 관성이다. 9/15 실측:
    장애물 1.77m v=1.42 → 0.30m v=0.85 제동거리 1.96m / 2.5초
    더미 30cm 앞에서도 0.85m/s 로 굴러가고 있었다. 조금만 달라도 박는다.
    실측 가속능력(상위10%) 0.87m/s² · 관성감속 0.56m/s² 기준, 역토크를 걸면
    1.15m/s 에서 제동거리 1.18m → 0.4~0.55m 로 준다.
    ★ 펌웨어는 건드리지 않았다
    방향전환을 0 경유로 막고 역토크를 3/10ms 로 올리는 가드가 있어, 제동이
    200~400ms 에 걸쳐 붙는다. 그만큼 효과가 깎이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
2026-09-15 drive_school --extra — 임의 런치 인자를 그대로 넘긴다
    새 인자를 시험하려고 raw ros2 launch 를 치면 스크립트가 챙기는 것들을
    전부 잃는다 — 장치 점검, 중복 실행 차단, 라이다 드라이버 자동 기동,
    전압 보정, tee 로그. 그래서 통과 경로를 만든다.
    bash tools/drive_school.sh --missions --extra ff_brake_pwm:=50
    여러 번 줄 수 있다.
2026-09-17 실측 데이터를 저장소로 — /tmp 는 재부팅하면 사라진다
    회피·마운트·제동 판정의 근거가 전부 /tmp 의 CSV 였다. 재부팅 한 번이면
    근거가 사라지고, 그 데이터를 쓰는 시험 셋은 **조용히 건너뛰고 통과한다**.
    대회 당일 아침에 노트북을 껐다 켜면 그렇게 된다.
    drive_0020 회피 성공 기준값 (9/16 이전, cmd_steer 단위버그 있음)
    drive_0312 마운트 고장 런 (BLOCKED 79%)
    drive_0337 마운트 수리 후 완주 (80.1초)
    drive_0117/0126 arm s40 — 첫 장애물 충돌
    drive_0137 arm s37 — BLOCKED 0%, obs 최소 8.00m
    drive_0152 IMU 직결 후 (재연결 0), 능동 제동 최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
    [drive_0020.csv, drive_0020_scan.csv, drive_0117.csv, drive_0117_scan.csv, drive_0126.csv, drive_0126_scan.csv, drive_0137.csv, drive_0137_scan.csv]
2026-09-17 회피 — 옆으로 비켜난 장애물에 제동 걸던 것과, 제한 없던 조향 변화율
    두 가지가 같은 파일에 걸쳐 있어 한 커밋으로 묶는다.
    ① aim_clearance — '앞이 막혔다' 의 정의가 틀렸다
    front_distance 는 트랙창 ±1.2m 안 **모든** 장애물의 최소 range 라,
    옆으로 1.0m 비켜난 의자도 '앞이 1.0m' 로 읽혔다. 종방향이 그 숫자로
    제동을 걸어 **의자 사이에서 섰다.** 안 서는 배치 창이 폭 0.20m 뿐이었다.
    조준 방향을 축으로 놓고 차폭+여유(0.6375m) 안에 드는 점만 '앞' 으로 센다.
    AVOID 에서만 계산하고 나머지는 -1.0 → 소비자가 front_distance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
    [test_aim_clearance.py, test_avoid_rate.py]
2026-09-17 먹스 — 회피가 차를 경로 밖으로 끌고 갈 때 놓아주는 장치
    AVOID 중에는 먹스가 경로조향을 **통째로 버린다**. 그게 옳은 순간도 있지만,
    한 번 벌어지기 시작하면 돌아올 방법이 없다. drive_0312 실측:
    t88.8 이탈 +0.67m 헤딩 +19.2° 18°로 회복 가능
    t89.2 이탈 +0.90m 헤딩 +25.3° ❌ 25°/s 필요 vs 최대 25°/s ← 경계
    t90.4 이탈 +1.87m 헤딩 +46.8° ❌ 47°/s 필요 vs 최대 24°/s
    t90.0 부터 −18° 를 계속 줬는데도 이탈이 1.50 → 3.76m 로 자랐다. DISARM
    후에도 자랐다. **이탈/정지는 탈락이고 접촉은 감점이다** — 이 교환이 맞다.
    추가 (전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
    [control.launch.py, test_avoid_hold.py, vehicle_cmd_mux_node.py]
2026-09-17 경로추종 — odom twist 스파이크가 lookahead 를 흔들던 것 (기본 켜짐)
    /odometry/filtered 의 twist 가 EKF 프레임 지연으로 튄다. 실측:
    1.08 → 61.90 → 0.99 m/s (2샘플, 랩당 3~6회)
    **위치는 멀쩡하다.** 그런데 local_pure_pursuit 가 이 속도로 lookahead 를
    정하므로, 튄 두 샘플 동안 lookahead 가 폭발해 조향이 0.1초 둔해졌다.
    max_plausible_speed(3.0 m/s) 를 넘으면 버리고 직전 값을 유지한다.
    이건 **기본 켜짐**이다 — 61.9 m/s 는 이 차에서 물리적으로 불가능하고,
    버리는 쪽이 어느 상황에서도 안전하다.
2026-09-17 능동 제동 — 제동시간 기준을 명령속도에서 측정속도로
    ff_min_pwm 55 하한이 낮은 속도명령을 전부 덮어써서 **명령속도는 실제보다
    낮다**(drive_0152 실측: 명령 0.70 / 실제 1.12 m/s). 제동시간을 명령으로
    재면 차가 아직 구르는 중에 제동이 끊긴다.
    ⚠ 평지에서는 이 수정이 거의 무의미하다. 실측 런 리플레이 결과 **+0.05초**다
    (0.75 → 0.80s). 해제조건 ②(측정속도 0.15 미만)가 먼저 끊기 때문이다.
    인계문서 9/17 §1-4 는 '700ms 만에 제동이 끝나고 마지막 400ms 는 관성,
    측정속도로 바꾸면 1.1초 → 0.7초대' 라고 적었는데 **데이터가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
    [serial_bridge_node.py, test_brake_logic.py]
2026-09-17 신호등 — 가로형을 못 읽고 있었다 (그리고 세 가지가 더 겹쳐 있었다)
    정지/출발 로직은 이미 완성돼 있었다(traffic_light_bridge). 막힌 건 검출
    신뢰도였고, 네 가지가 겹쳐 '동전던지기' 가 되어 있었다.
    ① ★ 가로형을 못 읽었다 — 결정타
    LAMP_POS = {RED 0.29, YELLOW 0.50, GREEN 0.71} 은 **세로형** 기준이다.
    가로형은 어느 램프가 켜지든 세로 무게중심이 항상 한가운데(~0.5)라
    **무조건 YELLOW** 로 읽히고, 색이 GREEN 이면 불일치로 거부된다.
    실도로 진단문: `불일치: 위치=YELLOW 색=GREEN(H=86)`
    **한국 차량 신호등은 대부분 가로형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
2026-09-17 판정 도구가 거짓말하던 세 곳 — 9/19 에 이걸로 판단하면 오진한다
    ① 회피 조향 변화율을 **기록 주기**(0.05s)로 나누고 있었다
    기록기는 '마지막으로 받은 명령' 을 20Hz 로 베껴 쓸 뿐이다. 회피창 안에서
    명령이 실제로 바뀌는 간격은 **0.100s**(슬루 제한이 cluster_plot 10Hz 에
    있고 먹스가 20Hz 로 재발행할 뿐). 값이 정확히 2배로 부풀어, 슬루 제한을
    **켜고 달린 런 3개가 전부 위반으로 찍혔다**:
    런 실제 설정 기존 수정(95%)
    0126 90°/s 켬 160 24
    0137 90°/s 켬 182 26
    0152 90°/s 켬 166 24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
    [drive_fixtures.py, drive_record.py, drive_review.py, test_drive_review.py, test_lidar_mount_check.py]
2026-09-17 현장 점검 도구 — 마운트·IMU 링크·arm 시점
    lidar_mount_check.py — 거리 하나만 보던 것을 **기하**로 바꿨다. 지면은
    x = r·cosβ 가 일정한 직선(x₀ = h/tanθ)이고, 롤이 있으면 기운다. 횡 폭으로
    지면과 물체를 가른다. --confirm 은 차를 2m 옮겨 **차체고정(지면) vs
    지도고정(벽)** 을 가른다 — 정면 벽은 한 장으로는 지면과 구분 불가다.
    이 도구로 세 번 틀렸고 전부 고쳤다. 전부 판정 기준이 플래너와 달라서다:
    · 롤 부호가 거꾸로 → **심을 반대쪽에 넣을 뻔했다.** k>0 = 우측이 낮다
    · 0.17m 를 장애물로 셈 → PLANNER_MIN_RANGE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
2026-09-17 미션 계획 검사·시각화 — s 구간이 틀리면 증상이 '조용한 탈락' 이다
    노드도 로그도 멀쩡한데 엉뚱한 지점에서 미션이 돌거나 안 돈다. 지금까지
    이 판단은 전부 **사람이 주석에 적어 둔 계산**뿐이었다. 시퀀서는 런타임에
    course 블록(파일명·길이)만 대조하고, s 구간이 기하학적으로 말이 되는지는
    아무도 안 봤다. 용인 계획은 현장에서 처음부터 짜야 한다.
    mission_plan_check.py 가 검사하는 것 (전부 실측 근거):
    arm 여유 감지 트리거 4.0 + BLOCKED 반경. BLOCKED 는 조향을 안 낸다
    arm 곡률 R<8 실패 / R<11 경고 (s33 R=6.4 급커브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
2026-09-17 인계문서 3편 — 9/16 마운트, 9/17 IMU·arm·신호등, 9/17밤 도구 검증
    각 문서 하나로 이어받을 수 있게 썼다. 숫자는 전부 실측이고 근거 런은
    data/2026-09-17/ 에 있다.
    HANDOFF_2026-09-16.md 라이다 마운트 지면타격(2회 재발) · aim_clearance ·
    조향 도달률 · 이탈 한계 0.9m/25°
    HANDOFF_2026-09-17.md IMU 는 USB 허브가 원인(-EPIPE) · 회피 arm s40→37 ·
    신호등 가로형 · 능동 제동 실차 최초
    HANDOFF_2026-09-17_night.md
    판정 도구 3곳 수정 · 제동 주장 반증 · 미션 계획
    검사기 · 용인 코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
2026-09-17 구간별 이탈 — 이탈 상한을 '실측에서' 정하는 길을 뚫는다
    용인 S자는 **커브 안에서** 회피해야 하고, 거기서 기댈 보호장치는 먹스의
    이탈 상한뿐이다. 그런데 그 값을 정할 근거를 재는 도구가 없었다 —
    drive_review 는 회피 구간 안에서만 이탈을 봤다.
    --section 이름=s0:s1 구간별 이탈/헤딩 통계 (반복 가능)
    --obstacle-width m 통과 필요량을 더해 avoid_max_lateral_m 을 권고
    --lane-width m 그 상한으로 차선을 안 벗어나는지 검사
    9/19 현장 절차가 이걸로 한 줄이 된다:
    ① 장애물 없이 한 바퀴 + drive_record
    ② drive_review <csv> --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
    [drive_review.py, test_drive_review.py]
2026-09-17 구간 속도 — 내리막 판단에 쓸 수 있게 (스파이크가 새고 있었다)
    내리막은 제동 권한이 없어 **바닥 속도가 다음 커브를 돌 수 있는지를 정한다.**
    그래서 구간 통계에 최대 속도를 넣었는데, 처음 돌려보니 이렇게 나왔다:
    직선 s42~55 · 속도 평균 1.38 · 최대 **28.68 m/s**
    odom twist 스파이크가 그대로 샌 것이다(랩당 3~6회, 실측 61.9m/s). 본문은
    이미 거르고 있었는데 구간 코드가 원본 v 를 썼다. 내리막에서 이런 값이 나오면
    그대로 오판한다. 같은 스파이크 마스크를 적용했다 — 최대 1.47 m/s.
    시험도 한 번 틀렸다. 정규식이 앞쪽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
2026-09-17 경사 시험 — GPS 없이 재고 판정한다 (엔코더가 살아 있었다)
    ★ 인계문서가 틀렸다. 엔코더는 살아 있다.
    '경사로 — 엔코더가 죽어(NO_ENCODER 1) 홀드 불가' 를 검증 없이 받아썼는데,
    실차에서 확인하니 셋 다 정상이었다:
    · 살아있음 차를 앞으로 4.6m 밀어 카운트 -1422 → -3025 (연속, 20Hz)
    · 부호 전진에 **감소** → counts_per_revolution=-290 이 맞다
    · 속도 434샘플 전부 양수, 최대 +0.46 m/s
    (문서 자체도 모순이었다 — 주석은 '인터럽트 4체배로 교체했다' 인데 코드는
    여전히 LS7366R SPI 카운터다. NO_ENCODER 1 은 2026-09-05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
2026-09-17 teleop 런치 — 경사 출발 PWM 도 인자로
    ff_breakaway_pwm / ff_breakaway_ms 를 열었다. 정지→출발 때 정지마찰을 뚫는
    값인데 기본 60 은 **평지 기준**이다(실측: PWM 50 안 구름 / 55 덜컹 / 60 →
    1.07 m/s). 오르막 출발은 더 필요할 수 있고, 모자라면 차가 경사에서 못 떠난다.
    ⚠ 오르막 시험에는 ff_brake_pwm 을 **끌 것**(기본 0 그대로).
    제동 PWM 은 `-brake_sign × ff_brake_pwm` 이라 전진 중 정지명령이면
    **뒤로** 미는 방향이다. 오르막에서 멈춰 뒤로 밀리는 중이면 해제조건 ②는
    |측정속도| 로 보므로 안 풀리고, 최대 800ms 동안 뒤로 더 민다.
    제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
2026-09-17 경사 시험 자율 모드 — 키보드 없이 스스로 올라가고 선다
    경사에서 W 를 누르면서 화면도 보는 건 위험하고, 속도를 일정하게 유지하기도
    어렵다. `straight_drive` 가 있지만 /odometry/filtered 를 쓰므로 GPS·IMU 스택이
    필요하다. **엔코더가 살아 있으니 거리를 엔코더로 재면 그게 다 필요 없다.**
    python3 tools/ramp_test.py --label 오르막1 --drive 15 --speed 0.8
    /teleop/cmd_vel 로 낸다 — 먹스에서 teleop 이 자율보다 우선이고 E-stop 은
    그보다 위라 **비상정지 권한이 살아 있다**. 헤딩 캘리브 게이트도 teleop 이
    그보다 먼저 잡히므로 통과한다(실측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
2026-09-17 경사 시험 — 실제 PWM 을 기록한다 ('못 올라감' 의 원인이 안 갈렸다)
    첫 오르막 시도에서 0.2m 기어가다 섰는데, 기록에 PWM 이 없어 원인을 추측해야
    했다. 둘은 처방이 정반대다:
    · PWM 이 높은데 안 움직임 → 토크 부족. 설정으로 더 못 올린다
    · PWM 이 낮은데 안 움직임 → 명령이 모자란 것. 올리면 된다
    /drive_pwm 을 구독해 기록·표시하고, 판정에서 둘을 가른다(문턱 100).
    첫 시도 실측 (ff_breakaway_pwm 80 / max_speed 1.2 → FF PWM 64):
    0.28~2.18s 0.12~0.23 m/s 로 기어감 (엔코더 61counts = 0.175m)
    2.18s~ 완전 정지, 엔코더 동결
    vcc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
2026-09-17 경사 시험 — 조주(run-up)를 볼 수 있게 거리별 속도 프로파일
    경사는 정지출발이 아니라 **달려와서** 오른다(대회도 그렇다). 그러면 '어디서
    얼마나 느려졌나' 가 전부인데, 판정표가 최대 속도만 보여서 그게 안 보였다.
    거리별로 나눠 찍고, 급감속 구간을 표시하고, 후반 감속도에서 **필요 진입속도**를
    역산한다:
    7.5~ 8.6m 1.80 m/s ████████████████████████
    8.6~ 9.7m 1.72 m/s ██████████████████████
    9.7~10.8m 1.41 m/s ██████████████████
    1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
2026-09-17 경사 시험 — 엔코더 '끊김' 판정이 정상 런을 실패로 찍었다
    실차 조주 런에서 **'달리는 중 카운트가 멈춘 샘플 510개 (72%)'** 로 실패가 났다.
    거짓이었다. 엔코더는 멀쩡했다:
    기록 120 Hz · 엔코더 갱신 18 Hz → 6.5배 과샘플링
    실제로 바뀌는 간격 중앙 0.049s · 최대 0.094s (= 정상)
    연속 **샘플**끼리 비교했기 때문이다. 기록기가 발행보다 빠르면 같은 값이
    연속으로 찍히는 게 당연하다. 비교는 **시간**으로 해야 한다 —
    '움직이는 중인데 갱신주기의 5배(0.25s) 넘게 값이 그대로' 가 진짜 끊김이다.
    ⚠ 이 저장소에서 같은 함정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
2026-09-17 경사 시험 — PWM 판정 두 곳을 고쳤다 (둘 다 현장에서 오도한다)
    ① breakaway 구간이 판정에서 통째로 빠졌다
    '안 움직임' 판정 창을 t>2.0s 로 잡았는데 ff_breakaway_ms 기본이 1200ms 라,
    **출발 정지마찰을 뚫는 값이 얼마였는지가 빠졌다.** PWM 110 으로 밀어도
    안 움직인 실차 런을 'PWM 90 뿐' 이라고 보고했다. 출발 램프(1초)만 뺀다.
    ② '토크 부족' 문턱 100 이 틀렸다
    'PWM 100 넘는데 안 움직이면 설정으로 더 못 올린다' 고 했는데, 개루프 경로의
    상한은 펌웨어 MAX_OPENLOOP_PWM = **230** 이다. PWM 110 은 절반도 안 쓴
    것이라 '차의 한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
2026-09-17 경사 시험 — Ctrl-C 가 정지 명령을 못 내고 기록도 날렸다 + 롤백 검사
    실차에서 Ctrl-C 를 눌렀더니 이렇게 끝났다:
    File ".../ramp_test.py", line 352, in record → send(0.0)
    rclpy...RCLError: Failed to publish: publisher's context is invalid
    rclpy 기본 SIGINT 핸들러가 **컨텍스트를 먼저 무효화**해서, finally 의 정지
    명령이 터진다. 결과:
    · 정지 명령이 안 나갔다 (펌웨어 워치독 0.5초가 세우긴 했지만 우리가 아니다)
    · **25초짜리 런이 통째로 날아갔다** — 저장 코드까지 못 갔다
    고침:
    · SIGINT 를 직접 잡아 플래그만 세우고 루프를 정상 종료 → 컨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
    [ramp_test.py]
2026-09-17 경사 시험 — 미끄러져 내려가는 것을 못 세웠다 (안전 버그)
    실차에서 이렇게 끝났다:
    0~15.5s 전진 3.76m 까지 올라감
    15.5~21s 멈춤
    21~38.5s **뒤로 미끄러짐** 3.71m → −2.94m
    그동안 명령 1.20(전진) · PWM 90 이 계속 걸려 있었다
    744샘플(45%)이 '명령은 전진인데 실제는 후진' 이고 최대 후진 1.15 m/s,
    최고점에서 **7.70m** 되밀렸다. **그런데 도구가 안 세웠다** — 중단 조건이
    '안 움직인다'(|v|<0.05)뿐이라, 차가 뒤로 '움직이는' 중이면 안 걸린다.
    40초를 다 채우며 미끄러져 내려갔다.
    고침 셋:
    ① 중단 조건 추가 — 전진 명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
2026-09-17 경사 시험 — 정지 판정을 속도에서 거리로 (양자화 잡음 아래였다)
    실차에서 차가 5.8m 에 선 채 **17초 동안 중단이 안 걸렸다**. 판정이
    `abs(v) < 0.05` 였는데, 이 차의 속도 분해능이 그보다 굵다:
    엔코더 1카운트 = 2π×0.1327 / 290 = 2.875 mm
    갱신 20Hz → 최소 분해속도 = **0.0575 m/s**
    즉 완전히 선 차도 ±0.06 으로 떨리고, 그 값이 문턱 0.05 를 넘어 판정이 매
    샘플 리셋됐다. 속도로 '멈춤' 을 보는 것 자체가 틀렸다.
    → **거리**로 본다: stuck_after 동안 0.15m 도 못 가면 중단.
    분해능(2.9mm)의 50배라 잡음에 안 걸린다.
    같은 이유로 후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
    [ramp_test.py]
2026-09-17 경사 시험 — '경사가 한계다' 라고 단정하면 안 된다 (실제로는 구동계 고장)
    22:12 PWM 170 → 3.51 m/s ✓ 정상
    22:13 PWM 130/200 → 0.00m ✗
    22:14 **바퀴를 들고** PWM 200 → 0.00m ✗
    부하가 없는데도 안 돌았다. 경사 문제가 아니라 **세션 중에 구동계가 고장났다**
    (3.5 m/s 까지 나온 런 직후다). 그런데 도구는 '이 경사는 이 차의 한계다' 라고
    찍었다. 이 도구는 차가 경사에 있는지조차 모른다 — 단정하면 안 되는 말이었다.
    전압이 진단을 준다. 잠긴 모터는 역기전력이 없어 전류를 최대로 빤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
2026-09-17 구동 진단 — 구동과 조향을 같은 기준으로 재서 가른다 (조향이 범인이었다)
    경사 시험 중 구동이 죽은 줄 알았다. 바퀴를 들어도 PWM 200 에 무반응이고
    전압 변동이 47mV 뿐이었다. 그런데 10분 뒤 이 도구로 재니:
    기준 4198 mV
    구동 PWM 50 강하 0 mV · 엔코더 3카운트 **돌았다**
    조향 ±18° 강하 2160 mV · 최저 **2038 mV**
    둘 다 예상과 반대였다.
    ① 구동은 살아 있다. PWM 200 무반응은 **모터 드라이버 열보호**로 보인다
    (직전에 PWM 170 으로 3.5 m/s 를 달렸고, 식은 뒤 PWM 50 에 돌았다).
    → 대회 중 같은 일이 나면 한동안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
2026-09-17 경사를 차로 잰다 — 엔코더만, 모터 안 씀
    경사 시험에서 차가 0.8m 올라가고 섰는데, 그 감속(4.56 m/s²)을 경사로만
    설명하려면 **52% 경사**여야 한다. 정상 경사로가 아니다 — 진입부 단차를
    의심했지만 **경사를 잰 적이 없어** 확정을 못 했다.
    차를 경사 위로 밀었다 놓으면 올라가며 감속하고, 멈췄다 내려오며 가속한다.
    두 구간을 같이 재면 구름저항이 상쇄된다:
    올라갈 때 |a_up| = g·sinθ + f
    내려올 때 a_down = g·sinθ − f
    ⇒ g·sinθ = (|a_up| + a_down)/2 ← 경사
    f = (|a_up| − a_down)/2 ← 구름저항(덤)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
2026-09-17 닫힌 루프로 되돌린다 — 경사를 오르는 유일한 방법 (NO_ENCODER 0)
    ★ 개루프로는 **평지 속도와 경사 토크가 한 값에 묶인다** (실측)
    ff_min_pwm 90 → 평지 2.7 m/s · 경사 못 버팀 (최고점에서 7.7m 되밀림)
    ff_min_pwm 170 → 평지 3.5 m/s · 굴절코스 첫 코너(R=6.4m) 상한 3.0 초과
    경사를 오를 만큼 세게 하면 평지에서 코스를 못 돈다. 한 값으로 둘을 만족시킬
    수 없다.
    ★ 닫힌 루프면 된다 — 숫자로 확인했다
    법정 경사로(도로교통법 시행규칙 별표 23): 오르막 10~12.5% · 높이 1.5m 이상
    실측에서 추진력 계수를 뽑았다(211샘플): **0.02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
2026-09-17 경사 시험 — 긴 런의 거리 프로파일 칸을 잘게
    100m 를 12칸으로 나누면 8m 씩이라 경사 진입점이 뭉개진다. 24m 를 넘는 런은
    대략 2m 한 칸이 되게 잡는다(최대 24칸).
2026-09-17 경사 시험 — 바퀴 슬립 탐지 + 틀린 검사 제거
    ★ 슬립이었다. PWM 이 122 로 **고정**인데 속도가 0 ↔ 2.88 m/s 를 오갔다
    (603샘플 중 545개가 PWM 122, 변동계수 0.68, 주행 중 정지 27회).
    같은 PWM · 같은 경사면 속도는 매끄러워야 한다. 접지를 잃고 헛돌다
    (엔코더는 빠르게 읽는다) 다시 물리는 스틱-슬립이다.
    ⚠ **슬립이면 PWM 을 올리면 더 나빠진다.** 처방이 정반대라 반드시 갈라야
    한다. 오늘 90 → 110 → 130 → 150 → 170 으로 올려 온 게 헛수고였을 수 있다.
    변동계수 0.55 초과를 실패로 찍고, '바퀴가 도는데 차가 안 나가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
2026-09-17 경사 시험 — 속도를 펌웨어 대신 엔코더에서 만든다 (슬립 오진의 원인)
    **슬립이라고 진단한 게 틀렸다.** 펌웨어 /current_speed 를 그대로 믿은 탓이다.
    속도 갱신 간 변화량 중앙 **0.115 m/s** = 정확히 엔코더 2카운트(2×0.0575)
    0.5 m/s 넘는 점프가 평지·경사 **똑같이 8~9%**
    펌웨어는 10ms 창으로 미분한다(counts_per_rev 290, 바퀴둘레 0.834m →
    1카운트 2.875mm). 0.9 m/s 면 10ms 에 3카운트뿐이라 양자화가 그대로 실린다.
    그 잡음을 '바퀴가 헛돈다' 로 읽었다.
    카운트 자체는 멀쩡하므로(연속성 검사 통과, 최장 정지 0.03~0.07s) **0.25초
    중심차분*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
2026-09-17 경사 측정 — '손을 안 뗀 런' 을 걸러낸다
    실측에서 0.8 m/s 가 10초 동안 유지된 기록이 '올라감 가속도 -0.03 m/s²' 로
    계산됐다. 그건 감속이 아니라 **등속 밀기**다. 손을 떼야 감속→정지→후진이
    나오고, 그래야 구름저항이 상쇄된다.
    3초 넘게 속도 변동이 25% 미만이면 거부하고, 무엇을 잘못했는지 말한다.
2026-09-17 경사 측정 — 놓기만 해도 근사값을 낸다 + 구간 탐지 수정
    ① 구간 탐지가 **최고속도 지점 이후**만 봤다. 밀지 않고 놓기만 한 기록은
    최고점이 끝에 있어 두 구간 다 0샘플로 나왔다. 가장 긴 연속 구간으로 찾는다.
    ② 내려오는 구간만 있으면 구름저항을 **가정**해서 근사값을 낸다.
    a_down = g·sinθ − f ⇒ g·sinθ = a_down + f
    세 가지 f 로 범위를 보여주고, 밀었다 놓으면 가정이 필요 없다고 안내한다.
    (밀었다 놓으면 두 구간이 f 를 상쇄한다 — 그쪽이 정확하다)
    실측 CtrlC 런(구동 완전히 꺼진 채 5m 후진)에 적용: 경사 3.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
    [slope_meas.py]
2026-09-17 인계 — 경사로 실차 세션 (차는 대회 경사로를 오른다)
    ★ 결론
    시험 경사 18~20% · 법정 경사로 10~12.5% · 한계 PWM160 에서 21.9%
    오늘 5시간을 '왜 못 오르지' 로 쓴 이유는 **경사를 한 번도 안 재고** PWM 만
    90→230 으로 바꿔가며 시험했기 때문이다. 재는 데 30초였다.
    ★ 실측 물성 (이 차의 기준값)
    추진력 계수 k = 0.0202 m/s²/PWM (평지 가속 173쌍 적합)
    구름저항 f = 0.733 m/s² (기록 이력 0.31~0.43 의 2배)
    시험 경사 18.0% (밀었다놓기, 평형점 역산 20.2% 와 일치)
    평지 정상속도 2.33 m/s @ PWM 105
    법정 12.5% 는 PWM160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
    [ramp_CtrlC시험_2205.csv, ramp_PWM160_2302.csv, ramp_공중_2214.csv, ramp_무부하_2248.csv, ramp_반복1_2305.csv, ramp_반복1_2308.csv, ramp_슬립확인_2235.csv, ramp_슬립확인_2236.csv]
2026-09-17 인계 보강 — 경사로 구간별 경사 역산 + 좀비 브리지 판별법
    좀비를 정리하고 PWM 160 단독으로 다시 재니 **10.0m** (이전 7.5/7.9m).
    전압도 3867 → 4311mV 로 회복됐다(좀비 2벌이 빠지면서 부하가 줄었다).
    PWM 160 고정 런에서 구간별 경사를 역산했다:
    중반 1.1~9.5m 1.20 m/s **평형** → 경사 20.2%
    상부 9.5~10.5m 0.79 m/s 감속 → 경사 25.2%
    차의 한계(1.0 m/s 에서 21.9%)를 상부에서 넘는다. 중반 20% 는 등속으로 버틴다.
    법정 경사로 10~12.5% 는 2.1~2.4 m/s 로 여유.
    ★ 좀비 브리지 판별법을 적었다. serial_bridge 가 둘이면 서로 다른 ff_min_pwm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
    [ramp_깨끗30_2310.csv]
2026-09-17 경사 시험 — 주행 중 엔코더 점프 방어 + 런치 기본값 되돌림
    ① 좀비를 kill -9 했을 때 아두이노가 리셋되며 카운트가 통째로 튀었고,
    도구가 그걸 이동거리로 셌다:
    속도 최대 1197.99 m/s · **뒤로 154.2m** · 횡가속 224245 m/s²
    첫 샘플 점프만 방어하고 있었다. 주행 중 점프를 못 걸렀다.
    → 20Hz 에서 한 샘플 400카운트(1.15m, 23 m/s)를 넘으면 점프로 보고
    이후 전체에서 빼되, **이 런은 믿지 말라**고 실패로 찍는다.
    ② teleop 런치 ff_mode 기본값을 'firmware' → **'ros' 로 되돌렸다.**
    펌웨어를 아직 안 구웠는데(NO_ENCODER 1) 기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
2026-09-17 경사 시험 — 엔코더 점프 보정을 속도 계산보다 먼저
    점프를 거리에서만 빼고 있었다. 속도는 그 앞에서 계산돼서, 점프를 그대로
    미분한 **478 m/s** 가 남았다(합성 검증에서 잡았다). 보정을 맨 앞으로 옮겼다.
    검증: 점프 파일 → 전진 11.4m · 최고 1.15 m/s (점프 전 144m · 478 m/s)
    정상 런 → 오탐 없음
2026-09-17 내리막 속도 거버너 — 개루프의 유일한 '달리는 중' 감속 수단 (기본 꺼짐)
    ★ 왜
    개루프에는 달리는 중 감속 권한이 없다. 제동(ff_brake_pwm)은 **정지 명령에만**
    붙는다. 그래서 내리막에서 중력이 이기면 명령을 낮춰도 계속 빨라진다.
    실측(2026-09-17, 구름저항 0.733 · 추진력 k=0.0202):
    법정 하한 6.5% 중력 0.64 − 저항 0.733 = **−0.10** → 관성만으로 감속
    법정 상한 9.0% 중력 0.88 − 저항 0.733 = +0.15 → 17m 에 2.2 m/s
    시험장 18% 중력 1.74 = +1.00 → 8m 에 4.1 m/s
    굴절코스 첫 코너(R=6.4m) 상한은 3.0 m/s 다.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
2026-09-17 거버너가 한 번도 안 걸렸다 — 측정속도 공급원이 없었다
    실차 첫 시험에서 거버너가 전혀 개입하지 않았다. 원인:
    _meas_v 는 /odometry/filtered 에서만 온다 → **GPS+IMU 스택이 있어야 한다.**
    teleop_drive 만 띄운 경사 시험에는 그 토픽이 아예 없다.
    트랙에서는 odom 이 나오므로 그대로 동작하지만, 그래도 폴백이 필요하다 —
    **IMU 가 끊기면 odom 도 멈춘다**(9/15 에 32번). 거버너가 정확히 필요한
    순간에 눈이 머는 것을 막아야 한다.
    → `/current_speed`(엔코더) 를 같이 구독한다. 이 노드가 직접 파싱하므로
    항상 있다. odom 이 신선하면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
2026-09-17 거버너를 연속 조절로 — '버티면서 내려가기' 가 안 되던 이유
    실차 첫 성공 런에서 PWM 이 **48 → -1 → 33 → -24 → -50** 으로 진동했다.
    개입할 때 FF 를 **통째로 역 PWM 으로 바꿨기** 때문이다. 중간이 없다.
    내리막 등속에 필요한 것은 대부분 **스로틀을 줄이는 것**이지 제동이 아니다.
    5 km/h(1.39 m/s) 유지 기준 계산:
    평지 PWM 71 (구동)
    법정 6.5% PWM 40 (구동)
    법정 9% PWM 28 (구동)
    시험장 18% PWM −15 (제동)
    → FF 크기에서 초과분 × gain 을 **빼고**, 필요하면 음수(제동)까지 내려간다.
    역방향은 gov_pwm 으로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
2026-09-17 거버너 런치 기본값도 맞춘다 (노드만 고쳤다가 옛 값이 나갔다)
    런치의 DeclareLaunchArgument 가 노드 기본값을 덮어쓴다. 노드에서 deadband
    0.30→0.10 · gain 80→300 으로 바꿨는데 런치가 옛 값을 그대로 넘겨서, 시작
    로그가 '0.30m/s ... 1m/s 당 80' 을 찍었다. 두 곳을 같이 고쳐야 한다.
2026-09-17 거버너 입력을 펌웨어 VEL 에서 엔코더 위치차분으로 바꾼다
    내리막 5km/h 시험(/tmp/ramp_5키로_2338.csv)이 2.53 m/s 로 중단됐다.
    거버너는 개입했지만 **입력이 잡음**이라 헛짚었다. 같은 순간의 값:
    t=2.59 펌웨어 VEL 1.90 ↔ 엔코더 실속 0.63
    t=3.22 펌웨어 VEL 3.05 ↔ 엔코더 실속 1.08 → PWM 71→23
    t=3.44 펌웨어 VEL 0.06 ↔ 엔코더 실속 0.65 → PWM 23→59
    3.05 스파이크에 놀라 깎았다가 다음 표본 0.06 에 다시 올린다. 잡음을
    쫓느라 진짜 가속(0.73→1.05→1.70)을 놓쳤다. 펌웨어는 10ms 창으로
    미분하므로 눈금이 0.2875 m/s 다 — 저속을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
2026-09-17 내리막 서행 성공 — 19.3% 경사를 4km/h 목표로 8m 완주
    data/2026-09-17-ramp/ramp_4키로_2349.csv · 272샘플 · 전 항목 통과.
    내리막에서 끝까지 간 첫 런이다. 중단 없음, 되밀림 0.00m,
    엔코더 최장 정지 0.045s, 링크 끊김 없음.
    목표 1.11 m/s (4.0 km/h)
    정상상태 1.58 m/s (5.7 km/h) 2m 이후 155표본
    PWM 중앙 -24 · 범위 -60~60 · 58% 가 역PWM
    ■ 경사를 이 런에서 역산했고, 기존 측정과 맞았다
    정상상태는 가속도 0 이므로 g·sinθ/k = FF(v) - PWM_실제.
    FF(1.58)=78.5, 실제 -15 → g·sinθ=1.89 → sinθ=0.193 = 19.3%.
    slope_meas.py 의 18~20% 와 일치. 서로 다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
    [ramp_4키로_2349.csv]
2026-09-17 IMU 피치로 경사를 상쇄한다 — 기본 꺼짐, 부호는 현장에서 확정
    개루프 FF(PWM = 38.8·v + 17.2)는 평지에서 식별한 식이라 중력을 모른다.
    k=0.0202 로 환산하면 경사가 통째로 먹는 PWM 이 이만큼이다:
    법정 오르막 12.5% → +60 이 사라진다
    법정 내리막 9% → -44 가 공짜로 붙는다
    시험 경사 19.3% → ±92
    그래서 명령속도를 그대로 주면 오르막에서 못 올라가고 내리막에서 붙는다.
    IMU 피치를 알면 이 항을 직접 상쇄할 수 있다. **웨이포인트가 필요 없다** —
    지도에 없는 경사도, 경사 도중이라도 잡는다. 구간 기반(course_s)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
2026-09-17 경사로 구간 속도 — 기준값만 바꾸고 안전장치는 전부 남긴다
    웨이포인트(course_s)로 경사 구간을 알면 그 구간의 기준속도를 바꾼다.
    시퀀서가 이미 arm 을 tick 마다 재발행하므로 배경 미션 두 개만 얹으면 된다.
    ■ MISSION_POLICY 방식을 안 썼다 — 그게 이탈의 지름길이다
    decide_target 은 MISSION_POLICY 가 맞으면 **고정속도를 곧장 return** 한다.
    곡률·정지선·장애물 감속을 통째로 건너뛴다. 구간이 잘못 찍혀 코너에
    걸리면 그 속도로 들어간다 = 이탈 = 탈락.
    대신 `v_max` 자리에 들어가는 **기준값만** 바꿨다. 하류 제한이 전부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
2026-09-17 경사로 현장 절차서 — 부호 확인을 건너뛸 수 없게 순서를 못 박는다
    grade_ff 는 부호가 반대면 내리막에서 가속한다. 그래서 ①평지 영점
    ②경사 부호 확인을 통과해야 ③에서 켜게 순서를 고정했다. 절반 이득(0.5)
    부터 시작하는 것도 같은 이유다.
    세 기능이 겹치지 않는다는 것을 표로 박았다:
    grade_ff = 그 속도를 내려면 PWM 이 얼마여야 하는지 (웨이포인트 불필요)
    구간 속도 = 어디서 얼마의 속도를 낼지 (웨이포인트 필요)
    거버너 = 그래도 빨라지면 깎는다 (마지막 방어선)
    '아직 검증 안 된 것' 을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
2026-09-17 통합시험이 SIGTERM 에서 좀비를 남기지 않게 한다 (세 번째 재발)
    `timeout N python3 tools/test_*.py` 로 돌리다 상한에 걸리면 SIGTERM 이 온다.
    파이썬은 **SIGTERM 에서 finally 를 안 돌리고 즉사**한다. 그래서 finally 의
    kill_group 이 건너뛰어지고, start_new_session=True 로 띄운 `ros2 run` 자식이
    살아남는다.
    살아남은 시퀀서는 같은 토픽에 두 벌이 서로 다른 값을 쏴서 arm 이 10Hz 로
    ARM↔DISARM 깜빡이게 만든다. 그걸 보고 '시퀀서 로직이 깨졌다' 고 오판한다.
    오늘 실제로 그렇게 오판했다:
    · timeout 300 이 시험을 죽임 → PID 605213/605214 좀비로 남음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
2026-09-18 근거 로그를 저장소로 옮긴다 — /tmp 를 인용한 주석은 재부팅하면 거짓이 된다
    serial_bridge_node.py:596 과 replay_governor.py 의 사용 예가
    /tmp/ramp_5키로_2338.csv 를 근거로 들고 있었다. 이 파일이 사라지면
    "펌웨어 VEL 이 3.05 를 찍을 때 엔코더는 1.08 이었다" 는 주장을
    **아무도 다시 확인할 수 없다.** 근거를 못 대는 주석은 주석이 아니다.
    data/2026-09-17-ramp/ 로 옮긴 것
    ramp_5키로_2338.csv ← 거버너가 잡음을 쫓다 놓친 그 런 (인용됨)
    ramp_거버너1_2329.csv ← 통째 역PWM 시절 (48→-1→33 진동)
    ramp_거버너2_2333.csv ← 같음
    교체 후 저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
    [ramp_5키로_2338.csv, ramp_거버너1_2329.csv, ramp_거버너2_2333.csv]
2026-09-18 인계 2026-09-18 — 맥락 없이도 이어서 일할 수 있게
    다음 세션에 대화 맥락이 남지 않는다고 가정하고 썼다. 무엇을 만들었는지보다
    **어떻게 검증했는지와 무엇이 아직 검증 안 됐는지**에 무게를 뒀다.
    §0 일하는 방식 — 검증 없이 덮어쓰지 않는다 / 기본값은 꺼짐 /
    주장에는 근거 파일 / 하드웨어 없이 검증 / 오진은 기록한다
    + 과거 오진 이력 3건 (슬립 오진, vcc 오독, 시험 오진)
    §2 세 조각의 역할 분담과 직렬 연결도
    §3 물리 상수와 출처 — 경사 19.3% 를 두 방법으로 교차검증한 계산 포함
    §5 파라미터 정확한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
2026-09-18 인계서 시험 건수 정정 — 세지 않고 쓴 숫자를 실측으로 바꾼다
    "단위 97건 + 통합 13건" 은 근거 없이 쓴 수다. 실제로 세어 보니:
    test_grade_ff 28 → 29
    test_ramp_section 23 → 21
    test_governor 34 → 35
    통합 mission_sequencer 13 · sudden_stop 5 · crosswalk_stop 3
    세는 방법도 문서에 적었다(`grep -c '^\s*OK '`). 세 시험은 출력 형식이
    달라 이 방법으로 안 세어진다는 것도 명시했다.
    커밋 09950a5/1ccb1ef 의 28/23 이 틀렸다는 것도 인계서에 남겼다 —
    나중에 두 숫자가 어긋나 있으면 어느 쪽이 맞는지 알 수 없기 때문이다.
    §0-3 에 "주장에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
2026-09-18 경사로 파라미터를 자율 주행 런치까지 잇는다 — 선언만 하고 안 넘기면 조용히 무시된다
    거버너(gov_*)와 IMU 경사 보상(grade_ff_*)은 9/17 에 만들고 인자를
    tools/teleop_drive.launch.py 에만 냈다. 구간 속도(ramp_up_arm_topic·v_ramp_up)는
    control.launch.py 에 선언했는데 bringup 이 넘기지 않았다.
    결과: 웨이포인트 자율 주행으로는 경사로 기능을 **하나도 켤 수 없었다.**
    teleop 으로만 시험된 이유가 이것이다.
    고장이 조용하다. 런치는 정상이고, 인자를 줘도 에러가 안 나고(안 받는 인자는
    그냥 무시된다), 노드는 잘 뜬다. 차만 경사로에서 v_max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
2026-09-18 경사로를 차에 올리기 전에 끝까지 돌려 본다 — 모델은 저장소 로그로 교차검증했다
    내일이 유일한 현장 날이고 모레가 본경기다. "현장에서 해 보면 안다" 가
    제일 비싼 계획이라 계산으로 답이 나오는 것은 전부 미리 낸다.
    tools/ramp_profile.py — 캘리브 종료 지점(정지)에서 경사로 끝까지 종방향 프로파일.
    제어 로직은 하나도 재구현하지 않았다. 실제 노드 함수를 그대로 부른다
    (replay_governor.py 와 같은 방식):
    decide_target · _base_speed · _grade_pwm · _governor_pwm
    · _ff_output · _enc_pos_update
    새로 쓴 것은 차량 모델 하나뿐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
2026-09-18 IMU 피치 부호를 실측으로 확정한다 — 반대였다
    2026-09-18, 차를 세운 채 앞/뒤바퀴를 13cm 괴고 양방향 측정했다.
    축거 0.785m 이므로 sinθ = 0.13/0.785 → 기하학적 기대각 9.53°.
    부호 +1 (기본) 일 때
    코 위(오르막) 보정 −9.55° → −16.8% ❌ 기대 +12.9
    코 아래(내리막) 보정 +9.27° → +16.3% ❌ 기대 −16.8
    양방향이 **일관되게** 뒤집혀 있었다 → sign −1 로 재저장
    부호 −1 일 때
    코 위(오르막) 보정 +9.51° → +16.8% ✅ 오차 0.0%p
    코 아래(내리막) 보정 −9.92° → −17.5% ✅ 오차 1.2%p (허용 3.3)
    오르막 오차 0.0%p —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
2026-09-18 9/18 실측 결과를 반영한다 — 조향은 탈락 사유가 아니었다
    ① IMU 피치 부호 — 확정. 반대였다(sign −1). 상세는 d1fb9a1.
    ② 조향 전원 — `drive_diag.py --yes` 를 바퀴 들고 두 번 돌렸다.
    기준 VCC 구동 강하 조향 강하 재연결·리셋
    1회 4077 / 최저 3665 0 mV · 회전 2013 mV 없음
    2회 4106 / 최저 4106 0 mV · 회전 2019 mV 없음
    VCC 가 2064~2087 까지 떨어졌는데도 **두 번 다 시리얼이 안 끊겼다.**
    기록된 주행이 VMIN 2282~2528 에서 완주한 것과 같은 방향이다.
    강하는 실재하는 전기적 약점이지만 **탈락 사유가 아니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
2026-09-18 거버너가 3.0 m/s 를 넘는 순간 스스로 꺼지던 것을 고친다 — 제일 필요한 지점이었다
    ★ 증상
    tools/ramp_profile.py 로 12.5% 내리막(v_max 2.8)을 돌리면:
    거버너만 켬 → 내리막 3.92 m/s · 개입 **0 회**
    거버너가 한 번도 일하지 않았다.
    ★ 원인
    _governor_pwm 의 `if abs(mv) > BRAKE_V_PLAUSIBLE(3.0): return None`.
    이 3.0 은 원래 /odometry/filtered 의 twist 스파이크(실측 61.9 m/s)를
    거르려고 넣은 값이다. 그런데 9/17(9dd14a0) 에 거버너 입력을 **엔코더
    위치차분**으로 바꿨다. 위치는 튀지 않으므로 그쪽엔 구조적으로 스파이크가
    안 생긴다 — **방어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
2026-09-18 내일 계획을 정정한다 — "미션 전부 off 로 기준 1랩" 은 성립하지 않는다
    경사로는 미션이 아니라 **코스**다(용인 s11~54). 끄고 돌 수가 없다.
    그런데 기본값으로 돌면 내리막이 탈락 경로다:
    경사로가 s54 에 끝나고 **굴절코스가 s58 에 시작한다. 4m 뒤다.**
    설정 경사 끝 s54 굴절 진입 s58
    전부 OFF 3.93 3.08 ❌ 굴절 상한 3.0 초과
    거버너만 3.04 2.66 ✅
    거버너+피치 2.52 2.38 ✅ 권장
    4m 로는 3.93 → 3.08, 0.85 밖에 못 줄인다.
    그래서 첫 랩부터 grade_ff_gain:=1.0 gov_pwm:=50.0 을 켠다. 둘은 한 쌍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
2026-09-18 9/18 야간 실차 시험 — 캘리브→AUTO 인계 검증 성공, 구동 배터리 방전으로 중단
    ★ 얻은 것
    · **캘리브 → 정지 → AUTO 인계, 실차 첫 검증 성공.**
    10.0m 직진 · 최대편차 3° · yaw_offset 106.8° · STEER_CENTER 412 양호
    · 경로 추종 128m 에서 **실측 이격 0.20m** (경고선 0.72)
    · 거버너 실차 동작 — 제동 −60 까지 실제로 냄
    · grade_ff 1.0 이 0.5 로 막혔던 s=84.5 를 통과시켰다 (s=91 까지 감)
    ★ 중단 원인 — 구동 배터리. 그리고 **그걸 잴 수단이 없다**
    구동은 로직과 별도 전원이라 /vcc_mv 로 안 보인다.
    아침 (바퀴 들고) 움직이는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
2026-09-18 완주 성공 — 원인은 FF 정적항이 29 모자란 것이었다
    🏁 128.0m / 128.0m · 캘리브 10.1m 편차 2° · 거버너 개입 0 · 조향스톨 2회(직전 12회)
    FF 식 PWM = 38.8·v + 17.2 은 9/17 에 식별한 값이다. 오늘 실측으로 다시
    맞추면 PWM = 42.6·v + 46.1 — **정적항이 29 부족**했다.
    구름저항이 0.35 → 0.93 m/s² 로 2.7배 올랐는데(배터리·노면) 식은 그대로였다.
    명령 0.66(급커브) → 설정 FF 43 → 실제 0.00 m/s ← 멈춘 이유
    명령 2.00(직선) → 설정 FF 95 → 실제 1.14 m/s ← 직선은 갔던 이유
    곡률 제한이 명령을 깎으면 FF 가 구동 문턱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
2026-09-18 내일 문서를 완주 결과로 정리한다 — 오진 과정은 접어서 남긴다
    · ③ 절의 '배터리 방전으로 중단' 은 오진이었다. 접어 두고 맨 위에 경고를 단다.
    특히 ff_min_pwm:=90 권장은 **틀렸다** — 개루프에서 하한은 곧 최저 속도라
    캘리브와 곡률 제한을 깨뜨린다. 그대로 따라 하면 안 된다.
    오진 과정을 지우지 않는 이유는, 같은 증상(커브에서만 멈춤)을 다시 만났을 때
    배터리·조향·열보호를 먼저 의심하다 세 시간을 쓰지 않기 위해서다.
    · 내일 계획 0번에 **FF 재측정**을 넣었다. FF 식은 그날의 배터리·노면에 따라
    달라지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
2026-09-18 거버너 자세 게이트 + IMU 중복 방지 — 오늘 찾은 결함 둘을 함께 고친다
    ═══ ① 거버너 자세 게이트 (gov_min_grade) ═══
    ★ 문제 (2026-09-18 학교 실측)
    거버너는 **중력이 미는 내리막**을 위한 것인데 전 구간에 켜져 있었다.
    급커브에서는 곡률 제한이 명령을 빠르게 깎고(2.0 → 0.9) 차는 관성으로
    못 따라온다. 그 **추종 지연**을 거버너가 과속으로 읽는다.
    128m 주행에서 38회 개입 · 그중 25회가 깎은 뒤 PWM 이 구동 문턱 아래
    측정 1.09 > 명령 1.07 (+0.14) → PWM 63 → 50 ← 직후 차가 섰다
    게다가 개입하면 ff_min_pwm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
2026-09-18 거버너 게이트에 히스테리시스 — 연속 조절을 게이트가 깨지 않게
    ★ 문제
    거버너 출력은 초과분에 비례하는 **연속값**이다 (out = ff − gain·excess).
    9/17 에 '통째로 역 PWM' 에서 연속 조절로 바꿨던 것이다(5fadd24).
    그런데 어제 얹은 자세 게이트가 문턱 하나로 켜졌다 꺼졌다 하면, PWM 이
    'FF 하한' 과 '거버너 값' 사이를 왕복한다 — **그 연속성을 게이트 쪽에서
    다시 깨뜨리는 셈**이다. 경사로 진입·정상부 통과처럼 피치가 문턱을 스치는
    구간이 정확히 그 상황이다.
    ★ 고친 것
    열림은 gov_min_grade, 닫힘은 그 60%(GOV_GATE_HY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
2026-09-18 거버너 게이트에서 가속 오염을 뺀다 — 엔코더 가속도를 이미 알고 있었다
    ★ 실측으로 드러난 문제 (2026-09-18 밤, 학교 캘리브)
    IMU 는 중력 방향으로 기울기를 잰다. 가감속하면 관성력이 섞여 **가짜 피치**가
    생긴다: atan(a/g). 1 m/s² 면 5.8° = 10% 다.
    차를 세우고 잰 그 자리 −2.0 %
    저속 서다가다 주행 중 −6~7 % ← 6% 문턱이 열렸다
    → 거버너가 PWM 을 9 까지 깎아 캘리브가 기어갔다
    문턱을 6 → 10% 로 올리는 것으로는 못 푼다. 오염이 ±5% 씩 흔들어 어느
    문턱이든 경계에 걸리고, 오르막 감속 구간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
2026-09-18 캘리브 속도상한이 '속도제어를 받는다' 는 깨진 전제 위에 있었다
    ★ 현장에서 막힌 것 (2026-09-18 23:55, 학교)
    ❌ 헤딩 캘리브 무효: 10.1m 를 9.6초 만에 갔다고 나온다
    (최소 10.0초 필요, 속도상한 1.00m/s). 실제 주행이 아니라 측위 점프다.
    점프가 아니었다. 로그의 1m 통과 시각으로 구간속도를 내면:
    0.89 → 1.01 → 1.22 → 1.19 → 1.36 → 1.41 → 1.45 → 1.59 m/s
    **매끄럽게 단조 증가**한다. 점프면 계단이 나온다. 진짜 주행이었다.
    ★ 왜 통과 못 했나 — 게이트가 스스로 적어 둔 전제
    # 자동직진은 속도제어를 받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
2026-09-18 가속 오염 보정의 위상을 피치 필터에 맞춘다 — 어제 보정은 절반만 맞았다
    ★ 남아 있던 증상 (2026-09-18 23:55)
    오염 보정(3519f89) 이후 캘리브 중 거버너 개입이 'PWM 32→9 지속' 에서
    '출발 1.05초 시점 한 줄, 61→55' 로 줄었다. 그런데 **한 줄은 남았다.**
    ★ 왜 — 두 신호의 위상이 다르다
    self._pitch 는 GRADE_TAU(0.30s) 로 **저역통과**돼 있다. 선언 주석이
    "가감속 피칭을 누른다" 고 적어 둔 바로 그 필터다.
    그런데 엔코더 가속도(self._meas_a)는 즉시 튄다.
    둘을 그대로 빼면 출발 가속 구간에서 **과보정**이 난다: 정지마찰 돌파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
2026-09-18 인계 2026-09-19 — 경사로 오르막·내리막 + 캘리브 게이트
    다음 세션이 맥락 없이 이어받을 수 있게 정리한다.
    ★ 담은 것
    · 지금 상태와 **바로 다음 명령** (차를 시작점으로 되돌리고 그대로 실행)
    · 경사로 동작 전체 — grade_ff(오르막) · 거버너 연속 조절(내리막) ·
    자세 게이트, 상수표와 각 값의 근거
    · 9/18 야간 실차 타임라인 전부 (22:00 기록 → 23:09 완주 → 내리막 완주 →
    23:46 거버너 오작동 → 23:55 캘리브 무효)
    · 어젯밤 고친 셋을 커밋별로 (3519f89 오염 보정 / 331b350 위상 정합 /
    3b89b1c 캘리브 상한)
    · **내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
2026-09-18 라이다 회피 + 경사로 양방향 확정 — 대회장에서 무조건 출발하게 남긴다
    오늘 밤 실차에서 확정한 것:
    · max_speed 1.6 + gov_deadband 0.20 으로 오르막·내리막 양방향 완주
    · 라이다 회피가 실차에서 동작 (이탈 1.13m 오르막 / 1.91m 내리막)
    · 경사로 경사 최초 측정 15.4% (grade_pwm 74) — 용인 법정 12.5% 보다 가파르다
    · 구동 FF 실측 40.9·v + 12.5 (쓰는 건 42.6·v + 46.0, ff_static 만 +33.5 과하다)
    · 최저 지속속도 ~1.34 m/s — 곡률 제한기가 그 아래를 요구해도 못 낸다
    gov_deadband 0.10→0.20: max_speed 를 낮추면 FF 바닥 때문에 실측이 명령을
    상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
    [cone_0342.csv, down16_0409.csv, down_0348.csv, up16_0404.csv]
2026-09-18 용인으로 전환 — 원점이 충주로 남아 있으면 차가 한 발짝도 못 간다
    ★ 현장에서 차를 못 움직이게 만들 결함을 먼저 잡았다.
    global_path_publisher 는 웨이포인트의 원점 스탬프를 site_origin.yaml 과
    대조해 1km 이상 차이 나면 전역 경로를 **발행하지 않는다**(origin_check strict).
    충주(399848.522, 4092209.171) ↔ 용인(332200.0, 4128600.0) = **76.8km**.
    캘리브까지 정상으로 끝나고 AUTO 로 넘어가도 경로가 없어 차가 안 간다.
    → tools/use_site.sh yongin 으로 전환. START.md §0 으로 못 박았다.
    정지점도 다른 장소 것이었다. ~/stop_points.yaml 이 원점 477800/3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
2026-09-19 캘리브를 죽일 뻔한 인자를 되돌리고, 굴절·S자 구간 감속을 준비한다
    ★ auto_calib_speed:=0.5 를 빠뜨렸다가 되돌렸다.
    drive_school.sh 는 전압이 4700mV 밑이면 ff_min_pwm 과 **auto_calib_speed 를
    둘 다** 다시 계산한다(최대 1.2). --min-pwm 0 은 앞엣것만 덮어쓴다.
    어젯밤 실측 전압이 3000~4062mV 였으니 거의 확실히 올라간다.
    캘리브 최소시간 게이트(10m 를 5.0초 안에 가면 무효) 여유가
    0.5 → 7.5초 (+49%) · 1.0 → 5.4초 (+7%) · 1.2 → 4.8초 (무효)
    로 무너진다. START.md 증상표에도 넣었다.
    구간속도를 굴절코스·S자에 쓴다. 실제 노드 코드(_base_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
2026-09-19 예선용 구간 경로를 잘라 낸다 — 캘리브 조주구간을 앞에 붙여서
    예선은 굴절코스·S자만 달려 통과해야 본선에 간다. 648m 본 코스를 그대로
    쓰면 구간을 지나서도 계속 달린다.
    ★ 핵심은 **구간보다 앞에서 잘라야 한다**는 것이다.
    heading_init 은 웨이포인트를 안 보고 '차가 향한 방향' 으로 10m 직진한다.
    구간 경계(s58)에서 자르면 그 10m 가 커브라 편차 31.9° 로 캘리브가 거부된다
    (거부선 20°). 14m 앞에서 자르니 1.4° 로 떨어진다.
    → 잘린 경로의 앞 10m 가 캘리브 구간이 되고, 캘리브가 끝나는 지점이
    구간 진입 4m 앞이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
2026-09-19 주행마다 설정까지 통째로 남긴다 — 궤적만 남기면 나중에 분석이 안 된다
    drive_record.py 만 돌리면 궤적은 남는데 **어떤 설정으로 돌았는지가 없다.**
    설정은 /tmp/launch_params_* 에 있고 재부팅하면 사라진다 — 어젯밤 주행의
    덤프가 실제로 전부 날아갔다(지금 0개). 노드 stdout 은 ~/.ros/log 에 9600개가
    쌓여 있어 어느 세션이 그 주행인지 찾는 것부터 일이다.
    tools/record_run.sh 가 한 폴더에 모은다:
    drive.csv / drive_scan.csv / params/ / roslog/ / run.txt
    run.txt 에는 런치 명령줄·브랜치·커밋·미커밋 변경 수·원점·IMU 영점·노드 목록.
    만들면서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
2026-09-19 기록 절차를 record_run.sh 로 바꾼다 — 궤적만 남기던 것을 설정까지
    START.md §5 와 PRELIM.md 의 기록 명령을 drive_record.py 직접 실행에서
    tools/record_run.sh 로 바꿨다. 라이다 보정각(--yaw-offset)을 사람이
    기억할 필요도 없어진다 — 스크립트가 cluster_plot_node 에서 읽어 맞춘다.
2026-09-19 도착하자마자 쓸 순서를 한 장으로 — ARRIVE.md
    START.md(본선 절차)·PRELIM.md(예선)·HANDOFF(근거)가 따로 있어 현장에서
    어느 것부터 볼지가 애매했다. 도착 → 첫 주행 → 예선 작업까지를 번호 순서로
    묶고, 각 단계의 **기대 출력**을 같이 적었다. 안 나오면 멈추라는 뜻이다.
    명령에 나오는 도구·경로·실행파일 17개가 실제로 존재하는지 전부 확인했다.
2026-09-19 용인 현장 인계 — USB 허브가 GPS·라이다를 죽였고, 손으로 민 경로는 못 돈다
    ★ 오늘 현장에서 터진 것 둘. 둘 다 소프트웨어가 아니었다.
    ① USB 허브 17개가 겹쳐 물려 GPS·라이다·아두이노를 동시에 죽였다.
    IMU 만 직결(3-1)이라 유일하게 멀쩡했다.
    라이다 health OK 후 'Can not start scan' — 모터를 못 돌린다
    GPS 'Starting USB initialization' 무한 반복 → /fix 미발행
    → NTRIP 이 GGA 를 **충주 좌표로 고정** 송신 (VRS 보정도 엉뚱)
    아두이노 5V 무부하 2848~3117mV (정상 4700~5100, 리셋선 3483)
    허브를 빼고 직결하니 GPS 복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
2026-09-19 검증된 본선 주행 명령을 박제한다 — 2026-09-19 15:36 용인 실차
    오늘 15:36 에 자가 직진 캘리브 → AUTO → 본선 코스 주행이 **성공했다.**
    대회가 내일이다. 이 설정이 어디에도 안 적혀 있으면 내일 아침에 못 찾는다.
    ★ 실측 (data/2026-09-19/mainlap_1536/console.log, 555행)
    RTK 수렴 σ=1.5cm
    직진 10.3m / 14.0초 (평균 0.74 m/s), 최대 편차 1°
    yaw_offset = 39.5° (GPS course 159.4° − IMU yaw 120.0°)
    모드: AUTO
    출발 (56.2, 3.8) → 마지막 확인 (0.75, −44.26)
    거버너 개입 10회 · VMIN 4106 mV
    ★ 같이 남기는 것
    · console.log 통째 (노드 stdout 은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
    [drive.csv, drive_scan.csv]
2026-09-19 실행 순서를 못 박는다 — teleop 이 캘리브를 조용히 막는다
    ★ 2026-09-19 16:16 에 실제로 막힌 것
    차가 안 나가는데 에러가 한 줄도 없었다. 로그는 `직진 기준 헤딩 고정: -54.3°`
    에서 39초째 멈춰 있었다.
    원인: **heading_init 의 자가 직진은 `/teleop/cmd_vel` 에 0.5 를 발행하는데,
    teleop_keyboard 는 W/S 를 안 눌러도 데드맨으로 0 을 20Hz 로 발행한다.**
    같은 토픽이라 0 이 덮어쓴다. 실측 분포 `{0.0: 60건, 0.5: 34건}`.
    증상이 조용한 이유: `직진 중... 1.0/10m` 은 1m 를 가야 찍힌다. 못 가니
    아무 로그도 안 나온다.
    ⚠ 이건 내가 만든 문제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
2026-09-19 라이다 포함 주행 기록 — 2026-09-19 16:40 용인
    ★ 이번 실행에서 확인된 것
    ✅ 헤딩 초기화 완료: 10.0m 직진 (최대 편차 2°)
    GPS course=-116.8°, IMU yaw=159.6° → yaw_offset=83.7°
    AUTO 진입 후 3초 샘플 61건, 직선합 약 354m
    최고 측정속도 3.42 m/s (max_speed 는 1.6)
    AVOID(라이다) ↔ AUTO 전환 19회 · 거버너 4회 · BLOCKED 3회
    시작 (+8.8,-32.9) → 마지막 확인 (+5.6,-54.0)
    라이다를 넣고 처음으로 AUTO 주행이 붙었다. 먹스가 AVOID 와 AUTO 를
    오가며 돌았다(19회).
    ★ 라이다 — 오늘 오후 내내 안 붙던 것이 붙었다
    배선은 **안 바꿨다**(여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
2026-09-19 내일 아침 명령을 최종본으로 — 터미널 4개, 순서와 확인법까지
    9/19 하루 동안 막힌 지점이 전부 **명령 자체가 아니라 그 앞뒤 순서**였다.
    내일 아침에는 이 대화가 없다. 문서만 보고 그대로 따라갈 수 있어야 한다.
    ★ §1 을 다시 썼다 — 터미널 4개
    1) 정리 (pkill teleop + ros_cleanup)
    2) 라이다 드라이버 — **hz 로 확인**. lidar_up.sh 의 ✅ 는 발행자 수만 봐서
    오늘 세 번 오판했다(데이터 0건인데 통과 / pkill 직후 "이미 발행 중"
    으로 시도 자체를 건너뜀)
    3) 주행 — calib_jump_speed:=3.0 을 포함시켰다(9/19 16:08 에 개루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
2026-09-20 🏁 본선 완주 — 2026-09-20 용인
    ★ 648m 완주. 어제부터 오늘까지 한 번도 못 했던 것이다.
    ★ 실측
    캘리브 ✅ 10.1m 직진 (최대 편차 2°)
    GPS course=160.3°, IMU yaw=83.1° → yaw_offset=77.2°
    출발 (57.6, 6.7) → 종점 (56.3, −16.6)
    최고 측정속도 4.07 m/s (max_speed 1.6)
    AVOID(라이다) 전환 40회 · BLOCKED 46회 · 거버너 8회
    라이다 회피가 실제로 물렸다(40회). BLOCKED 46회도 차를 세우지 못했다 —
    마지막 로그가 "막힘 탈출 중 — 전방 감속 없음 (14s)" 직후 완주다.
    ★ 쓴 설정 (VERIFIED_LAP.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
2026-09-20 2차 주행 — 돌발정지 미션을 켠다 (s=470~515)
    ★ 1차에서 648m 완주(8972d35)를 확보했으므로 2차는 미션에 도전한다.
    실패해도 1차 기록이 남는다.
    ★ 기준선 위치
    운전자가 지도에서 짚은 구간을 좌표로 환산: **s=483~499m**
    (−28.0,−38.7) → (−13.3,−45.2), 최소 곡률반경 22m 인 직선 — 가속구간이 맞다.
    "저 구간 어딘가" 라고 했으므로 앞뒤 여유를 둬 **s=470~515** 로 잡았다.
    ★ 계획 파일 변경 (config/mission_plan.yaml)
    sudden_stop enabled true · s_enter 470 · s_exit 515
    lidar_avoid enabled true · s 12~648 · allow_full_course true
    ⚠ lidar_avoid 를 **켜야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
2026-09-20 2차 주행 설정 확정 — obstacle_stop_dist 0.8 → 1.0
    ★ 왜 올렸나 — 운전자가 짚은 문제
    "동력을 끊는 방향이면 스르륵 가지 않나"
    맞는 지적이었다. 런치 주석이 명시한다:
    "obstacle_stop_dist 는 '동력을 끊을 거리' 지 '멈출 거리' 가 아니다"
    ff_brake_pwm=0 (능동제동 꺼짐)이라 끊은 뒤 관성으로 더 간다.
    모델 a = −(0.861·v + 0.37) 로 계산한 관성 거리:
    0.5 m/s → 0.20m 1.5 m/s → 0.99m
    1.0 m/s → 0.56m 2.0 m/s → 1.46m
    0.8m 에서 끊었을 때 속도가 1.5 m/s 면 0.99m 를 더 가 더미를 친다.
    4m 부터 감속 램프가 걸리지만 개루프라 실제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
2026-09-27 포트폴리오 정리 — README, legacy 도구 통합, NTRIP 계정 환경변수화
2026-09-27 README: 궤적 그림 설명 수정 (교내 시험 트랙)
